ChristopherCa55/led-driver/BOOST_reorg_2026-10-05/README.md

# BOOST LED driver: design files for PCB review

A three-channel boost LED driver on two boards, designed in KiCad 10 and simulated in LTspice 26. The boards are
meant to be made and assembled by JLCPCB.

## Boards

| Board | File | Size | Layers |
|---|---|---|---|
| Power board | `KiCad/BOOST_power_RC2.kicad_pcb` | 74 x 86 mm (18 x 12 mm corner notch) | 6 (stackup JLC061611-7628D, specified at order) |
| Control card | `KiCad/BOOST_control_RC2.kicad_pcb` | 45 x 45 mm | 6 |

## Schematics
Each board has its own schematic, and a top-level system schematic includes both:

| File | What it is | Open with |
|---|---|---|
| `KiCad/BOOST_power_RC2.kicad_sch` | power board schematic | `KiCad/BOOST_power_RC2.kicad_pro` (with its PCB) |
| `KiCad/BOOST_control_RC2.kicad_sch` | control card schematic | `KiCad/BOOST_control_RC2.kicad_pro` (with its PCB) |
| `KiCad/BOOST.kicad_sch` | system: both board schematics as sheets | `KiCad/BOOST.kicad_pro` |
| `BOOST_schematic.pdf` | all three sheets as a PDF | any PDF viewer |

- Each board schematic is drawn in titled blocks, one per circuit, for example "Boost power stage and output banks"
  or "Channel 1 output-voltage error amplifier". The three output channels are drawn as matching blocks.
- Wires stay inside a block. Signals between blocks, and between the two boards, are joined by global labels with
  the same name.
- The boards connect through the 30-pin J10 (power board) / J11 (control card) pair.

The `.pretty` folders, `ltspice.kicad_sym`, `fp-lib-table` and `sym-lib-table` in `KiCad/` are the project's own
footprint and symbol libraries; KiCad finds them automatically.

## KiCad notes
- Each board has its own `.kicad_pro`, which carries its net classes and design rules. Open a board through its own
  `.kicad_pro`; without it, DRC falls back to the defaults.
- 3D models: the parts use KiCad's standard 3D library (`${KICAD10_3DMODEL_DIR}`), which comes with KiCad.

## ERC and DRC
- **ERC, system schematic (`BOOST.kicad_pro`):** 0 errors, 0 warnings.
- **ERC, power board on its own:** 0 errors, 0 warnings.
- **ERC, control card on its own:** 2 expected errors, "power input not driven", on U18's VDD and VSS. The card is
  supplied from the power board through J11, so nothing on the card drives those pins. They are driven in the system
  ERC, which is clean. A PWR_FLAG on the card would instead clash with the power board's regulator in the system ERC.
- **DRC schematic parity, both boards:** 0 issues (each PCB matches its own schematic).
- Power board: 0 errors, 0 unconnected. The 49 warnings are expected:
  - 46 silk over copper: a top-side logo under L1 crosses L1's middle (mechanical) pad. It is hidden under L1, and
    the gerbers cut silkscreen away from exposed pads.
  - 2 silk overlaps: the can outlines of C87/C71 and C86/C88 touch.
  - 1 library mismatch: J10's holes are drilled 1.05 mm on purpose (Samtec 0.64 mm square posts).
- Control card: 0 errors, 0 unconnected. The 1 warning is expected: a library mismatch, because J11's holes are
  drilled 1.05 mm on purpose (Samtec 0.64 mm square posts).

## LTspice
`LTspice/BOOST.asc` simulates both boards together. It is laid out like the KiCad schematics:
- the same titled blocks;
- the power board on the left and the control card on the right;
- the simulation-only test bench (battery, cable, LED loads, Arduino outputs) and all the directives at the bottom.

Signals between blocks use net labels with the same names as in KiCad. The connectors and mounting holes exist only
in KiCad.

What to look at:
- `I(SIM_LED1)`, `I(SIM_LED2)` and `I(SIM_LED3)`: the LED currents;
- `V(Vout_1)`, `V(Vout_2)` and `V(Vout_3)`: the channel outputs;
- `V(LX)`: the switch node;
- `I(L1)`: the inductor current.

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

**Parameters** (a `.param` line near the other directives):
- `IREF1_DUTY`, `IREF2_DUTY`, `IREF3_DUTY`: the Arduino's IREF PWM duty in 256ths at 490 Hz. 256 = always on (the
  default), 128 = 50 %, 0 = off.
- `POT1_CODE`, `POT2_CODE`, `POT3_CODE`: the MCP4451 wiper codes of U26A/B/C (0-256). The defaults 86/103/103 give
  2.635/2.371/2.371 A LED peaks. Code 0 is full current and 256 is zero (the pot's A terminal is grounded). At
  power-up the pot sits at mid-scale (128, about 1.98 A) until the firmware writes a code.
- Parts named `SIM_...` exist only in the simulation: the battery, cable, LEDs and the Arduino outputs.

**Results:** a 30 ms run at full duty converges in about 5-7 minutes. Over 25-30 ms the LEDs hold 2.635, 2.371 and
2.371 A, the outputs sit at 23.3, 33.1 and 33.1 V, and LX peaks at about 61 V.

**Start-up:** the two `.ic` lines start the servos and reference filters already settled, so the LEDs reach full
brightness within about 15 ms. Delete both lines for a true cold start (full brightness takes about half a second).
That shortcut start shows one 81 V LX spike at 0.15 ms, which real hardware does not see because it starts with the
references at zero.

**PWM dimming** (`IREFn_DUTY` below 256): each pulse keeps the full current down to about 19 % duty (red) and 25 %
(green, blue); below that the pulses carry less current. Runs can stall while all LEDs are off; adding `solver=alt`
to the `.options` line gets past it.

**File size:** LTspice saves every node, so a 30 ms run writes about 22 GB (`BOOST.raw`). Make sure there is room,
or add a `.save` line that lists only the signals you want.
