ChristopherCa55/led-driver/BOOST_split_boards/copper_review_2026-09-16/README.md

# Power copper check-in, 2026-09-16

`BOOST_power_copper_review.html` (+ `layers_v9.png`): the step-5 check-in for copper v9 - decisions, solver table
at 1 oz and 2 oz outer, commutation-loop inductance, layer plots, method.
Also at https://claude.ai/artifact/CsWJraE5Vq7Vkfb1vU2LdR. Generated by `../route_2026-09-16/tools/build_review.py v9`.
