ChristopherCa55/led-driver/BOOST_split_boards/route_2026-09-16/work/v15_r34/README.md

# Candidate v15 from router run r34 (not used)

A clean earlier v15 candidate (DRC 0 / 0, parity 0, no net changes). Replaced by run r36, which routes M6 and M3
return-first (plan-view gate-loop area 57.6 -> 47.7 mm2 and 236 -> 187 mm2) and keeps the bypass links and fan-out
vias out of rip-up (in r34 the C90.1 -> U10.3 5 V link had been ripped and the pads joined only through the plane).
