ChristopherCa55/led-driver/BOOST_split_boards/power6_2026-10-01/heatmap/A6_moved_gnd_report.txt

GND voltage above J2.1, full-load DC (A6_cu.json, JLC061611-7628D, grid 0.10 mm)
currents in: M1.3 11.03 A, R52.2 2.63 A, R53.2 2.37 A, R7.2 2.37 A; out at J2.1 18.40 A

terminal pads (mV): M1.3 6.46, R52.2 7.77, R53.2 8.25, R7.2 7.87, J2.1 0.00
highest GND voltage per layer (mV): F.Cu 8.25, In1.Cu 8.08, In2.Cu 8.04, In3.Cu 8.03, In4.Cu 7.72, B.Cu 7.67
floating GND copper (mm2): none

GND pins per part, lowest-highest pad (mV), highest first:
  R53      8.25 -   8.25
  U12      8.01 -   8.01
  U1       7.88 -   7.88
  R7       7.87 -   7.87
  C44      7.85 -   7.85
  C45      7.85 -   7.85
  C7       7.84 -   7.84
  C55      7.78 -   7.78
  C21      7.78 -   7.78
  C34      7.78 -   7.78
  C56      7.77 -   7.77
  R52      7.77 -   7.77
  U11      7.76 -   7.76
  C33      7.70 -   7.70
  C87      7.63 -   7.63
  C71      7.62 -   7.62
  C78      7.44 -   7.44
  J10      6.58 -   7.44
  C3       7.43 -   7.43
  U6       7.30 -   7.30
  C39      7.29 -   7.29
  C73      7.27 -   7.27
  C35      7.22 -   7.22
  U17      7.18 -   7.18
  C41      7.18 -   7.18
  C77      6.91 -   6.91
  U8       6.84 -   6.84
  C89      6.84 -   6.84
  C90      6.82 -   6.82
  U10      6.82 -   6.82
  C80      6.80 -   6.80
  C83      6.80 -   6.80
  U15      6.76 -   6.76
  C62      6.72 -   6.72
  C88      6.72 -   6.72
  C48      6.67 -   6.67
  C79      6.67 -   6.67
  C75      6.66 -   6.66
  C84      6.64 -   6.64
  U19      6.49 -   6.60
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
  16 ( 94.55,  77.15)  1.117 mV  joins In1 B  cuts LX on In2.Cu, Vin on F.Cu, Vin on In3.Cu, Vin on In4.Cu
  17 ( 80.95,  59.25)  1.103 mV  joins In1 In4 B  cuts LX on F.Cu, LX on In2.Cu, Vout_1 on In3.Cu
  18 ( 95.45,  56.45)  1.081 mV  joins F In1 B  cuts LX on In2.Cu, Vin on In3.Cu, Vin on In4.Cu
  19 ( 94.45,  43.05)  1.081 mV  joins F In1 B  cuts Vin on In2.Cu, Vin on In3.Cu, Vin on In4.Cu
  20 ( 98.75,  67.65)  1.053 mV  joins F In1 B  cuts Vin on In2.Cu, Vin on In3.Cu, Vin on In4.Cu

with the best 10 candidates added: terminal pads (mV) M1.3 6.46, R52.2 7.73, R53.2 8.20, R7.2 7.84, J2.1 0.00
  largest part GND pin: 8.20 mV (was 8.25)
