ChristopherCa55/led-driver/BOOST_split_boards/power6_2026-10-01/heatmap/U5_gnd_report.txt

GND voltage above J2.1, full-load DC (U5_cu.json, JLC061611-7628D, grid 0.10 mm)
currents in: M1.3 11.03 A, R52.2 2.63 A, R53.2 2.37 A, R7.2 2.37 A; out at J2.1 18.40 A

terminal pads (mV): M1.3 6.15, R52.2 7.63, R53.2 8.09, R7.2 7.74, J2.1 0.00
highest GND voltage per layer (mV): F.Cu 8.09, In1.Cu 7.91, In2.Cu 7.88, In3.Cu 7.86, In4.Cu 7.71, B.Cu 7.67
floating GND copper (mm2): none

GND pins per part, lowest-highest pad (mV), highest first:
  R53      8.08 -   8.08
  U12      7.84 -   7.84
  R7       7.74 -   7.74
  C34      7.70 -   7.70
  C21      7.70 -   7.70
  C44      7.69 -   7.69
  C45      7.69 -   7.69
  C55      7.69 -   7.69
  C7       7.68 -   7.68
  C56      7.68 -   7.68
  U1       7.67 -   7.67
  R52      7.63 -   7.63
  U11      7.61 -   7.61
  C33      7.55 -   7.55
  C87      7.48 -   7.48
  C71      7.48 -   7.48
  C78      7.34 -   7.34
  J10      6.53 -   7.29
  C3       7.29 -   7.29
  C39      7.14 -   7.14
  C73      7.14 -   7.14
  U6       7.11 -   7.11
  C35      7.06 -   7.06
  U17      7.03 -   7.03
  C41      7.03 -   7.03
  C77      6.80 -   6.80
  C89      6.79 -   6.79
  U8       6.77 -   6.78
  C83      6.73 -   6.73
  C80      6.73 -   6.73
  C90      6.73 -   6.73
  U10      6.73 -   6.73
  U15      6.66 -   6.66
  C62      6.62 -   6.62
  C88      6.62 -   6.62
  C48      6.58 -   6.58
  C79      6.58 -   6.58
  C75      6.57 -   6.57
  C84      6.53 -   6.53
  U19      6.42 -   6.47
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

GND vias carrying the most current (IPC 10 C rating 0.97 A for 0.4 mm):
  ( 42.30,  96.05) drill 0.40  0.59 A  0.61x
  ( 79.60,  52.00) drill 0.40  0.58 A  0.60x
  ( 79.00,  53.00) drill 0.40  0.56 A  0.58x
  ( 40.10,  96.05) drill 0.40  0.56 A  0.57x
  ( 41.57,  96.05) drill 0.40  0.53 A  0.55x
  ( 40.83,  96.05) drill 0.40  0.52 A  0.54x
  ( 79.60,  51.00) drill 0.40  0.51 A  0.52x
  ( 86.90,  67.50) drill 0.40  0.49 A  0.50x
  ( 61.06,  94.90) drill 0.40  0.48 A  0.49x
  ( 93.40,  61.10) drill 0.40  0.47 A  0.49x
  ( 61.06,  97.10) drill 0.40  0.45 A  0.47x
  ( 63.40, 109.55) drill 0.40  0.44 A  0.46x
  ( 91.30,  62.00) drill 0.50  0.44 A  0.39x
  ( 61.06,  95.63) drill 0.40  0.44 A  0.45x
  ( 61.06,  96.37) drill 0.40  0.43 A  0.44x

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

stronger spots that would cut a power pour (not on the map), ranked by the voltage across the layers they would join:
   1 ( 93.95,  65.95)  2.223 mV  joins F In1 B  cuts LX on In2.Cu, Vin on In3.Cu, Vin on In4.Cu
   2 ( 81.45,  57.05)  1.344 mV  joins F In1 In3 B  cuts LX on In2.Cu
   3 ( 96.65,  67.65)  1.342 mV  joins F In1 B  cuts LX on In2.Cu, Vin on In3.Cu, Vin on In4.Cu
   4 ( 75.35,  80.05)  1.213 mV  joins F In1 In3  cuts Vout_1 on In4.Cu
   5 ( 95.05,  69.75)  1.140 mV  joins F In1 B  cuts LX on In2.Cu, Vin on In3.Cu, Vin on In4.Cu
   6 ( 94.55,  77.15)  1.099 mV  joins In1 B  cuts LX on In2.Cu, Vin on F.Cu, Vin on In3.Cu, Vin on In4.Cu
   7 ( 98.75,  67.65)  1.057 mV  joins F In1 B  cuts Vin on In2.Cu, Vin on In3.Cu, Vin on In4.Cu
   8 ( 81.45,  54.95)  1.022 mV  joins F In1 In3 B  cuts LX on In2.Cu
   9 ( 79.55,  66.85)  1.013 mV  joins F In1 B  cuts LX on In2.Cu, Vout_1 on In3.Cu, Vout_1 on In4.Cu
  10 ( 79.85,  69.05)  0.989 mV  joins F In1  cuts LX on In2.Cu, Vout_1 on In3.Cu, Vout_1 on In4.Cu
  11 ( 93.95,  63.85)  0.970 mV  joins F In1 B  cuts LX on In2.Cu, Vin on In3.Cu, Vin on In4.Cu
  12 ( 73.15,  81.95)  0.893 mV  joins F In1 In3  cuts Vout_1 on In4.Cu
  13 ( 79.45,  63.05)  0.892 mV  joins F In1 B  cuts LX on In2.Cu, Vout_1 on In3.Cu, Vout_1 on In4.Cu
  14 ( 97.55,  58.55)  0.878 mV  joins F In1 B  cuts Vin on In2.Cu, Vin on In3.Cu, Vin on In4.Cu
  15 ( 94.55,  72.35)  0.876 mV  joins In1 B  cuts LX on In2.Cu, Vin on In3.Cu, Vin on In4.Cu
  16 ( 94.55,  75.05)  0.858 mV  joins In1 B  cuts LX on In2.Cu, Vin on F.Cu, Vin on In3.Cu, Vin on In4.Cu
  17 ( 96.05,  63.05)  0.842 mV  joins F In1 B  cuts LX on In2.Cu, Vin on In3.Cu, Vin on In4.Cu
  18 ( 81.55,  63.05)  0.837 mV  joins F In1 B  cuts LX on In2.Cu
  19 ( 90.05,  70.25)  0.828 mV  joins F In1  cuts LX on B.Cu, LX on In2.Cu, Vin on In3.Cu, Vin on In4.Cu
  20 ( 89.85,  66.15)  0.811 mV  joins F In1 B  cuts LX on In2.Cu, Vin on In3.Cu, Vin on In4.Cu
