ChristopherCa55/led-driver/BOOST_split_boards/route_2026-09-16/work/v16_report_tables.md

| FET | Loop area v15 → v16 (mm²) | Forward beside return v15 → v16 | driver → R | R → gate | driver → diode | diode → gate | VSS → source |
|---|---|---|---|---|---|---|---|
| M7 (LX side) | 47.5 → **49.1** | 73 % → 69 % | 13.6 | 5.1 | 18.5 | 1.4 | 20.9 |
| M5 (LX side) | 24.5 → **24.2** | 82 % → 82 % | 13.5 | 1.3 | 2.1 | 1.0 | 21.3 |
| M6 (LX side) | 47.7 → **47.7** | 34 % → 34 % | 28.9 | 3.4 | 16.0 | 1.5 | 14.8 |
| M2 (rail side) | 147.4 → **35.8** | 18 % → 56 % | 27.8 | 4.5 | 30.7 | 1.5 | 15.5 |
| M3 (rail side) | 186.5 → **37.8** | 0 % → 0 % | 21.2 | 4.0 | 20.8 | 1.1 | 9.9 |
| M4 (rail side) | 57.0 → **59.7** | 4 % → 1 % | 32.9 | 1.1 | 4.9 | 31.0 | 22.2 |

| FET | Part → gate pin | Role | v15 (mm) | v16 (mm) | Pad centres (mm) |
|---|---|---|---|---|---|
| M1 | R104.1 | pull-down | 1.3 | 1.3 | 3.0 |
| M1 | R15.2 | series R | 1.2 | 1.2 | 2.6 |
| M7 | D2.2 | turn-off diode | 1.4 | 1.4 | 2.9 |
| M7 | R60.2 | series R | 5.1 | 5.1 | 5.2 |
| M7 | R76.2 | pull-down | 3.5 | 3.5 | 4.8 |
| M5 | D22.2 | turn-off diode | 1.0 | 1.0 | 2.4 |
| M5 | R59.1 | series R | 1.3 | 1.3 | 2.6 |
| M5 | R74.2 | pull-down | 1.3 | 1.3 | 2.9 |
| M6 | D8.2 | turn-off diode | 1.5 | 1.5 | 3.1 |
| M6 | R49.1 | pull-down | 1.1 | 1.1 | 2.2 |
| M6 | R70.2 | series R | 3.4 | 3.4 | 4.2 |
| M2 | D11.2 | turn-off diode | 1.5 | 1.5 | 3.2 |
| M2 | R13.1 | series R | 4.5 | 4.5 | 4.8 |
| M2 | R75.2 | pull-down | 6.3 | 6.3 | 5.3 |
| M3 | D14.2 | turn-off diode | 1.1 | 1.1 | 2.4 |
| M3 | R23.2 | series R | 4.0 | 4.0 | 5.3 |
| M3 | R61.2 | pull-down | 5.2 | 5.2 | 6.9 |
| M4 | D13.2 | turn-off diode | 26.6 | 31.0 | 9.7 |
| M4 | R47.1 | series R | 1.1 | 1.1 | 2.2 |
| M4 | R73.2 | pull-down | 2.5 | 2.5 | 3.8 |
| M8 | R22.1 | series R | 1.0 | 1.0 | 2.4 |
| M9 | R50.1 | series R | 1.1 | 1.1 | 2.3 |
| M10 | R56.1 | series R | 1.4 | 1.4 | 2.9 |
