ChristopherCa55/led-driver/BOOST_split_boards/fab_2026-10-07/BOOST_power_RC2/checks/BOOST_power_RC2_drill_report.txt

Drill report for BOOST_power_RC2.kicad_pcb
Created on 2026-10-07T01:45:35

Copper Layer Stackup:
    =============================================================
    L1 :  F.Cu                      front
    L2 :  In1.Cu                    in1
    L3 :  In2.Cu                    in2
    L4 :  In3.Cu                    in3
    L5 :  In4.Cu                    in4
    L6 :  B.Cu                      back

Drill file 'BOOST_power_RC2-PTH.drl' contains
    plated through holes:
    =============================================================
    T1  0.300mm  0.0118"  (234 holes))
    T2  0.400mm  0.0157"  (624 holes))
    T3  0.500mm  0.0197"  (114 holes))
    T4  1.050mm  0.0413"  (30 holes))
    T5  1.100mm  0.0433"  (30 holes))
    T6  2.000mm  0.0787"  (6 holes))
    T7  4.300mm  0.1693"  (2 holes))

    Total plated holes count 1040

Drill file 'BOOST_power_RC2-NPTH.drl' contains
    unplated through holes:
    =============================================================
    T1  2.900mm  0.1142"  (4 holes))
    T2  3.200mm  0.1260"  (4 holes))

    Total unplated holes count 8
