ChristopherCa55/led-driver/BOOST_split_boards/fab_2026-09-24/BOOST_control_RC1/checks/BOOST_control_RC1_drill_report.txt

Drill report for BOOST_control_RC1.kicad_pcb
Created on 2026-09-24T18:08:31

Copper Layer Stackup:
    =============================================================
    L1 :  F.Cu                      front
    L2 :  In1.Cu                    in1
    L3 :  In2.Cu                    in2
    L4 :  In3.Cu                    in3
    L5 :  In4.Cu                    in4
    L6 :  In5.Cu                    in5
    L7 :  In6.Cu                    in6
    L8 :  B.Cu                      back

Drill file 'BOOST_control_RC1-PTH.drl' contains
    plated through holes:
    =============================================================
    T1  0.300mm  0.0118"  (393 holes))
    T2  1.000mm  0.0394"  (11 holes))
    T3  1.050mm  0.0413"  (30 holes))

    Total plated holes count 434

Drill file 'BOOST_control_RC1-NPTH.drl' contains
    unplated through holes:
    =============================================================
    T1  1.400mm  0.0551"  (2 holes)  (with 2 slots)
    T2  3.200mm  0.1260"  (4 holes))

    Total unplated holes count 6
