ChristopherCa55/led-driver/BOOST_split_boards/fab_2026-09-24/BOOST_power_RC1/checks/BOOST_power_RC1_drill_report.txt

Drill report for BOOST_power_RC1.kicad_pcb
Created on 2026-09-24T18:08:20

Copper Layer Stackup:
    =============================================================
    L1 :  F.Cu                      front
    L2 :  In1.Cu                    in1
    L3 :  In2.Cu                    in2
    L4 :  In3.Cu                    in3
    L5 :  In4.Cu                    in4
    L6 :  In5.Cu                    in5
    L7 :  In6.Cu                    in6
    L8 :  B.Cu                      back

Drill file 'BOOST_power_RC1-PTH.drl' contains
    plated through holes:
    =============================================================
    T1  0.300mm  0.0118"  (122 holes))
    T2  0.400mm  0.0157"  (628 holes))
    T3  0.500mm  0.0197"  (118 holes))
    T4  1.050mm  0.0413"  (30 holes))
    T5  1.100mm  0.0433"  (30 holes))
    T6  2.000mm  0.0787"  (6 holes))
    T7  4.300mm  0.1693"  (2 holes))

    Total plated holes count 936

Drill file 'BOOST_power_RC1-NPTH.drl' contains
    unplated through holes:
    =============================================================
    T1  2.900mm  0.1142"  (4 holes))
    T2  3.200mm  0.1260"  (4 holes))

    Total unplated holes count 8
