ChristopherCa55/led-driver/HANDOFF_2026-10-12.md

# BOOST LED driver: complete project handoff (2026-10-12)

> **State as of 2026-10-13 (later; read this before section 5):** the open tasks in sections 5.4-5.7 are DONE.
> - Steps 5g, 7e, 8c, 9 (D5- re-route) and 10 (two Vout_3 loop vias; the user chose Vout_3 only) and LTspice 5b are in
>   `BOOST_review_fixes`. Every output was regenerated there (total $599.01).
> - The final gates pass. See the top section of `BOOST_split_boards/review_fixes_2026-10-11/FIX_REPORT.md` and
>   `ANSWERS.md`.
> - The copy is still NOT_FOR_FAB. The next step is the user's decision about shipping it into the three shipped
>   folders (with backups and the same regeneration there).
> - The card's 0err_hi and SDA tracks stay where they are (`work/CARD_SPLITTERS.md`).
> - **2026-10-14: SHIPPED.** The three shipped folders now hold this design (with the user's own KiCad and LTspice
>   placement of the pull-ups) and freshly plotted outputs. See `BOOST_split_boards/ship_2026-10-14/README.md`; the
>   backups are in `BOOST_split_boards/previous/2026-10-14/before_ship/`.

**For the AI taking over this project.** Read this whole file before doing anything. It has:
- what the project is;
- where every file lives;
- how the user works and the rules you must follow;
- the exact state of the work in progress;
- what is still open.

The previous assistant (Claude, Claude Code desktop app on the user's Windows PC) wrote it at the user's request, so
you can "be" that assistant without re-deriving anything.

Paths:
- `ROOT` = `C:\Users\bubba\OneDrive\Documents\led-driver`
- `BSB` = `ROOT\BOOST_split_boards`
- `RF` = `BSB\review_fixes_2026-10-11` (the current work folder)
- `COPY` = `ROOT\BOOST_review_fixes` (the current working copy of the design)

---

## 0. Read these next, in this order

1. **This file.**
2. **The memory files**, in `C:\Users\bubba\.claude\projects\C--Users-bubba-OneDrive-Documents-led-driver\memory\`.
   - `MEMORY.md` is the index.
   - The long history is `boost-routing-status.md`; tool tricks are in `boost-tooling-reference.md`.
   - The feedback rules (sections 2 and 3 below repeat them) are in the other files.
   - If your harness loads this memory automatically, it is the same content.
3. `RF\FIX_REPORT.md`: the report of the current task (review fixes), written at the end of 2026-10-11.
4. `RF\work\step05g\STEP.md`: the step that was being finished when this handoff was written.
5. `BSB\review_2026-10-10\FIX_PROMPT.md`: the task statement the current work follows. It has the ground rules, the
   fixed parts, the gates, and the tool commands.
6. `RF\README.md`, `RF\DECISIONS.md`, `RF\ANSWERS.md`, `RF\work\CHANGELOG.md`, `RF\work\METRICS_final.md`.

---

## 1. What the project is

### 1.1 The product
A **three-channel, roughly 100 W-per-channel LED driver** ("BOOST"), designed by the user (GitHub account
ChristopherCa55). It is built into a small **aluminium case that is operated underwater**; the case is the heatsink.
- The early fit study (`ROOT\BOOST_FIT_STUDY.md`) used a 33 mm tall interior, 78 x 90 mm in plan.
- The FETs are screwed to the case floor through thermal pads.
- It drives three high-power LEDs, one per channel:
  - channel 1, "red": about 23.3 V at 2.635 A;
  - channels 2 and 3, "green / blue": about 33.1 V at 2.371 A.
- An **Arduino Nano** outside the board sets brightness (PWM), enables, and the current setpoint (I2C digipot).
- It is also meant to work as a **strobe**.
- Input: a **4S lithium battery**, 12-16.8 V. The input caps are 25 V parts, so 6S is not allowed.

### 1.2 The architecture (current; the August design in `ROOT\DESIGN_NOTES.md` is OBSOLETE)
A **single-inductor, multiple-output boost** with hysteretic, peak-current control built from discrete logic, plus
three linear current sinks.

**Power path:**
- Vin (J1, + J2 GND) -> **R1** (Bourns CSS4J-4026R-1L00F, 1 mOhm, 4-terminal shunt; **U25** INA241A4 makes the
  `Current` signal, 0.1 V/A) -> **L1** (Codaca CSCF3218-6R8MC, 6.8 uH, huge SMD, hand-fitted) -> node **LX**.
- **M1** (HYG180N10 TO-220, low-side) charges L1.
- Three back-to-back FET pairs route LX to the outputs:
  - M7 + M2 -> `Vout_1`, with `m2_source` the floating common source;
  - M6 + M3 -> `Vout_2` (`m3_source`);
  - M5 + M4 -> `Vout_3` (`m4_source`).
- Each `Vout_n` has its own cap bank: EEH-ZU / ZS 220 uF cans plus ceramics.
- Each LED goes from `Vout_n` (anode) to a **linear current sink**: a TLV9001 op-amp (U6 / U11 / U12 on the power
  board) drives **M10 / M9 / M8** (HYG180N10), with a 50 mOhm sense resistor (**R52 / R53 / R7**, WSL2512).
  - Output drains: J4 = Output1_drain, J7 = Output2_drain, J6 = Output3_drain.
  - Anodes: J3 = Vout_1, J8 = Vout_2, J5 = Vout_3.
- **D19** (5.0SMDJ54A TVS) clamps LX.
- **D28-D30** (Jingdao S2MW, LCSC C128729, SOD-123FL, bottom side) are pre-charge diodes Vin -> each Vout. They were
  added 2026-09-29 to kill a cold-power-up LX spike / L1 inrush.
- **Gate drivers:** UCC21520:
  - U19 for M1;
  - U15 for ch1 (M2 / M7);
  - U10 for ch2 (M3 / M6);
  - U8 for ch3 (M4 / M5).
  - Gate resistors: R15 10 ohm (M1); R13 / R23 / R47 220 ohm (rail FETs); R21 / R48 / R60 / R72 5.1 ohm.
- **Supplies:**
  - **U16** MC7812BD2TR4G (TO-263), the 12 V gate-drive rail, also sent to the Arduino end through J9.9;
  - **U17 / U1** L78L05: digital `5V` and `analog_5V`.

**Control (mostly on the control card):**
- An SR latch of cross-coupled NANDs (74HC00 U101-U103; 74HC14 U104 / U105). `Out` high = M1 on.
- **SET** fires when the inductor current is about 0 (`0A_hi`) and there is error demand, or when the low-error
  timeout expires.
- **RESET** fires when `Current` > `V_err` (peak current), blanked by `M1_ON`.
- Every SET clocks **U18** (CD4017B, one-hot counter), so the channel changes every switching cycle.
- **U28** (74HC4051 mux) puts that channel's error voltage on `V_err` (0.1 V/A scale).
- Per channel:
  - an error amp (TLV9001) compares `.1Vout_n` with `.1Vref_n`;
  - MCP6561 comparators (U2, U4, U5, U14, U21);
  - **U106** CD74HC4066 switches do the sample-and-hold of the references;
  - **U26** MCP4451-103 (quad 10k digipot, I2C, TSSOP-20, on the card's B.Cu) sets each channel's current reference.
    Code 0 = full current; defaults 86 / 103 / 103 give 2.635 / 2.371 / 2.371 A.
- `ena_out_n` = the LX-side FET enables. `M2_ON` / `out_2_on` / `out_3_on` = the rail-side enables.
- `0err_hi` = no demand. `VerrGT0` gates the enables.
- **U21** stops M1 when the 12 V rail is below about 9.8 V (UVLO-like).
- `ARD_M1_INHIBIT` (J9.11 -> D27) lets the Arduino hold M1 off.

### 1.3 The two boards (KiCad 10)

| Board | File | Size | Layers / stackup | Notes |
|---|---|---|---|---|
| Power board | `KiCad\BOOST_power_RC2.kicad_pcb` | 74 x 86 mm, 18 x 12 mm corner notch | 6, JLC061611-7628D (1 oz / 1 oz, 1.583 mm). Must be **specified at order**. In1 = solid GND plane, In2-In4 = Vin / LX / Vout pours, 5V as tracks | M1-M10 on the underside, tabs to the case floor; L1 and the electrolytic cans on top; J1-J8 wire pads; J10 = Samtec ESQ-115 socket to the card |
| Control card | `KiCad\BOOST_control_RC2.kicad_pcb` | 45 x 45 mm | 6, JLC 6-layer 1 oz outer / 0.5 oz inner (1.547 mm). In2 = 5V pour; In1 / In3 / In4 = GND pours that also carry signals (no solid plane) | J11 = Samtec TSW-115 header (underside) into J10; J9 = 11 staggered wire pads to the Arduino; H1-H4 card screw holes |

- The card sits on 20 mm standoffs above the power board, at H5-H8.
- Hardware, assembly and heights: `BUILD_NOTES.md`, `CLEARANCES.md`, `BSB\case_drilling_2026-09-15\` (rev B floor
  drilling).
- Fabrication: JLCPCB, scenario A: 5 bare PCBs of each, 2 sets assembled. ENIG, TG155, all vias epoxy-filled and
  capped.
- **Hand-fitted by the user:** M1-M10, L1, J10, J11.
- **Last released total: $598.99** (2026-10-07, after R14's deletion).

### 1.4 J9 (control card <-> Arduino), 11 soldered wires
| Pin | Label | Net | Function |
|---|---|---|---|
| 1 | V1 | Vref_1_arduino | PWM brightness, ch1 |
| 2 | V2 | Vref_2_arduino | PWM brightness, ch2 |
| 3 | V3 | Vref_3_arduino | PWM brightness, ch3 |
| 4 | I1 | IREF1 | ch1 enable |
| 5 | I2 | IREF2 | ch2 enable |
| 6 | I3 | IREF3 | ch3 enable |
| 7 | SCL | SCL | I2C clock to U26 |
| 8 | SDA | SDA | I2C data |
| 9 | 12V | 12V | 12 V out; the user's own 12 -> 5 V buck at the Arduino end, with an MF-R050 PTC at the card end |
| 10 | GND | GND | ground |
| 11 | INH | ARD_M1_INHIBIT | hold M1 off |

- Odd pins are row 1 (y 95.9 on the card); even pins are row 2 (y 98.44). Pin 1 is at (51.065, 95.9).
- The pads are flashed on all six layers.
- Two cable-tie slots sit at x 48.16. The wire bundle runs along the card's **underside**, west.

### 1.5 Simulation (LTspice 26)
- `LTspice\BOOST.asc` plus 10 custom `.asy` and 14 `.lib` files (behavioural models written for this project).
- A 30 ms run converges in about 5-7 min. With every node saved it writes a ~22 GB `.raw`, so use a `.save` list.
- `.param IREFn_DUTY` (256ths, 490 Hz) and `POTn_CODE`.
- Parts named `SIM_*` exist only in the simulation: the battery, cable, LEDs and Arduino outputs.
- The `.asc` is latin-1; netlists are UTF-8.

### 1.6 Schematics (KiCad 10)
- `KiCad\BOOST.kicad_sch` is the **main page**: everything on one ANSI-D page, laid out by the user (the "v3" page).
  Open `BOOST.kicad_pro`.
- Each board project has **its own schematic**, linked to its PCB: `BOOST_power_RC2.kicad_sch` and
  `BOOST_control_RC2.kicad_sch`.
- **Every part is drawn twice**: on the main page and on its board sheet, sharing symbol and pin uuids. Any change goes
  into BOTH, and `BSB\kicad_sheets_2026-10-09\tools\sync_check.py` must report 0 differences.
- Native `kicad-cli pcb drc --schematic-parity` works on each board project.
- The schematic is "frozen" at **rev6** (2026-09-25). Circuit changes need the user's explicit OK.
  - Since rev6, the user has approved and applied: R14 deleted; D28-D30; the cap split; TLV9001; U16 = MC7812.
  - Approved in the current run: I2C pull-ups R106 / R107; R99 / R102 = 1k.

---

## 2. The user, and how to work like the previous assistant

**Who:** the hardware designer. Experienced and precise. Reads everything, and catches wrong numbers. They want:
- **Decisions are theirs.** At every design decision (circuit or part change, copper or placement, accepting any
  regression, moving a fixed part, net renames, changing anything they drew or placed), stop and ask:
  - give the numbers;
  - give 2-3 options;
  - give a recommendation.
  - Ask everything you can **in one batch**.
  - Never decide silently. They have overruled recommendations before.
- **Pictures before anything is final.** Every new note, label or symbol, every moved symbol, and every new PCB part
  needs the user's OK on a picture. Look at every PNG you make; generating it is not checking it.
- **Schematic comments:** very brief (a few words, their style), right next to the part (nearly touching is fine),
  never stating the obvious. For new items on a sheet they arranged, show the spot and wait, or ask whether they want
  to place it themselves.
- **Plain, concrete language.** Short sentences; numbers with units and coordinates (x, y, layer). No jargon soup.
  When you report, say what is done, what is waiting for them, and what you could not verify.
- **Honesty about mistakes.** If you were wrong, say so plainly and fix it. If a command was interrupted, check what it
  actually did before saying it did nothing.
- **Their messages sometimes arrive as pasted drafts** written in another session. Do file-only work on them. Ask for
  an own-words OK before overwriting shipped files.
- **They work in KiCad / LTspice alongside you.** They may have files open and may save edits mid-task: they did so on
  2026-10-11 23:14 (see 5.3). Always hash-check before overwriting.
- **They own the git repo** (`ROOT` is a git repo, branch main; `BOOST-github` is a separate repo). Never commit or push
  unless asked.

### 2.1 Hard rules (from memory and FIX_PROMPT; none may be broken)
1. **Shipped folders are read-only:** `ROOT\BOOST_package`, `ROOT\BOOST_stuff`, `ROOT\BOOST_schematic_cleanup`,
   `ROOT\BOOST-github`.
   - Never write or delete anything there, including stale lock files (`~$BOOST_BOM.xlsx`, `~*.lck`).
   - Changes go into `COPY` only, and only via `RF\tools\promote.py`.
   - Shipping into the real folders happens only when the user says so in their own words. Then back up first, to
     `BSB\previous\<date>\...`.
2. **DRC rules:** never loosen a DRC rule or netclass value. Never add a DRC exclusion or a rule-area exception.
   Tightening is fine.
   - Every saved board: DRC 0 errors, 0 unconnected, zones refilled, `--schematic-parity` 0.
   - The warning count stays at the baseline (power 49, card 1), or each new warning is explained and accepted.
   - ERC 0 on all three projects (main, power, card); sync_check 0.
3. **Part data from datasheets only.** Cite the source. Say clearly what is UNVERIFIED.
   - Ask before downloading anything.
   - Never bypass bot checks or CAPTCHAs, never create accounts, never buy.
   - Prices: LCSC / jlcpcb.com parts API, TME, McMaster, Pololu and makers' pages read fine. Digi-Key, Mouser, Octopart,
     Farnell, Arrow and RS block; give the user a short URL list instead.
4. **Never re-run a generator onto an existing file.** Every result gets a new name or a new folder. Check the output
   path does not exist. The user's latest file is only ever an input.
5. **Lock files:**
   - KiCad `~*.lck` beside a file means it may be open: ask before writing it.
   - Before writing a `.asc`, check that no LTspice process has it open (process command lines).
6. **KiCad Python `SaveBoard` drops the netclasses** from `.kicad_pro`. Copy the `.kicad_pro` and `.kicad_dru` back
   beside any Python-saved board before DRC.
   - Prefer `kicad-cli pcb drc --refill-zones --save-board` for refills; it does not touch the `.kicad_pro`.
   - Never `sed -i` a `.kicad_pro`.
   - Keep each file's own line endings: the boards are CRLF; the J9 library `.kicad_mod` is LF.
7. **Scripts:** write them with the Write tool; Bash heredocs mangle backslashes.
   - Never `rm` an unguarded variable (use `${VAR:?}`, `mktemp -d`, or move aside).
   - Never edit a bash script while it is running.
8. **IPC-2221 rises** on the power board: report them, with neck length. They are not pass/fail for necks under
   ~5 mm or for vias in plane-connected fields; flag regressions as decisions.
9. **Do not trust reviews blindly.** The files win; note disagreements in the report.
10. **Heavy jobs one at a time.**
    - DC solves: `WORKERS=3` while the user's apps hold ~20 GB (5 and 9 workers ran out of memory). One solve takes
      ~29 min.
    - At most 3-4 LTspice runs in parallel; watch the disk.
11. **Fixed parts** (do not move without asking):
    - J10 / J11 (the stack connector);
    - H1-H4, H5-H8 and all mounting holes, their keepouts and the board outlines / corner notch;
    - M1, M8, M9, M10 with their tab-screw holes and washer keepouts;
    - J1-J8 and J9;
    - the heights in `CLEARANCES.md` (lid over U18 / U28, washers under the card near D6, R94, D3, R84).

### 2.2 Working style that worked
- **One gated change per step.**
  - Each step is a new folder `RF\work\stepNN\`: a scratch KiCad copy, edit, refill, DRC / ERC / parity / sync, copper
    export, metrics.
  - Then `METRICS.md` / `CHANGELOG.md`, and before / after pictures.
  - Failed tries keep their folder with `FAILED.txt` / `SUPERSEDED.txt`.
- **What-ifs first.** Edit a copy of the copper-export JSON, re-solve, and only then edit a board.
- **Before replacing anything, hash-check it** against what you last wrote (`promotions.log`).
- **Report regressions with who accepted them.** Keep a "what I could not verify" list and a "where the review was
  wrong" list.
- **Give the user short status lines** during long work. They see "the user hasn't heard from you" prompts.

---

## 3. Folder map

### 3.1 `ROOT` (the main folder)

| Item | What it is |
|---|---|
| `BOOST_package\` | **The full shipped design package** (newest complete set). See 3.2. |
| `BOOST_stuff\` | The shipped package **for outside reviewers** (lean). See 3.2. |
| `BOOST_schematic_cleanup\` | The shipped folder where schematic re-layouts were done first. See 3.2. |
| `BOOST_review_fixes\` (`COPY`) | **The current working copy** (NOT_FOR_FAB), with the 2026-10-10 review fixes. See 3.2. |
| `BOOST_split_boards\` (`BSB`) | Every work folder, tool, study, report and backup since 2026-09-09. See section 4. |
| `BOOST-github\` | The user's original GitHub repo (separate git). Has the single-board rev6 master schematic `BOOST\BOOST.kicad_sch` (old layout), old netlists / ERC reports, `BOOST_CONTEXT_TRANSFER.md` (the 2026-09-02 handoff that started the KiCad phase). **Read-only.** Stale lock files inside. |
| `BOOST_reorg_2026-10-05\` | A 10-05 reorganization copy for a reviewer (root + 2 sheets, LTspice re-laid in blocks). Its LTspice layout was **rejected**; the board-sheet idea was later done differently. Historical; still has R14. |
| `BOOST_stuff.zip`, `BOOST_stuff (2).zip`, `BOOST_stuff_final.zip` | Zips of BOOST_stuff the user sent to reviewers (09-30, 10-02). |
| `BOOST_FIT_STUDY.md`, `BOOST_fit_study.png`, `BOOST_option2b_placement.png` | The 2026-09-08 enclosure fit study that led to splitting into two boards. |
| `DESIGN_NOTES.md`, `RGB100W_Driver.asc / .log / _sim.net`, `BOOSTPCM.asy/.sub`, `LEDCOT.asy/.sub` | The **August 2026 first design** (44 V rail + three CC bucks, 900 mA). **Obsolete**; history only. |
| `.gitignore` | Ignores lock files, `.kicad_prl`, `.history`, `*-backups`, `BOOST-github/`, `*.raw`. |
| `HANDOFF_2026-10-12.md` | This file. |

### 3.2 The four main design folders

Each has `KiCad\` (main schematic, both board projects and PCBs, `BOOST.pretty`, `CSCF3218-6R8MC.pretty`,
`ltspice.kicad_sym`, `fp-lib-table`, `sym-lib-table`), `LTspice\` (BOOST.asc + 10 .asy + 14 .lib), `README.md`, and
fab outputs at the top level.

**The three shipped folders are identical in design content** (checked 2026-10-12):

| File | package / stuff / cleanup | COPY (review fixes) |
|---|---|---|
| `KiCad\BOOST.kicad_sch` | 899c761c | f407f442 |
| `KiCad\BOOST_power_RC2.kicad_sch` | 88faea82 | 3dd58076 |
| `KiCad\BOOST_control_RC2.kicad_sch` | f57cae74 | **13af0cd6** (user-edited 10-11 23:14, see 5.3) |
| `KiCad\BOOST_power_RC2.kicad_pcb` | 01703432 | 871f3a1d |
| `KiCad\BOOST_control_RC2.kicad_pcb` | d34d1202 | 40c9c7f6 |
| `KiCad\*.kicad_pro` | 6ac4b763 / 16d4c3f9 / 85455735 (main / power / card) | same |
| `KiCad\ltspice.kicad_sym` | 03adb368 | same |
| `LTspice\BOOST.asc` | 1f008632 | cc28c9fa |
| `README.md` | b9a14fbb | effabd4a |
| power gerbers zip / fab PDF | ff3c1290 / 396fdc86 | same (NOT regenerated yet) |
| card gerbers zip / fab PDF | 72cb46ac / 55a22771 | same (NOT regenerated yet) |
| `BOOST_assembly_2026-10-07.step` | 189b2e57 | same |

**`BOOST_package\` (the main shipped package, the most complete):**
- KiCad, LTspice and README (the reviewer-style README: boards table, KiCad notes, ERC / DRC, LTspice usage).
- `BUILD_NOTES.md` (assembly, FET orientation, case stack, J9 wiring, order of work, the tab-to-case check).
- `CLEARANCES.md` (3D clearance table).
- `COST_SUMMARY.md`, `SOURCING_TABLE.md`, `ORDER_CHECKLIST.md` (JLC order options; power board "Specify Stackup:
  JLC061611-7628D").
- `BOOST_BOM.xlsx` (the full workbook, raw SpreadsheetML).
- JLC BOM / CPL CSVs for both boards.
- Gerber zips and fab drawing PDFs.
- STEP files: 09-25 and 10-07, plus the 09-25 STL and 3D PDF.
- `case_floor_drilling.html / .svg`.
- A stale `~$BOOST_BOM.xlsx` (an old Excel owner file). **Leave it.**
- Total cost **$598.99**.

**`BOOST_stuff\` (the reviewer package):** the same KiCad, LTspice and fab outputs, plus `JLC_SELECTIONS.md`.
- `BOOST_BOM.xlsx` here is the **reviewer** version (`make_xlsx.py --review`: no dates, no history), so its hash
  differs from the package's.
- No BUILD_NOTES / COST docs.
- KiCad leftovers (`.history`, `-backups`, `.kicad_prl`) exist; they are the user's.

**`BOOST_schematic_cleanup\`:** where the user and the assistant did the schematic re-layouts first:
- the pre-charge diodes;
- the LTspice / KiCad matching (2026-09-28 / 30);
- the user's PWR_FLAG placement.

Today it has the same design files and fab outputs, but no cost / build docs. `make_fab.sh` historically pointed its
`fp-lib-table` here.

**`BOOST_review_fixes\` (`COPY`):** BOOST_package as of 2026-10-11 (12 key files hash-checked), plus:
- `NOT_FOR_FAB.txt`;
- the promoted review fixes (section 5.1);
- `CHANGES_XY.md` (every changed x / y / layer);
- the README "what changed" section;
- BUILD_NOTES' M8-M10 heat note.

Its gerbers, drill, fab PDFs, STEP, BOM / CPL and cost files are **still the shipped ones**: regenerating them is a
pending task (section 6).

The user opened it in KiCad, so `.history`, `*-backups`, `.kicad_prl` exist there. They are the user's; leave them.
There were lock files until 2026-10-12 09:28; **check again before every promotion.**

---

## 4. `BSB` (`BOOST_split_boards`): what the important subfolders are

`BSB\README.md` "Current state" is stale (it describes 2026-09-25 / FINAL). Use memory and this file instead.

| Folder | What it is about |
|---|---|
| `review_fixes_2026-10-11\` (`RF`) | **THE CURRENT WORK.** Section 5. |
| `review_2026-10-10\` | The read-only reviews the current work fixes: `SCHEMATIC_REVIEW.md` (19 items, screenshots in `lt\` / `kicad\`), `PCB_REVIEW.md` (power P1-P9, card C1-C6, open 10-02 items; pictures `img_pcb\`), `FIX_PROMPT.md` (the task prompt), `pcb\pcb_checks.py` (islands, slices / splits, necks, hot spots, routing jogs, return gaps), `pcb\make_crops.py`, `pcb\render_layers.py`, `pcb\solve\now_solve.txt` + what-ifs, `capture_with_directives.py`. |
| `power6_2026-10-01\` | The 8 -> 6 layer power board trial (variant A chosen) and **most power-board tools**: `export_copper6.py`, `solve_copper6.py` (DC solve per branch, via ratings), `compare_solves6.py`, `loop_L6.py`, `gnd_heatmap.py`, `plane_cover.py`, `gate_return.py`, `thermal6.py` (U16 Tj), `check_variant.sh` (outdated parity), `patch_m2_drive.py` / `patch_m7_drive.py`. README has the 10-02 readiness review and the U16 notes. |
| `route_2026-09-16\` | Power-board copper / routing history (v9-v19) and tools; **`branches_power.json`** (the DC-solve branch definitions used everywhere). |
| `card6_2026-09-30\` | Card 8 -> 6 layers; why there is no solid plane; `in4plane\` (failed solid-In4 attempt); `tools\sens_check6.py` (U2 In+ 65.6 %, V_err 90.4 %, Current 82.4 %), `fix_tangent.py`, `prune_dangling.py`, `stitch_island.py`, `route_card.py`. |
| `card_route_2026-09-22\`, `card_2026-09-17\` | Card placement / routing history (c3 / c3b). |
| `kicad_sheets_2026-10-09\` | Board sheets; **`tools\sync_check.py`** (main page vs board sheets), `check.py`, `pcb_set_field.py`, `build.py`. |
| `kicad_layout_2026-10-09\` | The LTspice v7 -> KiCad main-page transfer (`tools\kwrite.py`, `sexpr.py`, `kgeo.py`, `render.py`, `svgtext.py`, `declutter.py`, `remade_symbols.py`). |
| `ltspice_layout_handoff_2026-10-05\` | LTspice re-layout rules plus **`tools\ltspice_equiv.py`** (E1-E5 equivalence vs a reference) with **`approved_changes.json`** (every approved circuit / directive change, with the user's words), `ltspice_capture.py` (screenshots), `asc_layout_check.py`, `bypass_match.py`. |
| `ltspice_layout_2026-10-05\` | The LTspice re-layout work (v1-v7); `tools\ascmodel.py` (.asc editing; `Asc.write` refuses to overwrite), `make_symbols.py`, etc. |
| `fab_2026-10-07\` | The latest fab run (after R14): **`tools\make_fab.sh`** (refuses unless DRC is clean and fills are current; its `fp-lib-table` sed points at `BOOST_schematic_cleanup\KiCad`, so make a COPY of the script pointing at `COPY\KiCad`), `fab_drawing.py`, `fab_facts.py`, `update_docs.py`. |
| `fab_2026-10-02\`, `fab_2026-09-30\`, `fab_2026-09-24\` | Earlier fab runs. `fab_2026-09-24\tools\` has `build_bom.py`, `cost_summary.py`, `pad_options.py`, `hole_isolation.py`, `fab_drawing.py`. |
| `bom_2026-09-30\` | BOM / cost tooling (README): `tools\build_bom.py`, `cost_summary.py`, `savings.py` (APPLIED / OPEN lists), `descriptions.py`, `make_xlsx.py` (raw SpreadsheetML; `--review` for the reviewer workbook; check in Excel via PowerShell COM), `jlc_parts.py` (JLC parts API, plain POST), `bom\jlc_snapshot_2026-10-01.json`. |
| `card05oz_2026-10-01\` | The card's 0.5 oz inner stackup (`set_stackup_05oz.py`, fab drawing patch). |
| `assembly_3d_2026-09-30\` | The 3D assembly STEP builder (`tools\build_assembly.py`, `board_geometry.py`, `write_clearances.py`, `step_probe.py`). The OCP venv is in boost-tooling-reference memory. Re-run `write_clearances.py` when parts move. |
| `r14_delete_2026-10-07\` | The last **complete regeneration** of everything (sch, pcb, asc, gerbers, BOM / CPL, costs, xlsx, STEP). **Use it as the recipe** for the regeneration task. |
| `u16_thermal_2026-10-01\`, `mc7812_lowbatt_2026-10-01\` | U16 thermal model and the MC7812 low-battery sims (U16 = MC7812 chosen). |
| `precharge_surge_2026-09-30\` | S2MW surge headroom (kept S2MW). |
| `sim_m1_2026-09-24\` | M1 turn-off re-check with the routed loop L. |
| `case_drilling_2026-09-15\` | Case floor drilling rev B. |
| `FINAL_2026-09-25\` | The 09-25 "final" release (8-layer era). **Outdated**: the shipped folders replaced it. |
| `previous\<date>\` | **All backups**, by date (before every change to shipped files, every promotion: `previous\2026-10-11\promote_*`). |
| `reorg_2026-10-05\`, `handoff_*`, `replace_2026-09-14\`, `placement_review_2026-09-15\`, `copper_review_2026-09-16\`, `rev6_prep_2026-09-24\`, `wip\` | Older history (placement, the rev3-rev6 schematic, early handoffs). Read only if needed. |

---

## 5. The current task: review fixes (`RF`), started 2026-10-11

The user said: "Read and follow BOOST_split_boards/review_2026-10-10/FIX_PROMPT.md." The steps:
1. make `COPY`;
2. record the baseline;
3. ask decisions D1-D14 in one batch (`RF\DECISIONS.md`; answers in `RF\ANSWERS.md`);
4. apply one gated step at a time;
5. promote approved steps into `COPY`;
6. write `FIX_REPORT.md` and `CHANGES_XY.md`.

### 5.1 Already promoted into `COPY` (`RF\work\promotions.log`)
- **Step 1 (LTspice docs):**
  - brief notes;
  - every diode shows its part name (`.model` aliases, so the simulation is unchanged);
  - the `.ic` line cleaned and the commented `.ic` deleted;
  - asc `cc28c9fa`.
- **Step 2 (KiCad docs):**
  - diode Values = part names, on all three schematics and both PCBs;
  - J1-J8 Values Vin+ / Vin- / Out1+ / Out1- / Out2+ / Out2- / Out3+ / Out3-, also on the power board's F.SilkS
    (references on F.Fab). **The user approved these labels on 2026-10-12.**
  - main-page title block;
  - U26D moved off U106D.
- **Step 3:** the 12V route Option A on the power board (B.Cu through one opened column of the Vin via array). Vin
  J1 -> R1 1.031 -> 1.003 mOhm; neck 38.8 -> 29.3 C.
- **Step 4:** two GND loop vias in C3.2's pad (ch2: worst loop via 3.6x -> 1.72x; Vout_2 +1.2 %).
- **Step 6b:** three more Vin vias 0.8 / 0.4 at x 72.08 in R1's funnel. Power board `871f3a1d`.
- **Docs:** README "what changed", BUILD_NOTES M8-M10 heat, `CHANGES_XY.md`.
- **Final gates on COPY:**
  - ERC 0 / 0 / 0;
  - DRC power 49 warnings and card 1 (= baseline), 0 errors, 0 unconnected;
  - parity 0, sync 0, ltspice_equiv PASS.

### 5.2 The user's answers on 2026-10-12 (their latest message, verbatim)
> "Ok, the vin/out labels are good. Can you retry placing the i2c pullups using the same resistor size as all the other
> resistors. To me it seems like there is plenty of space near the input pins. There are 5V vias which you should be
> able to connect to at around 58.5, 92.5, and 55.8, 94.3. You can also just add a via, and connect it to the in2 plane
> instead of using the different resistor size. Everything else looks fine - i approve them. You do not need to rename
> the nets in ltspice. For now, do not do the other power board reroutes. For the card's longest ground splitting
> tracks, just place them in the location that would affect other stuff the least (keep other things as intact as
> possible). Yes, I would like you to regenerate all the files like the gerbers, drill, fab, bom etc..."

Then, asked by AskUserQuestion:
- **Pull-up placement:** "Shrink J9's courtyard (Recommended)". The option said:
  - edit J9's courtyard to hug the pad rows;
  - put R106 (0603) just above J9.7 (SCL) and R107 just below J9.8 (SDA);
  - 5V from nearby 5V vias or a new In2 via;
  - SCL / SDA silk labels move if needed.
  - The assistant had said it would shrink the F courtyard only and keep the B keep-out (the wires run underneath).
- **Loop vias:** "Can you give a cost / benefit for doing this for each of the via locations?" Give the analysis per
  location; **do not apply.**

So, **approved:**
- R99 / R102 = 1k;
- LTspice `.options ... solver=alt`;
- the B.Cu / other costs listed for step 5;
- step 7 (two card GND stitching vias);
- step 8 (U101A-Y from In1 to In2);
- regenerating all outputs (D14).

**Not wanted:** LTspice net renames (D6); the other power-board reroutes (X3: P6 gate / switch-node tracks in pours,
the Current track, the analog_5V vias).

`RF\ANSWERS.md` does NOT yet record the 10-12 answers. Add them, quoting the user's words.

### 5.3 IMPORTANT: the user edited COPY's card schematic
`COPY\KiCad\BOOST_control_RC2.kicad_sch` is `13af0cd6`, saved by the user in KiCad on **2026-10-11 23:14**:
- U26D (unit 4 of the MCP4451, the unused pot) moved 3.81 mm right, from (520.7, 367.03) to (524.51, 367.03);
- its three no-connect flags (513.08 -> 516.89) and its Ref / Value field positions moved with it.

`promotions.log` still expects `a2a4ea6f`, so **`promote.py` will refuse to overwrite it.** That is correct behaviour.
- Steps 5e / 5f / 5g were built ON TOP of the user's file, so their card sheet includes the edit.
- Before promoting:
  1. tell the user you saw their U26D move and kept it;
  2. record `13af0cd6` as the expected old hash (add a line to `promotions.log` saying it is the user's own save,
     with the date). **Do not** edit `promote.py` to skip the check.
- The main page `BOOST.kicad_sch` was NOT edited by the user (f407f442). The two pages need not match in position;
  sync_check compares parts and nets only.

### 5.4 Step 5 (I2C pull-ups), the part being finished when this handoff was written

**History:**
- `step05d` = the 0402 version on B.Cu. The user rejected 0402 and wants 0603.
- `step05e` = first 0603 try. SUPERSEDED: 3 silk_overlap warnings, and the router put a via inside R107's pad.
- `step05f` = SUPERSEDED: the via position and a 0.07 mm jog.
- **`step05g` = the candidate.** Every gate passes. Read `RF\work\step05g\STEP.md`; the summary is below.

**Why it took several tries:** the band directly above J9's row-1 pads is U26's B-side fan-out. U26 is on B.Cu above
J9, with its bottom pin row at y 91.48. The band holds:
- via holes: 5V (56.775, 92.675) In2 / B; A1 (57.275, 93.225) In4 / B; RESET (58.775, 93.725) In1 / B;
- flashed vias: 5V (58.425, 92.625), ARD (59.375, 93.325), P2B (55.925, 92.425).

Every 0603 spot in that band hits 2-3 of them. Moving them means re-routing U26's escapes (invasive). The spot that
needs no via moves is **in J9's row-1 label row**, so two labels move up instead. The scoring scripts are in `RF\work\`:
`score_r106.py`, `score_r106b.py`, `score_r107.py`, and `dump_crt.py` (courtyard / text boxes, KiCad Python).

**Step 5g, what it does:**
- **Schematics:** R106 / R107 4.7k, footprint `Resistor_SMD:R_0603_1608Metric`, on the main page and the card sheet,
  with 5V / SCL / SDA labels and the note "I2C pull-ups (U26 has none)"; R99 / R102 1k.
  - Tool: `RF\tools\step05e_kicad_sch.py`.
  - Shared uuids: R106 symbol `6c1f7a52-3d0e-4b8a-9a61-5e2b4f0c1061`, R107 `...1071`.
- **J9 footprint** (board AND `KiCad\BOOST.pretty\WirePads_11_Staggered_P1.27mm_Drill1.0mm_TieSlots.kicad_mod`, so no
  library-mismatch warning):
  - **F.CrtYd** now hugs the pad rows, 0.15 mm off: local y -1.15 .. 3.69; the tie-slot block x -4.5 .. -1.2 is kept
    full height;
  - **B.CrtYd unchanged**;
  - F.SilkS labels **I2** and **SCL** moved up from local y -1.825 to -3.1 (board 94.075 -> 92.80), above R106;
  - tool: `RF\tools\fp_text_edit.py`.
- **H3's reference text** moved 0.35 mm down (local -4.15 -> -3.8), clear of R107.
- **5V:**
  - the redundant 12-segment F.Cu 5V stretch between the user's two vias (58.425, 92.625) and (55.825, 94.225) removed;
  - via (55.825, 94.225) replaced by (55.5, 94.4) with a 0.3 mm stub into R106.1 ("the user's via, nudged");
  - a new 5V via (53.35, 101.45) with a stub into R107.1.
- **R106** F.Cu at (57.15, 94.0), rot 0: pad 1 = 5V at 56.325; pad 2 = SCL at 57.975, a short F track into J9.7.
- **R107** F.Cu at (55.15, 101.45), rot 0, below J9's I1 label: pad 1 = 5V; pad 2 = SDA. SDA path:
  - F stub to a via at (55.6, 100.7);
  - In2.Cu (55.6, 100.7) -> (57.25, 100.7) -> (59.1, 98.85) into J9.8's In2 pad;
  - the same kind of In2 link the user approved for the 0402 version, but shorter: In2 5V cut 2.8 mm, detour 3.4 mm.
- **Why R107 is not literally "just below J9.8":** that strip carries the IREF1 F track, the IREF3 via, GND vias and
  R57's courtyard. The (55.15, 101.45) spot needs none of them moved. **Tell the user this.**
- **Gates (step05g):**
  - ERC 0 / 0 / 0;
  - card DRC 0 errors, 1 warning (the baseline J11 library mismatch), 0 unconnected, parity 0;
  - sync 0;
  - the power board is byte-identical to step06b (`871f3a1d`).
- **Metric changes vs the copy's card:**
  - In2 5V cut by SDA 2.8 mm (new);
  - F.Cu|5V pieces 14 -> 16 (each via-joined to In2, not a split);
  - In1 RESET cut 2.6 -> 3.0 mm: In1 GND now fills further under the track, which is MORE plane (see the in1_reset
    pictures);
  - largest GND pieces -0.8 to -4.6 mm2;
  - jogs 2600 -> 2594.
- **Hashes (step05g\kicad):** card pcb `82b638b6`, main sch `b6d660f8`, card sch `d687838b`, J9 kicad_mod `8e5ab0ab`.
- **Pictures:**
  - `RF\img\step05e\j9_F_before.png` / **`j9_F_after_5g.png`**;
  - `j9_In2_before.png` / **`j9_In2_after_5g.png`**;
  - `in1_reset_before.png` / `_after.png`.
  - (`j9_F_after.png` / `j9_In2_after.png` are step 5f's.)

**Still to do for step 5, in order:**
1. **Show the user the 5g pictures and get an OK.** Explain:
   - R106 sits in the label row with I2 / SCL raised;
   - R107 is below I1 with an In2 link to J9.8;
   - H3's text moved 0.35 mm;
   - J9's F courtyard shrank;
   - the 5V via moved 0.3 mm from where they named it.

   Also offer the alternative: moving U26's fan-out vias so R106 can sit above the labels (invasive).
2. **LTspice:**
   - the candidate is `RF\work\step05b_lt\LTspice\BOOST.asc` (`bfd51e7c`): R106 / R107, R99 / R102 1k, and
     `.options gmin=100f reltol=0.001 solver=alt`.
   - `approved_changes.json` (`BSB\ltspice_layout_handoff_2026-10-05\tools\`, now `d498423d`) already has R106 / R107
     and the R99 / R102 values. Add the approved `.options` directive change, quoting the user's 10-12 words, with a
     backup first.
   - Re-run `ltspice_equiv.py`: E1-E5 must all PASS.
   - Why solver=alt: with R106 / R107 in the netlist, the normal solver stalls at 0.3216 ms. solver=alt gives the
     same `.meas` results, about 3x slower.
3. **BOM / CPL:**
   - R106 / R107 join the card's existing **4.7k 0603 line `0603WAF4701T5E`, C23162** (R27, R37, R45);
   - R99 / R102 move from the 10k line (C25804) to the 1k line `0603WAF1001T5E`, C21190;
   - CPL rows on the **Top** side;
   - `RF\tools\step05_fab.py` is the 0402 version: write a new `step05g_fab.py` (new output folder; keep CSV quoting and
     line endings).
4. **Rebuild steps 7 and 8 on step05g's card.** They were built on step 5's 0402 card. Specs:
   - `RF\work\specs\step07d_stitch_vias.json`: two `free`, `remove_unused` GND vias 0.5 / 0.3 at (72.34, 84.823) and
     (74.34, 85.673);
   - `RF\work\specs\step08_u101ay_to_In2.json`: Net-(U101A-Y) from In1 to In2, 14 segments removed.

   Commands, run from `RF`:
   ```
   NO_CHECKS=1 bash tools/make_step.sh work/step07e work/step05g/kicad control work/specs/step07d_stitch_vias.json
   bash tools/card_checks.sh work/step07e work/step06b
   NO_CHECKS=1 bash tools/make_step.sh work/step08c work/step07e/kicad control work/specs/step08_u101ay_to_In2.json
   bash tools/card_checks.sh work/step08c work/step06b
   ```
   - Read each tool's header first.
   - `card_checks.sh` needs PREV's power board to be byte-identical; step06b's is.
   - The spec coordinates were written for the old card; check that they still apply. The pull-ups are far from
     (73, 85) and from U101A-Y's route, but verify with DRC.
5. **Promote** step 5 + 7 + 8 into `COPY` with `RF\tools\promote.py`: KiCad sch x3 (after 5.3), card PCB, the J9
   `.kicad_mod`, LTspice `BOOST.asc`. Then run the final gates on COPY into a new folder (like
   `RF\work\final_copy_check\`).

### 5.5 Task: the card's longest GND-splitting tracks (approved; not started)
The user said: "place them in the location that would affect other stuff the least (keep other things as intact as
possible)".
- The tracks: **0err_hi on In1** (13.4 mm, at mid (59.33, 84.53), separates In1 pieces 68.6 / 2.5 mm2) and **SDA on
  In1** (7.6 mm at mid (62.06, 100.83) and 5.8 mm at (61.76, 92.01): the In1 run around J9's right end, 18.4 mm in
  all).
- 0err_hi also splits **In4** (15.4 mm, mid (79.67, 101.66): In4 627 / 318 mm2) and B.Cu (8.6 mm).
- Earlier finding: no route exists for them on In2 / F / B (`RF\work\tryC1`, `trySDA`).
- So the new instruction means: they may stay on a GND layer, but re-place each one where it splits the least.
  Ideas:
  - run it along an existing plane gap, a board edge, or right next to other tracks, so it adds no new split;
  - re-measure with `pcb_checks.py` (pieces per layer, "SEPARATES" lines, slices) and `sens_check6.py`.
- Keep everything else unchanged.
- `RF\tools\route_new.py` routes on any listed layers. Add a cost that penalises GND-plane area on In1 / In3 / In4, or
  route on the GND layer with the plane-gap cells cheap.
- One step per track; gates and metrics as always. The user must OK any metric that gets worse.

### 5.6 Task: loop-via cost / benefit per location (approved as analysis only; do NOT apply)
The current power board (`RF\work\step06b\`, = COPY) already has ch2's two vias (step 4). Run separate what-ifs for
each remaining location:
- **ch1:** 1 GND via at (73.86, 66.53), d 0.4 / 0.8, at C1.2's edge.
  - flashes F / In1;
  - antipads In2 LX, In3 Vout_1, In4 Vout_1.
- **ch3:** 2 GND vias at (88.31, 84.94) and (89.61, 84.54), at C76.2.
- **Vout_3:** 2 Vout_3 vias at (92.38, 85.8) and (92.38, 87.0), at C4.1.

(Coordinates are from the earlier `RF\work\whatif\loopvias_cu.json`, the "all 7" variant.)

Earlier results, on the base before steps 3 / 6b:

| Variant | Worst loop via (ch2 / ch3 / ch1 / Vout_3) | Cost |
|---|---|---|
| baseline | 3.60x / 2.72x / 2.06x / 2.80x | - |
| ch2 only | 1.72x / 2.72x / 2.06x / 2.80x | Vout_2 +1.2 % |
| ch2 + ch1 | ch1 2.06 -> 1.59x | Vout_1 bank 0.219 -> 0.227 mOhm (+3.7 %) |
| all 7 | ch3 -> 1.69x, Vout_3 -> 1.82x | LX L1 -> M5 1.969 -> 2.051 mOhm (+4 %), long-neck 25.8 -> 34.2 C (the ch3 / Vout_3 vias cut LX on In2 and B.Cu in M5's funnel) |

**What to do:**
1. For each location, make `whatif_vias.py step06b\power_cu.json OUT_cu.json NET:X:Y:0.4:0.8 ...`.
2. Run one solve at a time, `WORKERS=3`:
   ```
   python power6_2026-10-01/tools/solve_copper6.py CU.json route_2026-09-16/branches_power.json --stack JLC061611-7628D --out SOLVE.json --workers 3
   ```
   (from BSB; ~29 min each).
3. Compare against `step06b\power_solve.json` with `compare_solves6.py`.
4. Report a table per location:
   - benefit (worst loop-via ratio before / after);
   - cost (every branch's R / neck / long-neck change);
   - the antipads;
   - a recommendation.
5. Remember: plane-connected vias, so ratings are reported, not judged.

### 5.7 Task: regenerate ALL outputs in COPY (approved, D14). Do it last, after 5.4-5.6 are settled
Use `BSB\r14_delete_2026-10-07\README.md` as the recipe. In COPY, still NOT_FOR_FAB:
- **Gerbers, drill, fab drawings (both boards):** run a COPY of `fab_2026-10-07\tools\make_fab.sh` whose fp-lib-table
  line points at `COPY\KiCad`.
  - The J9 library footprint changed, so the old path would cause a library-mismatch warning.
  - The power stackup note (JLC061611-7628D, "Specify Stackup") and the card's 0.5 oz stackup must stay in the
    drawings (`fab_drawing.py` POWER6 / HALF branches).
- **BOM / CPL CSVs** (both boards; the card changes: R106 / R107, R99 / R102), `COST_SUMMARY.md`,
  `SOURCING_TABLE.md`, `ORDER_CHECKLIST.md` (via count, totals), and `BOOST_BOM.xlsx` (`make_xlsx.py`; check it in
  Excel through PowerShell COM: 0 formula errors, total).
  - The power board's via count changed (steps 4 / 6b added vias), and JLC prices by via count / unique parts.
  - Re-read JLC stock / prices with `jlc_parts.py` if needed.
- **STEP:**
  - `assembly_3d_2026-09-30\tools\build_assembly.py`, then **always** `assembly_3d_2026-09-24\tools\step_to_glb.py`
    if a GLB is wanted (build_assembly's own GLB has the wrong units / axis);
  - re-run `write_clearances.py`;
  - update `CLEARANCES.md` if any row changes (the new 0603s on the card top are small, but check the lid rows).
- Update COPY's README "what changed", `CHANGES_XY.md` (`RF\tools\changes_xy.py` from `RF\work\changes_steps.json`;
  add steps 5 / 7 / 8 and the regenerated files), `FIX_REPORT.md`, `METRICS.md` / `METRICS_final.md`
  (`RF\tools\collect.py`), `CHANGELOG.md`, `ANSWERS.md`, and memory.
- **Do NOT copy anything into the shipped folders.** The user decides about shipping after reading the report.

### 5.8 Not done, with reasons (keep in the report)
- X3 reroutes (P6 gate / switch nodes in pours, the Current track, the analog_5V vias): the user said not now.
- D6 net renames: the user said no.
- D8 open items (overview tags, bypass-cap note rewording, directive column regrouping, master-schematic line, the
  220 ohm / 5.1 ohm reason note): never answered.
- P2 (Output 1 -> J3, 8.46 mOhm): the In3 bar is only 1.3 %; the limit is a 2.4 mm neck at (54.7, 72.3) plus length.
- P3 (LX -> M5): length-bound, about 3 %.
- P5 (D28 / D29 Vin feed): the western Vin trunk also feeds U17 / U1.
- C2 (In3 21.4 mm2 one-via piece): no legal via spot.
- C5 (stacked pairs Reset_raw / IREF1 over SDA): depends on SDA's re-placement (5.5).
- D19 KiCad Sim fields (TVS_5KP54A, LCSC C20415356) do not match LTspice / BOM. The user said D19 is fine; ask which
  is meant.
- `CLEARANCES.md` source table still names the G579 pad; the docs default to McMaster 1272N32. Heights unchanged.

---

## 6. Tools you will use (read each header before running it)

KiCad 10 is at `C:\Program Files\KiCad\10.0\bin\` (`kicad-cli.exe`, and `python.exe` with `pcbnew`). It is **not on
the Git Bash PATH**. System Python has numpy, scipy, matplotlib, Pillow and pypdf. openpyxl / xlsxwriter are NOT
installed. Excel is installed (use PowerShell COM). pdftoppm is missing.

**`RF\tools\` (the review-fix toolkit):**
- `make_step.sh STEP PREV_KICAD power|control SPEC...`: copies PREV, applies `pcb_text_edit.py` specs, refills / saves
  with kicad-cli, guards `.kicad_pro` / `.kicad_dru` hashes and CRLF, then `step_checks.sh`. `NO_CHECKS=1` skips the
  checks. STEP must not exist.
- `step_checks.sh STEP`: every gate and metric. Env: `WORKERS`, `SKIP_SOLVE`, `SKIP_HEAT`, `THERMAL=1`.
- `card_checks.sh STEP PREV`: card-only gates. The power board must be byte-identical to PREV's; it copies the power
  results across.
- `solve_only.sh STEP`: re-runs a failed solve; old outputs are moved, not deleted.
- `collect.py WORK STEP...`: builds `METRICS.md`.
- `pcb_text_edit.py SPEC IN OUT`: removes / adds segments and vias by text. `"free": true` writes `(free yes)`.
  `"remove_unused": true`. OUT must not exist.
- `route_new.py BOARD JOB OUT_SPEC` (KiCad python): a grid router (0.05 mm), octilinear.
  - Job keys: `region`, `clearance` (ONE value for all nets; use 0.25 on the card because GND is in the Power class),
    `via`, `via_cost`, `turn_cost`, `layers`, `layer_cost`, `foreign_via_keepout`, `connections` (`pad` or
    `start_xy`; `goal` = plane / copper / plane_or_copper / points).
  - **Patched 2026-10-12:** no via in or touching a pad of its own net (the old copy is `RF\work\route_new_before_vip.py`).
- `free_spots.py`: where a part fits. `stitch_vias.py`. `make_fp_block.py` (KiCad python: library footprint -> board
  block; F or B). `add_footprints.py` (inserts blocks, sets Values / Sim.Params).
- `fp_text_edit.py SPEC KICAD_DIR LOG`: footprint courtyard / text / field edits on the board AND the matching
  library `.kicad_mod` (new 2026-10-12).
- `pcb_diff.py`, `changes_xy.py`, `pcb_render.py BOARD OUT.png LAYERS x1 y1 x2 y2` (KiCad's own SVG -> headless Edge
  PNG).
- `promote.py LABEL SRC DEST FILE...`: the ONLY way to write COPY. It refuses shipped folders, lock files and an
  LTspice-open `.asc`, checks the expected old hash, backs up, and logs.
- `sync_check_rf.py`: sync_check with R106 / R107 added to the card assignment.
- `step05e_kicad_sch.py`, `step05f_card.sh`, `step05g_card.sh`, `step05b_ltspice.py`, `step05_fab.py` (0402; needs a
  0603 variant), `docs_edit.py`, `whatif_vias.py`, `gates_all.sh`, `sense_cover.py`, `sense_offsets.py`, `sim_case.py`,
  `d19_cycles.py`, `net_map.py`, `mock_*.py`.

**Power-board metrics:** `power6_2026-10-01\tools\` (section 4). Use `branches_power.json` from `route_2026-09-16\`.

**Card metrics:** `review_2026-10-10\pcb\pcb_checks.py CU.json card OUTDIR`; `card6_2026-09-30\tools\sens_check6.py`.

**LTspice:**
- `ltspice_equiv.py --ref PRISTINE` (E1-E5) with `approved_changes.json`;
- batch runs: `LTspice.exe -b X.net` (generate the netlist with `-netlist`);
- a `§` in a TEXT line hangs `-netlist`;
- one failed `.meas` suppresses all `.meas` output;
- save LED currents as `I(SIM_LED1)`;
- screenshots: `ltspice_capture.py`.

**JLC:** `bom_2026-09-30\tools\jlc_parts.py snapshot CODES` / `search KEYWORDS` (plain POST to JLC's v2 parts API).

### 6.1 Known traps (each one has bitten before)
- **A via with no track or pad needs `(free yes)`**, or KiCad gives it a zone's net on save.
- **The card's GND is in the Power netclass:** 0.25 mm clearance. Default and Rail (5V) are 0.2.
- Card custom rules (`BOOST_control_RC2.kicad_dru`):
  - no foreign via within 2 mm of U2 In+ or Current copper (GND vias excepted);
  - via drill >= 0.3 mm;
  - NPTH hole clearance 0.3 mm.
- Power board: Vin vias need drill >= 0.4 mm; Vin tracks are never narrower than 1.0 mm.
- **A via or track end joins a pad only if one's centre lies inside the other.**
- **`remove_unused_layers`:** unflashed via layers are only a hole, which still needs 0.2 mm hole clearance.
- **J9's pads are flashed on all six layers**, so nothing routes between J9 pads on any layer.
- **Library vs board footprint:** editing a footprint on the board without its `.kicad_mod` adds a
  `lib_footprint_mismatch` warning (texts and courtyards are compared).
- **kicad-cli writes `.kicad_prl` files** next to boards and schematics it opens (netlist export, pos files). Work on
  copies.
- **After a few `BOARD.Remove` calls,** pcbnew's `GetTracks()` turns into bare SwigPyObjects: keep your own list,
  save, and reload.
- **Headless Edge from Python:** send stdout to a file and wait for the PNG.
- **Git Bash `grep -c $'\r'`** counts every line; count CRLF in Python.
- **The copper-edge vs H5 / H6 keep-out finding** (3.10-3.21 mm from the hole centre, inside the 3.5 mm circles; KiCad
  does not flag it) is harmless and known.

---

## 7. Open problems and loose ends (project-wide)

1. **Step 5g needs the user's picture OK**, then the LTspice approval entry, BOM / CPL, steps 7 / 8 rebuild and
   promotion (5.4).
2. **The user's U26D edit** in COPY's card sheet (5.3): acknowledge and record it.
3. **Card GND-splitting tracks** (5.5), **loop-via cost / benefit** (5.6), **full output regeneration** (5.7).
4. **COPY is NOT_FOR_FAB.** Shipping to the three shipped folders needs the user's explicit words, backups, and the
   same regeneration in each.
5. **Firmware notes to keep:**
   - with R99 / R102 at 1k, U26's address is fixed at 0x2C (before, A0 / A1 could latch high: 0x2C-0x2F);
   - never command Vref before the battery is connected;
   - dimming below ~19-25 % duty needs the firmware to lower the current target and raise the PWM duty.
   - The A0 firmware note was lost from the README; the new README should state the fixed address.
6. **I2C bus not verified:** the J9 wire length and bus speed are unknown. With 4.7k: about 250 pF at 100 kHz, 75 pF at
   400 kHz.
7. **Unverified part data:** HYG180N10 R_jc (no datasheet on disk); UCC21520 DT = VCCI behaviour (not re-read); the S2MW
   short-pulse margin (sister-part data); the MCP4451 code-0 convention; the TVS 5.0SMDJ54A model values.
8. **LTspice:** the realistic power-up start (instead of the `.ic` shortcut) was requested "later" and never done.
   BOOST_reorg and BOOST-github still have R14 and old layouts (deliberately not updated).
9. **Card sensitive nets** are weaker since the 6-layer card (U2 In+ 65.6 %, V_err 90.4 %). The user chose to keep
   6 layers (re-confirmed 2026-10-11: "I want to keep both boards at 6 layers").
10. **Power board open items (10-02 review), not touched:**
    - unreturned gate drive M2 42 % / M7 38 %;
    - sense nets over GND 74 %;
    - U16 Tj about 117.7 C (limit 125);
    - the user's J4-entry stitching vias (their call).
11. **Stale docs:** `BSB\README.md` "Current state"; FINAL_2026-09-25.
12. **`~$BOOST_BOM.xlsx` in BOOST_package** is stale but must not be deleted by you.

---

## 8. Memory

The memory directory (path in section 0) holds one fact per file with frontmatter, indexed by `MEMORY.md`. Keep it
current:
- update `boost-routing-status.md` at the end of each session with what changed (hashes, approvals, what is waiting);
- add new feedback rules as their own files.

The rules in section 2 come from these files:
- `no-weakened-drc-rules`
- `check-in-at-decisions`
- `verify-part-specs`
- `shipped-file-handling`
- `never-rerun-onto-user-files`
- `schematic-comment-style`
- `ipc2221-short-necks`
- `price-lookup-policy`

Plus `boost-tooling-reference` and `boost-powerup-fix-ideas`.

---

## 9. Suggested first message to the user

Two choices:
- Show the step 5g pictures (`RF\img\step05e\j9_F_before.png` vs `j9_F_after_5g.png`, and the In2 pair), explain the
  placement and the label / text moves, and ask for the OK. Mention that you kept their U26D move.
- Or, if they want progress first, start the loop-via what-ifs (5.6). They touch only scratch copies and need no
  approval.

Do not promote, regenerate or ship anything until the placement is approved.
