ChristopherCa55/led-driver/BOOST_split_boards/card_route_2026-09-22/ROUTING_CHECKIN_3_2026-09-23.md

# Control card — check-in 3 (interim): routing does not close yet, decision needed

2026-09-23. Your three additions are done and measured (§1). The sensitive nets route exactly as specified (§2). The
general routing gets close but not to zero: the best board still has **24 unconnected pairs in 17 nets** (§4). Closing
it needs either a stronger router (a download, your permission) or a little placement relief (reopens your approved
placement), so this is a check-in, not the routing report. Nothing is ready for fabrication; every board here is
`NOT_FOR_FAB` work in `card_route_2026-09-22/work/`.

## 1. Your three additions

**J9 labels** (footprint `BOOST:WirePads_11_Staggered_P1.27mm_Drill1.0mm_TieSlots`, regenerated by
`card_2026-09-17/tools/make_wirepads_fp.py`; the old file is in `previous/2026-09-22/j9_footprint_before_labels/`):
- Pad names V1 V2 V3 I1 I2 I3 SCL SDA 5V GND INH, on **F.SilkS and B.SilkS** (mirrored on B), 1.0 × 1.0 mm text,
  0.15 mm stroke.
- Odd pins are labelled in a row above the pads and even pins in a row below. SDA and GND sit 0.3 / 0.4 mm off their
  pad centres so their strokes don't touch.
- Pin 1 has a square pad plus a 0.6 mm silk dot beside it, on both sides.
- Measured gaps (KiCad stroke geometry, at J9's board position):
  - label to its own pad: 0.20–0.34 mm;
  - label to label: 0.30 mm or more;
  - label to any other part's pad: 1.28 mm or more.
- The free band above and below the pads is 2.68 mm, not 3–4 mm: other parts' pads start at y 92.22 and 102.12.
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
