ChristopherCa55/led-driver/BOOST_fit_study.png

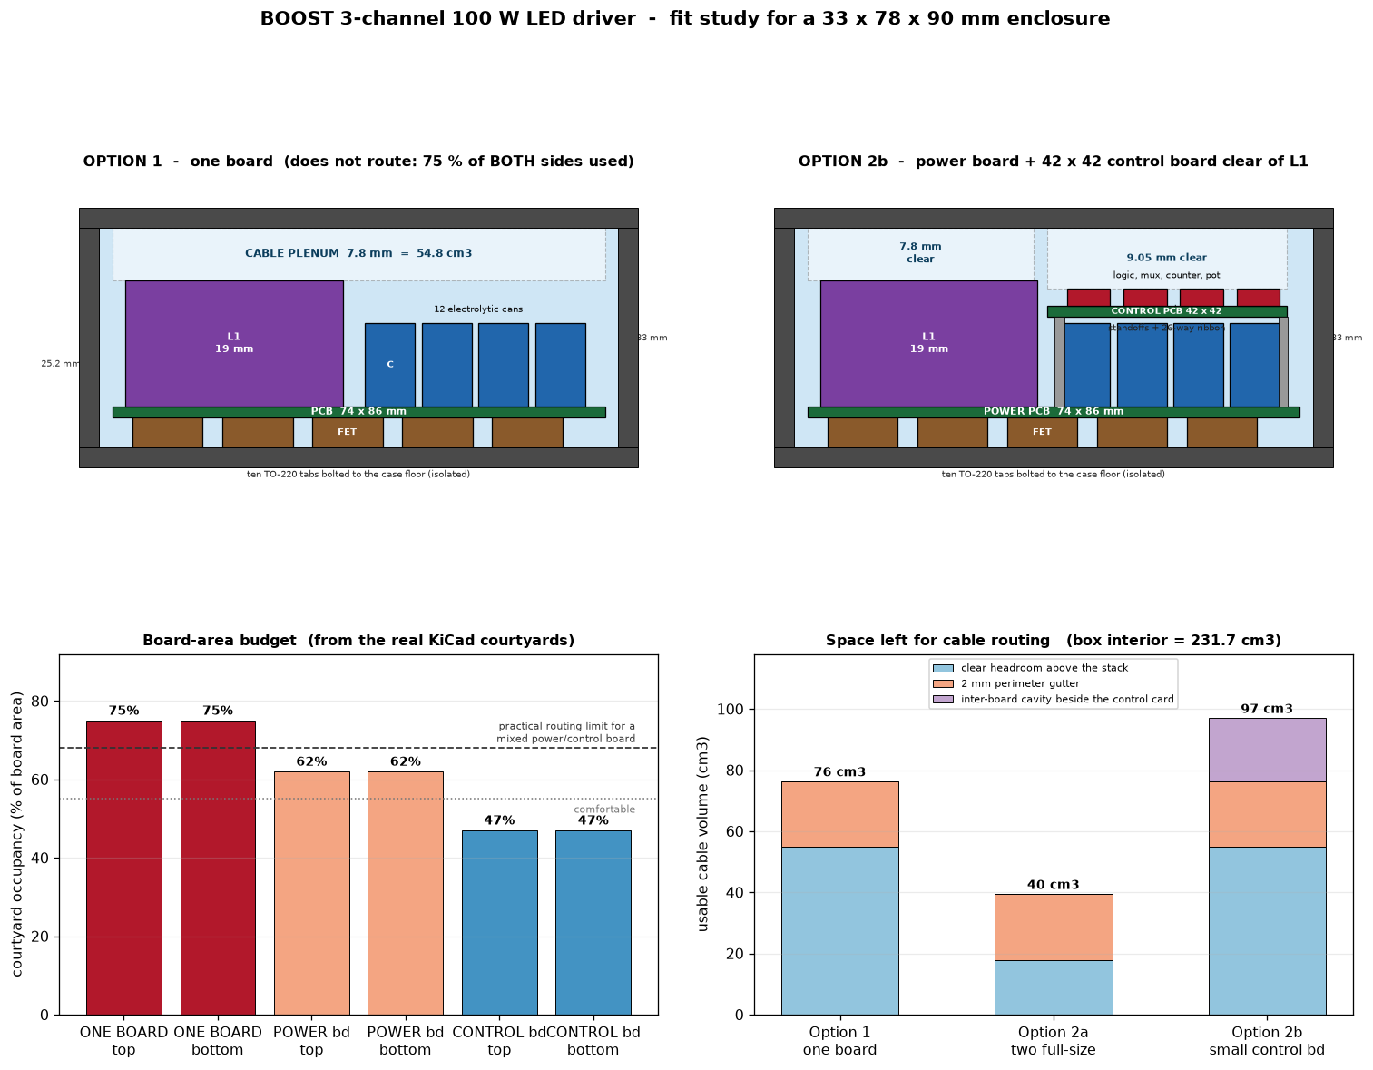
BOOST_fit_study.png
