ChristopherCa55/led-driver/BOOST_option2b_placement.png

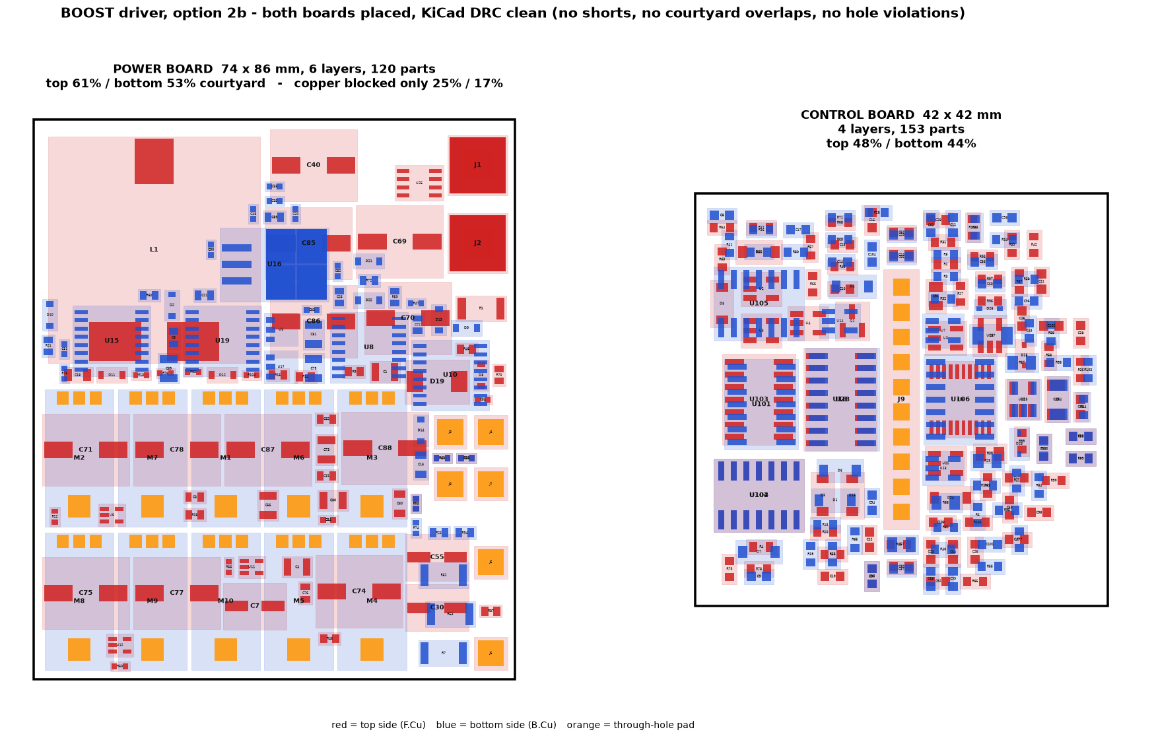
BOOST_option2b_placement.png
