ChristopherCa55/led-driver/BOOST_schematic_cleanup/precharge_check/power_bottom_after.png

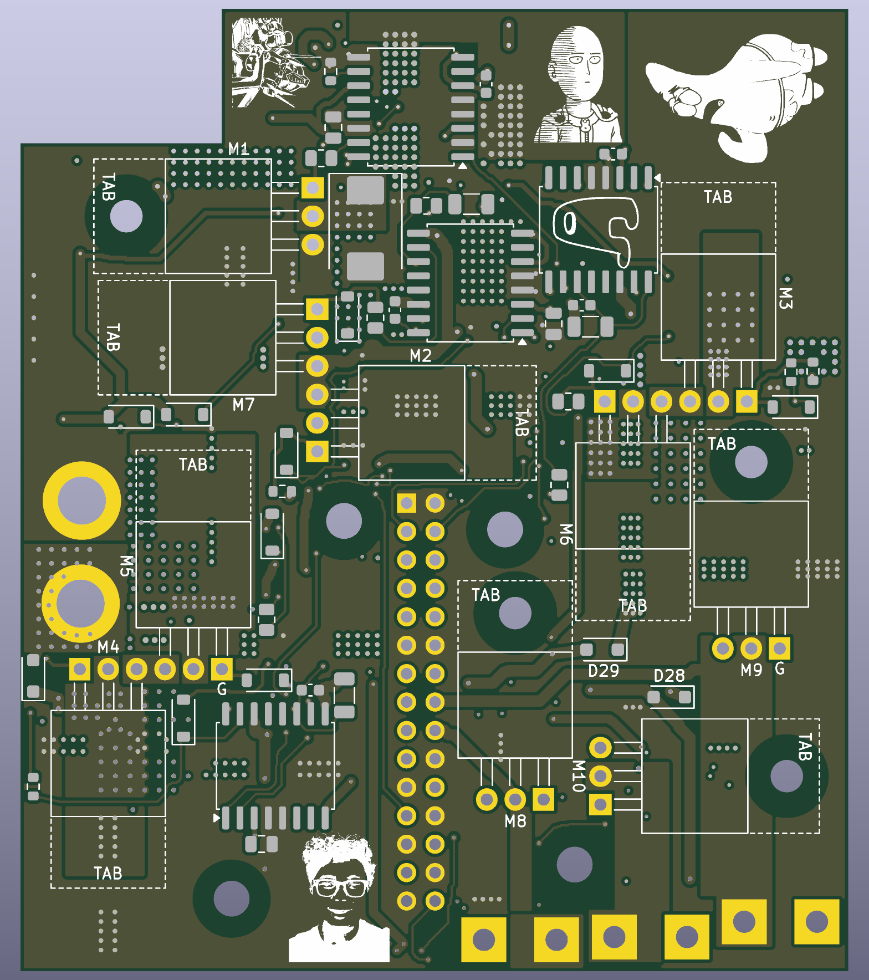
BOOST_schematic_cleanup/precharge_check/power_bottom_after.png
