ChristopherCa55/led-driver/BOOST_schematic_cleanup/tools/precharge/reference/after_D28_D29_In3Cu.png

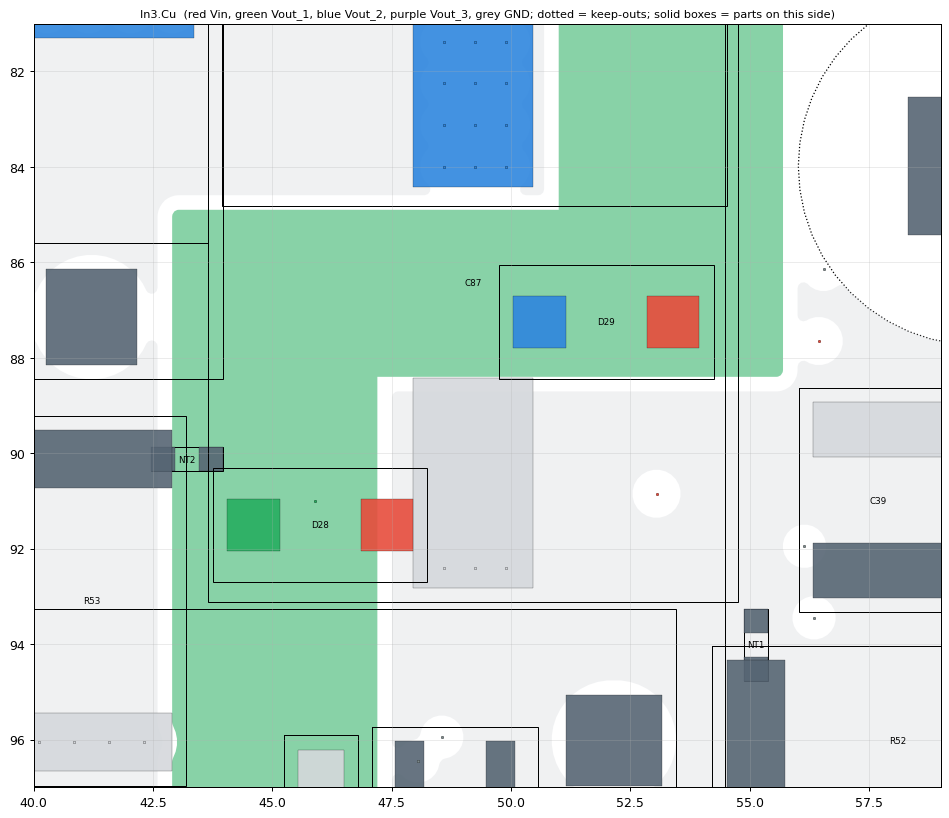
BOOST_schematic_cleanup/tools/precharge/reference/after_D28_D29_In3Cu.png
