ChristopherCa55/led-driver/BOOST_schematic_cleanup/tools/precharge/reference/after_D30_R47_FCu.png

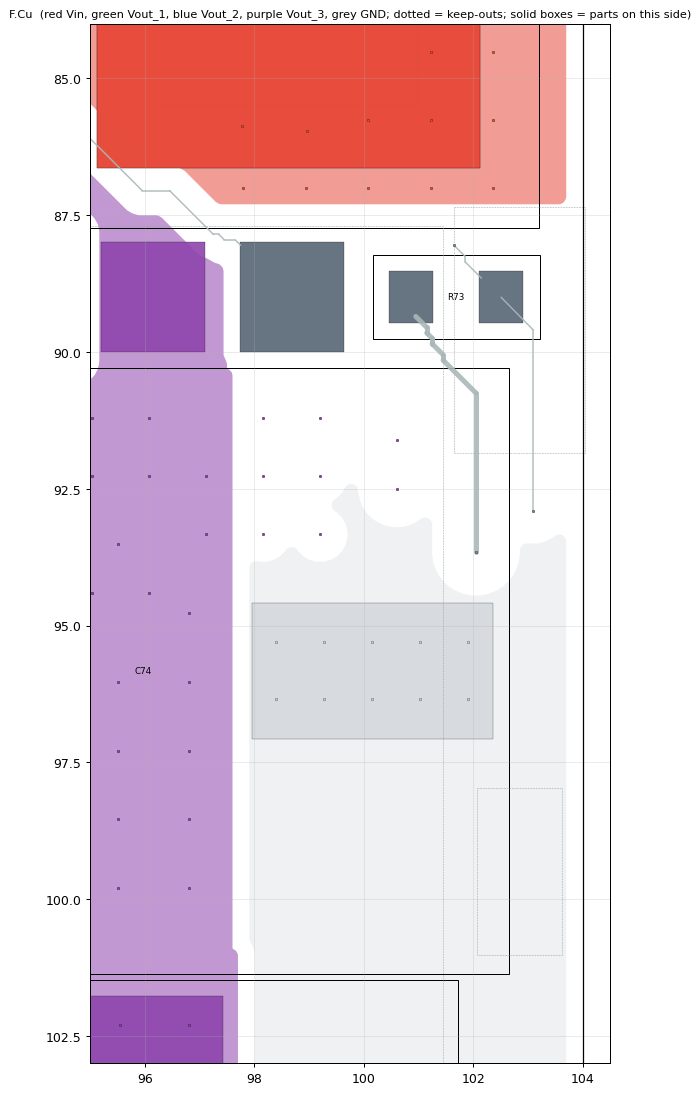
BOOST_schematic_cleanup/tools/precharge/reference/after_D30_R47_FCu.png
