ChristopherCa55/led-driver/BOOST_schematic_cleanup/tools/precharge/reference/before_D28_D29_BCu.png

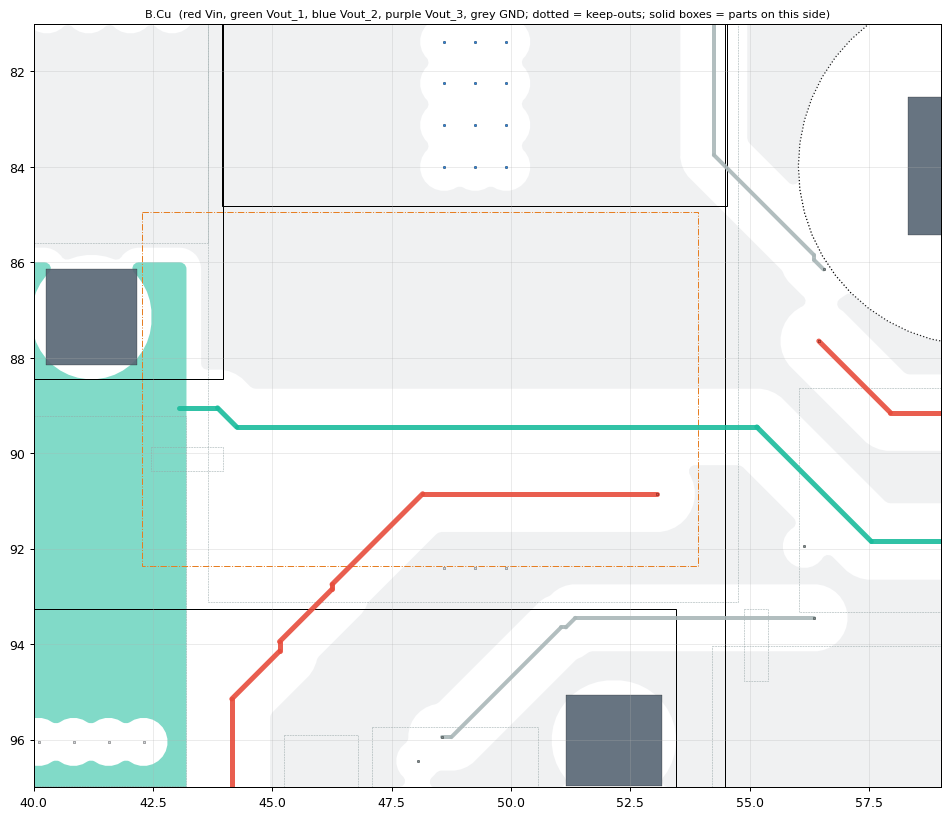
BOOST_schematic_cleanup/tools/precharge/reference/before_D28_D29_BCu.png
