ChristopherCa55/led-driver/BOOST_schematic_cleanup/tools/precharge/reference/before_D30_R47_BCu.png

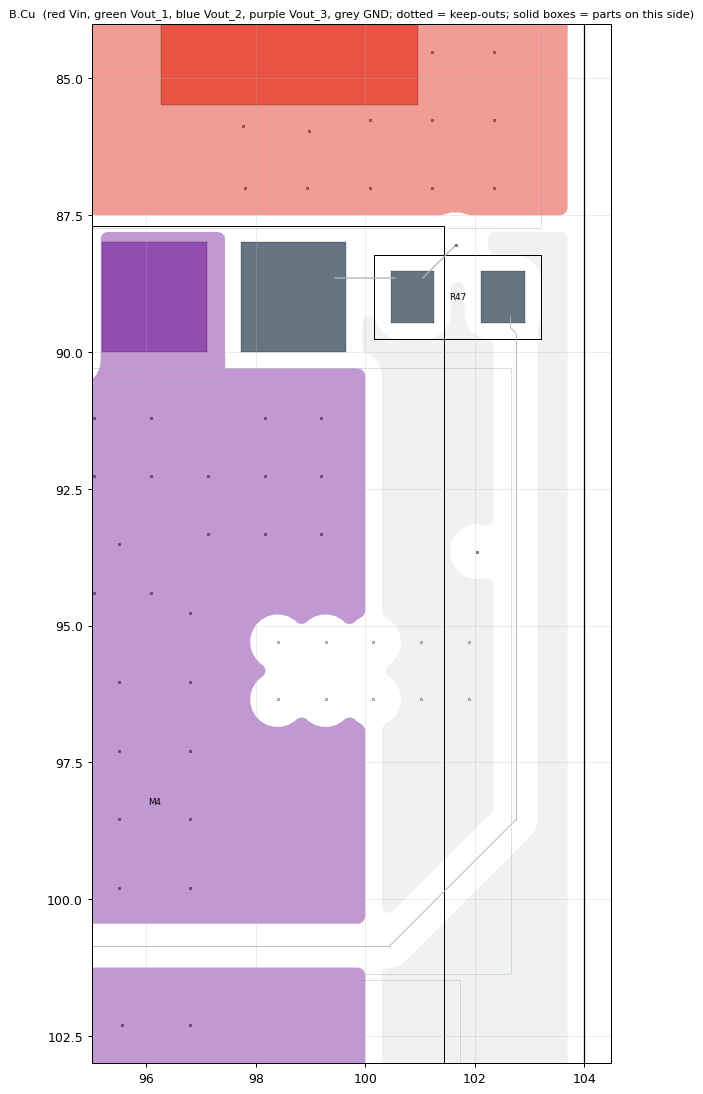
BOOST_schematic_cleanup/tools/precharge/reference/before_D30_R47_BCu.png
