ChristopherCa55/led-driver/BOOST_split_boards/card6_2026-09-30/in4plane/sig5_region.png

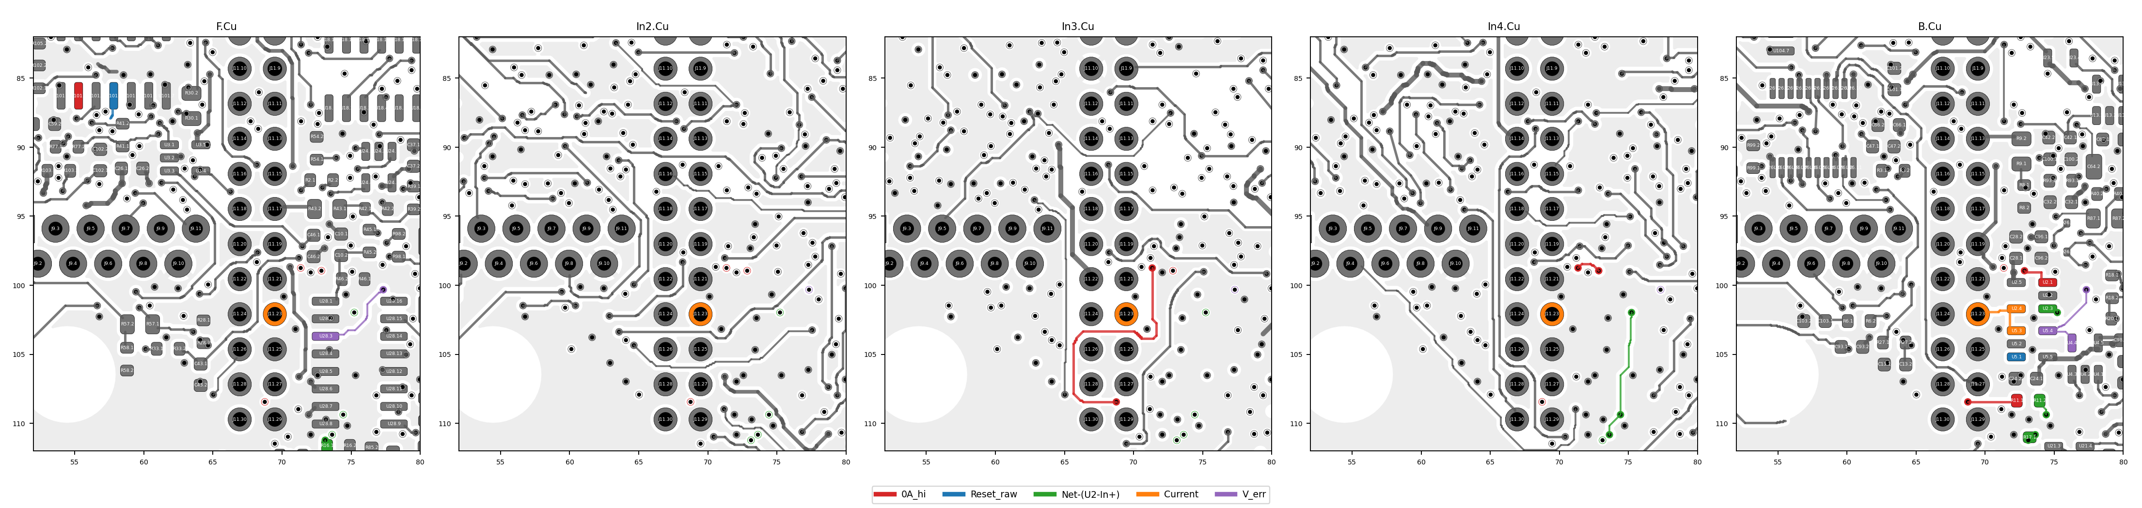
BOOST_split_boards/card6_2026-09-30/in4plane/sig5_region.png
