ChristopherCa55/led-driver/BOOST_split_boards/card_2026-09-17/work/j9_fit_hang2p70.png

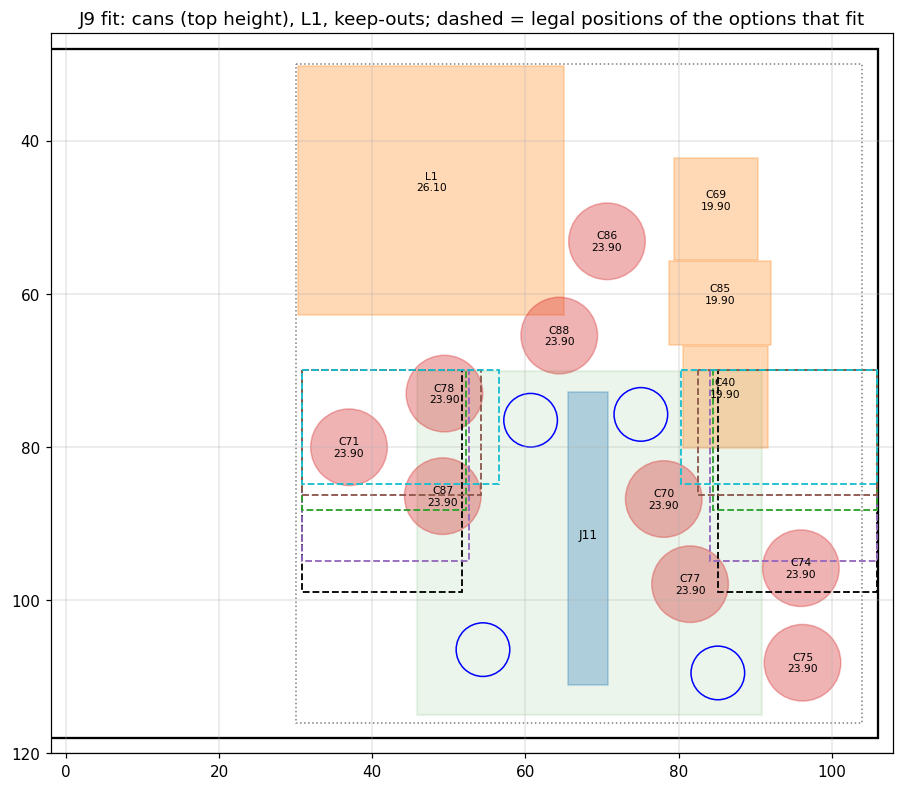
BOOST_split_boards/card_2026-09-17/work/j9_fit_hang2p70.png
