ChristopherCa55/led-driver/BOOST_split_boards/card_route_2026-09-22/renders/c3_cluster_pre.png

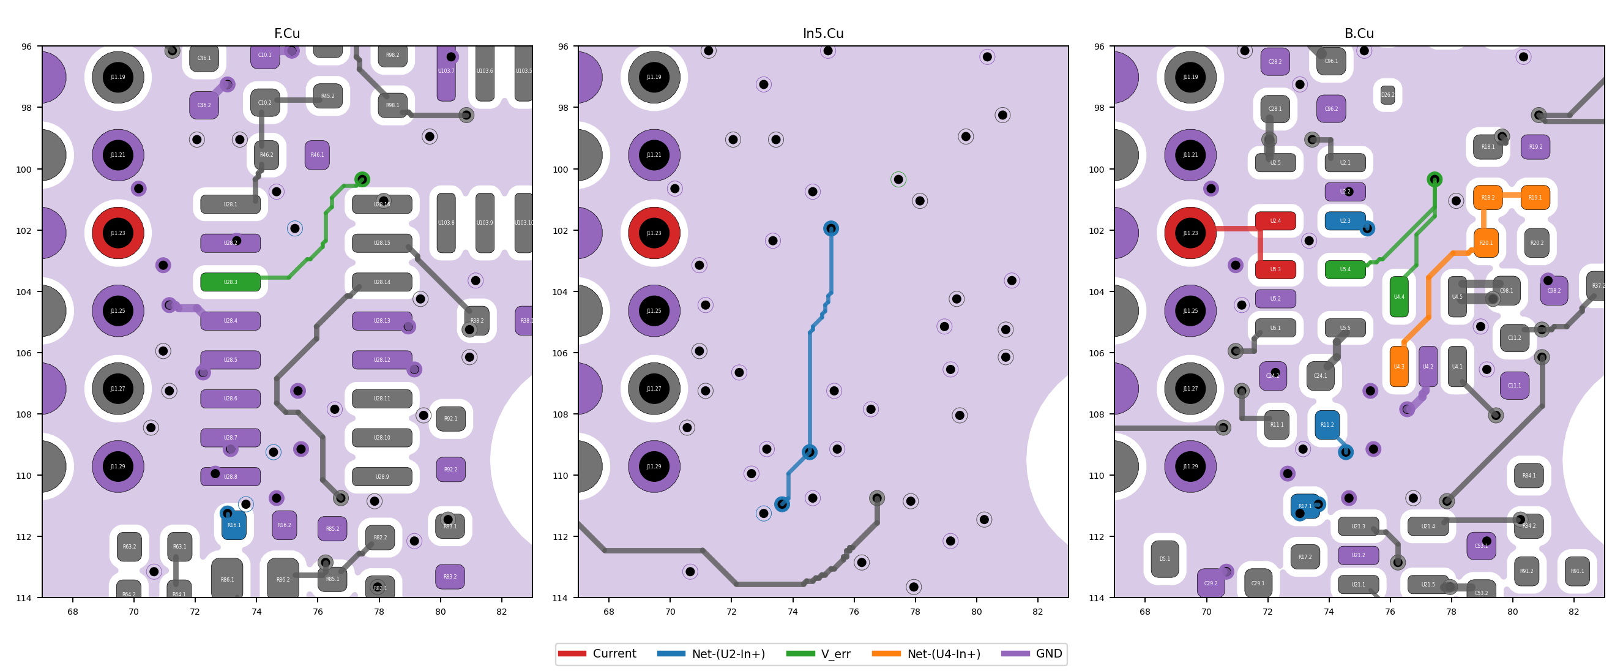
BOOST_split_boards/card_route_2026-09-22/renders/c3_cluster_pre.png
