ChristopherCa55/led-driver/BOOST_split_boards/card_route_2026-09-22/renders/card_c3_open_layers.png

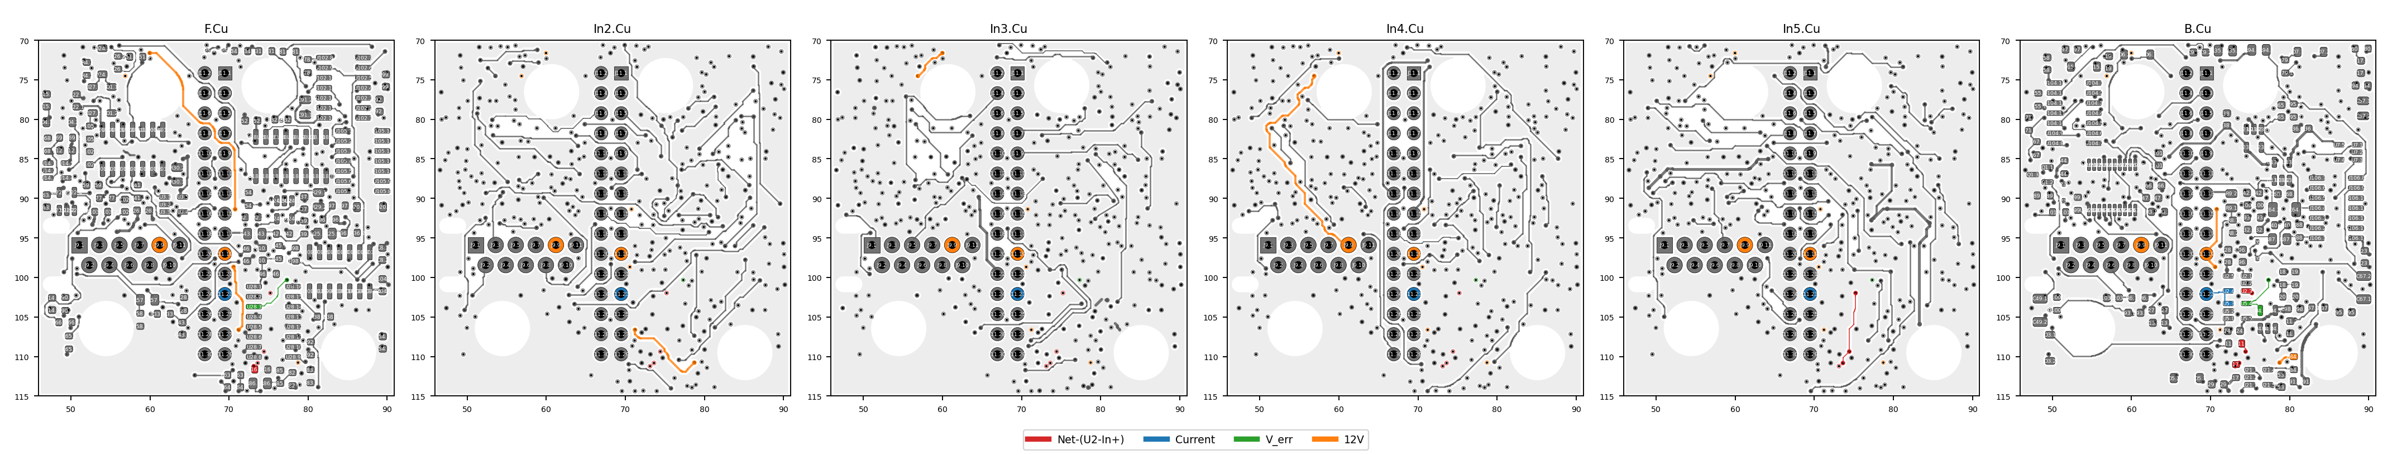
BOOST_split_boards/card_route_2026-09-22/renders/card_c3_open_layers.png
