ChristopherCa55/led-driver/BOOST_split_boards/card_route_2026-09-22/renders/fin_sda.png

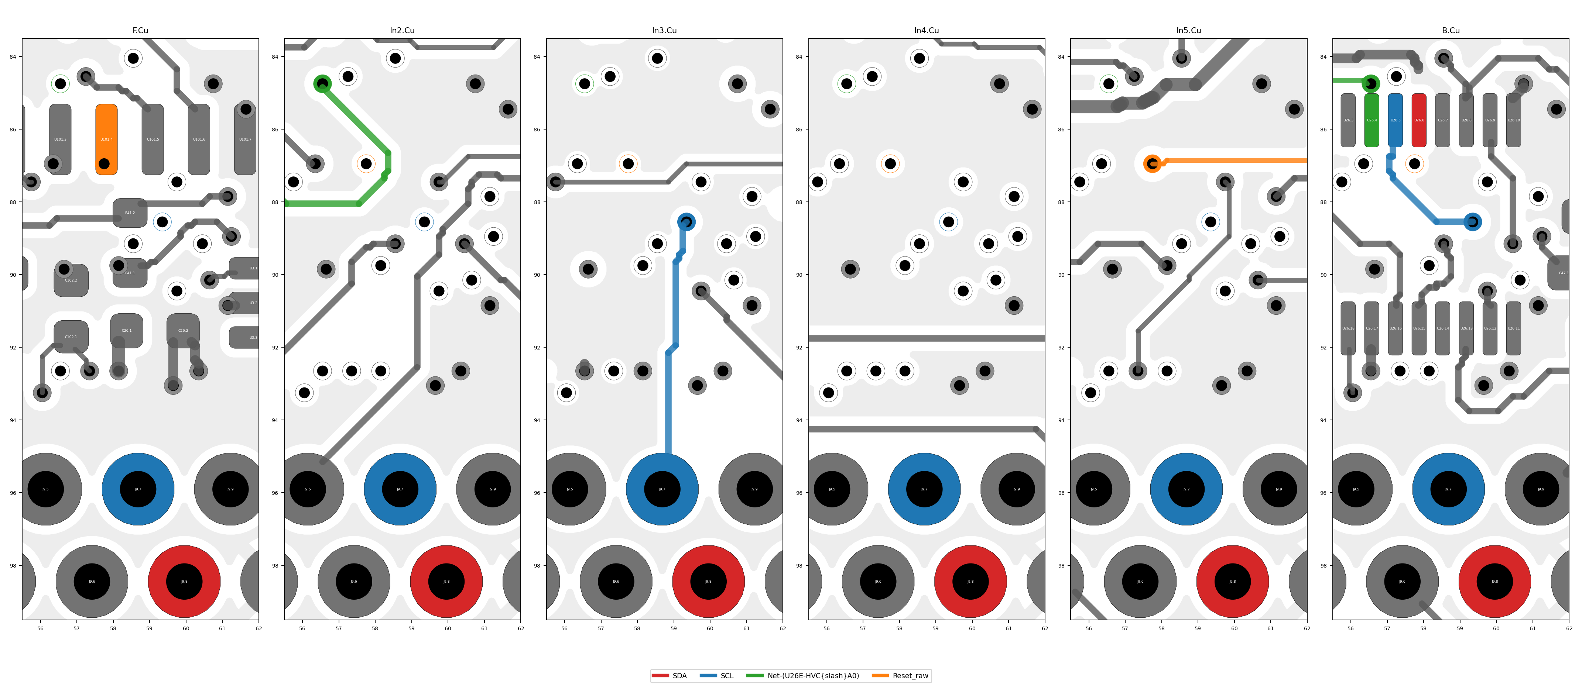
BOOST_split_boards/card_route_2026-09-22/renders/fin_sda.png
