ChristopherCa55/led-driver/BOOST_split_boards/card_route_2026-09-22/renders/j9_labels_bottom_rev5.png

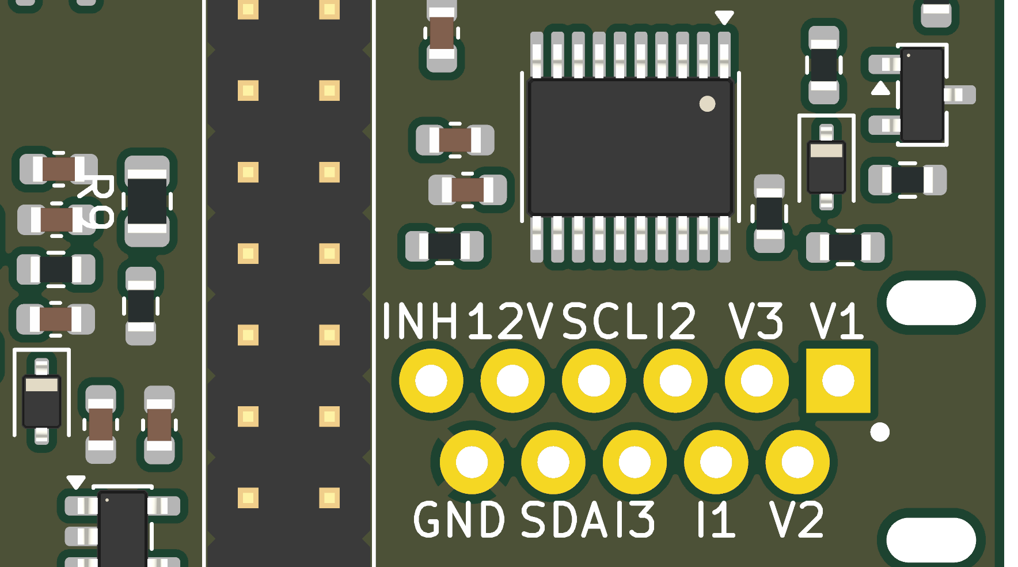
BOOST_split_boards/card_route_2026-09-22/renders/j9_labels_bottom_rev5.png
