ChristopherCa55/led-driver/BOOST_split_boards/FINAL_2026-09-25/3_fab/card/BOOST_control_RC2_fab_drawing.png

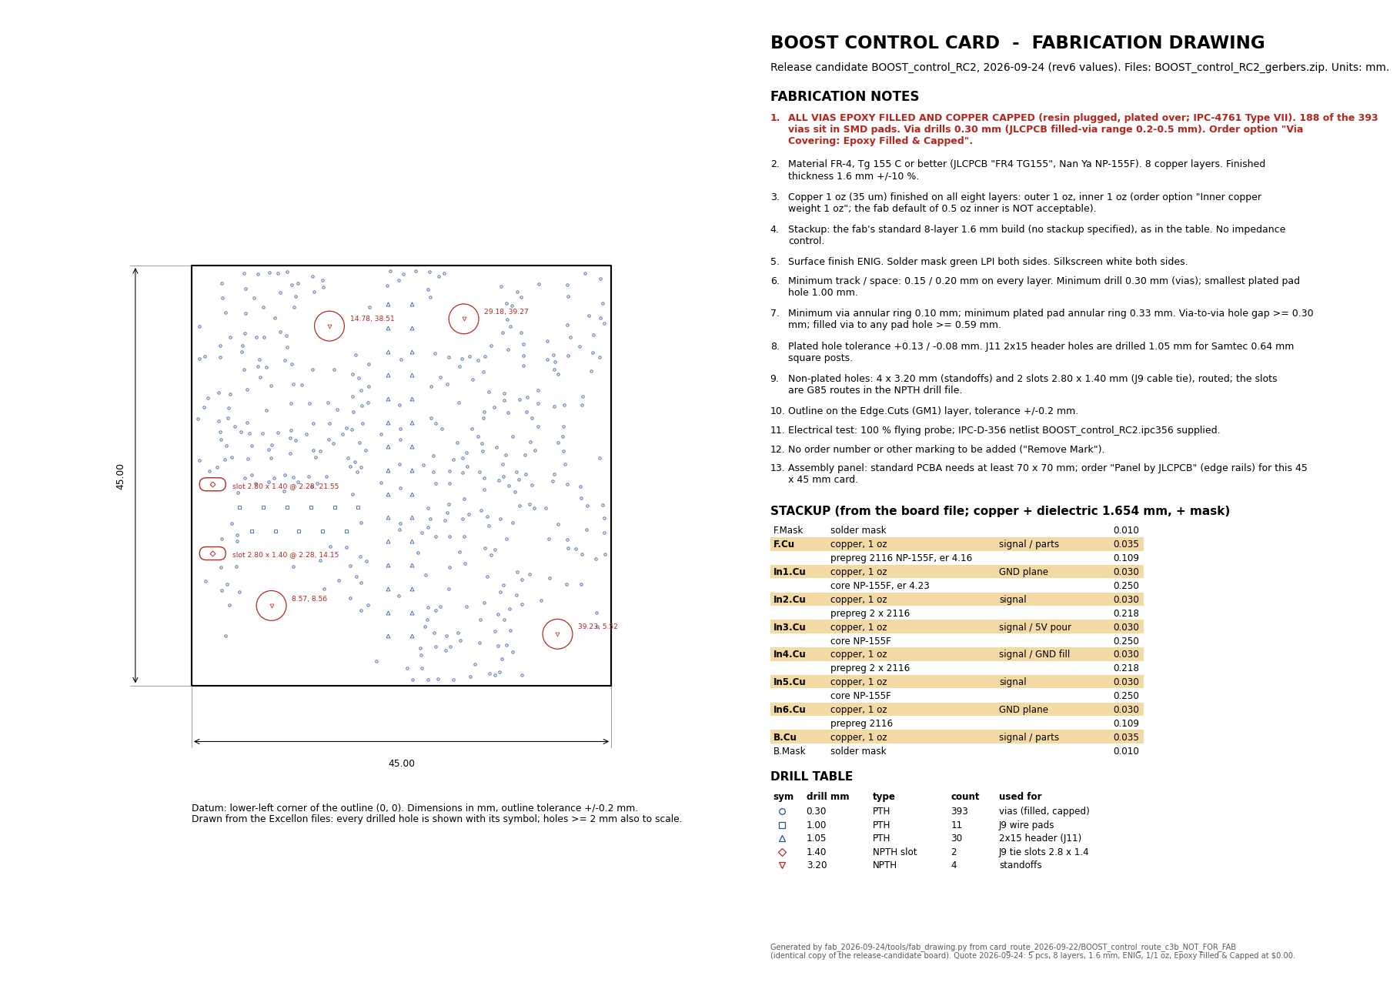
BOOST_split_boards/FINAL_2026-09-25/3_fab/card/BOOST_control_RC2_fab_drawing.png
