ChristopherCa55/led-driver/BOOST_split_boards/FINAL_2026-09-25/6_3d_model/renders/top.png

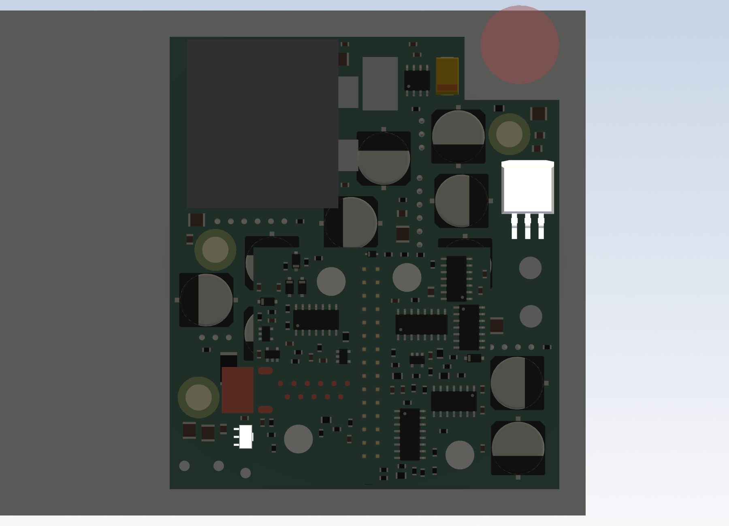
BOOST_split_boards/FINAL_2026-09-25/6_3d_model/renders/top.png
