ChristopherCa55/led-driver/BOOST_split_boards/kicad_layout_2026-10-09/work/renders/d_ch1b.png

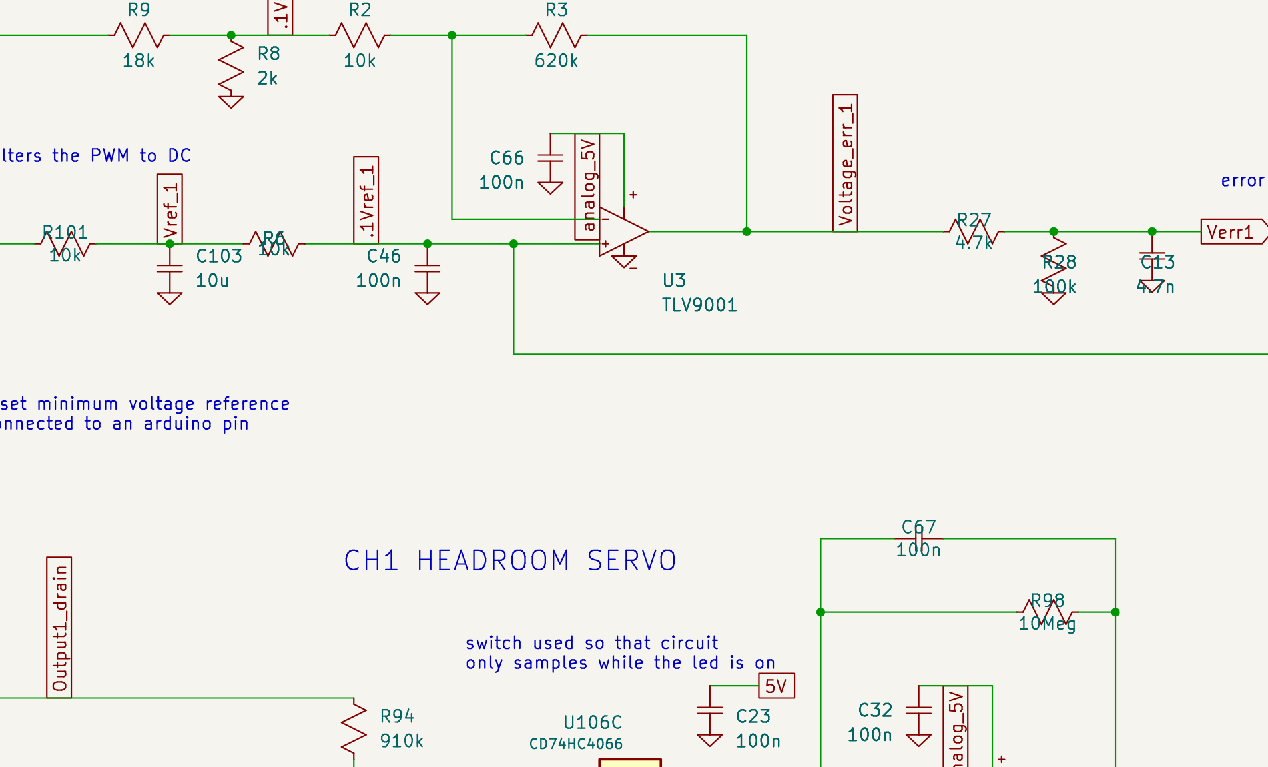
BOOST_split_boards/kicad_layout_2026-10-09/work/renders/d_ch1b.png
