ChristopherCa55/led-driver/BOOST_split_boards/kicad_layout_2026-10-09/work/renders/l_ard.png

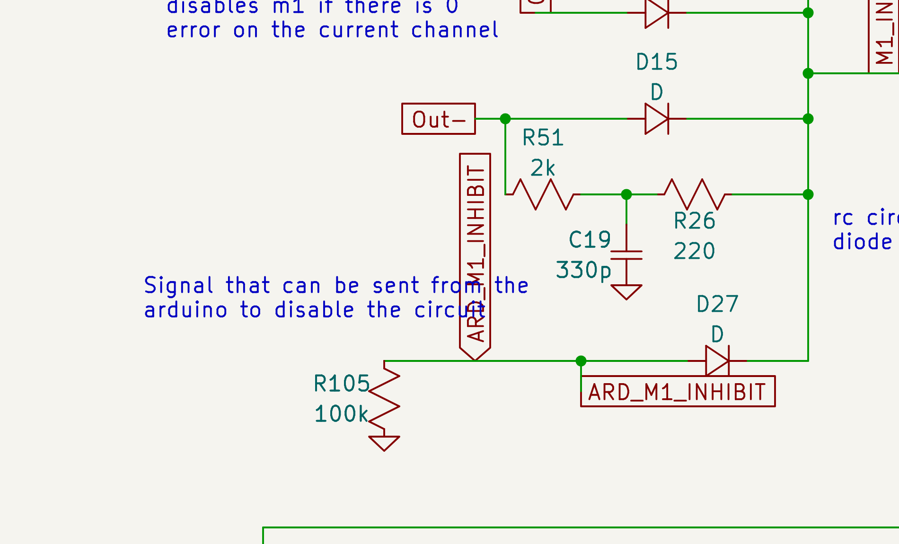
BOOST_split_boards/kicad_layout_2026-10-09/work/renders/l_ard.png
