ChristopherCa55/led-driver/BOOST_split_boards/kicad_layout_2026-10-09/work/renders/m_ena.png

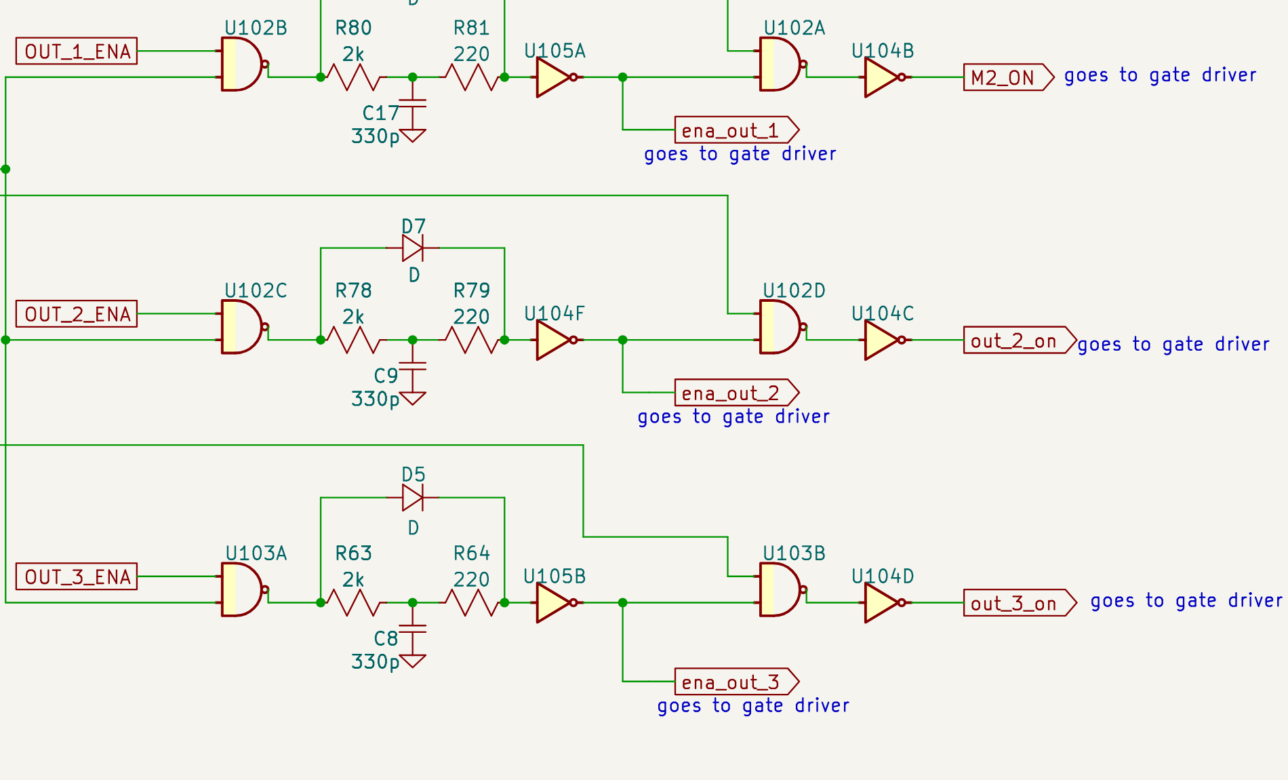
BOOST_split_boards/kicad_layout_2026-10-09/work/renders/m_ena.png
