ChristopherCa55/led-driver/BOOST_split_boards/kicad_sheets_2026-10-09/renders/cut_ch1_control.png

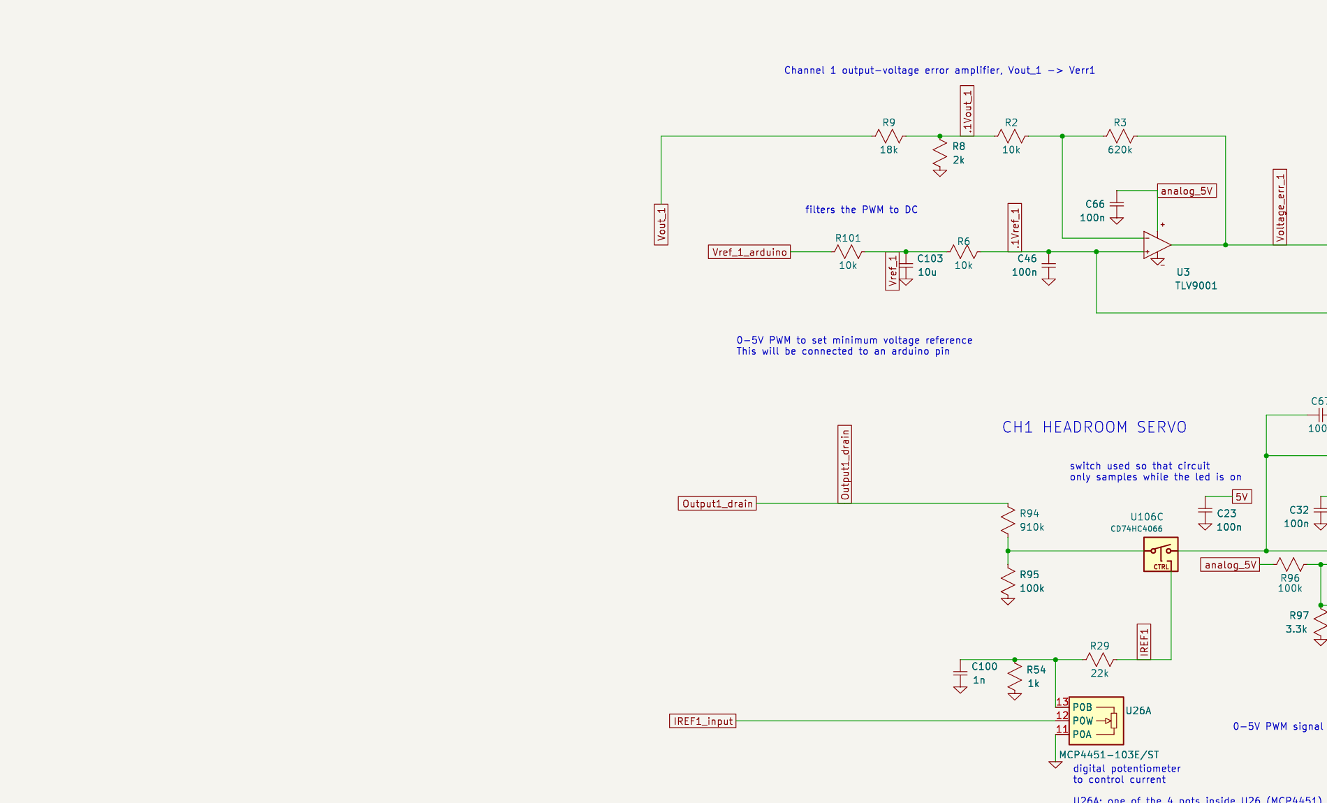
BOOST_split_boards/kicad_sheets_2026-10-09/renders/cut_ch1_control.png
