ChristopherCa55/led-driver/BOOST_split_boards/kicad_sheets_2026-10-09/renders/user_flags.png

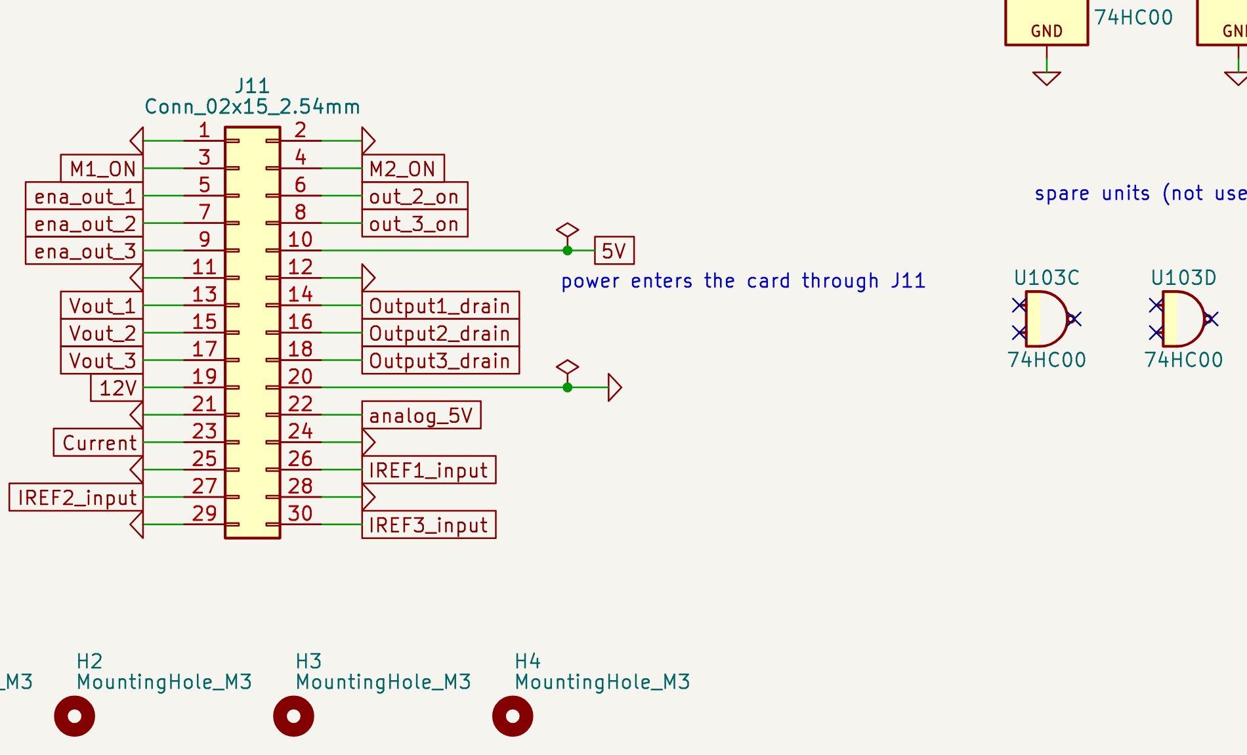
BOOST_split_boards/kicad_sheets_2026-10-09/renders/user_flags.png
