ChristopherCa55/led-driver/BOOST_split_boards/ltspice_layout_2026-10-05/captures/pilot/EA1_1.png

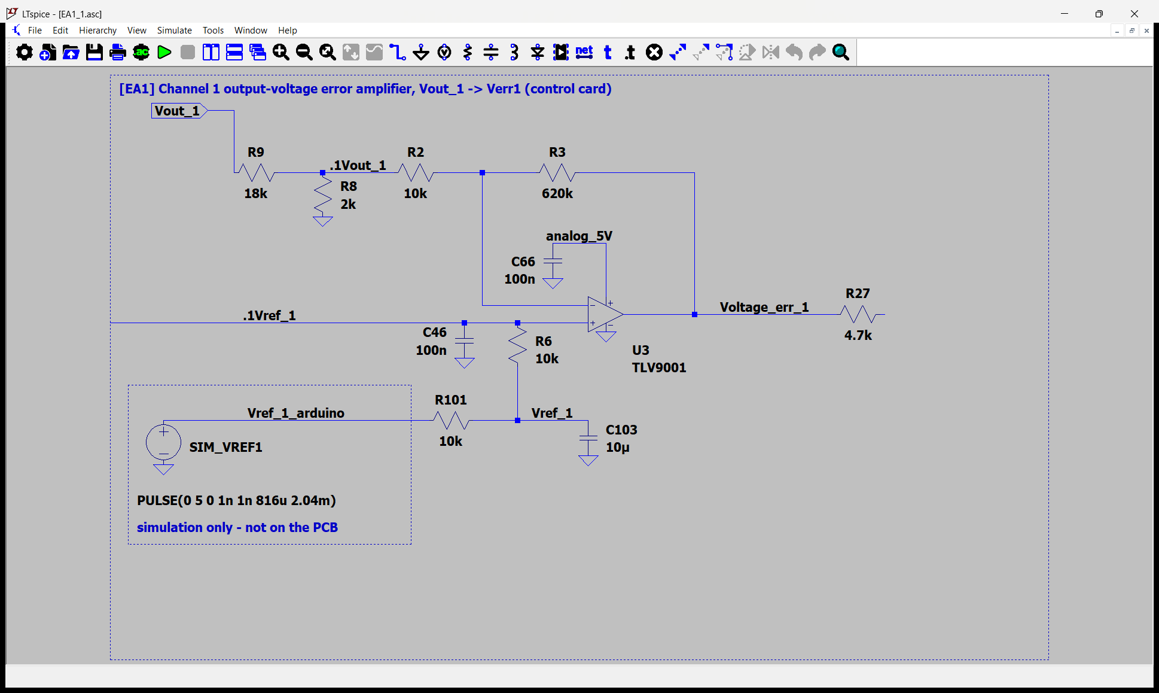
BOOST_split_boards/ltspice_layout_2026-10-05/captures/pilot/EA1_1.png
