ChristopherCa55/led-driver/BOOST_split_boards/ltspice_layout_2026-10-05/captures/revised_review/pilot_overview.png

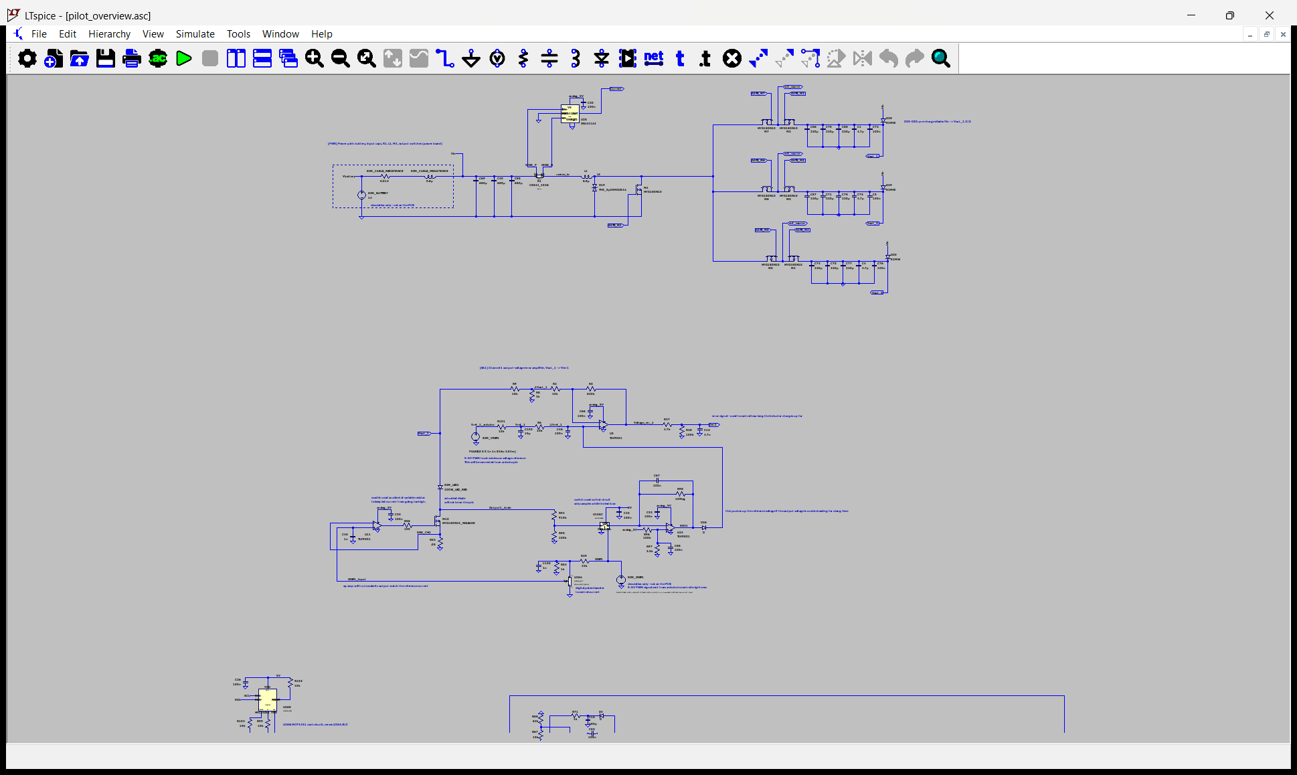
BOOST_split_boards/ltspice_layout_2026-10-05/captures/revised_review/pilot_overview.png
