ChristopherCa55/led-driver/BOOST_split_boards/ltspice_layout_2026-10-05/captures/v4/ch1_error_amp.png

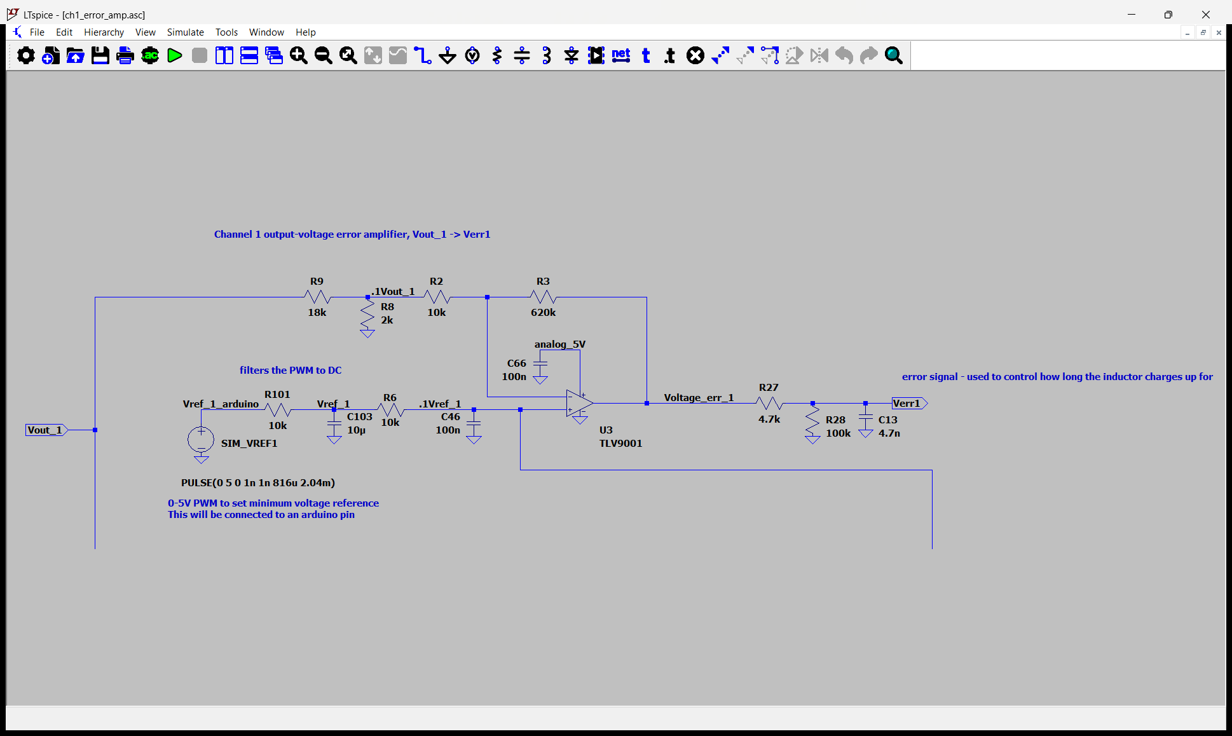
BOOST_split_boards/ltspice_layout_2026-10-05/captures/v4/ch1_error_amp.png
