ChristopherCa55/led-driver/BOOST_split_boards/ltspice_layout_2026-10-05/work/captures_v6/d3_left.png

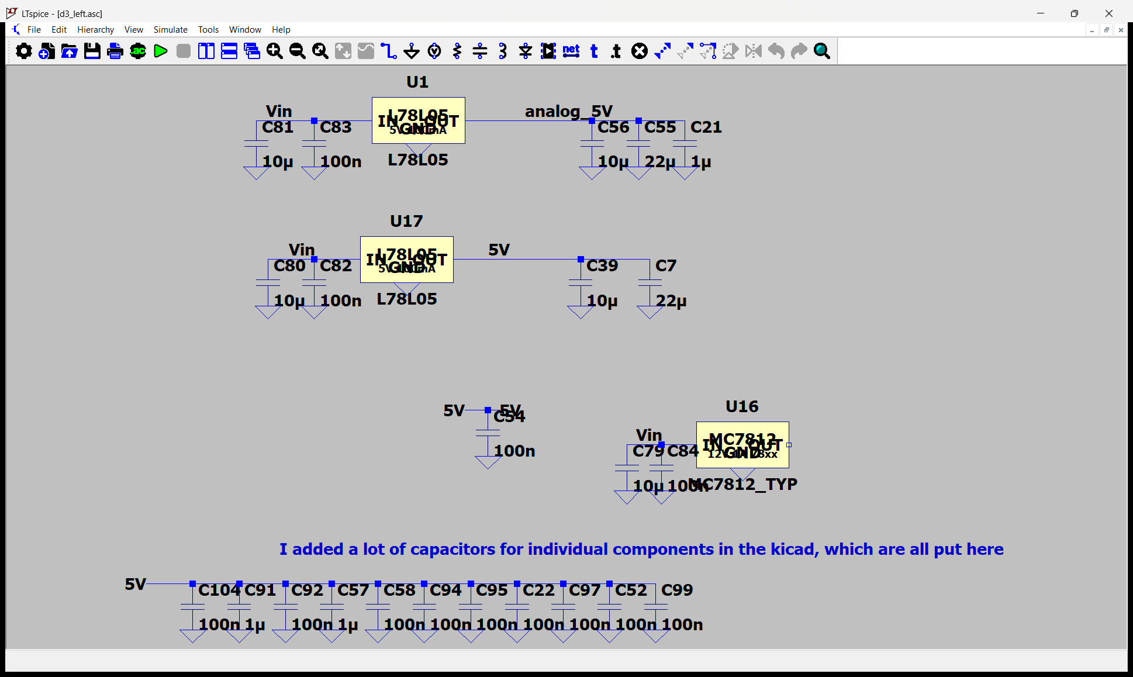
BOOST_split_boards/ltspice_layout_2026-10-05/work/captures_v6/d3_left.png
