ChristopherCa55/led-driver/BOOST_split_boards/ltspice_layout_2026-10-05/work/captures_v6/v7u_ch2_pot.png

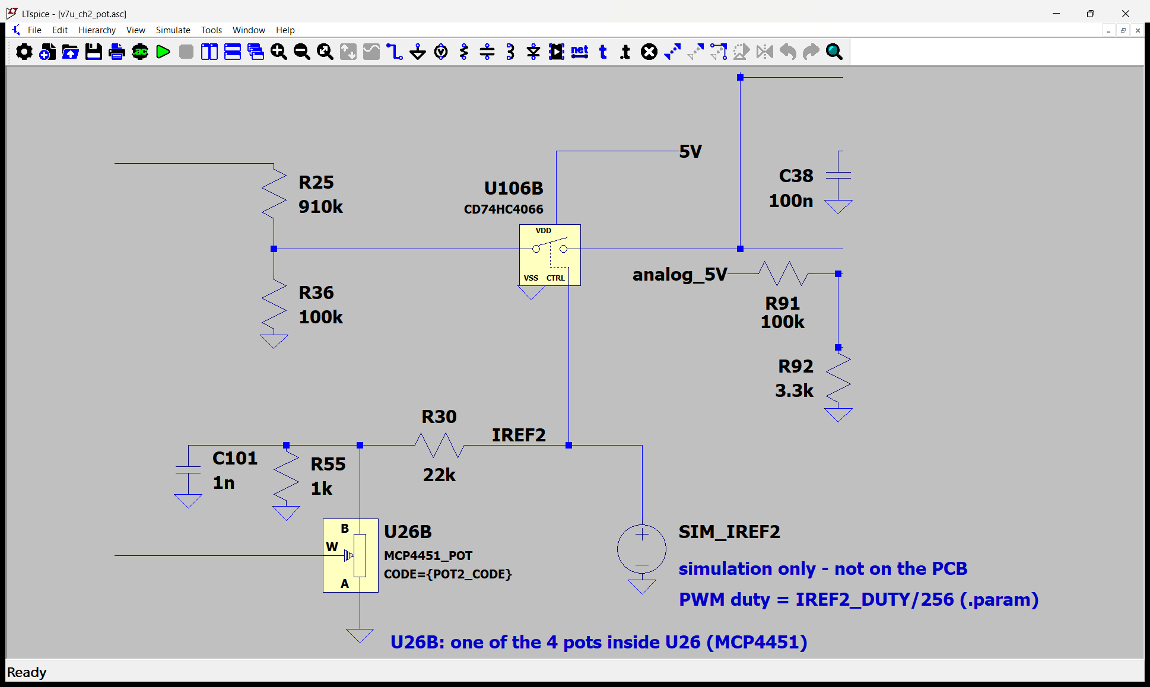
BOOST_split_boards/ltspice_layout_2026-10-05/work/captures_v6/v7u_ch2_pot.png
