ChristopherCa55/led-driver/BOOST_split_boards/mc7812_lowbatt_2026-10-01/brightness_vs_battery.png

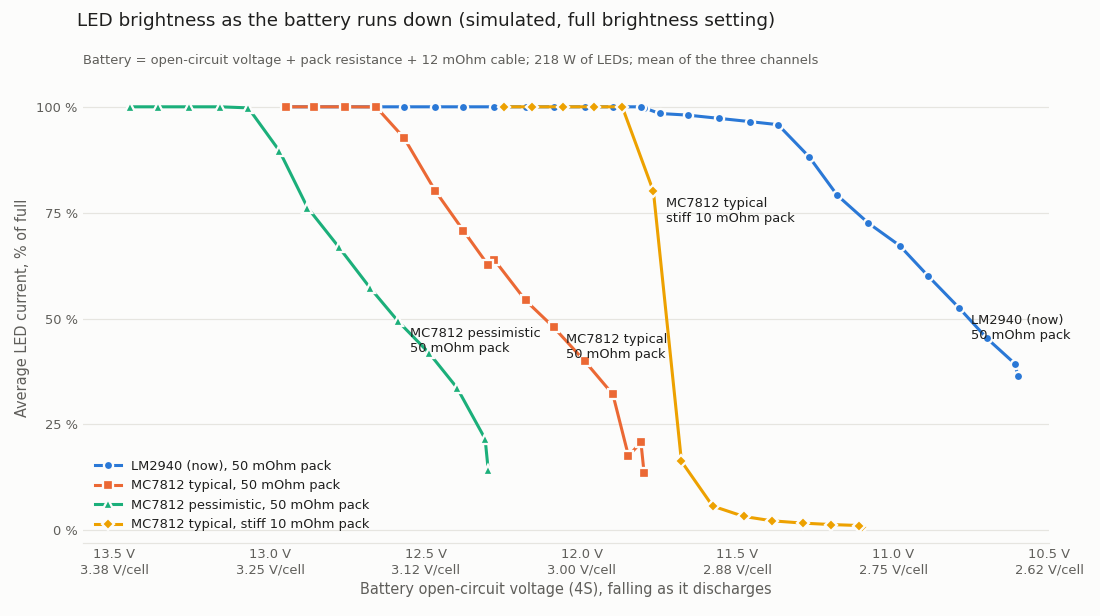
BOOST_split_boards/mc7812_lowbatt_2026-10-01/brightness_vs_battery.png
