ChristopherCa55/led-driver/BOOST_split_boards/reorg_2026-10-05/renders/k1/control_r0c1.png

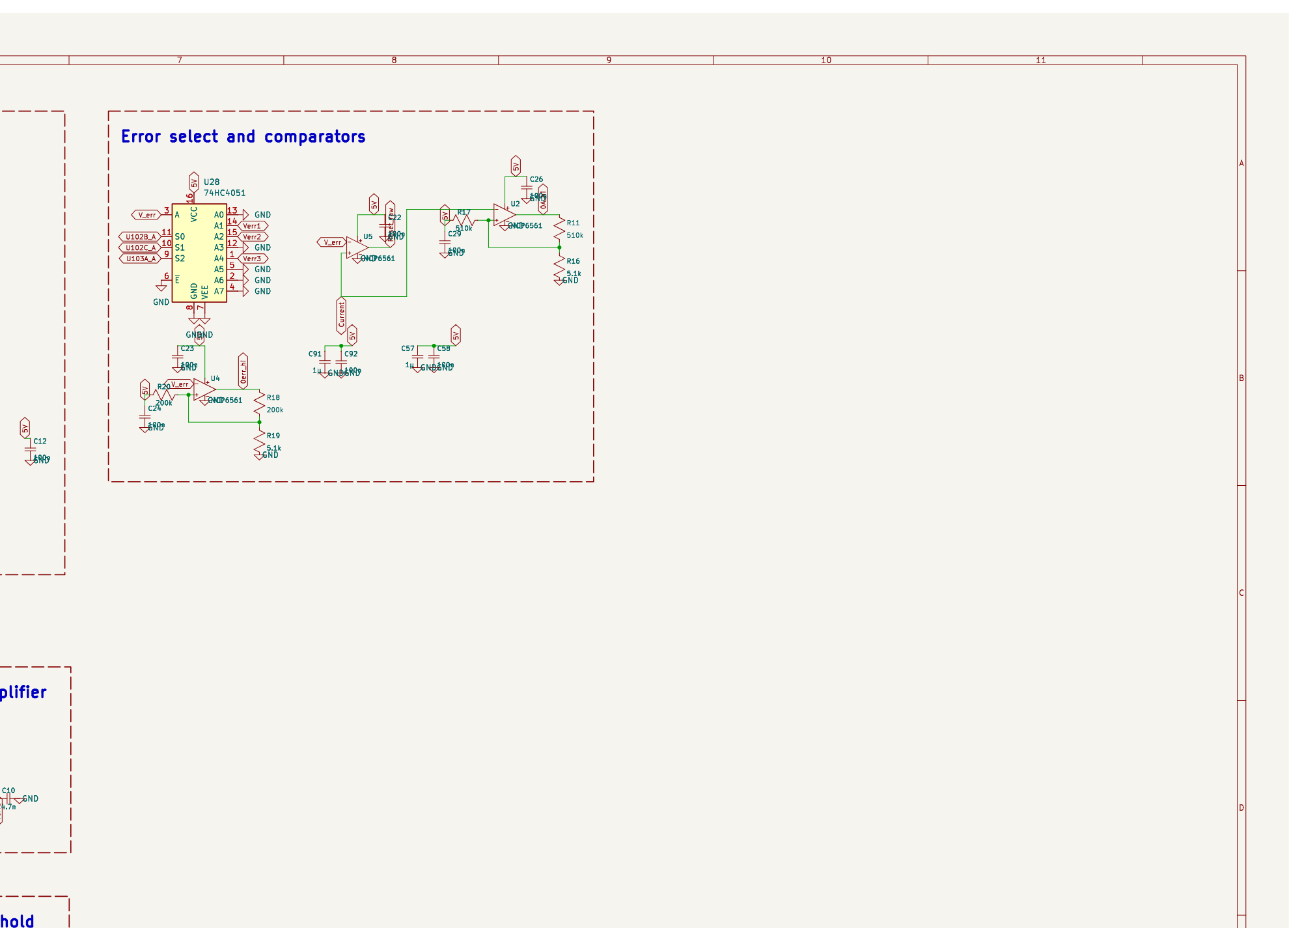
BOOST_split_boards/reorg_2026-10-05/renders/k1/control_r0c1.png
