ChristopherCa55/led-driver/BOOST_split_boards/reorg_2026-10-05/renders/lt1_r0c2.png

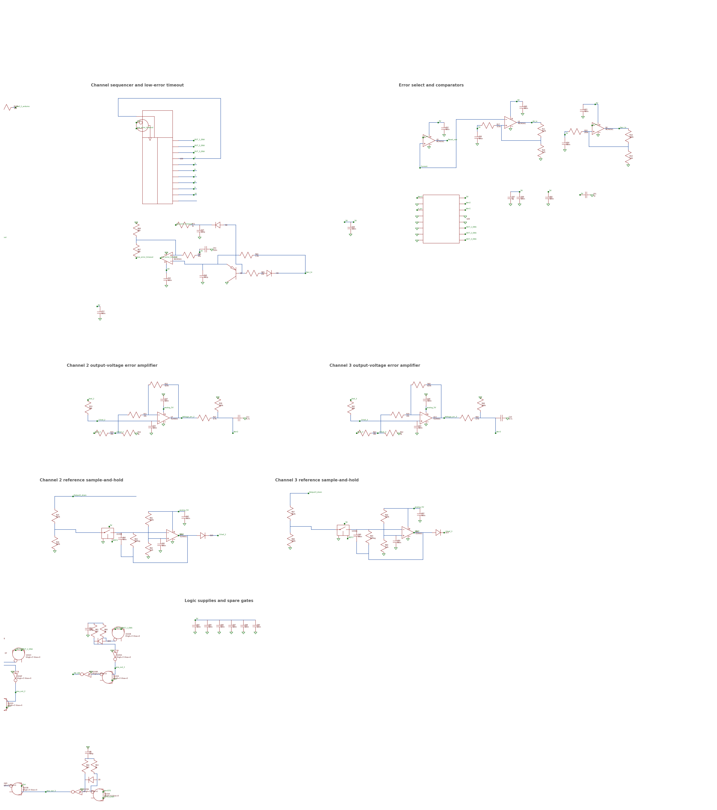
BOOST_split_boards/reorg_2026-10-05/renders/lt1_r0c2.png
