ChristopherCa55/led-driver/BOOST_split_boards/replace_2026-09-14/tools/placement/BOOST_power_p15_WIP_NOT_FOR_FAB.model.png

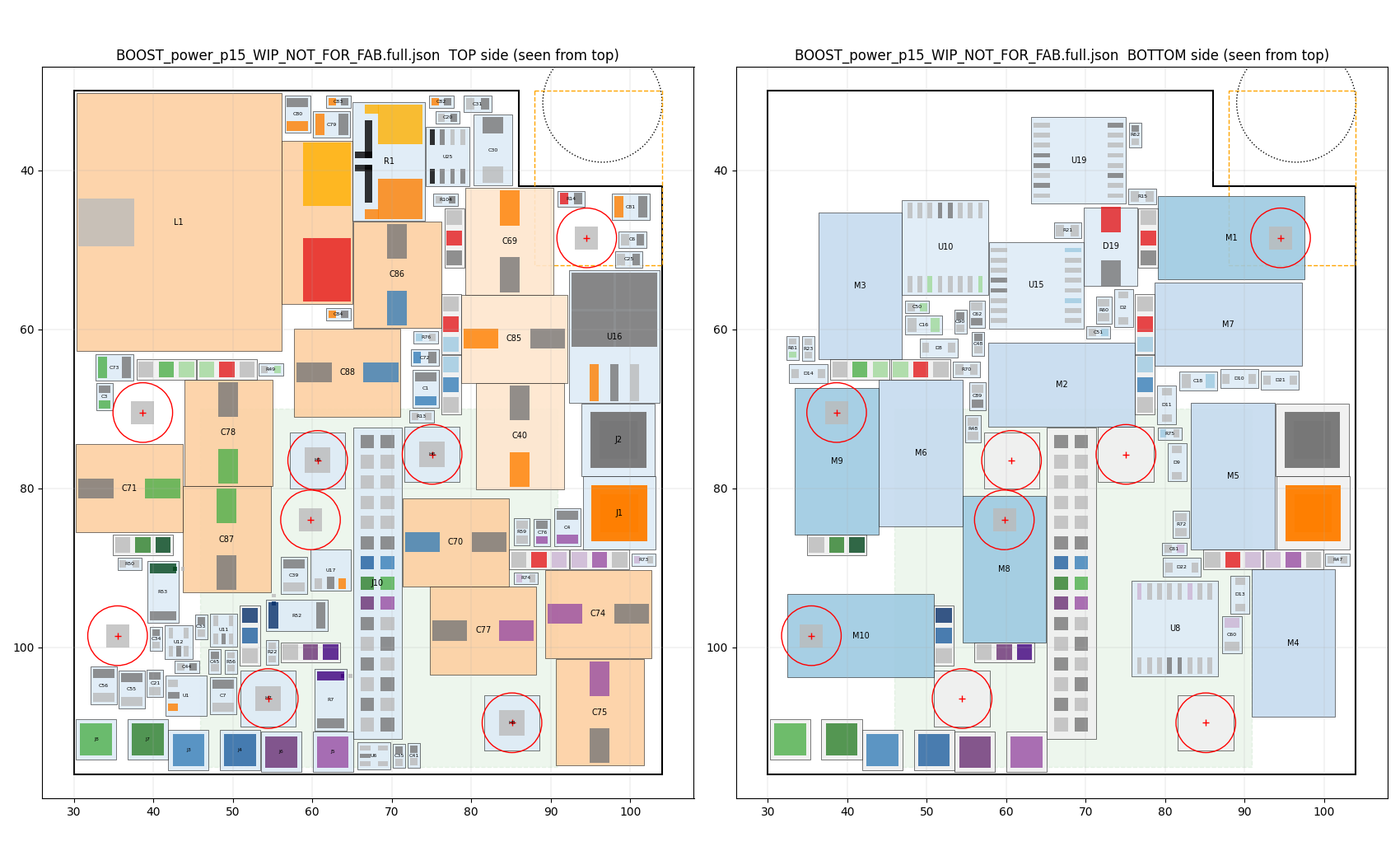
BOOST_split_boards/replace_2026-09-14/tools/placement/BOOST_power_p15_WIP_NOT_FOR_FAB.model.png
