ChristopherCa55/led-driver/BOOST_split_boards/replace_2026-09-14/tools/placement/p7T.png

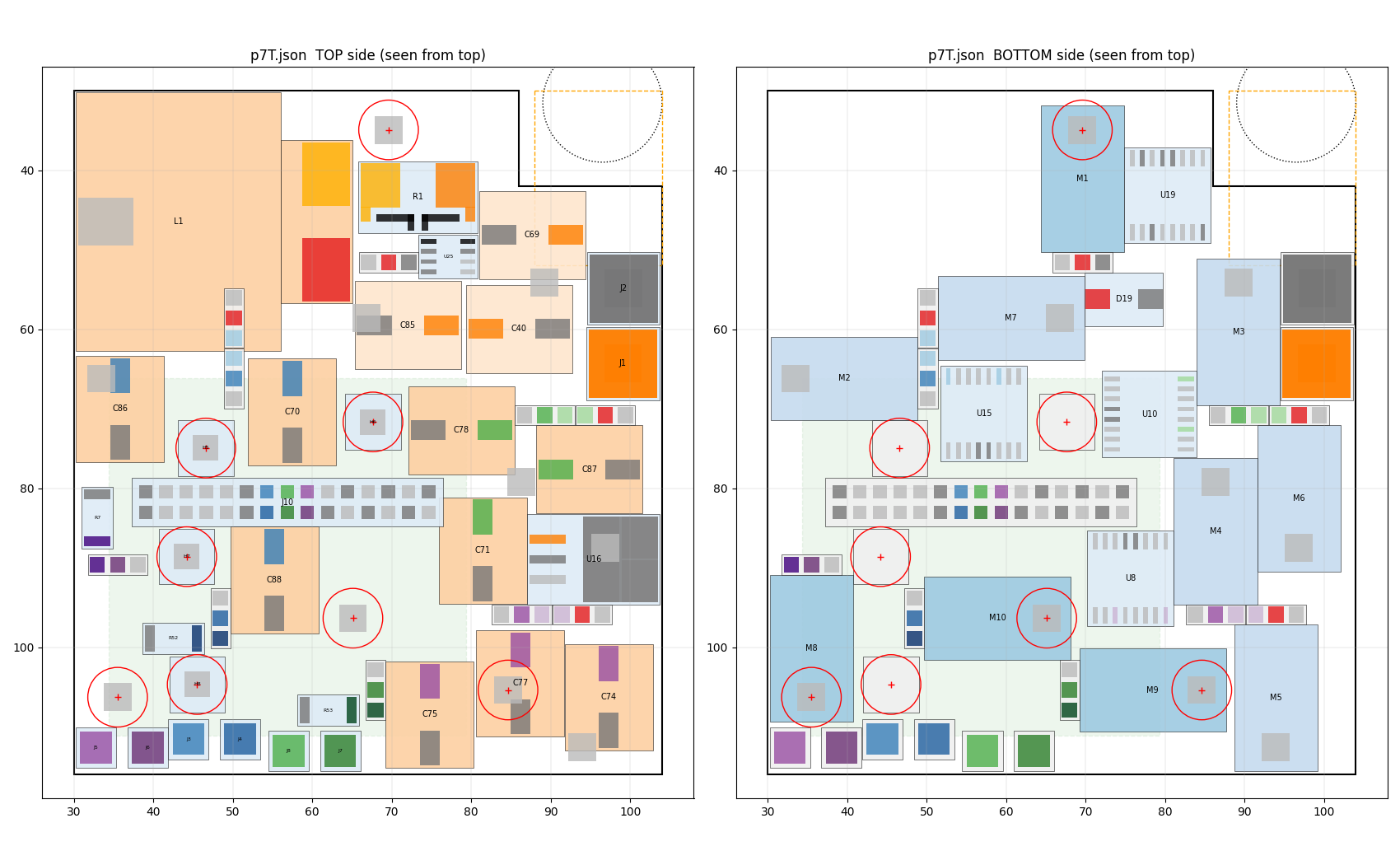
BOOST_split_boards/replace_2026-09-14/tools/placement/p7T.png
