ChristopherCa55/led-driver/BOOST_split_boards/replace_2026-09-14/tools/placement/p9/p9a_s8.png

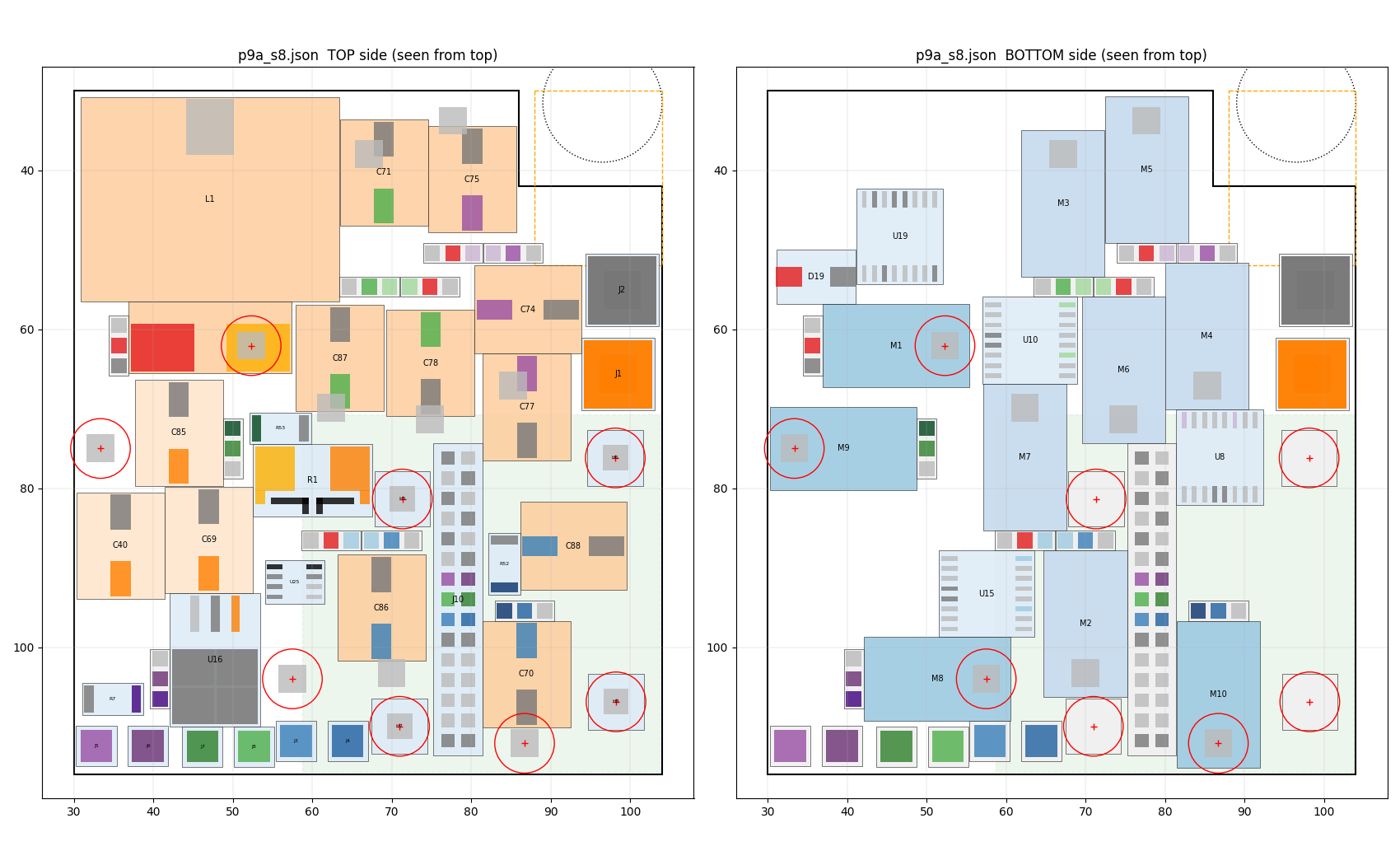
BOOST_split_boards/replace_2026-09-14/tools/placement/p9/p9a_s8.png
