ChristopherCa55/led-driver/BOOST_split_boards/replace_2026-09-14/tools/placement/p15/p15_b10_k1.png

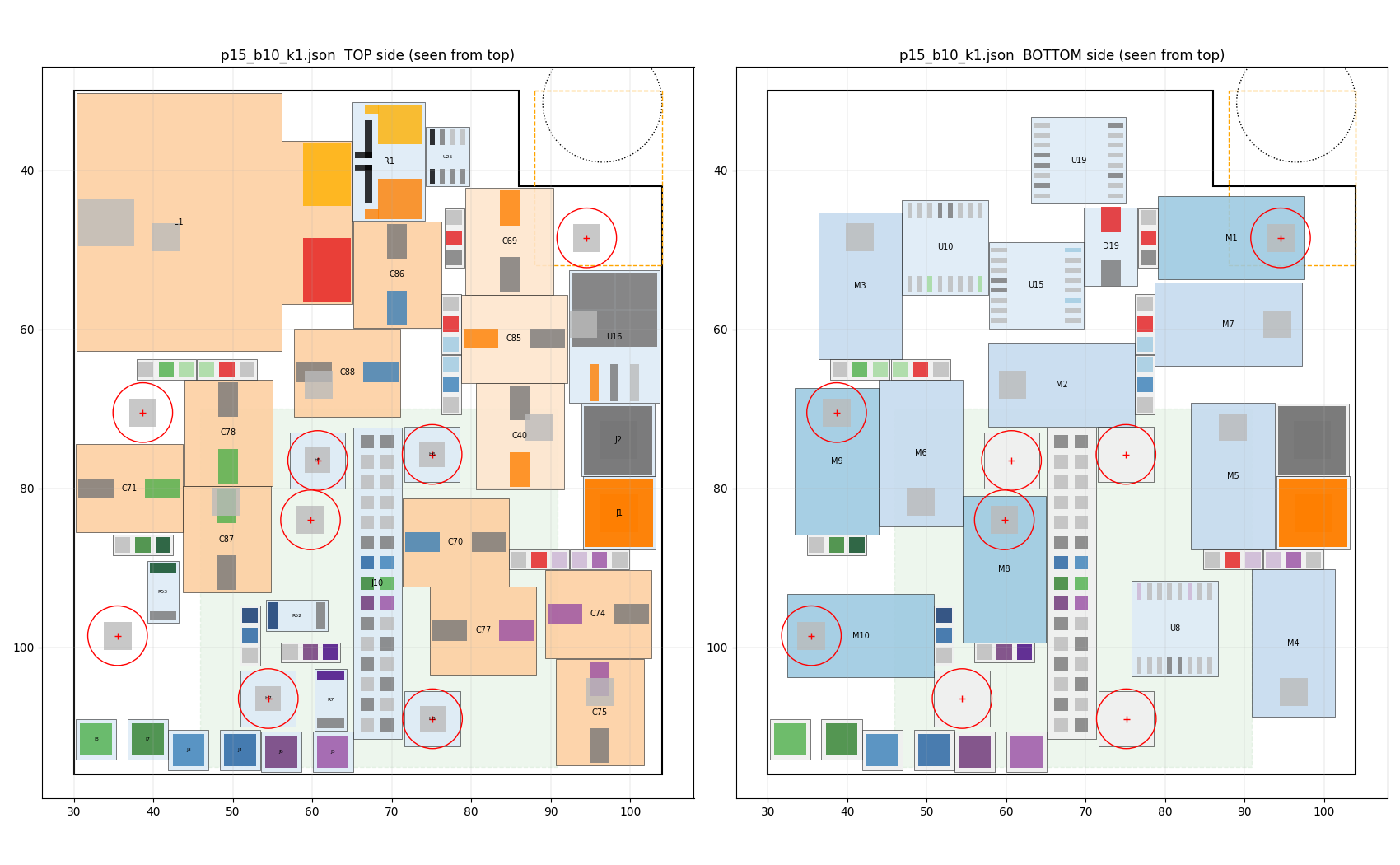
BOOST_split_boards/replace_2026-09-14/tools/placement/p15/p15_b10_k1.png
