ChristopherCa55/led-driver/BOOST_split_boards/review_2026-10-10/img_pcb/p13_In4_GND_pieces.png

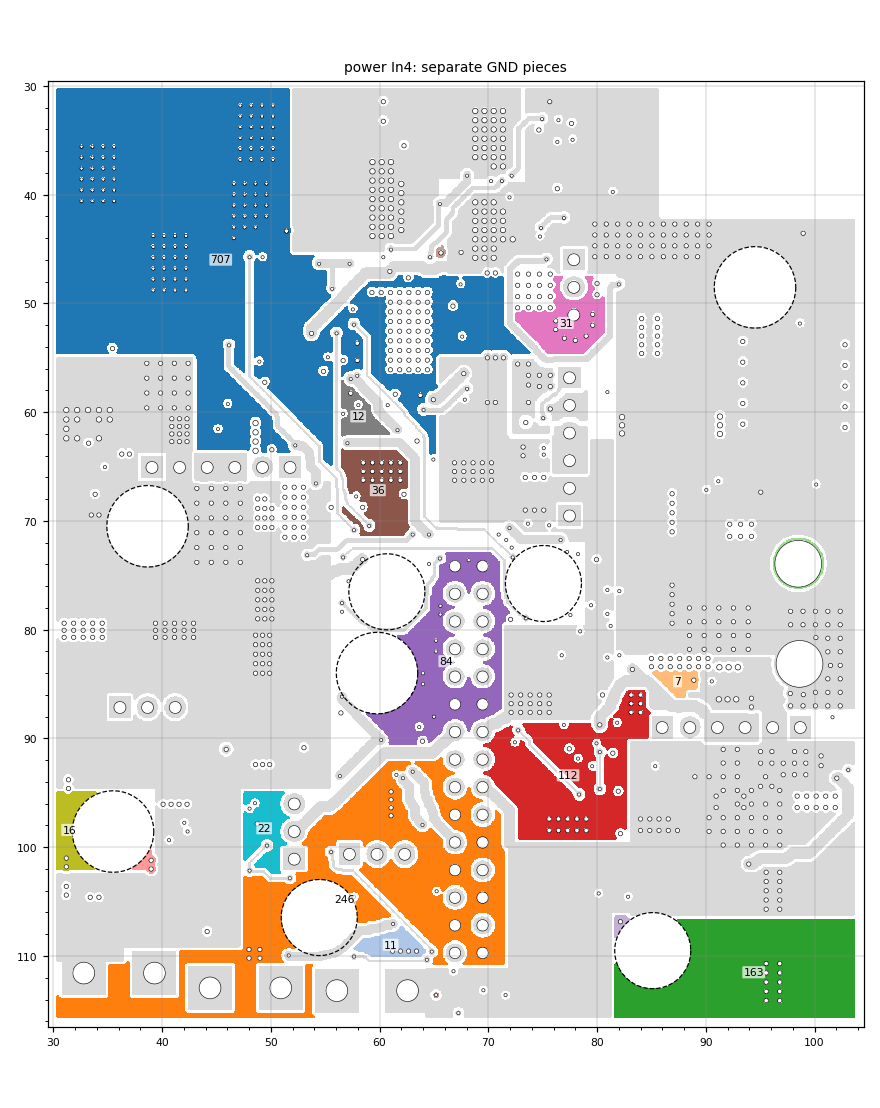
BOOST_split_boards/review_2026-10-10/img_pcb/p13_In4_GND_pieces.png
