ChristopherCa55/led-driver/BOOST_split_boards/review_2026-10-10/lt/overview.png

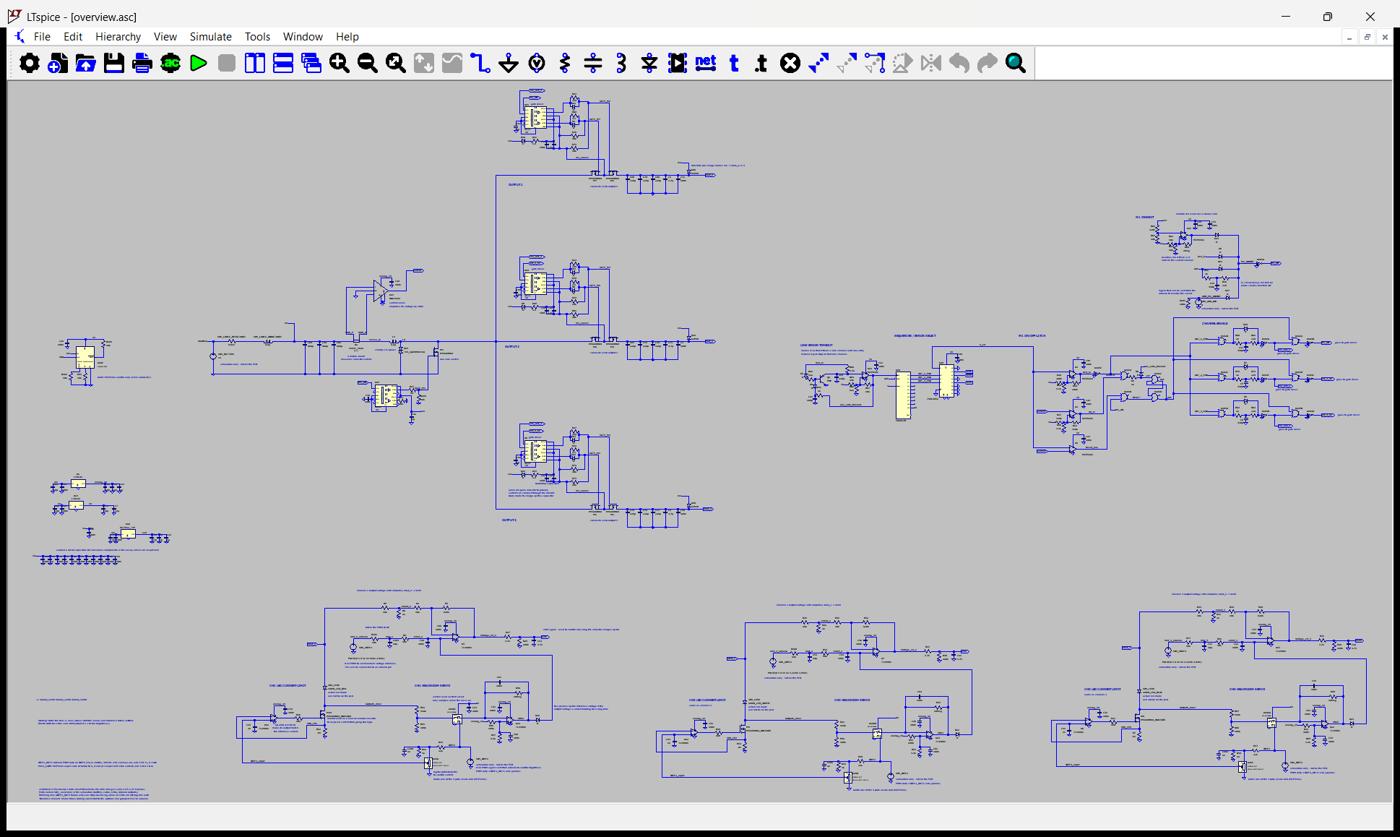
BOOST_split_boards/review_2026-10-10/lt/overview.png
