ChristopherCa55/led-driver/BOOST_split_boards/review_2026-10-10/pcb/img/power_In4Cu.png

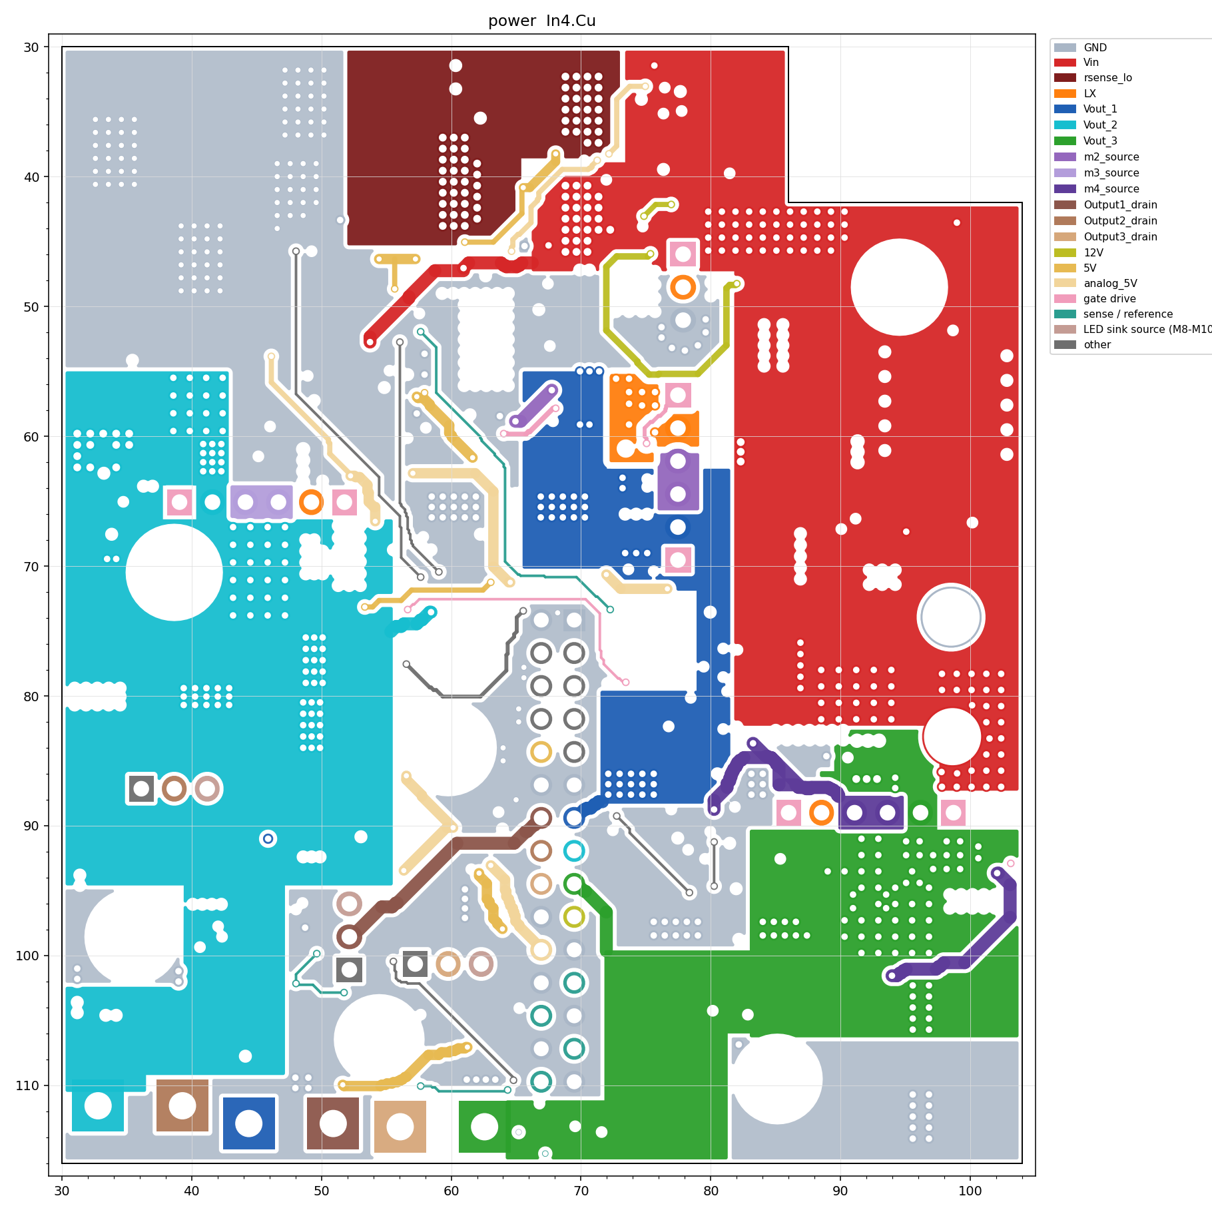
BOOST_split_boards/review_2026-10-10/pcb/img/power_In4Cu.png
