ChristopherCa55/led-driver/BOOST_split_boards/bom_2026-09-30/COST_SUMMARY.md

# BOOST: cost summary, scenario A (updated 2026-10-01)

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

## Grand total

| | Power board | Control card | Total |
|---|---|---|---|
| Bare PCBs (5 each) | $69.57 | $56.83 | $126.40 |
| JLC assembly of 2 each (fees + parts) | $204.79 | $162.46 | $367.25 |
| Parts bought elsewhere (J10, J11, PTC) | | | $24.91 |
| Hardware for 2 sets, without the thermal pad | | | $55.14 |
| **Subtotal without the pad** | | | **$573.70** |
| + McMaster 1272N32 pad (default) | | | **$600.61** |
| + Parker G579 0.060 in pad instead | | | $702.45 |
| + t-Global TG-AD30 1.5 mm instead | | | $573.70 + its price (not read) |
| Shipping, tax | | | not included |

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

## Ways to save

Savings are for this build: 5 bare boards of each, 2 of each assembled.

**Applied:**

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

**Still open (your choice):**

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

## Bare PCBs (JLCPCB quote page, 2026-10-01)

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

## Assembly (JLC Standard PCBA, 2 of each)

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

| Board | Unique parts | Set-up | Stencil | Loading | Joints | Parts | Attrition | **Assembly** | PCB | **Order** |
|---|---|---|---|---|---|---|---|---|---|---|
| Power | 29 | $51.12 | $16.42 | $44.37 | $0.91 (570) | $84.64 | $7.33 | **$204.79** | $69.57 | **$274.36** |
| Card | 41 | $51.12 | $16.42 | $62.73 | $1.51 (944) | $22.53 | $8.15 | **$162.46** | $56.83 | **$219.29** |

## Stock on 2026-10-01 (JLC parts library)

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

## Itemised JLC parts (everything JLC buys; excludes M1-M10 and L1)

### Power board

| Refs | LCSC | MPN | Per board | Unit | Qty for 2 (+attrition) | $ |
|---|---|---|---|---|---|---|
| C1 C4 C73 | C381466 | FS32X475K101EGG | 3 | $0.2328 | 6 (+0) | $1.40 |
| C3 C72 C76 | C28233 | CL21B104KCFNNNE | 3 | $0.0357 | 6 (+20) | $0.93 |
| C6 C21 C25 C31 C62 C89 | C28323 | CL21B105KBFNNNE | 6 | $0.0399 | 12 (+20) | $1.28 |
| C7 C55 | C21397 | GRM32ER71E226KE15L | 2 | $0.4585 | 4 (+0) | $1.83 |
| C16 C18 C60 | C50254 | CL31B225KBHNNNE | 3 | $0.0857 | 6 (+20) | $2.23 |
| C20 C33 C34 C35 C48 C50 C51 C61 C82 C83 C84 C90 | C14663 | CC0603KRX7R9BB104 | 12 | $0.0123 | 24 (+20) | $0.54 |
| C30 | C4979367 | TR3D476K025C0250 | 1 | $1.0990 | 2 (+0) | $2.20 |
| C39 C56 C79 C80 C81 | C138687 | CL32B106KBJNNNE | 5 | $0.3252 | 10 (+0) | $3.25 |
| C40 C69 C85 | C29664285 | EEH-ZU1E681UP | 3 | $2.5409 | 6 (+0) | $15.25 |
| C41 C44 C45 | C1588 | CL10B102KB8NNNC | 3 | $0.0089 | 6 (+20) | $0.23 |
| C74 C86 C87 | C6843593 | EEH-ZU1H221P | 3 | $2.8352 | 6 (+0) | $17.01 |
| C70 C71 C75 C77 C78 C88 | C385885 | EEHZS1H221P | 6 | $1.6338 | 12 (+0) | $19.61 |
| D2 D8 D11 D13 D14 D22 | C8598 | B5819W SL | 6 | $0.0280 | 12 (+20) | $0.90 |
| D9 D10 D21 | C21565 | BAV21W | 3 | $0.0191 | 6 (+20) | $0.50 |
| D28 D29 D30 | C128729 | S2MW | 3 | $0.0183 | 6 (+20) | $0.48 |
| D19 | C42394451 | 5.0SMDJ54A | 1 | $0.3951 | 2 (+0) | $0.79 |
| R1 | C2076400 | CSS4J-4026R-1L00F | 1 | $1.7086 | 2 (+0) | $3.42 |
| R7 R52 R53 | C413486 | WSL2512R0500FEA | 3 | $0.2348 | 6 (+0) | $1.41 |
| R13 R23 R47 | C22962 | 0603WAF2200T5E | 3 | $0.0035 | 6 (+20) | $0.09 |
| R14 | C17514 | 0805W8F1004T5E | 1 | $0.0043 | 2 (+20) | $0.09 |
| R15 | C17415 | 0805W8F100JT5E | 1 | $0.0040 | 2 (+20) | $0.09 |
| R21 R48 R60 R72 | C17724 | 0805W8F510KT5E | 4 | $0.0041 | 8 (+20) | $0.11 |
| R22 R50 R56 | C22775 | 0603WAF1000T5E | 3 | $0.0031 | 6 (+20) | $0.08 |
| R49 R61 R62 R73 R74 R75 R76 R104 | C25804 | 0603WAF1002T5E | 8 | $0.0018 | 16 (+20) | $0.06 |
| R59 R70 | C17724 | 0805W8F510KT5E | 2 | $0.0041 | 4 (+0) | $0.02 |
| U1 U17 | C43116 | L78L05ACUTR | 2 | $0.1020 | 4 (+0) | $0.41 |
| U6 U11 U12 | C398363 | TLV9001IDBVR | 3 | $0.0979 | 6 (+20) | $2.55 |
| U8 U10 U15 U19 | C601651 | UCC21520DWR | 4 | $0.8893 | 8 (+0) | $7.11 |
| U16 | C231294 | MC7812BD2TR4G | 1 | $0.5316 | 2 (+0) | $1.06 |
| U25 | C22427873 | INA241A4IDR | 1 | $3.5277 | 2 (+0) | $7.06 |
| **Total** | | | | | | **$91.97** |

### Control card

| Refs | LCSC | MPN | Per board | Unit | Qty for 2 (+attrition) | $ |
|---|---|---|---|---|---|---|
| C8 C9 C17 C19 | C1664 | CL10C331JB8NNNC | 4 | $0.0179 | 8 (+20) | $0.50 |
| C10 C11 C13 | C85980 | GRM1885C1H472JA01D | 3 | $0.0212 | 6 (+20) | $0.55 |
| C12 C22 C23 C24 C26 C28 C29 C32 C36 C37 C38 C42 C43 C46 C52 C53 C54 C58 C59 C63 C65 C66 C68 C92 C94 C95 C96 C97 C98 C99 C104 | C14663 | CC0603KRX7R9BB104 | 31 | $0.0123 | 62 (+20) | $1.01 |
| C14 | C27675 | CL10C221JB8NNNC | 1 | $0.0095 | 2 (+20) | $0.21 |
| C15 | C14858 | CL10C101JB8NNNC | 1 | $0.0086 | 2 (+20) | $0.19 |
| C47 C93 C103 | C96446 | CL10A106MA8NRNC | 3 | $0.0752 | 6 (+20) | $1.96 |
| C49 C64 C67 | C97946 | GRM31C5C1H104JA01L | 3 | $0.1849 | 6 (+0) | $1.11 |
| C57 C91 | C28323 | CL21B105KBFNNNE | 2 | $0.0399 | 4 (+20) | $0.96 |
| C100 C101 C102 | C1588 | CL10B102KB8NNNC | 3 | $0.0089 | 6 (+20) | $0.23 |
| D1 D3 D4 D5 D6 D7 D15 D20 D24 D27 | C81598 | 1N4148W | 10 | $0.0123 | 20 (+20) | $0.49 |
| D23 D25 D26 | C22629 | BAT54WS L9 | 3 | $0.0238 | 6 (+20) | $0.62 |
| Q1 | C53444 | MMBT3906LT1G | 1 | $0.0189 | 2 (+20) | $0.42 |
| R2 R6 R31 R33 R39 R41 R67 R77 R83 R85 R99 R100 R101 R102 R103 | C25804 | 0603WAF1002T5E | 15 | $0.0018 | 30 (+20) | $0.09 |
| R3 R32 R40 | C23219 | 0603WAF6203T5E | 3 | $0.0020 | 6 (+20) | $0.05 |
| R4 R54 R55 R58 R71 | C21190 | 0603WAF1001T5E | 5 | $0.0026 | 10 (+20) | $0.08 |
| R8 R34 R42 R51 R63 R78 R80 | C22975 | 0603WAF2001T5E | 7 | $0.0024 | 14 (+20) | $0.08 |
| R9 R35 R43 | C17506 | 0805W8F1802T5E | 3 | $0.0043 | 6 (+20) | $0.11 |
| R11 R17 | C23192 | 0603WAF5103T5E | 2 | $0.0024 | 4 (+20) | $0.06 |
| R16 R19 | C23186 | 0603WAF5101T5E | 2 | $0.0015 | 4 (+20) | $0.04 |
| R18 R20 | C25811 | 0603WAF2003T5E | 2 | $0.0023 | 4 (+20) | $0.06 |
| R25 R87 R94 | C17864 | 0805W8F9103T5E | 3 | $0.0034 | 6 (+20) | $0.09 |
| R26 R64 R79 R81 | C22962 | 0603WAF2200T5E | 4 | $0.0035 | 8 (+20) | $0.10 |
| R27 R37 R45 | C23162 | 0603WAF4701T5E | 3 | $0.0028 | 6 (+20) | $0.07 |
| R28 R36 R38 R44 R46 R88 R91 R95 R96 R105 | C25803 | 0603WAF1003T5E | 10 | $0.0031 | 20 (+20) | $0.12 |
| R29 R30 R57 | C17560 | 0805W8F2202T5E | 3 | $0.0048 | 6 (+20) | $0.12 |
| R65 | C31850 | 0603WAF2202T5E | 1 | $0.0041 | 2 (+20) | $0.09 |
| R66 R89 R92 R97 | C22978 | 0603WAF3301T5E | 4 | $0.0026 | 8 (+20) | $0.07 |
| R68 | C23221 | 0603WAF6202T5E | 1 | $0.0028 | 2 (+20) | $0.06 |
| R69 | C4184 | 0603WAF2002T5E | 1 | $0.0023 | 2 (+20) | $0.05 |
| R82 | C23206 | 0603WAF5602T5E | 1 | $0.0027 | 2 (+20) | $0.06 |
| R84 | C25808 | 0603WAF1203T5E | 1 | $0.0015 | 2 (+20) | $0.03 |
| R86 | C17514 | 0805W8F1004T5E | 1 | $0.0043 | 2 (+20) | $0.09 |
| R90 R93 R98 | C7250 | 0603WAF1005T5E | 3 | $0.0037 | 6 (+20) | $0.10 |
| U2 U4 U5 U14 U21 | C117501 | MCP6561T-E/OT | 5 | $0.7430 | 10 (+0) | $7.43 |
| U3 U7 U13 U22 U23 U24 | C398363 | TLV9001IDBVR | 6 | $0.0979 | 12 (+20) | $3.13 |
| U18 | C11349 | CD4017BM96 | 1 | $0.7267 | 2 (+0) | $1.45 |
| U26 | C145613 | MCP4451-103E/ST | 1 | $2.9051 | 2 (+0) | $5.81 |
| U28 | C9386 | 74HC4051D,653 | 1 | $0.2146 | 2 (+0) | $0.43 |
| U101 U102 U103 | C5586 | 74HC00D,653 | 3 | $0.1546 | 6 (+0) | $0.93 |
| U104 U105 | C5605 | 74HC14D,653 | 2 | $0.1023 | 4 (+0) | $0.41 |
| U106 | C179842 | CD74HC4066M96 | 1 | $0.6097 | 2 (+0) | $1.22 |
| **Total** | | | | | | **$30.68** |

## Parts bought elsewhere

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

## Hardware for 2 sets

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

## Thermal pad: the ones you can buy

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

## Your buck converter

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

## URLs for you to read

One line is left:

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

## Still flagged

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
