ChristopherCa55/led-driver/BOOST_split_boards/bom_2026-09-30/bom/SOURCING_TABLE.md

# BOM and JLCPCB sourcing, 2026-10-01

Stock and prices read from the JLCPCB parts library on 2026-10-01 (snapshot: `jlc_snapshot_2026-10-01.json`). "Max sets" is how many power board + control card pairs the stock covers at the quantities used on both boards. Unit prices are JLC's quantity-1 prices; JLC also buys a few spares of each small part (attrition), not included here.

## JLC fits (bought and fitted by JLCPCB)

| Board | Refs | Qty | Description | Footprint | Side | LCSC | MPN (maker) | Basic/Ext | Stock | $/unit | Max sets | Orderable | Why / notes |
|---|---|---|---|---|---|---|---|---|---|---|---|---|---|
| power | C1 C4 C73 | 3 | ceramic capacitor 4.7uF 100 V X7R (1210) | 1210 | top | C381466 | FS32X475K101EGG (PSA(Prosperity Dielectrics)) | Extended | 172923 | 0.2328 | 57641 | yes | on Vout (23-33 V running; TVS stand-off 54 V, clamp 87 V): 100 V rated; commutation-loop ceramic per rail; 50 V part C170099 is cheaper but keeps less capacitance at 33 V Alternates: C170099 (50 V) |
| power | C3 C72 C76 | 3 | ceramic capacitor 100nF 100 V X7R (0805) | 0805 | top | C28233 | CL21B104KCFNNNE (Samsung Electro-Mechanics) | Basic | 1258622 | 0.0357 | 419540 | yes | on Vout (23-33 V running; TVS stand-off 54 V, clamp 87 V): 100 V rated |
| power | C6 C21 C25 C31 C62 C89 | 6 | ceramic capacitor 1uF 50 V X7R (0805) | 0805 | bottom/top | C28323 | CL21B105KBFNNNE (Samsung Electro-Mechanics) | Basic | 2288251 | 0.0399 | 286031 | yes | value and package from the schematic; X7R, voltage rating at least 2x the net (rails 5/12 V, Vin 14-17 V) |
| power | C7 C55 | 2 | ceramic capacitor 22uF 25 V X7R (1210) | 1210 | top | C21397 | GRM32ER71E226KE15L (Murata Electronics) | Extended | 75388 | 0.4585 | 37694 | yes | part chosen earlier (HANDOFF_SUMMARY / replace_notes / ANSWERS) |
| power | C16 C18 C60 | 3 | ceramic capacitor 2.2uF 50 V X7R (1206) | 1206 | bottom | C50254 | CL31B225KBHNNNE (Samsung Electro-Mechanics) | Basic | 389063 | 0.0857 | 129687 | yes | value and package from the schematic; X7R, voltage rating at least 2x the net (rails 5/12 V, Vin 14-17 V); bootstrap caps, 12 V across |
| power | C20 C33 C34 C35 C48 C50 C51 C61 C82 C83 C84 C90 | 12 | ceramic capacitor 100nF 50 V X7R (0603) | 0603 | bottom/top | C14663 | CC0603KRX7R9BB104 (YAGEO) | Basic | 54422762 | 0.0123 | 1265645 | yes | value and package from the schematic; X7R, voltage rating at least 2x the net (rails 5/12 V, Vin 14-17 V); C82-C84 on Vin (<= 17 V), 50 V part |
| power | C30 | 1 | 47 uF 25 V tantalum capacitor (low ESR, case D) | EIA-7343 (D) | top | C4979367 | TR3D476K025C0250 (Vishay Intertech) | Extended | 63 | 1.099 | 63 | yes | part chosen earlier (HANDOFF_SUMMARY / replace_notes / ANSWERS); U16 (12 V regulator) output, ESR 250 mOhm |
| power | C39 C56 C79 C80 C81 | 5 | ceramic capacitor 10uF 50 V X7R (1210) | 1210 | top | C138687 | CL32B106KBJNNNE (Samsung Electro-Mechanics) | Extended | 32750 | 0.3252 | 6550 | yes | value and package from the schematic; X7R, voltage rating at least 2x the net (rails 5/12 V, Vin 14-17 V); C79-C81 on Vin: 50 V X7R |
| power | C40 C69 C85 | 3 | 680 uF 25 V hybrid polymer electrolytic capacitor | CP_Elec_10x12.5 | top | C29664285 | EEH-ZU1E681UP (PANASONIC) | Extended | 10 | 2.5409 | 3 | LIMITS BUILD | part chosen earlier (HANDOFF_SUMMARY / replace_notes / ANSWERS); STOCK 10: enough for 3 boards (3 each) |
| power | C41 C44 C45 | 3 | ceramic capacitor 1nF 50 V X7R (0603) | 0603 | top | C1588 | CL10B102KB8NNNC (Samsung Electro-Mechanics) | Basic | 7811866 | 0.0089 | 1301977 | yes | value and package from the schematic; X7R, voltage rating at least 2x the net (rails 5/12 V, Vin 14-17 V); IREF wiper filter Alternates: C163508 (C0G) |
| power | C74 C86 C87 | 3 | 220 uF 50 V hybrid polymer electrolytic capacitor (Panasonic ZU) | CP_Elec_10x16.5 | top | C6843593 | EEH-ZU1H221P (PANASONIC) | Extended | 14 | 2.8352 | 4 | LIMITS BUILD | part chosen earlier (HANDOFF_SUMMARY / replace_notes / ANSWERS); the three most loaded output caps (BOOST_AUDIT section 6: up to 3.46 A); since 2026-10-01 the other six are EEH-ZS1H221P |
| power | C70 C71 C75 C77 C78 C88 | 6 | 220 uF 50 V hybrid polymer electrolytic capacitor (Panasonic ZS) | CP_Elec_10x16.5 | top | C385885 | EEHZS1H221P (PANASONIC) | Extended | 1263 | 1.6338 | 210 | yes | approved 2026-10-01: same Panasonic hybrid family, size and footprint; 13 mOhm, 3.7 A (ZU: 10 mOhm, 5.2 A). These positions carry 1.90-2.37 A, 51-64 % of the ZS rating; cheaper, and the ZU had too little stock Alternates: C6843593 EEH-ZU1H221P |
| power | D2 D8 D11 D13 D14 D22 | 6 | Schottky diode 40 V 1 A | SOD-123 | bottom | C8598 | B5819W SL (Jiangsu Changjing Electronics Technology Co., Ltd.) | Basic | 512334 | 0.028 | 85389 | yes | your choice of 2026-09-24; no diode type in the schematic (LTspice default diode). Anode on the FET gate, cathode to the driver side of the gate resistor: the turn-off path. Proposal B5819W (40 V 1 A Schottky, Basic) Alternates: C81598 1N4148W |
| power | D9 D10 D21 | 3 | switching diode 200 V 0.2 A | SOD-123 | bottom | C21565 | BAV21W (Jiangsu Changjing Electronics Technology Co., Ltd.) | Extended | 87375 | 0.0191 | 29125 | yes | your choice of 2026-09-24; no diode type in the schematic. 12 V to the high-side VDDA: blocks the rail FET source voltage (up to Vout, 54-87 V under a clamp event). Proposal BAV21W (200 V, trr 50 ns) Alternates: C81598 1N4148W (75 V: too low) |
| power | D28 D29 D30 | 3 | rectifier diode 1000 V 2 A | SOD-123F | bottom | C128729 | S2MW (Shandong Jingdao Microelectronics) | Extended | 14395 | 0.0183 | 4798 | yes | pre-charge diodes Vin -> Vout_1/2/3 (chosen 2026-09-29): 1000 V 2 A, IFSM 50 A; surge headroom 2.5x at an ideal battery (precharge_surge_2026-09-30), kept 2026-09-30 Alternates: C2900725 Foshan Blue Rocket S2MW |
| power | D19 | 1 | TVS diode 54 V stand-off, 5 kW | D_SMC | bottom | C42394451 | 5.0SMDJ54A (hongjiacheng) | Extended | 9825 | 0.3951 | 9825 | yes | part chosen earlier (HANDOFF_SUMMARY / replace_notes / ANSWERS); Littelfuse has 1 in stock; R+O alternate (as decided 2026-09-15). Its listing gives the ratings but links no datasheet Alternates: C20415356 Littelfuse (stock 1); C5279851 SETsafe (published specs) |
| power | R1 | 1 | current-sense resistor 1 mOhm 4 W, 4-terminal | 4026 4-terminal | top | C2076400 | CSS4J-4026R-1L00F (BOURNS) | Extended | 385 | 1.7086 | 385 | yes | your choice of 2026-09-24; rev6: 1 mOhm with U25 = INA241A4 (100 V/V): Current stays 0.1 V/A. Same Bourns land pattern (series drawing), H 2.70 max against 2.93 Alternates: C2076167 CSS4J-4026K-2L00F 2 mOhm (0 stock) |
| power | R7 R52 R53 | 3 | current-sense resistor 50 mOhm 1 W, metal strip | 2512 | top | C413486 | WSL2512R0500FEA (Vishay Intertech) | Extended | 41066 | 0.2348 | 13688 | yes | your choice of 2026-09-24; LED current sinks: 2.63 A, 0.35 W each. The value sets the LED current, so the TCR matters: WSL2512 metal strip +/-75 ppm/C ($0.23) against thick film +/-800 ppm/C ($0.04) Alternates: C127698 thick film +/-800 ppm/C |
| power | R13 R23 R47 | 3 | resistor 220 ohm 1 % (0603) | 0603 | bottom/top | C22962 | 0603WAF2200T5E (UNI-ROYAL(Uniroyal Elec)) | Basic | 1903983 | 0.0035 | 271997 | yes | value and package from the schematic; 1% thick film, JLC Basic where one exists |
| power | R15 | 1 | resistor 10 ohm 1 % (0805) | 0805 | bottom | C17415 | 0805W8F100JT5E (UNI-ROYAL(Uniroyal Elec)) | Basic | 6880485 | 0.004 | 6880485 | yes | value and package from the schematic; 1% thick film, JLC Basic where one exists |
| power | R21 R48 R60 R72 | 4 | resistor 5.1 ohm 1 % (0805) | 0805 | bottom | C17724 | 0805W8F510KT5E (UNI-ROYAL(Uniroyal Elec)) | Basic | 418343 | 0.0041 | 69723 | yes | your choice of 2026-09-24; rev6: 5 -> 5.1 Ohm (5.0 Ohm 0805 is not stocked), the value R59/R70 already use Alternates: C25273 4.99 Ohm |
| power | R22 R50 R56 | 3 | resistor 100 ohm 1 % (0603) | 0603 | top | C22775 | 0603WAF1000T5E (UNI-ROYAL(Uniroyal Elec)) | Basic | 11576722 | 0.0031 | 3858907 | yes | value and package from the schematic; 1% thick film, JLC Basic where one exists |
| power | R49 R61 R62 R73 R74 R75 R76 R104 | 8 | resistor 10k ohm 1 % (0603) | 0603 | bottom/top | C25804 | 0603WAF1002T5E (UNI-ROYAL(Uniroyal Elec)) | Basic | 23109251 | 0.0018 | 1004750 | yes | value and package from the schematic; 1% thick film, JLC Basic where one exists |
| power | R59 R70 | 2 | resistor 5.1 ohm 1 % (0805) | 0805 | bottom/top | C17724 | 0805W8F510KT5E (UNI-ROYAL(Uniroyal Elec)) | Basic | 418343 | 0.0041 | 69723 | yes | value and package from the schematic; 1% thick film, JLC Basic where one exists |
| power | U1 U17 | 2 | linear regulator 5 V 100 mA | SOT-89 | top | C43116 | L78L05ACUTR (STMicroelectronics) | Extended | 21384 | 0.102 | 10692 | yes | the device named in the schematic or the notes; ST L78L05ACUTR (pinout OUT-GND-IN as the symbol) |
| power | U6 U11 U12 | 3 | op-amp, rail-to-rail, 1 MHz | SOT-23-5 | top | C398363 | TLV9001IDBVR (Texas Instruments) | Extended | 48438 | 0.0979 | 5382 | yes | approved 2026-10-01: TI TLV9001IDBVR (the DBV part: pins 1 OUT, 2 V-, 3 IN+, 4 IN-, 5 V+, as the MCP6241; NOT the TLV9001U). 1 MHz, 2 V/us, 1.6 mV max offset. LTspice re-runs (30 ms, 25 % PWM, cold start) match the MCP6241 within 0.05 % Alternates: C49889 MCP6241T-E/OT (before 2026-10-01) |
| power | U8 U10 U15 U19 | 4 | isolated dual gate driver | SOIC-16W | bottom | C601651 | UCC21520DWR (Texas Instruments) | Extended | 17156 | 0.8893 | 4289 | yes | the device named in the schematic or the notes |
| power | U16 | 1 | linear regulator 12 V 1 A (7812) | TO-263-3 | top | C231294 | MC7812BD2TR4G (onsemi) | Extended | 2024 | 0.5316 | 2024 | yes | approved 2026-10-01: onsemi MC7812BD2TR4G. Its D2PAK (case 936) fits the TO-263-3 footprint: pins 1 IN and 3 OUT at 2.54 mm pitch, tab = pin 2 GND, the centre lead is cut (pad 2 stays empty, it is GND). 35 V in, -40 to +125 C. About 1.5 V dropout, so at the end of a 4S discharge the LEDs fade from about 12.7 V open-circuit (simulated: BOOST_split_boards/mc7812_lowbatt_2026-10-01) Alternates: C38744 MC7812CD2TR4G (0 to +125 C); C2877347 LM2940S-12/NOPB (before 2026-10-01) |
| power | U25 | 1 | current-sense amplifier, gain 100 | SOIC-8 | top | C22427873 | INA241A4IDR (Texas Instruments) | Extended | 116 | 3.5277 | 116 | yes | your choice of 2026-09-24; rev6: gain 100 V/V with the 1 mOhm R1; TI SBOSA30D: same SOIC-8 pinout for every gain, 1.1 MHz for all gains Alternates: C22427652 INA241A3IDR (rev5) |
| card | C8 C9 C17 C19 | 4 | ceramic capacitor 330pF 50 V C0G (0603) | 0603 | bottom/top | C1664 | CL10C331JB8NNNC (Samsung Electro-Mechanics) | Basic | 915282 | 0.0179 | 228820 | yes | timing / compensation / sample-and-hold: C0G |
| card | C10 C11 C13 | 3 | ceramic capacitor 4.7nF 50 V C0G (0603) | 0603 | bottom/top | C85980 | GRM1885C1H472JA01D (Murata Electronics) | Extended | 99447 | 0.0212 | 33149 | yes | timing / compensation / sample-and-hold: C0G; on Verr1-3 Alternates: C53987 X7R Basic |
| card | C12 C22 C23 C24 C26 C28 C29 C32 C36 C37 C38 C42 C43 C46 C52 C53 C54 C58 C59 C63 C65 C66 C68 C92 C94 C95 C96 C97 C98 C99 C104 | 31 | ceramic capacitor 100nF 50 V X7R (0603) | 0603 | bottom/top | C14663 | CC0603KRX7R9BB104 (YAGEO) | Basic | 54422762 | 0.0123 | 1265645 | yes | value and package from the schematic; X7R, voltage rating at least 2x the net (rails 5/12 V, Vin 14-17 V) |
| card | C14 | 1 | ceramic capacitor 220pF 50 V C0G (0603) | 0603 | top | C27675 | CL10C221JB8NNNC (Samsung Electro-Mechanics) | Extended | 32979 | 0.0095 | 32979 | yes | timing / compensation / sample-and-hold: C0G; Q1 emitter Alternates: C1603 X7R Basic |
| card | C15 | 1 | ceramic capacitor 100pF 50 V C0G (0603) | 0603 | top | C14858 | CL10C101JB8NNNC (Samsung Electro-Mechanics) | Basic | 3911823 | 0.0086 | 3911823 | yes | timing / compensation / sample-and-hold: C0G |
| card | C47 C93 C103 | 3 | ceramic capacitor 10uF 25 V X5R (0603) | 0603 | bottom | C96446 | CL10A106MA8NRNC (Samsung Electro-Mechanics) | Basic | 3361748 | 0.0752 | 1120582 | yes | value and package from the schematic; X7R, voltage rating at least 2x the net (rails 5/12 V, Vin 14-17 V); Vref_1-3 (5 V): 25 V X5R |
| card | C49 C64 C67 | 3 | ceramic capacitor 100nF 50 V C0G (1206) | 1206 | bottom | C97946 | GRM31C5C1H104JA01L (Murata Electronics) | Extended | 88688 | 0.1849 | 29562 | yes | timing / compensation / sample-and-hold: C0G; sample-and-hold into the 4066 switches Alternates: C14663-class X7R |
| card | C57 C91 | 2 | ceramic capacitor 1uF 50 V X7R (0805) | 0805 | bottom/top | C28323 | CL21B105KBFNNNE (Samsung Electro-Mechanics) | Basic | 2288251 | 0.0399 | 286031 | yes | value and package from the schematic; X7R, voltage rating at least 2x the net (rails 5/12 V, Vin 14-17 V) |
| card | C100 C101 C102 | 3 | ceramic capacitor 1nF 50 V X7R (0603) | 0603 | bottom/top | C1588 | CL10B102KB8NNNC (Samsung Electro-Mechanics) | Basic | 7811866 | 0.0089 | 1301977 | yes | value and package from the schematic; X7R, voltage rating at least 2x the net (rails 5/12 V, Vin 14-17 V); pot B-terminal filter |
| card | D1 D3 D4 D5 D6 D7 D15 D20 D24 D27 | 10 | small-signal diode 75 V | SOD-123 | bottom/top | C81598 | 1N4148W (ST(Semtech)) | Basic | 5212124 | 0.0123 | 521212 | yes | your choice of 2026-09-24; no diode type in the schematic (LTspice default silicon diode). Proposal 1N4148W (Basic), the closest real part to what was simulated |
| card | D23 D25 D26 | 3 | Schottky diode 30 V 0.2 A | SOD-323 | bottom/top | C22629 | BAT54WS L9 (Jiangsu Changjing Electronics Technology Co., Ltd.) | Extended | 1078 | 0.0238 | 359 | yes | your choice of 2026-09-24; no type in the schematic; the design notes show BAT54 on this path (Output -> .1Vref_n). Proposal BAT54WS Alternates: C124205 BAT54WS-7-F |
| card | Q1 | 1 | PNP transistor 40 V | SOT-23 | bottom | C53444 | MMBT3906LT1G (onsemi) | Extended | 1000823 | 0.0189 | 1000823 | yes | your choice of 2026-09-24; no transistor type in the schematic (LTspice generic PNP). Proposal MMBT3906 Alternates: C2143 JSCJ MMBT3906 |
| card | R2 R6 R31 R33 R39 R41 R67 R77 R83 R85 R99 R100 R101 R102 R103 | 15 | resistor 10k ohm 1 % (0603) | 0603 | bottom/top | C25804 | 0603WAF1002T5E (UNI-ROYAL(Uniroyal Elec)) | Basic | 23109251 | 0.0018 | 1004750 | yes | value and package from the schematic; 1% thick film, JLC Basic where one exists |
| card | R3 R32 R40 | 3 | resistor 620k ohm 1 % (0603) | 0603 | bottom/top | C23219 | 0603WAF6203T5E (UNI-ROYAL(Uniroyal Elec)) | Extended | 93537 | 0.002 | 31179 | yes | value and package from the schematic; 1% thick film, JLC Basic where one exists |
| card | R4 R54 R55 R58 R71 | 5 | resistor 1k ohm 1 % (0603) | 0603 | bottom/top | C21190 | 0603WAF1001T5E (UNI-ROYAL(Uniroyal Elec)) | Basic | 21672207 | 0.0026 | 4334441 | yes | value and package from the schematic; 1% thick film, JLC Basic where one exists |
| card | R8 R34 R42 R51 R63 R78 R80 | 7 | resistor 2k ohm 1 % (0603) | 0603 | bottom/top | C22975 | 0603WAF2001T5E (UNI-ROYAL(Uniroyal Elec)) | Basic | 13572776 | 0.0024 | 1938968 | yes | value and package from the schematic; 1% thick film, JLC Basic where one exists |
| card | R9 R35 R43 | 3 | resistor 18k ohm 1 % (0805) | 0805 | bottom/top | C17506 | 0805W8F1802T5E (UNI-ROYAL(Uniroyal Elec)) | Extended (preferred) | 194888 | 0.0043 | 64962 | yes | value and package from the schematic; 1% thick film, JLC Basic where one exists |
| card | R11 R17 | 2 | resistor 510k ohm 1 % (0603) | 0603 | bottom | C23192 | 0603WAF5103T5E (UNI-ROYAL(Uniroyal Elec)) | Basic | 894332 | 0.0024 | 447166 | yes | value and package from the schematic; 1% thick film, JLC Basic where one exists |
| card | R16 R19 | 2 | resistor 5.1k ohm 1 % (0603) | 0603 | bottom/top | C23186 | 0603WAF5101T5E (UNI-ROYAL(Uniroyal Elec)) | Basic | 25280385 | 0.0015 | 12640192 | yes | value and package from the schematic; 1% thick film, JLC Basic where one exists |
| card | R18 R20 | 2 | resistor 200k ohm 1 % (0603) | 0603 | bottom | C25811 | 0603WAF2003T5E (UNI-ROYAL(Uniroyal Elec)) | Basic | 2473796 | 0.0023 | 1236898 | yes | value and package from the schematic; 1% thick film, JLC Basic where one exists |
| card | R25 R87 R94 | 3 | resistor 910k ohm 1 % (0805) | 0805 | bottom/top | C17864 | 0805W8F9103T5E (UNI-ROYAL(Uniroyal Elec)) | Extended | 15984 | 0.0034 | 5328 | yes | value and package from the schematic; 1% thick film, JLC Basic where one exists; Vout dividers: 150 V rated |
| card | R26 R64 R79 R81 | 4 | resistor 220 ohm 1 % (0603) | 0603 | bottom/top | C22962 | 0603WAF2200T5E (UNI-ROYAL(Uniroyal Elec)) | Basic | 1903983 | 0.0035 | 271997 | yes | value and package from the schematic; 1% thick film, JLC Basic where one exists |
| card | R27 R37 R45 | 3 | resistor 4.7k ohm 1 % (0603) | 0603 | bottom/top | C23162 | 0603WAF4701T5E (UNI-ROYAL(Uniroyal Elec)) | Basic | 22492816 | 0.0028 | 7497605 | yes | value and package from the schematic; 1% thick film, JLC Basic where one exists |
| card | R28 R36 R38 R44 R46 R88 R91 R95 R96 R105 | 10 | resistor 100k ohm 1 % (0603) | 0603 | bottom/top | C25803 | 0603WAF1003T5E (UNI-ROYAL(Uniroyal Elec)) | Basic | 22167984 | 0.0031 | 2216798 | yes | value and package from the schematic; 1% thick film, JLC Basic where one exists |
| card | R29 R30 R57 | 3 | resistor 22k ohm 1 % (0805) | 0805 | top | C17560 | 0805W8F2202T5E (UNI-ROYAL(Uniroyal Elec)) | Basic | 1746324 | 0.0048 | 582108 | yes | value and package from the schematic; 1% thick film, JLC Basic where one exists |
| card | R65 | 1 | resistor 22k ohm 1 % (0603) | 0603 | top | C31850 | 0603WAF2202T5E (UNI-ROYAL(Uniroyal Elec)) | Basic | 3706362 | 0.0041 | 3706362 | yes | value and package from the schematic; 1% thick film, JLC Basic where one exists |
| card | R66 R89 R92 R97 | 4 | resistor 3.3k ohm 1 % (0603) | 0603 | bottom/top | C22978 | 0603WAF3301T5E (UNI-ROYAL(Uniroyal Elec)) | Basic | 5696130 | 0.0026 | 1424032 | yes | value and package from the schematic; 1% thick film, JLC Basic where one exists |
| card | R68 | 1 | resistor 62k ohm 1 % (0603) | 0603 | top | C23221 | 0603WAF6202T5E (UNI-ROYAL(Uniroyal Elec)) | Extended (preferred) | 418136 | 0.0028 | 418136 | yes | value and package from the schematic; 1% thick film, JLC Basic where one exists |
| card | R69 | 1 | resistor 20k ohm 1 % (0603) | 0603 | top | C4184 | 0603WAF2002T5E (UNI-ROYAL(Uniroyal Elec)) | Basic | 8044733 | 0.0023 | 8044733 | yes | value and package from the schematic; 1% thick film, JLC Basic where one exists |
| card | R82 | 1 | resistor 56k ohm 1 % (0603) | 0603 | top | C23206 | 0603WAF5602T5E (UNI-ROYAL(Uniroyal Elec)) | Basic | 1026495 | 0.0027 | 1026495 | yes | value and package from the schematic; 1% thick film, JLC Basic where one exists |
| card | R84 | 1 | resistor 120k ohm 1 % (0603) | 0603 | bottom | C25808 | 0603WAF1203T5E (UNI-ROYAL(Uniroyal Elec)) | Basic | 1007305 | 0.0015 | 1007305 | yes | value and package from the schematic; 1% thick film, JLC Basic where one exists |
| card | R86 | 1 | resistor 1M ohm 1 % (0805) | 0805 | top | C17514 | 0805W8F1004T5E (UNI-ROYAL(Uniroyal Elec)) | Basic | 2420510 | 0.0043 | 2420510 | yes | value and package from the schematic; 1% thick film, JLC Basic where one exists |
| card | R90 R93 R98 | 3 | resistor 10M ohm 1 % (0603) | 0603 | bottom/top | C7250 | 0603WAF1005T5E (UNI-ROYAL(Uniroyal Elec)) | Basic | 297135 | 0.0037 | 99045 | yes | value and package from the schematic; 1% thick film, JLC Basic where one exists |
| card | U2 U4 U5 U14 U21 | 5 | comparator, push-pull, 56 ns | SOT-23-5 | bottom/top | C117501 | MCP6561T-E/OT (Microchip Tech) | Extended | 4005 | 0.743 | 801 | yes | the device named in the schematic or the notes |
| card | U3 U7 U13 U22 U23 U24 | 6 | op-amp, rail-to-rail, 1 MHz | SOT-23-5 | bottom/top | C398363 | TLV9001IDBVR (Texas Instruments) | Extended | 48438 | 0.0979 | 5382 | yes | approved 2026-10-01: TI TLV9001IDBVR (the DBV part: pins 1 OUT, 2 V-, 3 IN+, 4 IN-, 5 V+, as the MCP6241; NOT the TLV9001U). 1 MHz, 2 V/us, 1.6 mV max offset. LTspice re-runs (30 ms, 25 % PWM, cold start) match the MCP6241 within 0.05 % Alternates: C49889 MCP6241T-E/OT (before 2026-10-01) |
| card | U18 | 1 | decade counter (CMOS 4017) | SOIC-16 | top | C11349 | CD4017BM96 (Texas Instruments) | Extended | 18267 | 0.7267 | 18267 | yes | the device named in the schematic or the notes |
| card | U26 | 1 | quad digital potentiometer 10 kOhm, I2C | TSSOP-20 | bottom | C145613 | MCP4451-103E/ST (Microchip Tech) | Extended | 40 | 2.9051 | 40 | yes | part chosen earlier (HANDOFF_SUMMARY / replace_notes / ANSWERS); STOCK 52 |
| card | U28 | 1 | 8-channel analog multiplexer | SOIC-16 | top | C9386 | 74HC4051D,653 (Nexperia) | Extended | 33472 | 0.2146 | 33472 | yes | the device named in the schematic or the notes |
| card | U101 U102 U103 | 3 | quad 2-input NAND gate | SOIC-14 | top | C5586 | 74HC00D,653 (Nexperia) | Extended | 8289 | 0.1546 | 2763 | yes | the device named in the schematic or the notes |
| card | U104 U105 | 2 | hex Schmitt-trigger inverter | SOIC-14 | bottom/top | C5605 | 74HC14D,653 (Nexperia) | Basic | 206540 | 0.1023 | 103270 | yes | the device named in the schematic or the notes |
| card | U106 | 1 | quad analog switch | SOIC-14 | bottom | C179842 | CD74HC4066M96 (Texas Instruments) | Extended | 73 | 0.6097 | 73 | yes | the device named in the schematic or the notes; STOCK 73 |

## I fit (DNP in the JLC files; pads, holes and silk stay)

| Board | Refs | Qty | Description | Footprint | Side | LCSC | MPN (maker) | Basic/Ext | Stock | $/unit | Max sets | Orderable | Why / notes |
|---|---|---|---|---|---|---|---|---|---|---|---|---|---|
| power | J10 | 1 | 2x15 socket strip, 2.54 mm, elevated (Samtec) | PinSocket 2x15 | top |  |  |  |  |  |  |  | the device named in the schematic or the notes; not stocked at LCSC (only the -LL variant is listed, 0 in stock, $23.28); buy from Samtec / Digi-Key / Mouser Alternates: C5689183 ESQ-115-44-G-D-LL (stock 0) |
| power | L1 | 1 | 6.8 uH power inductor, 32 x 22.5 mm | 32 x 22.5 mm SMD | top |  |  |  |  |  |  |  | the device named in the schematic or the notes; the user owns it Alternates: C5629897 (stock 0) |
| power | M1 M2 M3 M4 M5 M6 M7 M8 M9 M10 | 10 | 100 V N-channel MOSFET (TO-220) | TO-220 | bottom |  |  |  |  |  |  |  | the device named in the schematic or the notes; the user owns ten Alternates: C2841917 HYG180N10LS1P |
| card | J11 | 1 | 2x15 pin header, 2.54 mm (Samtec) | PinHeader 2x15 | bottom |  |  |  |  |  |  |  | the device named in the schematic or the notes; LCSC lists it with 0 in stock; buy from Samtec / Digi-Key / Mouser Alternates: C5994596 (stock 0) |

## Unresolved (a decision is needed; the proposal is in the *_with_proposals files)

| Board | Refs | Qty | Description | Footprint | Side | LCSC | MPN (maker) | Basic/Ext | Stock | $/unit | Max sets | Orderable | Why / notes |
|---|---|---|---|---|---|---|---|---|---|---|---|---|---|

## No part to buy

| Board | Refs | Qty | Description | Footprint | Side | LCSC | MPN (maker) | Basic/Ext | Stock | $/unit | Max sets | Orderable | Why / notes |
|---|---|---|---|---|---|---|---|---|---|---|---|---|---|
| power | H5 H6 H7 H8 | 4 | mounting hole | M3 | top |  |  |  |  |  |  |  |  |
| power | J1 J2 | 2 | battery lug | M4 hole | top |  |  |  |  |  |  |  | cable lugs bolted through; no part on the BOM |
| power | J3 J4 J5 J6 J7 J8 | 6 | LED wire pad | THT pad 4 mm | top |  |  |  |  |  |  |  | wires soldered in |
| power | NT1 NT2 NT3 | 3 | net tie | - | top |  |  |  |  |  |  |  |  |
| card | H1 H2 H3 H4 | 4 | mounting hole | M3 | top |  |  |  |  |  |  |  |  |
| card | J9 | 1 | Arduino wire pads | 11 wire pads | top |  |  |  |  |  |  |  | wires soldered in (BUILD_NOTES J9 table) |

## Assembly quantities

| Board | Files | Unique parts | Basic | Extended | Placements | SMT pads | Components $/board (qty-1 prices) | Sides |
|---|---|---|---|---|---|---|---|---|
| power | JLC only | 28 | 11 | 17 | 99 | 283 | 42.31 | bottom + top |
| power | _with_proposals | 28 | 11 | 17 | 99 | 283 | 42.31 | bottom + top |
| card | JLC only | 41 | 25 | 16 | 160 | 472 | 11.27 | bottom + top |
| card | _with_proposals | 41 | 25 | 16 | 160 | 472 | 11.27 | bottom + top |
