ChristopherCa55/led-driver/BOOST_split_boards/FINAL_2026-09-25/7_docs/COST_SUMMARY.md

# BOOST: cost summary, scenario A (final, 2026-09-25)

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

The BOM is schematic **rev6**: R1 = Bourns CSS4J-4026R-1L00F (1 mOhm), U25 = INA241A4.

## Grand total

| | Power board | Control card | Total |
|---|---|---|---|
| Bare PCBs (5 each) | $124.10 | $137.04 | $261.14 |
| JLC assembly of 2 each (fees + parts) | $225.42 | $167.31 | $392.73 |
| Parts bought elsewhere (J10, J11, PTC) | | | $24.91 |
| Hardware for 2 sets, without the thermal pad | | | $55.14 |
| **Subtotal without the pad** | | | **$733.92** |
| + McMaster 1272N32 pad (default) | | | **$760.83** |
| + Parker G579 0.060 in pad instead | | | $862.67 |
| + t-Global TG-AD30 1.5 mm instead | | | $733.92 + its price (not read) |
| Shipping, tax | | | not included |

Against the first scenario-A figure ($803.86, which carried an estimated $85 pad):
- your Digi-Key prices for the HNSM3 standoff and the Boyd washer;
- the Essentra HTSN stud (bulk only) replaced by a McMaster set screw and aluminium spacer;
- the PTC changed to MF-R050.

Every line is now a read price, except two: the TR washers and the Wurth screws, which are Farnell UK prices converted from GBP.

## Bare PCBs (JLCPCB quote page, 2026-09-24)

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

## Assembly (JLC Standard PCBA, 2 of each)

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

## Stock on 2026-09-25 (JLC parts library, 00:15 PDT)

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

## Itemised JLC parts (everything JLC buys; excludes M1-M10 and L1)

### Power board

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

### Control card

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

## Parts bought elsewhere

| Item | Qty | Unit | $ | Source | Checked |
|---|---|---|---|---|---|
| Samtec ESQ-115-44-G-D, J10 socket (power board) | 2 | $9.1300 | $18.26 | Mouser, as listed on samtec.com | read on samtec.com |
| Samtec TSW-115-07-G-D, J11 header (card) | 2 | $3.1800 | $6.36 | Mouser, as listed on samtec.com | read on samtec.com |
| Bourns MF-R050 PTC, 0.50 A hold (inline on the J9 pin-9 wire), LCSC C208476 | 2 | $0.1431 | $0.29 | LCSC (its own order; JLC does not ship loose parts) | read 2026-09-25 (7,362 in stock); derating from the Bourns MF-R datasheet |
| **Total** | | | **$24.91** | | |

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

The load is about 0.1 A. MF-R050 still holds about 2.5x that at 75 C. It trips at 1.0 A at room temperature, which protects the 26-28 AWG wire and the card's 0.3 mm track; the LM2940 current-limits above its 1 A rating. Its resistance is 0.41-0.77 ohm new and 1.17 ohm at most an hour after a trip, so the drop at 0.1 A is at most 0.12 V. Rated 60 V, -40 to +85 C.

## Hardware for 2 sets

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

## Thermal pad: the ones you can buy

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

## Your buck converter

Fed from J9 pin 9 (the 12 V LM2940 rail) through the MF-R050. It has to:
- regulate from 11-13 V in, and survive at least 20 V;
- give 5.0 V +/-5 % at 200 mA or more;
- draw about 0.1 A.

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

## URLs for you to read

One line is left:

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

## Still flagged

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

Generated by `tools/cost_summary.py`; every number is also in `cost/cost_summary.json`.
