ChristopherCa55/led-driver/BOOST_package/BOOST_BOM.xlsx

Sheet: Summary
BOOST LED driver: bill of materials and cost
Scenario A: 5 bare PCBs of each board, 2 complete sets assembled by JLCPCB. Updated 2026-10-02: schematic rev6 plus D28-D30, 6-layer control card with 0.5 oz inner copper, the savings approved on 2026-10-01, and the 6-layer power board (2026-10-02, stackup JLC061611-7628D). JLC prices and stock read 2026-10-01.
Item | Cost (USD) | Notes
Power board: PCBs + JLC assembly |  | JLC order 1
Control card: PCBs + JLC assembly |  | JLC order 2
Bought elsewhere: J10/J11, PTC, hardware, McMaster thermal pad |  | Mouser, LCSC, McMaster-Carr, Digi-Key, Newark/Farnell
Total (shipping and tax not included) |  | COST_SUMMARY.md gives $599.01
Stock (2026-10-01): every JLC line is in stock for 2 sets. Re-check on the day you order.
Not included: M1-M10, L1, the buck module and J9 wires (you own them); case, cabling, Arduino, LEDs; shipping and tax.
Edit a unit price or a quantity on the board sheets and every total updates.

Sheet: Power board
# | Designators | Qty / board | Qty to order (2 boards + attrition) | Description | Manufacturer | Part number (MPN) | LCSC # | Basic / Extended | Unit price (USD, qty 1) | Line cost (USD) | JLC stock 2026-10-01 | Footprint | Side | Fitted by | JLC page | LCSC page | Datasheet | Value (schematic) | Specs (JLC listing) | Notes
1 | C1 C4 C73 | 3 |  | ceramic capacitor 4.7uF 100 V X7R (1210) | PSA(Prosperity Dielectrics) | FS32X475K101EGG | C381466 | Extended | $0.2328 |  | 172923 | 1210 | top | JLC | JLC (https://jlcpcb.com/partdetail/354087-FS32X475K101EGG/C381466) | LCSC (https://www.lcsc.com/product-detail/multilayer-ceramic-capacitors-mlcc-smd-smt_psa-prosperity-dielectrics-fs32x475k101egg_C381466.html) | PDF (https://wmsc.lcsc.com/wmsc/upload/file/pdf/v2/lcsc/2304140030_PSA-Prosperity-Dielectrics-FS32X475K101EGG_C381466.pdf) | 4.7uF | 100V 4.7uF X7R ±10% 1210 Multilayer Ceramic Capacitors MLCC - SMD/SMT ROHS | on Vout (23-33 V running; TVS stand-off 54 V, clamp 87 V): 100 V rated; commutation-loop ceramic per rail; 50 V part C170099 is cheaper but keeps less capacitance at 33 V Alternates: C170099 (50 V)
2 | C3 C72 C76 | 3 |  | ceramic capacitor 100nF 100 V X7R (0805) | Samsung Electro-Mechanics | CL21B104KCFNNNE | C28233 | Basic | $0.0357 |  | 1258622 | 0805 | top | JLC | JLC (https://jlcpcb.com/partdetail/28983-CL21B104KCFNNNE/C28233) | LCSC (https://www.lcsc.com/product-detail/multilayer-ceramic-capacitors-mlcc-smd-smt_samsung-electro-mechanics-cl21b104kcfnnne_C28233.html) | PDF (https://www.lcsc.com/datasheet/lcsc_datasheet_2304140030_Samsung-Electro-Mechanics-CL21B104KCFNNNE_C28233.pdf) | 100nF | 100V 100nF X7R ±10% 0805 Multilayer Ceramic Capacitors MLCC - SMD/SMT ROHS | on Vout (23-33 V running; TVS stand-off 54 V, clamp 87 V): 100 V rated
3 | C6 C21 C25 C31 C62 C89 | 6 |  | ceramic capacitor 1uF 50 V X7R (0805) | Samsung Electro-Mechanics | CL21B105KBFNNNE | C28323 | Basic | $0.0399 |  | 2288251 | 0805 | bottom/top | JLC | JLC (https://jlcpcb.com/partdetail/29074-CL21B105KBFNNNE/C28323) | LCSC (https://www.lcsc.com/product-detail/multilayer-ceramic-capacitors-mlcc-smd-smt_samsung-electro-mechanics-cl21b105kbfnnne_C28323.html) | PDF (https://www.lcsc.com/datasheet/lcsc_datasheet_2304140030_Samsung-Electro-Mechanics-CL21B105KBFNNNE_C28323.pdf) | 1uF | 1uF 50V X7R ±10% 0805 Multilayer Ceramic Capacitors MLCC - SMD/SMT ROHS | value and package from the schematic; X7R, voltage rating at least 2x the net (rails 5/12 V, Vin 14-17 V)
4 | C7 C55 | 2 |  | ceramic capacitor 22uF 25 V X7R (1210) | Murata Electronics | GRM32ER71E226KE15L | C21397 | Extended | $0.4585 |  | 75388 | 1210 | top | JLC | JLC (https://jlcpcb.com/partdetail/MurataElectronics-GRM32ER71E226KE15L/C21397) | LCSC (https://www.lcsc.com/product-detail/multilayer-ceramic-capacitors-mlcc-smd-smt_murata-electronics-grm32er71e226ke15l_C21397.html) | PDF (https://www.lcsc.com/datasheet/lcsc_datasheet_2308111542_Murata-Electronics-GRM32ER71E226KE15L_C21397.pdf) | 22uF | 22uF 25V X7R ±10% 1210 Multilayer Ceramic Capacitors MLCC - SMD/SMT ROHS | part chosen earlier (HANDOFF_SUMMARY / replace_notes / ANSWERS)
5 | C16 C18 C60 | 3 |  | ceramic capacitor 2.2uF 50 V X7R (1206) | Samsung Electro-Mechanics | CL31B225KBHNNNE | C50254 | Basic | $0.0857 |  | 389063 | 1206 | bottom | JLC | JLC (https://jlcpcb.com/partdetail/51263-CL31B225KBHNNNE/C50254) | LCSC (https://www.lcsc.com/product-detail/multilayer-ceramic-capacitors-mlcc-smd-smt_samsung-electro-mechanics-cl31b225kbhnnne_C50254.html) | PDF (https://www.lcsc.com/datasheet/lcsc_datasheet_2304140030_Samsung-Electro-Mechanics-CL31B225KBHNNNE_C50254.pdf) | 2.2uF | 2.2uF 50V X7R ±10% 1206 Multilayer Ceramic Capacitors MLCC - SMD/SMT ROHS | value and package from the schematic; X7R, voltage rating at least 2x the net (rails 5/12 V, Vin 14-17 V); bootstrap caps, 12 V across
6 | C20 C33 C34 C35 C48 C50 C51 C61 C82 C83 C84 C90 | 12 |  | ceramic capacitor 100nF 50 V X7R (0603) | YAGEO | CC0603KRX7R9BB104 | C14663 | Basic | $0.0123 |  | 54422762 | 0603 | bottom/top | JLC | JLC (https://jlcpcb.com/partdetail/YAGEO-CC0603KRX7R9BB104/C14663) | LCSC (https://www.lcsc.com/product-detail/multilayer-ceramic-capacitors-mlcc-smd-smt_yageo-cc0603krx7r9bb104_C14663.html) | PDF (https://www.lcsc.com/datasheet/lcsc_datasheet_2211101700_YAGEO-CC0603KRX7R9BB104_C14663.pdf) | 100nF | 100nF 50V X7R ±10% 0603 Multilayer Ceramic Capacitors MLCC - SMD/SMT ROHS | value and package from the schematic; X7R, voltage rating at least 2x the net (rails 5/12 V, Vin 14-17 V); C82-C84 on Vin (<= 17 V), 50 V part
7 | C30 | 1 |  | 47 uF 25 V tantalum capacitor (low ESR, case D) | Vishay Intertech | TR3D476K025C0250 | C4979367 | Extended | $1.0990 |  | 63 | EIA-7343 (D) | top | JLC | JLC (https://jlcpcb.com/partdetail/VishayIntertech-TR3D476K025C0250/C4979367) | LCSC (https://www.lcsc.com/product-detail/tantalum-capacitors_vishay-intertech-tr3d476k025c0250_C4979367.html) | PDF (https://wmsc.lcsc.com/wmsc/upload/file/pdf/v2/lcsc/2312131210_Vishay-Intertech-TR3D476K025C0250_C4979367.pdf) | 47uF tantalum | -55℃~+125℃ 250mΩ 25V 47uF ±10% CASE-D-7343-34(mm) Tantalum Capacitors ROHS | part chosen earlier (HANDOFF_SUMMARY / replace_notes / ANSWERS); U16 (12 V regulator) output, ESR 250 mOhm
8 | C39 C56 C79 C80 C81 | 5 |  | ceramic capacitor 10uF 50 V X7R (1210) | Samsung Electro-Mechanics | CL32B106KBJNNNE | C138687 | Extended | $0.3252 |  | 32750 | 1210 | top | JLC | JLC (https://jlcpcb.com/partdetail/150006-CL32B106KBJNNNE/C138687) | LCSC (https://lcsc.com/product-detail/Multilayer-Ceramic-Capacitors-MLCC-SMD-SMT_Samsung-Electro-Mechanics-CL32B106KBJNNNE_C138687.html) | PDF (https://datasheet.lcsc.com/lcsc/1912112237_Samsung-Electro-Mechanics-CL32B106KBJNNNE_C138687.pdf) | 10uF | 10uF 50V X7R ±10% 1210 Multilayer Ceramic Capacitors MLCC - SMD/SMT ROHS | value and package from the schematic; X7R, voltage rating at least 2x the net (rails 5/12 V, Vin 14-17 V); C79-C81 on Vin: 50 V X7R
9 | C40 C69 C85 | 3 |  | 680 uF 25 V hybrid polymer electrolytic capacitor | PANASONIC | EEH-ZU1E681UP | C29664285 | Extended | $2.5409 |  | 10 | CP_Elec_10x12.5 | top | JLC | JLC (https://jlcpcb.com/partdetail/PANASONIC-EEHZU1E681UP/C29664285) |  |  | 680uF EEH-ZU1E681UP | -55℃~+135℃ 10mm 10mΩ@100kHz 12.5mm 25V 3700mA@100kHz 4000hrs@135℃ 680uF Polarized SMD ±20% SMD,D10x12.8mm Hybrid Aluminum Electrolytic Capacitors ROHS | part chosen earlier (HANDOFF_SUMMARY / replace_notes / ANSWERS); STOCK 10: enough for 3 boards (3 each)
10 | C41 C44 C45 | 3 |  | ceramic capacitor 1nF 50 V X7R (0603) | Samsung Electro-Mechanics | CL10B102KB8NNNC | C1588 | Basic | $0.0089 |  | 7811866 | 0603 | top | JLC | JLC (https://jlcpcb.com/partdetail/1940-CL10B102KB8NNNC/C1588) | LCSC (https://www.lcsc.com/product-detail/multilayer-ceramic-capacitors-mlcc-smd-smt_samsung-electro-mechanics-cl10b102kb8nnnc_C1588.html) | PDF (https://www.lcsc.com/datasheet/lcsc_datasheet_2304140030_Samsung-Electro-Mechanics-CL10B102KB8NNNC_C1588.pdf) | 1nF | 1nF 50V X7R ±10% 0603 Multilayer Ceramic Capacitors MLCC - SMD/SMT ROHS | value and package from the schematic; X7R, voltage rating at least 2x the net (rails 5/12 V, Vin 14-17 V); IREF wiper filter Alternates: C163508 (C0G)
11 | C74 C86 C87 | 3 |  | 220 uF 50 V hybrid polymer electrolytic capacitor (Panasonic ZU) | PANASONIC | EEH-ZU1H221P | C6843593 | Extended | $2.8352 |  | 14 | CP_Elec_10x16.5 | top | JLC | JLC (https://jlcpcb.com/partdetail/PANASONIC-EEHZU1H221P/C6843593) | LCSC (https://www.lcsc.com/product-detail/hybrid-aluminum-electrolytic-capacitors_panasonic-eeh-zu1h221p_C6843593.html) |  | 220uF EEH-ZU1H221P | -55℃~+135℃ 10mm 10mΩ 16.8mm 220uF 4000hrs@135℃ 50V 780mA@100Hz Polarized SMD ±20% SMD,D10xL16.8mm Hybrid Aluminum Electrolytic Capacitors ROHS | part chosen earlier (HANDOFF_SUMMARY / replace_notes / ANSWERS); the three most loaded output caps (BOOST_AUDIT section 6: up to 3.46 A); since 2026-10-01 the other six are EEH-ZS1H221P
12 | C70 C71 C75 C77 C78 C88 | 6 |  | 220 uF 50 V hybrid polymer electrolytic capacitor (Panasonic ZS) | PANASONIC | EEHZS1H221P | C385885 | Extended | $1.6338 |  | 1263 | CP_Elec_10x16.5 | top | JLC | JLC (https://jlcpcb.com/partdetail/PANASONIC-EEHZS1H221P/C385885) | LCSC (https://www.lcsc.com/product-detail/hybrid-aluminum-electrolytic-capacitors_panasonic-eehzs1h221p_C385885.html) | PDF (https://wmsc.lcsc.com/wmsc/upload/file/pdf/v2/lcsc/1912111437_PANASONIC-EEHZS1H221P_C385885.pdf) | 220uF EEH-ZS1H221P | -55℃~+135℃ 10mm 13mΩ 16.5mm 220uF 4000hrs@135℃ 50V 555mA@100Hz Polarized SMD ±20% SMD,D10xL16.5mm Hybrid Aluminum Electrolytic Capacitors ROHS | approved 2026-10-01: same Panasonic hybrid family, size and footprint; 13 mOhm, 3.7 A (ZU: 10 mOhm, 5.2 A). These positions carry 1.90-2.37 A, 51-64 % of the ZS rating; cheaper, and the ZU had too little stock Alternates: C6843593 EEH-ZU1H221P
13 | D2 D8 D11 D13 D14 D22 | 6 |  | Schottky diode 40 V 1 A | Jiangsu Changjing Electronics Technology Co., Ltd. | B5819W SL | C8598 | Basic | $0.0280 |  | 512334 | SOD-123 | bottom | JLC | JLC (https://jlcpcb.com/partdetail/9093-B5819WSL/C8598) | LCSC (https://www.lcsc.com/product-detail/schottky-diodes_jiangsu-changjing-electronics-technology-co-ltd-b5819w-sl_C8598.html) | PDF (https://www.lcsc.com/datasheet/lcsc_datasheet_2304140030_Jiangsu-Changjing-Electronics-Technology-Co---Ltd--B5819W-SL_C8598.pdf) | B5819W (gate turn-off) | 1A 40V 600mV@1A 9A Independent SOD-123 Schottky Diodes ROHS | your choice of 2026-09-24; no diode type in the schematic (LTspice default diode). Anode on the FET gate, cathode to the driver side of the gate resistor: the turn-off path. Proposal B5819W (40 V 1 A Schottky, Basic) Alternates: C81598 1N4148W
14 | D9 D10 D21 | 3 |  | switching diode 200 V 0.2 A | Jiangsu Changjing Electronics Technology Co., Ltd. | BAV21W | C21565 | Extended | $0.0191 |  | 87375 | SOD-123 | bottom | JLC | JLC (https://jlcpcb.com/partdetail/22286-BAV21W/C21565) | LCSC (https://www.lcsc.com/product-detail/switching-diodes_jiangsu-changjing-electronics-technology-co-ltd-bav21w_C21565.html) | PDF (https://www.lcsc.com/datasheet/lcsc_datasheet_1811011112_Jiangsu-Changjing-Electronics-Technology-Co---Ltd--BAV21W_C21565.pdf) | BAV21W (bootstrap) | 1.25V@200mA 1.7A 100nA@200V 200V 200mA 500mW 50ns Independent SOD-123 Switching Diodes ROHS | your choice of 2026-09-24; no diode type in the schematic. 12 V to the high-side VDDA: blocks the rail FET source voltage (up to Vout, 54-87 V under a clamp event). Proposal BAV21W (200 V, trr 50 ns) Alternates: C81598 1N4148W (75 V: too low)
15 | D28 D29 D30 | 3 |  | rectifier diode 1000 V 2 A | Shandong Jingdao Microelectronics | S2MW | C128729 | Extended | $0.0183 |  | 14395 | SOD-123F | bottom | JLC | JLC (https://jlcpcb.com/partdetail/140015-S2MW/C128729) | LCSC (https://www.lcsc.com/product-detail/diodes-general-purpose_shandong-jingdao-microelectronics-s2mw_C128729.html) | PDF (https://www.lcsc.com/datasheet/lcsc_datasheet_1810121033_Shandong-Jingdao-Microelectronics-S2MW_C128729.pdf) | S2MW (pre-charge) | -55℃~+150℃ 1.1V@2A 1kV 2A 50A 5uA@1000V Independent SOD-123F Diodes - General Purpose ROHS | pre-charge diodes Vin -> Vout_1/2/3 (chosen 2026-09-29): 1000 V 2 A, IFSM 50 A; surge headroom 2.5x at an ideal battery (precharge_surge_2026-09-30), kept 2026-09-30 Alternates: C2900725 Foshan Blue Rocket S2MW
16 | D19 | 1 |  | TVS diode 54 V stand-off, 5 kW | hongjiacheng | 5.0SMDJ54A | C42394451 | Extended | $0.3951 |  | 9825 | D_SMC | bottom | JLC | JLC (https://jlcpcb.com/partdetail/hongjiacheng-50SMDJ54A/C42394451) |  |  | TVS 5.0SMDJ54A | DO-214AB(SMC) ESD and Surge Protection (TVS/ESD) ROHS | part chosen earlier (HANDOFF_SUMMARY / replace_notes / ANSWERS); Littelfuse has 1 in stock; R+O alternate (as decided 2026-09-15). Its listing gives the ratings but links no datasheet Alternates: C20415356 Littelfuse (stock 1); C5279851 SETsafe (published specs)
17 | J10 | 1 |  | 2x15 socket strip, 2.54 mm, elevated (Samtec) | Samtec | ESQ-115-44-G-D |  |  | $9.1300 |  |  | PinSocket 2x15 | top | you (hand) | Maker (https://www.samtec.com/products/esq-115-44-g-d) |  |  | ESQ-115-44-G-D |  | Mouser price as listed on samtec.com (2026-09-25); bought by you, fitted by you. the device named in the schematic or the notes; not stocked at LCSC (only the -LL variant is listed, 0 in stock, $23.28); buy from Samtec / Digi-Key / Mouser Alternates: C5689183 ESQ-115-44-G-D-LL (stock 0)
18 | L1 | 1 |  | 6.8 uH power inductor, 32 x 22.5 mm | Codaca | CSCF3218-6R8MC |  |  |  |  |  | 32 x 22.5 mm SMD | top | you (hand) |  |  |  | CSCF3218-6R8MC |  | you own it; not priced. the device named in the schematic or the notes; the user owns it Alternates: C5629897 (stock 0)
19 | M1 M2 M3 M4 M5 M6 M7 M8 M9 M10 | 10 |  | 100 V N-channel MOSFET (TO-220) | HUAYI (HYG) | HYG180N10LS1P |  |  |  |  |  | TO-220 | bottom | you (hand) |  |  |  | HYG180N10 |  | you own ten; not priced. the device named in the schematic or the notes; the user owns ten Alternates: C2841917 HYG180N10LS1P
20 | R1 | 1 |  | current-sense resistor 1 mOhm 4 W, 4-terminal | BOURNS | CSS4J-4026R-1L00F | C2076400 | Extended | $1.7086 |  | 385 | 4026 4-terminal | top | JLC | JLC (https://jlcpcb.com/partdetail/BOURNS-CSS4J_4026R1L00F/C2076400) | LCSC (https://www.lcsc.com/product-detail/current-sense-resistors-shunt-resistors_bourns-css4j-4026r-1l00f_C2076400.html) | PDF (https://wmsc.lcsc.com/wmsc/upload/file/pdf/v2/lcsc/2304140030_BOURNS-CSS4J-4026R-1L00F_C2076400.pdf) | 1m CSS4J-4026R-1L00F | 1mΩ 4W Current Sense Resistor ±1% ±75ppm/℃ 4026 Current Sense Resistors / Shunt Resistors ROHS | your choice of 2026-09-24; rev6: 1 mOhm with U25 = INA241A4 (100 V/V): Current stays 0.1 V/A. Same Bourns land pattern (series drawing), H 2.70 max against 2.93 Alternates: C2076167 CSS4J-4026K-2L00F 2 mOhm (0 stock)
21 | R7 R52 R53 | 3 |  | current-sense resistor 50 mOhm 1 W, metal strip | Vishay Intertech | WSL2512R0500FEA | C413486 | Extended | $0.2348 |  | 41066 | 2512 | top | JLC | JLC (https://jlcpcb.com/partdetail/VishayIntertech-WSL2512R0500FEA/C413486) | LCSC (https://www.lcsc.com/product-detail/chip-resistor-surface-mount_vishay-intertech-wsl2512r0500fea_C413486.html) | PDF (https://wmsc.lcsc.com/wmsc/upload/file/pdf/v2/lcsc/1912111437_Vishay-Intertech-WSL2512R0500FEA_C413486.pdf) | 50 mOhm WSL2512 | -65℃~+170℃ 1W 50mΩ ±1% ±75ppm/℃ 2512 Chip Resistor - Surface Mount ROHS | your choice of 2026-09-24; LED current sinks: 2.63 A, 0.35 W each. The value sets the LED current, so the TCR matters: WSL2512 metal strip +/-75 ppm/C ($0.23) against thick film +/-800 ppm/C ($0.04) Alternates: C127698 thick film +/-800 ppm/C
22 | R13 R23 R47 | 3 |  | resistor 220 ohm 1 % (0603) | UNI-ROYAL(Uniroyal Elec) | 0603WAF2200T5E | C22962 | Basic | $0.0035 |  | 1903983 | 0603 | bottom/top | JLC | JLC (https://jlcpcb.com/partdetail/23689-0603WAF2200T5E/C22962) | LCSC (https://www.lcsc.com/product-detail/chip-resistor-surface-mount_uni-royal-uniroyal-elec-0603waf2200t5e_C22962.html) | PDF (https://www.lcsc.com/datasheet/lcsc_datasheet_2206010130_UNI-ROYAL-Uniroyal-Elec-0603WAF2200T5E_C22962.pdf) | 220 | -55℃~+155℃ 100mW 220Ω 75V Thick Film Resistor ±1% ±100ppm/℃ 0603 Chip Resistor - Surface Mount ROHS | value and package from the schematic; 1% thick film, JLC Basic where one exists
23 | R15 | 1 |  | resistor 10 ohm 1 % (0805) | UNI-ROYAL(Uniroyal Elec) | 0805W8F100JT5E | C17415 | Basic | $0.0040 |  | 6880485 | 0805 | bottom | JLC | JLC (https://jlcpcb.com/partdetail/18103-0805W8F100JT5E/C17415) | LCSC (https://www.lcsc.com/product-detail/chip-resistor-surface-mount_uni-royal-uniroyal-elec-0805w8f100jt5e_C17415.html) | PDF (https://www.lcsc.com/datasheet/lcsc_datasheet_2206010216_UNI-ROYAL-Uniroyal-Elec-0805W8F100JT5E_C17415.pdf) | 10 | -55℃~+155℃ 10Ω 125mW 150V Thick Film Resistor ±1% ±200ppm/℃ 0805 Chip Resistor - Surface Mount ROHS | value and package from the schematic; 1% thick film, JLC Basic where one exists
24 | R21 R48 R60 R72 | 4 |  | resistor 5.1 ohm 1 % (0805) | UNI-ROYAL(Uniroyal Elec) | 0805W8F510KT5E | C17724 | Basic | $0.0041 |  | 418343 | 0805 | bottom | JLC | JLC (https://jlcpcb.com/partdetail/18412-0805W8F510KT5E/C17724) | LCSC (https://www.lcsc.com/product-detail/chip-resistor-surface-mount_uni-royal-uniroyal-elec-0805w8f510kt5e_C17724.html) | PDF (https://www.lcsc.com/datasheet/lcsc_datasheet_2206010200_UNI-ROYAL-Uniroyal-Elec-0805W8F510KT5E_C17724.pdf) | 5.1 | -55℃~+155℃ 125mW 150V 5.1Ω Thick Film Resistor ±1% ±200ppm/℃ 0805 Chip Resistor - Surface Mount ROHS | your choice of 2026-09-24; rev6: 5 -> 5.1 Ohm (5.0 Ohm 0805 is not stocked), the value R59/R70 already use Alternates: C25273 4.99 Ohm
25 | R22 R50 R56 | 3 |  | resistor 100 ohm 1 % (0603) | UNI-ROYAL(Uniroyal Elec) | 0603WAF1000T5E | C22775 | Basic | $0.0031 |  | 11576722 | 0603 | top | JLC | JLC (https://jlcpcb.com/partdetail/23502-0603WAF1000T5E/C22775) | LCSC (https://www.lcsc.com/product-detail/chip-resistor-surface-mount_uni-royal-uniroyal-elec-0603waf1000t5e_C22775.html) | PDF (https://www.lcsc.com/datasheet/lcsc_datasheet_2411221126_UNI-ROYAL-Uniroyal-Elec-0603WAF1000T5E_C22775.pdf) | 100 | -55℃~+155℃ 100mW 100Ω 75V Thick Film Resistor ±1% ±100ppm/℃ 0603 Chip Resistor - Surface Mount ROHS | value and package from the schematic; 1% thick film, JLC Basic where one exists
26 | R49 R61 R62 R73 R74 R75 R76 R104 | 8 |  | resistor 10k ohm 1 % (0603) | UNI-ROYAL(Uniroyal Elec) | 0603WAF1002T5E | C25804 | Basic | $0.0018 |  | 23109251 | 0603 | bottom/top | JLC | JLC (https://jlcpcb.com/partdetail/26547-0603WAF1002T5E/C25804) | LCSC (https://www.lcsc.com/product-detail/chip-resistor-surface-mount_uni-royal-uniroyal-elec-0603waf1002t5e_C25804.html) | PDF (https://www.lcsc.com/datasheet/lcsc_datasheet_2206010045_UNI-ROYAL-Uniroyal-Elec-0603WAF1002T5E_C25804.pdf) | 10k | -55℃~+155℃ 100mW 10kΩ 75V Thick Film Resistor ±1% ±100ppm/℃ 0603 Chip Resistor - Surface Mount ROHS | value and package from the schematic; 1% thick film, JLC Basic where one exists
27 | R59 R70 | 2 |  | resistor 5.1 ohm 1 % (0805) | UNI-ROYAL(Uniroyal Elec) | 0805W8F510KT5E | C17724 | Basic | $0.0041 |  | 418343 | 0805 | bottom/top | JLC | JLC (https://jlcpcb.com/partdetail/18412-0805W8F510KT5E/C17724) | LCSC (https://www.lcsc.com/product-detail/chip-resistor-surface-mount_uni-royal-uniroyal-elec-0805w8f510kt5e_C17724.html) | PDF (https://www.lcsc.com/datasheet/lcsc_datasheet_2206010200_UNI-ROYAL-Uniroyal-Elec-0805W8F510KT5E_C17724.pdf) | 5.1 | -55℃~+155℃ 125mW 150V 5.1Ω Thick Film Resistor ±1% ±200ppm/℃ 0805 Chip Resistor - Surface Mount ROHS | value and package from the schematic; 1% thick film, JLC Basic where one exists
28 | U1 U17 | 2 |  | linear regulator 5 V 100 mA | STMicroelectronics | L78L05ACUTR | C43116 | Extended | $0.1020 |  | 21384 | SOT-89 | top | JLC | JLC (https://jlcpcb.com/partdetail/STMicroelectronics-L78L05ACUTR/C43116) | LCSC (https://www.lcsc.com/product-detail/voltage-regulators-linear-low-drop-out-ldo-regulators_stmicroelectronics-l78l05acutr_C43116.html) | PDF (https://www.lcsc.com/datasheet/lcsc_datasheet_1809200029_STMicroelectronics-L78L05ACUTR_C43116.pdf) | L78L05 | 0℃~+125℃@(Tj) 1 1.7V 100mA 20V 40uV 49dB@(120Hz) 5V 6mA Fixed Over Current Protection、Over Temperature Protection、Short Circuit Protection Positive SOT-89-3 Voltage Regulators - Linear, Low Drop Out (LDO) Regulators ROHS | the device named in the schematic or the notes; ST L78L05ACUTR (pinout OUT-GND-IN as the symbol)
29 | U6 U11 U12 | 3 |  | op-amp, rail-to-rail, 1 MHz | Texas Instruments | TLV9001IDBVR | C398363 | Extended | $0.0979 |  | 48438 | SOT-23-5 | top | JLC | JLC (https://jlcpcb.com/partdetail/TexasInstruments-TLV9001IDBVR/C398363) | LCSC (https://www.lcsc.com/product-detail/operational-amplifier_texas-instruments-tlv9001idbvr_C398363.html) | PDF (https://www.lcsc.com/datasheet/lcsc_datasheet_2410010130_Texas-Instruments-TLV9001IDBVR_C398363.pdf) | TLV9001 | -2.75V~-900mV、900mV~2.75V -40℃~+125℃ 1 1.6mV 1.8V~5.5V 1MHz 2V/us 2pA 4.7nV/√Hz@1kHz 40mA 5pA 600nV/℃ 60uA 86dB Enable/shutdown function、EMI filtering/RF suppression Rail-to-Rail Input, Rail-to-Rail Output SOT-23-5 Operational Amplifier ROHS | approved 2026-10-01: TI TLV9001IDBVR (the DBV part: pins 1 OUT, 2 V-, 3 IN+, 4 IN-, 5 V+, as the MCP6241; NOT the TLV9001U). 1 MHz, 2 V/us, 1.6 mV max offset. LTspice re-runs (30 ms, 25 % PWM, cold start) match the MCP6241 within 0.05 % Alternates: C49889 MCP6241T-E/OT (before 2026-10-01)
30 | U8 U10 U15 U19 | 4 |  | isolated dual gate driver | Texas Instruments | UCC21520DWR | C601651 | Extended | $0.8893 |  | 17156 | SOIC-16W | bottom | JLC | JLC (https://jlcpcb.com/partdetail/TexasInstruments-UCC21520DWR/C601651) | LCSC (https://www.lcsc.com/product-detail/isolators-gate-drivers_texas-instruments-ucc21520dwr_C601651.html) | PDF (https://www.lcsc.com/datasheet/lcsc_datasheet_2006102223_Texas-Instruments-UCC21520DWR_C601651.pdf) | UCC21520DW | -40℃~+150℃@(Tj) 0.8V~1.2V 1.2V~2V 125kV/us 2 3V~18V 45ns 45ns 4A 5700 6A 9.2V~25V MOSFET、IGBT SOIC-16-300mil Isolators - Gate Drivers ROHS | the device named in the schematic or the notes
31 | U16 | 1 |  | linear regulator 12 V 1 A (7812) | onsemi | MC7812BD2TR4G | C231294 | Extended | $0.5316 |  | 2024 | TO-263-3 | top | JLC | JLC (https://jlcpcb.com/partdetail/onsemi-MC7812BD2TR4G/C231294) | LCSC (https://www.lcsc.com/product-detail/voltage-regulators-linear-low-drop-out-ldo-regulators_onsemi-mc7812bd2tr4g_C231294.html) | PDF (https://www.lcsc.com/datasheet/lcsc_datasheet_2210210200_onsemi-MC7812BD2TR4G_C231294.pdf) | MC7812 | -40℃~+125℃@(Tj) 1 12V 1A 27V 2V@(1.0A) 3.4mA 60dB@(120Hz) Fixed Over Temperature Protection、Short Circuit Protection Positive TO-263-2 Voltage Regulators - Linear, Low Drop Out (LDO) Regulators ROHS | approved 2026-10-01: onsemi MC7812BD2TR4G. Its D2PAK (case 936) fits the TO-263-3 footprint: pins 1 IN and 3 OUT at 2.54 mm pitch, tab = pin 2 GND, the centre lead is cut (pad 2 stays empty, it is GND). 35 V in, -40 to +125 C. About 1.5 V dropout, so at the end of a 4S discharge the LEDs fade from about 12.7 V open-circuit (simulated: BOOST_split_boards/mc7812_lowbatt_2026-10-01) Alternates: C38744 MC7812CD2TR4G (0 to +125 C); C2877347 LM2940S-12/NOPB (before 2026-10-01)
32 | U25 | 1 |  | current-sense amplifier, gain 100 | Texas Instruments | INA241A4IDR | C22427873 | Extended | $3.5277 |  | 116 | SOIC-8 | top | JLC | JLC (https://jlcpcb.com/partdetail/TexasInstruments-INA241A4IDR/C22427873) |  |  | INA241A4 | SOIC-8 Current Sense Amplifiers ROHS | your choice of 2026-09-24; rev6: gain 100 V/V with the 1 mOhm R1; TI SBOSA30D: same SOIC-8 pinout for every gain, 1.1 MHz for all gains Alternates: C22427652 INA241A3IDR (rev5)
 | Parts total (JLC lines, 2 boards + attrition)
 | Parts you buy or own (priced lines)
 | Unique JLC part numbers (feeder loading $1.53 each) |  |  |  |  |  |  |  |  | 28

Sheet: Control card
# | Designators | Qty / board | Qty to order (2 boards + attrition) | Description | Manufacturer | Part number (MPN) | LCSC # | Basic / Extended | Unit price (USD, qty 1) | Line cost (USD) | JLC stock 2026-10-01 | Footprint | Side | Fitted by | JLC page | LCSC page | Datasheet | Value (schematic) | Specs (JLC listing) | Notes
1 | C8 C9 C17 C19 | 4 |  | ceramic capacitor 330pF 50 V C0G (0603) | Samsung Electro-Mechanics | CL10C331JB8NNNC | C1664 | Basic | $0.0179 |  | 915282 | 0603 | bottom/top | JLC | JLC (https://jlcpcb.com/partdetail/2016-CL10C331JB8NNNC/C1664) | LCSC (https://www.lcsc.com/product-detail/multilayer-ceramic-capacitors-mlcc-smd-smt_samsung-electro-mechanics-cl10c331jb8nnnc_C1664.html) | PDF (https://www.lcsc.com/datasheet/lcsc_datasheet_2304140030_Samsung-Electro-Mechanics-CL10C331JB8NNNC_C1664.pdf) | 330pF | 330pF 50V C0G ±5% 0603 Multilayer Ceramic Capacitors MLCC - SMD/SMT ROHS | timing / compensation / sample-and-hold: C0G
2 | C10 C11 C13 | 3 |  | ceramic capacitor 4.7nF 50 V C0G (0603) | Murata Electronics | GRM1885C1H472JA01D | C85980 | Extended | $0.0212 |  | 99447 | 0603 | bottom/top | JLC | JLC (https://jlcpcb.com/partdetail/MurataElectronics-GRM1885C1H472JA01D/C85980) | LCSC (https://www.lcsc.com/product-detail/multilayer-ceramic-capacitors-mlcc-smd-smt_murata-electronics-grm1885c1h472ja01d_C85980.html) | PDF (https://wmsc.lcsc.com/wmsc/upload/file/pdf/v2/lcsc/2304140030_Murata-Electronics-GRM1885C1H472JA01D_C85980.pdf) | 4.7nF | 4.7nF 50V C0G ±5% 0603 Multilayer Ceramic Capacitors MLCC - SMD/SMT ROHS | timing / compensation / sample-and-hold: C0G; on Verr1-3 Alternates: C53987 X7R Basic
3 | C12 C22 C23 C24 C26 C28 C29 C32 C36 C37 C38 C42 C43 C46 C52 C53 C54 C58 C59 C63 C65 C66 C68 C92 C94 C95 C96 C97 C98 C99 C104 | 31 |  | ceramic capacitor 100nF 50 V X7R (0603) | YAGEO | CC0603KRX7R9BB104 | C14663 | Basic | $0.0123 |  | 54422762 | 0603 | bottom/top | JLC | JLC (https://jlcpcb.com/partdetail/YAGEO-CC0603KRX7R9BB104/C14663) | LCSC (https://www.lcsc.com/product-detail/multilayer-ceramic-capacitors-mlcc-smd-smt_yageo-cc0603krx7r9bb104_C14663.html) | PDF (https://www.lcsc.com/datasheet/lcsc_datasheet_2211101700_YAGEO-CC0603KRX7R9BB104_C14663.pdf) | 100nF | 100nF 50V X7R ±10% 0603 Multilayer Ceramic Capacitors MLCC - SMD/SMT ROHS | value and package from the schematic; X7R, voltage rating at least 2x the net (rails 5/12 V, Vin 14-17 V)
4 | C14 | 1 |  | ceramic capacitor 220pF 50 V C0G (0603) | Samsung Electro-Mechanics | CL10C221JB8NNNC | C27675 | Extended | $0.0095 |  | 32979 | 0603 | top | JLC | JLC (https://jlcpcb.com/partdetail/28425-CL10C221JB8NNNC/C27675) | LCSC (https://www.lcsc.com/product-detail/multilayer-ceramic-capacitors-mlcc-smd-smt_samsung-electro-mechanics-cl10c221jb8nnnc_C27675.html) | PDF (https://www.lcsc.com/datasheet/lcsc_datasheet_2304140030_Samsung-Electro-Mechanics-CL10C221JB8NNNC_C27675.pdf) | 220pF | 220pF 50V C0G ±5% 0603 Multilayer Ceramic Capacitors MLCC - SMD/SMT ROHS | timing / compensation / sample-and-hold: C0G; Q1 emitter Alternates: C1603 X7R Basic
5 | C15 | 1 |  | ceramic capacitor 100pF 50 V C0G (0603) | Samsung Electro-Mechanics | CL10C101JB8NNNC | C14858 | Basic | $0.0086 |  | 3911823 | 0603 | top | JLC | JLC (https://jlcpcb.com/partdetail/15530-CL10C101JB8NNNC/C14858) | LCSC (https://www.lcsc.com/product-detail/multilayer-ceramic-capacitors-mlcc-smd-smt_samsung-electro-mechanics-cl10c101jb8nnnc_C14858.html) | PDF (https://www.lcsc.com/datasheet/lcsc_datasheet_2304140030_Samsung-Electro-Mechanics-CL10C101JB8NNNC_C14858.pdf) | 100pF | 100pF 50V C0G ±5% 0603 Multilayer Ceramic Capacitors MLCC - SMD/SMT ROHS | timing / compensation / sample-and-hold: C0G
6 | C47 C93 C103 | 3 |  | ceramic capacitor 10uF 25 V X5R (0603) | Samsung Electro-Mechanics | CL10A106MA8NRNC | C96446 | Basic | $0.0752 |  | 3361748 | 0603 | bottom | JLC | JLC (https://jlcpcb.com/partdetail/97651-CL10A106MA8NRNC/C96446) | LCSC (https://www.lcsc.com/product-detail/multilayer-ceramic-capacitors-mlcc-smd-smt_samsung-electro-mechanics-cl10a106ma8nrnc_C96446.html) | PDF (https://www.lcsc.com/datasheet/lcsc_datasheet_2304140030_Samsung-Electro-Mechanics-CL10A106MA8NRNC_C96446.pdf) | 10uF | 10uF 25V X5R ±20% 0603 Multilayer Ceramic Capacitors MLCC - SMD/SMT ROHS | value and package from the schematic; X7R, voltage rating at least 2x the net (rails 5/12 V, Vin 14-17 V); Vref_1-3 (5 V): 25 V X5R
7 | C49 C64 C67 | 3 |  | ceramic capacitor 100nF 50 V C0G (1206) | Murata Electronics | GRM31C5C1H104JA01L | C97946 | Extended | $0.1849 |  | 88688 | 1206 | bottom | JLC | JLC (https://jlcpcb.com/partdetail/MurataElectronics-GRM31C5C1H104JA01L/C97946) | LCSC (https://www.lcsc.com/product-detail/multilayer-ceramic-capacitors-mlcc-smd-smt_murata-electronics-grm31c5c1h104ja01l_C97946.html) | PDF (https://www.lcsc.com/datasheet/lcsc_datasheet_1810201313_Murata-Electronics-GRM31C5C1H104JA01L_C97946.pdf) | 100nF | 100nF 50V C0G ±5% 1206 Multilayer Ceramic Capacitors MLCC - SMD/SMT ROHS | timing / compensation / sample-and-hold: C0G; sample-and-hold into the 4066 switches Alternates: C14663-class X7R
8 | C57 C91 | 2 |  | ceramic capacitor 1uF 50 V X7R (0805) | Samsung Electro-Mechanics | CL21B105KBFNNNE | C28323 | Basic | $0.0399 |  | 2288251 | 0805 | bottom/top | JLC | JLC (https://jlcpcb.com/partdetail/29074-CL21B105KBFNNNE/C28323) | LCSC (https://www.lcsc.com/product-detail/multilayer-ceramic-capacitors-mlcc-smd-smt_samsung-electro-mechanics-cl21b105kbfnnne_C28323.html) | PDF (https://www.lcsc.com/datasheet/lcsc_datasheet_2304140030_Samsung-Electro-Mechanics-CL21B105KBFNNNE_C28323.pdf) | 1uF | 1uF 50V X7R ±10% 0805 Multilayer Ceramic Capacitors MLCC - SMD/SMT ROHS | value and package from the schematic; X7R, voltage rating at least 2x the net (rails 5/12 V, Vin 14-17 V)
9 | C100 C101 C102 | 3 |  | ceramic capacitor 1nF 50 V X7R (0603) | Samsung Electro-Mechanics | CL10B102KB8NNNC | C1588 | Basic | $0.0089 |  | 7811866 | 0603 | bottom/top | JLC | JLC (https://jlcpcb.com/partdetail/1940-CL10B102KB8NNNC/C1588) | LCSC (https://www.lcsc.com/product-detail/multilayer-ceramic-capacitors-mlcc-smd-smt_samsung-electro-mechanics-cl10b102kb8nnnc_C1588.html) | PDF (https://www.lcsc.com/datasheet/lcsc_datasheet_2304140030_Samsung-Electro-Mechanics-CL10B102KB8NNNC_C1588.pdf) | 1nF | 1nF 50V X7R ±10% 0603 Multilayer Ceramic Capacitors MLCC - SMD/SMT ROHS | value and package from the schematic; X7R, voltage rating at least 2x the net (rails 5/12 V, Vin 14-17 V); pot B-terminal filter
10 | D1 D3 D4 D5 D6 D7 D15 D20 D24 D27 | 10 |  | small-signal diode 75 V | ST(Semtech) | 1N4148W | C81598 | Basic | $0.0123 |  | 5212124 | SOD-123 | bottom/top | JLC | JLC (https://jlcpcb.com/partdetail/ST_Semtech-1N4148W/C81598) | LCSC (https://www.lcsc.com/product-detail/switching-diodes_st-semtech-1n4148w_C81598.html) | PDF (https://www.lcsc.com/datasheet/lcsc_datasheet_1811061725_ST-Semtech-1N4148W_C81598.pdf) | 1N4148W (logic) | 150mA 1A 1V@50mA 1uA@75V 400mW 4ns 75V Independent SOD-123 Switching Diodes ROHS | your choice of 2026-09-24; no diode type in the schematic (LTspice default silicon diode). Proposal 1N4148W (Basic), the closest real part to what was simulated
11 | D23 D25 D26 | 3 |  | Schottky diode 30 V 0.2 A | Jiangsu Changjing Electronics Technology Co., Ltd. | BAT54WS L9 | C22629 | Extended | $0.0238 |  | 1078 | SOD-323 | bottom/top | JLC | JLC (https://jlcpcb.com/partdetail/23356-BAT54WSL9/C22629) | LCSC (https://www.lcsc.com/product-detail/schottky-diodes_jiangsu-changjing-electronics-technology-co-ltd-bat54ws-l9_C22629.html) | PDF (https://www.lcsc.com/datasheet/lcsc_datasheet_1809140116_Jiangsu-Changjing-Electronics-Technology-Co---Ltd--BAT54WS-L9_C22629.pdf) | BAT54WS (Vref) | 100mA 1V@100mA 2uA@25V 30V 600mA Independent SOD-323 Schottky Diodes ROHS | your choice of 2026-09-24; no type in the schematic; the design notes show BAT54 on this path (Output -> .1Vref_n). Proposal BAT54WS Alternates: C124205 BAT54WS-7-F
12 | J11 | 1 |  | 2x15 pin header, 2.54 mm (Samtec) | Samtec | TSW-115-07-G-D |  |  | $3.1800 |  |  | PinHeader 2x15 | bottom | you (hand) | Maker (https://www.samtec.com/products/tsw-115-07-g-d) |  |  | TSW-115-07-G-D |  | Mouser price as listed on samtec.com (2026-09-25); bought by you, fitted by you. the device named in the schematic or the notes; LCSC lists it with 0 in stock; buy from Samtec / Digi-Key / Mouser Alternates: C5994596 (stock 0)
13 | Q1 | 1 |  | PNP transistor 40 V | onsemi | MMBT3906LT1G | C53444 | Extended | $0.0189 |  | 1000823 | SOT-23 | bottom | JLC | JLC (https://jlcpcb.com/partdetail/onsemi-MMBT3906LT1G/C53444) | LCSC (https://www.lcsc.com/product-detail/bipolar-bjt_onsemi-mmbt3906lt1g_C53444.html) | PDF (https://www.lcsc.com/datasheet/lcsc_datasheet_1810301518_onsemi-MMBT3906LT1G_C53444.pdf) | MMBT3906 | -55℃~+150℃ 1 PNP 200mA 225mW 250MHz 250mV 40V 50nA 5V 60 PNP SOT-23 Bipolar (BJT) ROHS | your choice of 2026-09-24; no transistor type in the schematic (LTspice generic PNP). Proposal MMBT3906 Alternates: C2143 JSCJ MMBT3906
14 | R2 R6 R31 R33 R39 R41 R67 R77 R83 R85 R100 R101 R103 | 13 |  | resistor 10k ohm 1 % (0603) | UNI-ROYAL(Uniroyal Elec) | 0603WAF1002T5E | C25804 | Basic | $0.0018 |  | 23109251 | 0603 | bottom/top | JLC | JLC (https://jlcpcb.com/partdetail/26547-0603WAF1002T5E/C25804) | LCSC (https://www.lcsc.com/product-detail/chip-resistor-surface-mount_uni-royal-uniroyal-elec-0603waf1002t5e_C25804.html) | PDF (https://www.lcsc.com/datasheet/lcsc_datasheet_2206010045_UNI-ROYAL-Uniroyal-Elec-0603WAF1002T5E_C25804.pdf) | 10k | -55℃~+155℃ 100mW 10kΩ 75V Thick Film Resistor ±1% ±100ppm/℃ 0603 Chip Resistor - Surface Mount ROHS | value and package from the schematic; 1% thick film, JLC Basic where one exists
15 | R3 R32 R40 | 3 |  | resistor 620k ohm 1 % (0603) | UNI-ROYAL(Uniroyal Elec) | 0603WAF6203T5E | C23219 | Extended | $0.0020 |  | 93537 | 0603 | bottom/top | JLC | JLC (https://jlcpcb.com/partdetail/23946-0603WAF6203T5E/C23219) | LCSC (https://www.lcsc.com/product-detail/chip-resistor-surface-mount_uni-royal-uniroyal-elec-0603waf6203t5e_C23219.html) | PDF (https://www.lcsc.com/datasheet/lcsc_datasheet_2206010116_UNI-ROYAL-Uniroyal-Elec-0603WAF6203T5E_C23219.pdf) | 620k | -55℃~+155℃ 100mW 620kΩ 75V Thick Film Resistor ±1% ±100ppm/℃ 0603 Chip Resistor - Surface Mount ROHS | value and package from the schematic; 1% thick film, JLC Basic where one exists
16 | R4 R54 R55 R58 R71 R99 R102 | 7 |  | resistor 1k ohm 1 % (0603) | UNI-ROYAL(Uniroyal Elec) | 0603WAF1001T5E | C21190 | Basic | $0.0026 |  | 21672207 | 0603 | bottom/top | JLC | JLC (https://jlcpcb.com/partdetail/21904-0603WAF1001T5E/C21190) | LCSC (https://www.lcsc.com/product-detail/chip-resistor-surface-mount_uni-royal-uniroyal-elec-0603waf1001t5e_C21190.html) | PDF (https://www.lcsc.com/datasheet/lcsc_datasheet_2206010130_UNI-ROYAL-Uniroyal-Elec-0603WAF1001T5E_C21190.pdf) | 1k | -55℃~+155℃ 100mW 1kΩ 75V Thick Film Resistor ±1% ±100ppm/℃ 0603 Chip Resistor - Surface Mount ROHS | value and package from the schematic; 1% thick film, JLC Basic where one exists
17 | R8 R34 R42 R51 R63 R78 R80 | 7 |  | resistor 2k ohm 1 % (0603) | UNI-ROYAL(Uniroyal Elec) | 0603WAF2001T5E | C22975 | Basic | $0.0024 |  | 13572776 | 0603 | bottom/top | JLC | JLC (https://jlcpcb.com/partdetail/23702-0603WAF2001T5E/C22975) | LCSC (https://www.lcsc.com/product-detail/chip-resistor-surface-mount_uni-royal-uniroyal-elec-0603waf2001t5e_C22975.html) | PDF (https://www.lcsc.com/datasheet/lcsc_datasheet_2206010116_UNI-ROYAL-Uniroyal-Elec-0603WAF2001T5E_C22975.pdf) | 2k | -55℃~+155℃ 100mW 2kΩ 75V Thick Film Resistor ±1% ±100ppm/℃ 0603 Chip Resistor - Surface Mount ROHS | value and package from the schematic; 1% thick film, JLC Basic where one exists
18 | R9 R35 R43 | 3 |  | resistor 18k ohm 1 % (0805) | UNI-ROYAL(Uniroyal Elec) | 0805W8F1802T5E | C17506 | Extended (preferred) | $0.0043 |  | 194888 | 0805 | bottom/top | JLC | JLC (https://jlcpcb.com/partdetail/18194-0805W8F1802T5E/C17506) | LCSC (https://www.lcsc.com/product-detail/chip-resistor-surface-mount_uni-royal-uniroyal-elec-0805w8f1802t5e_C17506.html) | PDF (https://www.lcsc.com/datasheet/lcsc_datasheet_2206010216_UNI-ROYAL-Uniroyal-Elec-0805W8F1802T5E_C17506.pdf) | 18k | -55℃~+155℃ 125mW 150V 18kΩ Thick Film Resistor ±1% ±100ppm/℃ 0805 Chip Resistor - Surface Mount ROHS | value and package from the schematic; 1% thick film, JLC Basic where one exists
19 | R11 R17 | 2 |  | resistor 510k ohm 1 % (0603) | UNI-ROYAL(Uniroyal Elec) | 0603WAF5103T5E | C23192 | Basic | $0.0024 |  | 894332 | 0603 | bottom | JLC | JLC (https://jlcpcb.com/partdetail/23919-0603WAF5103T5E/C23192) | LCSC (https://www.lcsc.com/product-detail/chip-resistor-surface-mount_uni-royal-uniroyal-elec-0603waf5103t5e_C23192.html) | PDF (https://www.lcsc.com/datasheet/lcsc_datasheet_2206010116_UNI-ROYAL-Uniroyal-Elec-0603WAF5103T5E_C23192.pdf) | 510k | -55℃~+155℃ 100mW 510kΩ 75V Thick Film Resistor ±1% ±100ppm/℃ 0603 Chip Resistor - Surface Mount ROHS | value and package from the schematic; 1% thick film, JLC Basic where one exists
20 | R16 R19 | 2 |  | resistor 5.1k ohm 1 % (0603) | UNI-ROYAL(Uniroyal Elec) | 0603WAF5101T5E | C23186 | Basic | $0.0015 |  | 25280385 | 0603 | bottom/top | JLC | JLC (https://jlcpcb.com/partdetail/23913-0603WAF5101T5E/C23186) | LCSC (https://www.lcsc.com/product-detail/chip-resistor-surface-mount_uni-royal-uniroyal-elec-0603waf5101t5e_C23186.html) | PDF (https://www.lcsc.com/datasheet/lcsc_datasheet_2206010116_UNI-ROYAL-Uniroyal-Elec-0603WAF5101T5E_C23186.pdf) | 5.1k | -55℃~+155℃ 100mW 5.1kΩ 75V Thick Film Resistor ±1% ±100ppm/℃ 0603 Chip Resistor - Surface Mount ROHS | value and package from the schematic; 1% thick film, JLC Basic where one exists
21 | R18 R20 | 2 |  | resistor 200k ohm 1 % (0603) | UNI-ROYAL(Uniroyal Elec) | 0603WAF2003T5E | C25811 | Basic | $0.0023 |  | 2473796 | 0603 | bottom | JLC | JLC (https://jlcpcb.com/partdetail/26554-0603WAF2003T5E/C25811) | LCSC (https://www.lcsc.com/product-detail/chip-resistor-surface-mount_uni-royal-uniroyal-elec-0603waf2003t5e_C25811.html) | PDF (https://www.lcsc.com/datasheet/lcsc_datasheet_2206010045_UNI-ROYAL-Uniroyal-Elec-0603WAF2003T5E_C25811.pdf) | 200k | -55℃~+155℃ 100mW 200kΩ 75V Thick Film Resistor ±1% ±100ppm/℃ 0603 Chip Resistor - Surface Mount ROHS | value and package from the schematic; 1% thick film, JLC Basic where one exists
22 | R25 R87 R94 | 3 |  | resistor 910k ohm 1 % (0805) | UNI-ROYAL(Uniroyal Elec) | 0805W8F9103T5E | C17864 | Extended | $0.0034 |  | 15984 | 0805 | bottom/top | JLC | JLC (https://jlcpcb.com/partdetail/18552-0805W8F9103T5E/C17864) | LCSC (https://www.lcsc.com/product-detail/chip-resistor-surface-mount_uni-royal-uniroyal-elec-0805w8f9103t5e_C17864.html) | PDF (https://www.lcsc.com/datasheet/lcsc_datasheet_2206010200_UNI-ROYAL-Uniroyal-Elec-0805W8F9103T5E_C17864.pdf) | 910k | -55℃~+155℃ 125mW 150V 910kΩ Thick Film Resistor ±1% ±100ppm/℃ 0805 Chip Resistor - Surface Mount ROHS | value and package from the schematic; 1% thick film, JLC Basic where one exists; Vout dividers: 150 V rated
23 | R26 R64 R79 R81 | 4 |  | resistor 220 ohm 1 % (0603) | UNI-ROYAL(Uniroyal Elec) | 0603WAF2200T5E | C22962 | Basic | $0.0035 |  | 1903983 | 0603 | bottom/top | JLC | JLC (https://jlcpcb.com/partdetail/23689-0603WAF2200T5E/C22962) | LCSC (https://www.lcsc.com/product-detail/chip-resistor-surface-mount_uni-royal-uniroyal-elec-0603waf2200t5e_C22962.html) | PDF (https://www.lcsc.com/datasheet/lcsc_datasheet_2206010130_UNI-ROYAL-Uniroyal-Elec-0603WAF2200T5E_C22962.pdf) | 220 | -55℃~+155℃ 100mW 220Ω 75V Thick Film Resistor ±1% ±100ppm/℃ 0603 Chip Resistor - Surface Mount ROHS | value and package from the schematic; 1% thick film, JLC Basic where one exists
24 | R27 R37 R45 R106 R107 | 5 |  | resistor 4.7k ohm 1 % (0603) | UNI-ROYAL(Uniroyal Elec) | 0603WAF4701T5E | C23162 | Basic | $0.0028 |  | 22492816 | 0603 | bottom/top | JLC | JLC (https://jlcpcb.com/partdetail/23889-0603WAF4701T5E/C23162) | LCSC (https://www.lcsc.com/product-detail/chip-resistor-surface-mount_uni-royal-uniroyal-elec-0603waf4701t5e_C23162.html) | PDF (https://www.lcsc.com/datasheet/lcsc_datasheet_2206010116_UNI-ROYAL-Uniroyal-Elec-0603WAF4701T5E_C23162.pdf) | 4.7k | -55℃~+155℃ 100mW 4.7kΩ 75V Thick Film Resistor ±1% ±100ppm/℃ 0603 Chip Resistor - Surface Mount ROHS | value and package from the schematic; 1% thick film, JLC Basic where one exists
25 | R28 R36 R38 R44 R46 R88 R91 R95 R96 R105 | 10 |  | resistor 100k ohm 1 % (0603) | UNI-ROYAL(Uniroyal Elec) | 0603WAF1003T5E | C25803 | Basic | $0.0031 |  | 22167984 | 0603 | bottom/top | JLC | JLC (https://jlcpcb.com/partdetail/26546-0603WAF1003T5E/C25803) | LCSC (https://www.lcsc.com/product-detail/chip-resistor-surface-mount_uni-royal-uniroyal-elec-0603waf1003t5e_C25803.html) | PDF (https://www.lcsc.com/datasheet/lcsc_datasheet_2206010045_UNI-ROYAL-Uniroyal-Elec-0603WAF1003T5E_C25803.pdf) | 100k | -55℃~+155℃ 100kΩ 100mW 75V Thick Film Resistor ±1% ±100ppm/℃ 0603 Chip Resistor - Surface Mount ROHS | value and package from the schematic; 1% thick film, JLC Basic where one exists
26 | R29 R30 R57 | 3 |  | resistor 22k ohm 1 % (0805) | UNI-ROYAL(Uniroyal Elec) | 0805W8F2202T5E | C17560 | Basic | $0.0048 |  | 1746324 | 0805 | top | JLC | JLC (https://jlcpcb.com/partdetail/18248-0805W8F2202T5E/C17560) | LCSC (https://www.lcsc.com/product-detail/chip-resistor-surface-mount_uni-royal-uniroyal-elec-0805w8f2202t5e_C17560.html) | PDF (https://www.lcsc.com/datasheet/lcsc_datasheet_2206010200_UNI-ROYAL-Uniroyal-Elec-0805W8F2202T5E_C17560.pdf) | 22k | -55℃~+155℃ 125mW 150V 22kΩ Thick Film Resistor ±1% ±100ppm/℃ 0805 Chip Resistor - Surface Mount ROHS | value and package from the schematic; 1% thick film, JLC Basic where one exists
27 | R65 | 1 |  | resistor 22k ohm 1 % (0603) | UNI-ROYAL(Uniroyal Elec) | 0603WAF2202T5E | C31850 | Basic | $0.0041 |  | 3706362 | 0603 | top | JLC | JLC (https://jlcpcb.com/partdetail/32812-0603WAF2202T5E/C31850) | LCSC (https://www.lcsc.com/product-detail/chip-resistor-surface-mount_uni-royal-uniroyal-elec-0603waf2202t5e_C31850.html) | PDF (https://www.lcsc.com/datasheet/lcsc_datasheet_2206010030_UNI-ROYAL-Uniroyal-Elec-0603WAF2202T5E_C31850.pdf) | 22k | -55℃~+155℃ 100mW 22kΩ 75V Thick Film Resistor ±1% ±100ppm/℃ 0603 Chip Resistor - Surface Mount ROHS | value and package from the schematic; 1% thick film, JLC Basic where one exists
28 | R66 R89 R92 R97 | 4 |  | resistor 3.3k ohm 1 % (0603) | UNI-ROYAL(Uniroyal Elec) | 0603WAF3301T5E | C22978 | Basic | $0.0026 |  | 5696130 | 0603 | bottom/top | JLC | JLC (https://jlcpcb.com/partdetail/23705-0603WAF3301T5E/C22978) | LCSC (https://www.lcsc.com/product-detail/chip-resistor-surface-mount_uni-royal-uniroyal-elec-0603waf3301t5e_C22978.html) | PDF (https://www.lcsc.com/datasheet/lcsc_datasheet_2206010116_UNI-ROYAL-Uniroyal-Elec-0603WAF3301T5E_C22978.pdf) | 3.3k | -55℃~+155℃ 100mW 3.3kΩ 75V Thick Film Resistor ±1% ±100ppm/℃ 0603 Chip Resistor - Surface Mount ROHS | value and package from the schematic; 1% thick film, JLC Basic where one exists
29 | R68 | 1 |  | resistor 62k ohm 1 % (0603) | UNI-ROYAL(Uniroyal Elec) | 0603WAF6202T5E | C23221 | Extended (preferred) | $0.0028 |  | 418136 | 0603 | top | JLC | JLC (https://jlcpcb.com/partdetail/23948-0603WAF6202T5E/C23221) | LCSC (https://www.lcsc.com/product-detail/chip-resistor-surface-mount_uni-royal-uniroyal-elec-0603waf6202t5e_C23221.html) | PDF (https://www.lcsc.com/datasheet/lcsc_datasheet_2206010116_UNI-ROYAL-Uniroyal-Elec-0603WAF6202T5E_C23221.pdf) | 62k | -55℃~+155℃ 100mW 62kΩ 75V Thick Film Resistor ±1% ±100ppm/℃ 0603 Chip Resistor - Surface Mount ROHS | value and package from the schematic; 1% thick film, JLC Basic where one exists
30 | R69 | 1 |  | resistor 20k ohm 1 % (0603) | UNI-ROYAL(Uniroyal Elec) | 0603WAF2002T5E | C4184 | Basic | $0.0023 |  | 8044733 | 0603 | top | JLC | JLC (https://jlcpcb.com/partdetail/4591-0603WAF2002T5E/C4184) | LCSC (https://www.lcsc.com/product-detail/chip-resistor-surface-mount_uni-royal-uniroyal-elec-0603waf2002t5e_C4184.html) | PDF (https://www.lcsc.com/datasheet/lcsc_datasheet_2206010230_UNI-ROYAL-Uniroyal-Elec-0603WAF2002T5E_C4184.pdf) | 20k | -55℃~+155℃ 100mW 20kΩ 75V Thick Film Resistor ±1% ±100ppm/℃ 0603 Chip Resistor - Surface Mount ROHS | value and package from the schematic; 1% thick film, JLC Basic where one exists
31 | R82 | 1 |  | resistor 56k ohm 1 % (0603) | UNI-ROYAL(Uniroyal Elec) | 0603WAF5602T5E | C23206 | Basic | $0.0027 |  | 1026495 | 0603 | top | JLC | JLC (https://jlcpcb.com/partdetail/23933-0603WAF5602T5E/C23206) | LCSC (https://www.lcsc.com/product-detail/chip-resistor-surface-mount_uni-royal-uniroyal-elec-0603waf5602t5e_C23206.html) | PDF (https://www.lcsc.com/datasheet/lcsc_datasheet_2206010116_UNI-ROYAL-Uniroyal-Elec-0603WAF5602T5E_C23206.pdf) | 56k | -55℃~+155℃ 100mW 56kΩ 75V Thick Film Resistor ±1% ±100ppm/℃ 0603 Chip Resistor - Surface Mount ROHS | value and package from the schematic; 1% thick film, JLC Basic where one exists
32 | R84 | 1 |  | resistor 120k ohm 1 % (0603) | UNI-ROYAL(Uniroyal Elec) | 0603WAF1203T5E | C25808 | Basic | $0.0015 |  | 1007305 | 0603 | bottom | JLC | JLC (https://jlcpcb.com/partdetail/26551-0603WAF1203T5E/C25808) | LCSC (https://www.lcsc.com/product-detail/chip-resistor-surface-mount_uni-royal-uniroyal-elec-0603waf1203t5e_C25808.html) | PDF (https://www.lcsc.com/datasheet/lcsc_datasheet_2206010045_UNI-ROYAL-Uniroyal-Elec-0603WAF1203T5E_C25808.pdf) | 120k | -55℃~+155℃ 100mW 120kΩ 75V Thick Film Resistor ±1% ±100ppm/℃ 0603 Chip Resistor - Surface Mount ROHS | value and package from the schematic; 1% thick film, JLC Basic where one exists
33 | R86 | 1 |  | resistor 1M ohm 1 % (0805) | UNI-ROYAL(Uniroyal Elec) | 0805W8F1004T5E | C17514 | Basic | $0.0043 |  | 2420510 | 0805 | top | JLC | JLC (https://jlcpcb.com/partdetail/18202-0805W8F1004T5E/C17514) | LCSC (https://www.lcsc.com/product-detail/chip-resistor-surface-mount_uni-royal-uniroyal-elec-0805w8f1004t5e_C17514.html) | PDF (https://www.lcsc.com/datasheet/lcsc_datasheet_2206010200_UNI-ROYAL-Uniroyal-Elec-0805W8F1004T5E_C17514.pdf) | 1M | -55℃~+155℃ 125mW 150V 1MΩ Thick Film Resistor ±1% ±100ppm/℃ 0805 Chip Resistor - Surface Mount ROHS | value and package from the schematic; 1% thick film, JLC Basic where one exists
34 | R90 R93 R98 | 3 |  | resistor 10M ohm 1 % (0603) | UNI-ROYAL(Uniroyal Elec) | 0603WAF1005T5E | C7250 | Basic | $0.0037 |  | 297135 | 0603 | bottom/top | JLC | JLC (https://jlcpcb.com/partdetail/7726-0603WAF1005T5E/C7250) | LCSC (https://www.lcsc.com/product-detail/chip-resistor-surface-mount_uni-royal-uniroyal-elec-0603waf1005t5e_C7250.html) | PDF (https://www.lcsc.com/datasheet/lcsc_datasheet_2206010216_UNI-ROYAL-Uniroyal-Elec-0603WAF1005T5E_C7250.pdf) | 10M | -55℃~+155℃ 100mW 10MΩ 75V Thick Film Resistor ±1% ±100ppm/℃ 0603 Chip Resistor - Surface Mount ROHS | value and package from the schematic; 1% thick film, JLC Basic where one exists
35 | U2 U4 U5 U14 U21 | 5 |  | comparator, push-pull, 56 ns | Microchip Tech | MCP6561T-E/OT | C117501 | Extended | $0.7430 |  | 4005 | SOT-23-5 | bottom/top | JLC | JLC (https://jlcpcb.com/partdetail/MicrochipTech-MCP6561T_EOT/C117501) | LCSC (https://www.lcsc.com/product-detail/comparators_microchip-tech-mcp6561t-e-ot_C117501.html) | PDF (https://www.lcsc.com/datasheet/lcsc_datasheet_2304140030_Microchip-Tech-MCP6561T-E-OT_C117501.pdf) | MCP6561 | -40℃~+125℃ 1 1.8V~5.5V 100uA 1pA 1pA 2.5mV 20ns 2uV/℃ 3mV 56ns 6.5V 66dB ESD protection、Built-in hysteresis Push-pull Rail-to-rail input TTL、CMOS SOT-23-5 Comparators ROHS | the device named in the schematic or the notes
36 | U3 U7 U13 U22 U23 U24 | 6 |  | op-amp, rail-to-rail, 1 MHz | Texas Instruments | TLV9001IDBVR | C398363 | Extended | $0.0979 |  | 48438 | SOT-23-5 | bottom/top | JLC | JLC (https://jlcpcb.com/partdetail/TexasInstruments-TLV9001IDBVR/C398363) | LCSC (https://www.lcsc.com/product-detail/operational-amplifier_texas-instruments-tlv9001idbvr_C398363.html) | PDF (https://www.lcsc.com/datasheet/lcsc_datasheet_2410010130_Texas-Instruments-TLV9001IDBVR_C398363.pdf) | TLV9001 | -2.75V~-900mV、900mV~2.75V -40℃~+125℃ 1 1.6mV 1.8V~5.5V 1MHz 2V/us 2pA 4.7nV/√Hz@1kHz 40mA 5pA 600nV/℃ 60uA 86dB Enable/shutdown function、EMI filtering/RF suppression Rail-to-Rail Input, Rail-to-Rail Output SOT-23-5 Operational Amplifier ROHS | approved 2026-10-01: TI TLV9001IDBVR (the DBV part: pins 1 OUT, 2 V-, 3 IN+, 4 IN-, 5 V+, as the MCP6241; NOT the TLV9001U). 1 MHz, 2 V/us, 1.6 mV max offset. LTspice re-runs (30 ms, 25 % PWM, cold start) match the MCP6241 within 0.05 % Alternates: C49889 MCP6241T-E/OT (before 2026-10-01)
37 | U18 | 1 |  | decade counter (CMOS 4017) | Texas Instruments | CD4017BM96 | C11349 | Extended | $0.7267 |  | 18267 | SOIC-16 | top | JLC | JLC (https://jlcpcb.com/partdetail/TexasInstruments-CD4017BM96/C11349) | LCSC (https://www.lcsc.com/product-detail/counters-dividers_texas-instruments-cd4017bm96_C11349.html) | PDF (https://www.lcsc.com/datasheet/lcsc_datasheet_1809042113_Texas-Instruments-CD4017BM96_C11349.pdf) | CD4017B | -55℃~+125℃ 1 135ns 3V~18V 5.5MHz Asynchronous Divide-by-10 Rising Edge Up Counter SOIC-16 Counters, Dividers ROHS | the device named in the schematic or the notes
38 | U26 | 1 |  | quad digital potentiometer 10 kOhm, I2C | Microchip Tech | MCP4451-103E/ST | C145613 | Extended | $2.9051 |  | 40 | TSSOP-20 | bottom | JLC | JLC (https://jlcpcb.com/partdetail/MicrochipTech-MCP4451_103EST/C145613) | LCSC (https://www.lcsc.com/product-detail/digital-potentiometers_microchip-tech-mcp4451-103e-st_C145613.html) | PDF (https://www.lcsc.com/datasheet/lcsc_datasheet_1811082132_Microchip-Tech-MCP4451-103E-ST_C145613.pdf) | MCP4451-103E/ST | -40℃~+125℃ 1.8V~5.5V 10kΩ 1MHz 2.5uA 257 4 50ppm/℃ 75Ω I2C Linear Power-on reset RAM ±20% TSSOP-20 Digital Potentiometers ROHS | part chosen earlier (HANDOFF_SUMMARY / replace_notes / ANSWERS); STOCK 52
39 | U28 | 1 |  | 8-channel analog multiplexer | Nexperia | 74HC4051D,653 | C9386 | Extended | $0.2146 |  | 33472 | SOIC-16 | top | JLC | JLC (https://jlcpcb.com/partdetail/Nexperia-74HC4051D653/C9386) | LCSC (https://www.lcsc.com/product-detail/analog-switches-multiplexers_nexperia-74hc4051d-653_C9386.html) | PDF (https://www.lcsc.com/datasheet/lcsc_datasheet_2410121924_Nexperia-74HC4051D-653_C9386.pdf) | 74HC4051 | -40℃~+125℃ 1 29ns 2V~10V 31ns 5ns 80Ω 8:1 SOIC-16 Analog Switches, Multiplexers ROHS | the device named in the schematic or the notes
40 | U101 U102 U103 | 3 |  | quad 2-input NAND gate | Nexperia | 74HC00D,653 | C5586 | Extended | $0.1546 |  | 8289 | SOIC-14 | top | JLC | JLC (https://jlcpcb.com/partdetail/Nexperia-74HC00D653/C5586) | LCSC (https://www.lcsc.com/product-detail/logic-gates_nexperia-74hc00d-653_C5586.html) | PDF (https://www.lcsc.com/datasheet/lcsc_datasheet_2407241044_Nexperia-74HC00D-653_C5586.pdf) | 74HC00 | -40℃~+125℃ 1.5V、3.15V、4.2V 1.9V、3.7V、5.9V 100mV、400mV、400mV 2 2V~6V 4 40uA 5.2mA 5.2mA 500mV~1.8V 74HC Series 7ns@6V,50pF NAND Gate SOIC-14 Logic Gates ROHS | the device named in the schematic or the notes
41 | U104 U105 | 2 |  | hex Schmitt-trigger inverter | Nexperia | 74HC14D,653 | C5605 | Basic | $0.1023 |  | 206540 | SOIC-14 | bottom/top | JLC | JLC (https://jlcpcb.com/partdetail/Nexperia-74HC14D653/C5605) | LCSC (https://www.lcsc.com/product-detail/inverters_nexperia-74hc14d-653_C5605.html) | PDF (https://www.lcsc.com/datasheet/lcsc_datasheet_2407241044_Nexperia-74HC14D-653_C5605.pdf) | 74HC14 | -40℃~+125℃ 1 1.5V~4.2V 21ns@6V,50pF 2V~6V 2uA 300mV~1.2V 5.2mA 5.2mA 6 74HC Schmitt trigger SOIC-14 Inverters ROHS | the device named in the schematic or the notes
42 | U106 | 1 |  | quad analog switch | Texas Instruments | CD74HC4066M96 | C179842 | Extended | $0.6097 |  | 73 | SOIC-14 | bottom | JLC | JLC (https://jlcpcb.com/partdetail/TexasInstruments-CD74HC4066M96/C179842) | LCSC (https://www.lcsc.com/product-detail/analog-switches-multiplexers_texas-instruments-cd74hc4066m96_C179842.html) | PDF (https://www.lcsc.com/datasheet/lcsc_datasheet_1912111437_Texas-Instruments-CD74HC4066M96_C179842.pdf) | CD74HC4066 | -55℃~+125℃ 12ns 1:1 200MHz 24ns 25Ω 2V~10V 35ns 4 5pF Bidirectional analog channel SOIC-14 Analog Switches, Multiplexers ROHS | the device named in the schematic or the notes; STOCK 73
 | Parts total (JLC lines, 2 boards + attrition)
 | Parts you buy or own (priced lines)
 | Unique JLC part numbers (feeder loading $1.53 each) |  |  |  |  |  |  |  |  | 41

Sheet: Bought elsewhere
Item | Role | Qty | Unit (USD) | Cost (USD) | Vendor / source | Checked | Link | Notes
Samtec ESQ-115-44-G-D, J10 socket (power board) | J10 / J11 board-to-board connector | 2 | $9.1300 |  | Mouser, as listed on samtec.com | read on samtec.com | link (https://www.samtec.com/products/esq-115-44-g-d)
Samtec TSW-115-07-G-D, J11 header (card) | J10 / J11 board-to-board connector | 2 | $3.1800 |  | Mouser, as listed on samtec.com | read on samtec.com | link (https://www.samtec.com/products/tsw-115-07-g-d)
Bourns MF-R050 PTC, 0.50 A hold (inline on the J9 pin-9 wire), LCSC C208476 | J9 pin-9 fuse (inline) | 2 | $0.1433 |  | LCSC (its own order; JLC does not ship loose parts) | read 2026-09-30 (7,030 in stock); derating from the Bourns MF-R datasheet | link (https://www.lcsc.com/product-detail/C208476.html)
McMaster-Carr 92000A107, M2.5 x 12 pan head Phillips, 18-8 stainless, pack of 100 | FET tab screws (4 per set) | 1 pack |  | $5.65 | mcmaster.com | read | link (https://www.mcmaster.com/92000A107/)
McMaster-Carr 93657A200, nylon 6/6 spacer, M2.5, 2.0 mm long, 4.5 mm OD | FET tab-screw gap spacer (4 per set) | 8 |  | $7.36 | mcmaster.com ($0.92 each under 10) | read | link (https://www.mcmaster.com/93657A200/)
Boyd (Aavid) 7721-7PPSG shoulder washer, glass-filled PPS | insulates each tab screw in the FET tab hole (4 per set) | 8 |  | $1.31 | Digi-Key $0.164 at 5+ (10 for $1.51) | read by you 2026-09-25 | link (https://www.digikey.com/en/products/result?keywords=7721-7PPSG)
McMaster-Carr 92605A109, M3 x 20 mm set screw, 18-8 stainless, flat tip, pack of 25 | floor stud, part 1: threaded 6 mm into the floor (4 per set) | 1 pack |  | $10.69 | mcmaster.com | read | link (https://www.mcmaster.com/92605A109/)
McMaster-Carr 94669A099, aluminium unthreaded spacer, M3, 5.00 +/-0.13 mm long, 4.5 mm OD | floor stud, part 2: sets the board height with the washer (4 per set; buy 10 to select 8) | 10 |  | $5.00 | mcmaster.com ($0.50 each) | read | link (https://www.mcmaster.com/94669A099/)
Essentra HNSM3-20-5.5-1, nylon hex standoff M3 female-female, 20 mm | board-to-card standoff (4 per set) | 8 |  | $11.33 | Digi-Key $1.416 at 5+ (10 for $13.22) | read by you 2026-09-25 | link (https://www.digikey.com/en/products/detail/essentra-components/HNSM3-20-5-5-1/3813076)
TR Fastenings TR NWE-34815-M3, nylon 6/6 washer 3.2 x 7.0 x 0.5 mm, pack of 100 | standoff shims (16 per set) | 1 pack |  | $11.67 | Farnell UK 8.71 GBP, converted at 1.34 USD/GBP | price via search; conversion assumed | link (https://www.newark.com/tr-fastenings/tr-nwe-34815-m3/washer-nylon-6-6-3-2mm-pk100/dp/43Y4267) | GBP price converted at 1.34 USD/GBP
Wurth Elektronik 97790803211, WA-SCRW M3 x 8 nylon 66 pan head | card screws (4 per set) | 8 |  | $2.13 | Farnell UK 0.199 GBP each, converted at 1.34 USD/GBP | price via search; conversion assumed | link (https://www.we-online.com/en/components/products/WA-SCRW) | GBP price converted at 1.34 USD/GBP
McMaster-Carr 1272N32, 3 W/m-K silicone, 0.060 in (1.52 mm), 4 x 4 in | FET thermal pads (cut 10 x 16 mm, 20 pads) | 1 |  | $26.91 | mcmaster.com | read 2026-09-25 | link (https://www.mcmaster.com/1272N32/) | Default pad. Alternatives: Parker G579 $128.75; t-Global TG-AD30 (price not read). See COST_SUMMARY.md
Total bought elsewhere (with the McMaster pad)
Prices are the 2026-09-25 readings except the PTC (read 2026-09-30). Shipping and tax not included.

Sheet: Fees
Item | Power board | Control card | Notes
Bare PCBs (5 of each), JLC quote 2026-10-01 | $69.57 | $56.83 | Power: 6 layers, stackup JLC061611-7628D, 74 x 86 mm, 5 single boards, ENIG, 1 oz inner, TG155, filled & capped vias. Card: 6 layers, 5 panels of one 45 x 45 mm card on a 70 x 70 mm carrier, ENIG, 0.5 oz inner, TG155.
Assembly set-up (double-sided, Standard PCBA) | $51.12 | $51.12 | JLC price page: $25.56 single-side, $51.12 double-side
Stencil (double-sided) | $16.42 | $16.42 | $8.21 single-side, $16.42 double-side
Feeder loading ($1.53 per unique part) |  |  | Basic or Extended, Standard PCBA
Solder joints ($0.0016 each) | $0.91 | $1.52 | 566 / 952 joints for 2 boards
JLC parts (2 boards + attrition) |  |  | from the board sheets
Order total (PCBs + assembly) |  |  | Shipping and tax not included

Sheet: Ways to save
Option | Saves (USD, this build) | What it takes | Verdict
Applied
Control card 8 -> 6 layers (2026-09-30) | $63.47 | card panel $137.04 -> $73.57 | applied
220 uF output caps: EEH-ZS1H221P (C385885) on C70, C71, C75, C77, C78, C88; EEH-ZU1H221P stays on C74, C86, C87 | $12.89 | also cleared the ZU stock shortage (14 in stock, now 6 needed) | applied
Card inner copper 0.5 oz | $16.74 | card panel $73.57 -> $56.83; stackup now 1.547 mm (JLC 6-layer 1/0.5 oz build); Gerber layers unchanged | applied
12 V regulator U16: onsemi MC7812BD2TR4G (C231294) for the TI LM2940S-12/NOPB | $8.10 | your choice, 2026-10-01. Same TO-263 footprint; the gerbers do not change. About 1.5 V dropout: at the end of a 4S discharge the LEDs fade from about 12.7 V open-circuit instead of 11.3 V (simulated, `mc7812_lowbatt_2026-10-01`). Its lower bias current makes it run about 2 C cooler than the LM2940 at 18 V; it also cleared the LM2940 stock problem (2 in stock) | applied
Power board: 6 layers instead of 8 | $54.53 | your choice, 2026-10-01/02: $124.10 -> $69.57. The 5 V plane (In4) and the second GND plane (In6) are gone, 5 V is routed as tracks, and the GND pours, vias and two gate-drive routes were reworked. Stackup JLC061611-7628D (must be specified at order). Copper solve, loop inductance, M1 turn-off and U16 thermal re-checked (`power6_2026-10-01/README.md`) | applied
Op-amps: TI TLV9001IDBVR for the 18 MCP6241 (same SOT-23-5 pinout) | $8.78 | LTspice re-runs against the MCP6241 (30 ms full power, 25 % PWM, cold start to 140 ms): LED currents, LX, TVS energy and servo levels match within 0.05 % | applied
Still open (your choice)
Samtec J10/J11 through Samtec's free-sample program | $24.62 | Needs a Samtec account (your choice). A generic header pair would need the exact stack height re-checked. | Worth asking Samtec
Ordering | shipping | Pay both JLC orders together so they ship as one parcel; JLC's JLCONE desktop app advertises $1-20 off per order; check the coupons in your JLC account. | Do it
Looked at, no good cheaper alternative (kept)
Comparators MCP6561 ($0.74 x 10): the cheaper parts are slower (Linearin LTC8721: 66-155 ns, 85 C), run hotter on supply current (Tokmas CSGM8743: 1.3 mA, 85 C) or save only $1.74 in all (3PEAK TP1961). TI TLV3201 costs more.
Digital pot MCP4451-103 ($2.91): already the cheapest 10 kOhm quad of its family; the 50 kOhm versions would change the current-setting network, the 7-bit MCP4441 is QFN and dearer.
L78L05 5 V regulators ($0.102 x 4): the clones cost $0.03-0.05, but under $0.10 JLC adds about 20 attrition spares per line, so the line costs more. Loads 8 mA and 3 mA (simulated).
12 V regulator, other options: the SOT-223 LM2940s (UTC $0.24, TI $1.68) run too hot at 75 C case air (`u16_thermal_2026-10-01`); Microchip MIC2940A-12WU-TR ($2.60, a true LDO in the same TO-263 footprint) is the fall-back if the low-battery fade ever matters; ST L4940 is rated for only 17 V in.
Card FR4 TG135 (-$3.43): you chose to keep TG155.
OSP finish (-$34.50): shelf life and hand soldering after two reflows.
One-sided assembly: parts on both sides of both boards.
INA240A3 for INA241A4: slower and an 80 V limit.
