ChristopherCa55/led-driver/BOOST_split_boards/review_fixes_2026-10-11/work/step05g_completion/csv_before/bom_preview.png

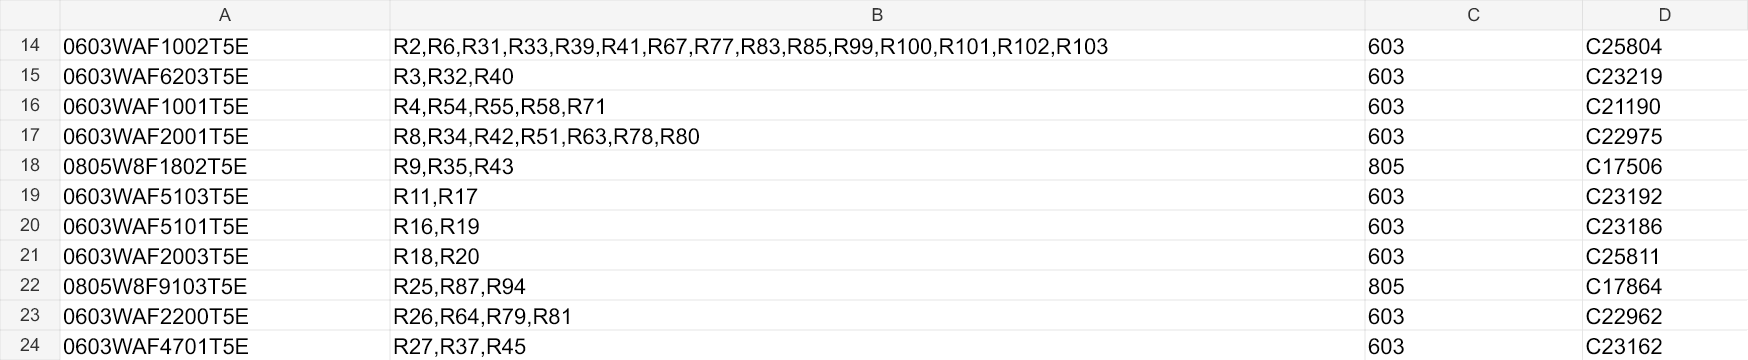
BOOST_split_boards/review_fixes_2026-10-11/work/step05g_completion/csv_before/bom_preview.png
