ChristopherCa55/led-driver/BOOST_package/BOOST_assembly_2026-10-02.step

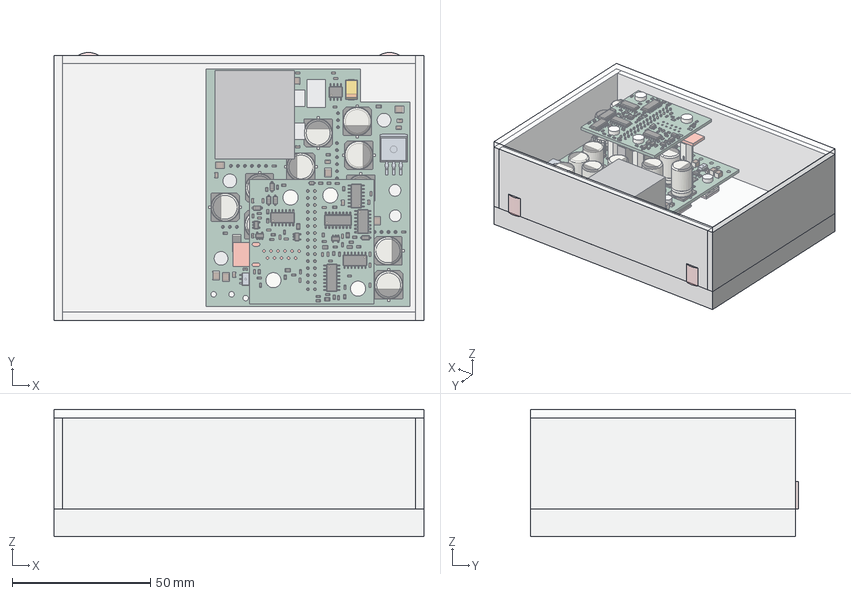
[picture p158: CAD file, 2026-10-03]
BOOST_package/BOOST_assembly_2026-10-02.step
134.0 x 96.9 x 46.0 mm
CP_Elec_10x14.3 x 9
R_0603_1608Metric x 79
C_0603_1608Metric x 61
SOT-23-5 x 14
C_1210_3225Metric x 10
R_2512_6332Metric x 3
C_0805_2012Metric x 11
SOIC-8_3.9x4.9mm_P1.27mm
power 1.20.1 x 2
power 1.24.1
CP_Elec_10x12.5 x 3
R_0805_2012Metric x 18
CP_EIA-7343-31_Kemet-D
D_SOD-123 x 19
C_1206_3216Metric x 6
SOIC-16W_7.5x10.3mm_P1.27mm x 4
TO-220-3_Horizontal_TabUp x 10
D_SOD-123F x 3
D_SMC
BOOST_power_RC2_PCB
SOIC-16_3.9x9.9mm_P1.27mm x 2
SOIC-14_3.9x8.7mm_P1.27mm x 6
D_SOD-323 x 3
SOT-23
TSSOP-20_4.4x6.5mm_P0.65mm
BOOST_control_RC2_PCB
H5 stud HTSN-M3-5-3 (hex 6 AF x 5.0)
H5 stud thread M3 (length ASSUMED 5 mm above the hex)
H5 washer TR NWE-34815-M3 (7.0 / 3.2 x 0.5)
H5 female-female HNSM3-20-5.5-1 (hex 5.5 AF x 20)
H5 washers 3 x TR NWE-34815-M3
H5 card screw 97790803211 head (5.5 x 2.1)
H5 card screw shank M3 x 8
H6 stud HTSN-M3-5-3 (hex 6 AF x 5.0)
H6 stud thread M3 (length ASSUMED 5 mm above the hex)
H6 washer TR NWE-34815-M3 (7.0 / 3.2 x 0.5)
H6 female-female HNSM3-20-5.5-1 (hex 5.5 AF x 20)
H6 washers 3 x TR NWE-34815-M3
H6 card screw 97790803211 head (5.5 x 2.1)
H6 card screw shank M3 x 8
H7 stud HTSN-M3-5-3 (hex 6 AF x 5.0)
H7 stud thread M3 (length ASSUMED 5 mm above the hex)
H7 washer TR NWE-34815-M3 (7.0 / 3.2 x 0.5)
H7 female-female HNSM3-20-5.5-1 (hex 5.5 AF x 20)
H7 washers 3 x TR NWE-34815-M3
H7 card screw 97790803211 head (5.5 x 2.1)
H7 card screw shank M3 x 8
H8 stud HTSN-M3-5-3 (hex 6 AF x 5.0)
H8 stud thread M3 (length ASSUMED 5 mm above the hex)
H8 washer TR NWE-34815-M3 (7.0 / 3.2 x 0.5)
H8 female-female HNSM3-20-5.5-1 (hex 5.5 AF x 20)
H8 washers 3 x TR NWE-34815-M3
H8 card screw 97790803211 head (5.5 x 2.1)
H8 card screw shank M3 x 8
M1 tab screw McMaster 92000A107 M2.5 x 12 pan head (5.0 x 2.1)
M1 tab screw shank M2.5
M1 gap spacer McMaster 93657A200 nylon 2.0 mm (OD 4.5), 0.25 mm free play below
M1 shoulder washer 7721-7PPSG flange 1.02 mm (OD ASSUMED 6.35)
M1 screwdriver access (4.0 mm radius, head to lid)
M1 thermal pad G579 10 x 16, 0.93 compressed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
