ChristopherCa55/led-driver/BOOST_split_boards/FINAL_2026-09-25/6_3d_model/BOOST_assembly_2026-09-25.stl

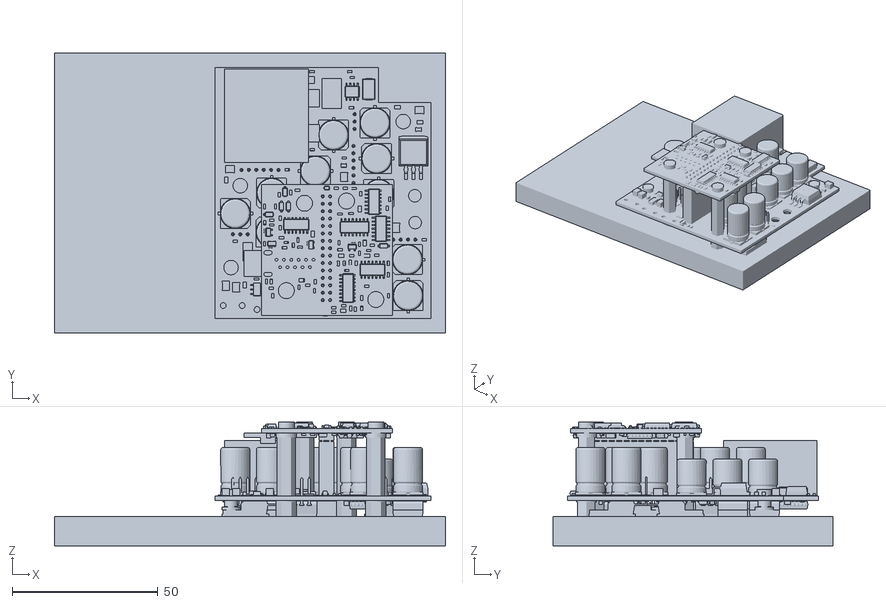
[picture p159: CAD file, 2026-09-26]
BOOST_split_boards/FINAL_2026-09-25/6_3d_model/BOOST_assembly_2026-09-25.stl
134.0 x 96.0 x 42.4
