ChristopherCa55/led-driver/BOOST_split_boards/assembly_3d_2026-09-24/work/2026-09-24/card_RC1.step

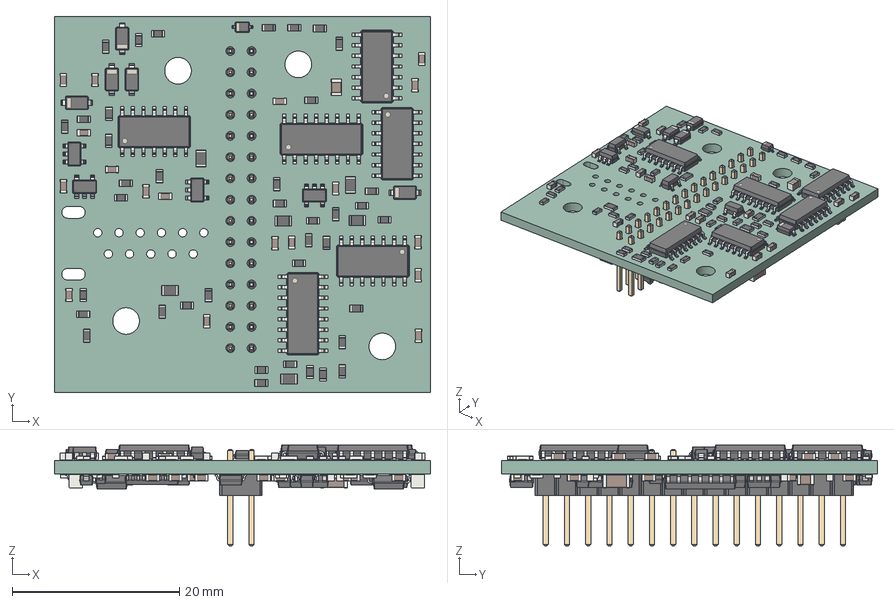
[picture p160: CAD file, 2026-09-26]
BOOST_split_boards/assembly_3d_2026-09-24/work/2026-09-24/card_RC1.step
45.0 x 45.0 x 12.0 mm
R_0603_1608Metric x 65
C_0603_1608Metric x 46
SOT-23-5 x 11
SOIC-16_3.9x9.9mm_P1.27mm x 2
SOIC-14_3.9x8.7mm_P1.27mm x 6
R_0805_2012Metric x 10
D_SOD-123 x 10
D_SOD-323 x 3
C_0805_2012Metric x 2
C_1206_3216Metric x 3
SOT-23
TSSOP-20_4.4x6.5mm_P0.65mm
PinHeader_2x15_P2.54mm_Vertical
BOOST_control_RC1_PCB
