ChristopherCa55/led-driver/BOOST_split_boards/assembly_3d_2026-09-30/work/before_power_6layer/power.step

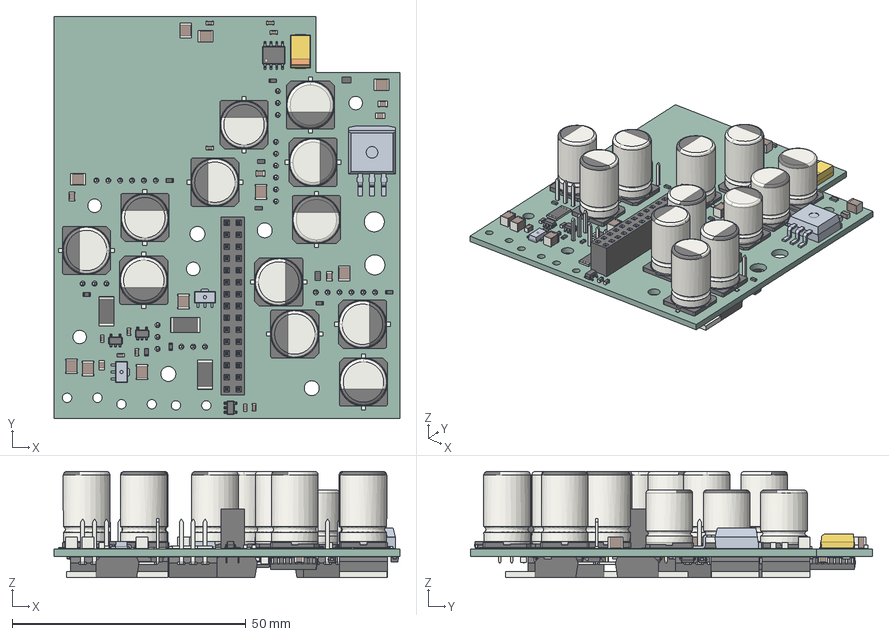
[picture p162: CAD file, 2026-10-03]
BOOST_split_boards/assembly_3d_2026-09-30/work/before_power_6layer/power.step
74.0 x 86.0 x 22.7 mm
CP_Elec_10x14.3 x 9
R_0603_1608Metric x 14
C_0603_1608Metric x 15
SOT-23-5 x 3
C_1210_3225Metric x 10
R_2512_6332Metric x 3
PinSocket_2x15_P2.54mm_Vertical
C_0805_2012Metric x 9
SOIC-8_3.9x4.9mm_P1.27mm
power 1.20.1 x 2
power 1.24.1
CP_Elec_10x12.5 x 3
R_0805_2012Metric x 8
CP_EIA-7343-31_Kemet-D
D_SOD-123 x 9
C_1206_3216Metric x 3
SOIC-16W_7.5x10.3mm_P1.27mm x 4
TO-220-3_Horizontal_TabUp x 10
D_SOD-123F x 3
D_SMC
BOOST_power_RC2_PCB
