ChristopherCa55/led-driver/(list of files, cad)

Other CAD files:
BOOST_package_for_review/BOOST_assembly_2026-09-25.step
BOOST_split_boards/assembly_3d_2026-09-24/BOOST_assembly_2026-09-25_with_case.stl
BOOST_split_boards/assembly_3d_2026-09-24/work/pdf3d/BOOST_assembly_2026-09-25_flat.step
BOOST_split_boards/assembly_3d_2026-09-30/BOOST_assembly_2026-09-30.step
BOOST_split_boards/assembly_3d_2026-09-30/work/before_card_05oz/BOOST_assembly_2026-09-30.step
BOOST_split_boards/review_fixes_2026-10-11/work/assembly_dryrun/BOOST_assembly_2026-10-13.step
BOOST_split_boards/review_fixes_2026-10-11/work/regen_final/stage/BOOST_assembly_2026-10-13.step
BOOST_schematic_cleanup/BOOST_assembly_2026-09-25.step
BOOST_split_boards/assembly_3d_2026-09-24/BOOST_assembly_2026-09-24.step
BOOST_split_boards/assembly_3d_2026-09-30/work/before_power_6layer/BOOST_assembly_2026-09-30.step
BOOST_split_boards/FINAL_2026-09-25/6_3d_model/BOOST_assembly_2026-09-25_with_case.stl
BOOST_split_boards/assembly_3d_2026-09-30/work/before_card_6layer/card.step
BOOST_split_boards/assembly_3d_2026-09-30/work/power.step
BOOST_split_boards/review_fixes_2026-10-11/work/assembly_dryrun/work/card.step
BOOST_split_boards/review_fixes_2026-10-11/work/regen_final/assembly/work/power.step
BOOST_split_boards/assembly_3d_2026-09-24/work/2026-09-24/power_RC1.step
BOOST_split_boards/assembly_3d_2026-09-24/work/card.step
BOOST_split_boards/assembly_3d_2026-09-30/work/before_card_05oz/card.step
BOOST_split_boards/review_fixes_2026-10-11/work/assembly_dryrun/work/power.step
BOOST_split_boards/review_fixes_2026-10-11/work/regen_final/assembly/work/card.step
BOOST_split_boards/assembly_3d_2026-09-30/work/before_power_6layer/card.step
BOOST_split_boards/previous/2026-09-30/before_card_6layer/BOOST_assembly_2026-09-30.step
BOOST_split_boards/previous/2026-09-30/before_copy_from_cleanup/BOOST_package_for_review/BOOST_assembly_2026-09-25.step
BOOST_split_boards/previous/2026-09-30/before_review_readme/BOOST_assembly_2026-09-25.step
BOOST_split_boards/previous/2026-10-01/before_cost_changes/BOOST_package/BOOST_assembly_2026-09-30.step
BOOST_split_boards/previous/2026-10-01/before_cost_changes/BOOST_schematic_cleanup/BOOST_assembly_2026-09-30.step
BOOST_split_boards/previous/2026-10-01/before_cost_changes/BOOST_stuff/BOOST_assembly_2026-09-30.step
BOOST_split_boards/previous/2026-10-02/before_power6_release/BOOST_package/BOOST_assembly_2026-09-30.step
BOOST_split_boards/previous/2026-10-02/before_power6_release/BOOST_schematic_cleanup/BOOST_assembly_2026-09-30.step
BOOST_split_boards/previous/2026-10-02/before_power6_release/BOOST_stuff/BOOST_assembly_2026-09-30.step
BOOST_split_boards/previous/2026-10-14/before_ship/BOOST_package/BOOST_assembly_2026-10-07.step
