ChristopherCa55/led-driver/BOOST_review_fixes/BUILD_NOTES.md

# BOOST: build notes (assembly pack)

Started 2026-09-16, updated 2026-09-25 for scenario A and the fabrication and assembly package
(`fab_2026-09-24/`, release candidate 2). Collects the assembly instructions decided during the re-design.
- Sources: `replace_2026-09-14/tools/replace_notes.md` (rounds 3-4), the user's instructions of 2026-09-16, -23, -24
  and -25, and the 3D assembly model in `assembly_3d_2026-09-24/`.
- Every hardware part is now chosen; prices and links are in `fab_2026-09-24/COST_SUMMARY.md`.
- Previous versions: `previous/2026-09-24/BUILD_NOTES_before_fab_pack.md`,
  `previous/2026-09-24/BUILD_NOTES_before_rc2.md`, `previous/2026-09-25/BUILD_NOTES_before_scenario_A.md` and
  `previous/2026-09-25/BUILD_NOTES_before_final_hardware.md`.

Pack contents: this file, the case drilling drawing rev B (`case_drilling_2026-09-15/case_floor_drilling.svg` and
`.html`, positions re-checked against the release-candidate board on 2026-09-24: all eight match to 0.01 mm), and
the BOM / sourcing table (`fab_2026-09-24/bom/SOURCING_TABLE.md`).

## What you fit yourself

JLCPCB fits every other part. These are DNP in the JLC BOM and pick-and-place files; their pads, holes and silk stay
on the boards.

| Ref | Part | Why |
|---|---|---|
| M1-M10 | HuaYi HYG180N10, TO-220 (power board, underside) | you own ten |
| L1 | Codaca CSCF3218-6R8MC (power board, top) | you own it |
| J10 | Samtec ESQ-115-44-G-D socket (power board, top) | not stocked at LCSC (Samtec / Digi-Key / Mouser) |
| J11 | Samtec TSW-115-07-G-D header (card, underside) | LCSC lists it with 0 in stock |

R1 and U25 (schematic rev6, in the schematic since 2026-09-25): R1 is Bourns CSS4J-4026R-1L00F (1 mOhm) and U25
is the INA241A4 (100 V/V). JLC fits both. The current signal stays 0.1 V/A, with the same 4026 land pattern and
the same SOIC-8 pinout. Rev5 (2 mOhm with INA241A3) is backed up in `previous/2026-09-25/schematic_rev5/`.

The build is **scenario A** (2026-09-25): 5 bare PCBs of each board, 2 complete sets assembled by JLCPCB, 3 spare
bare boards of each. The spares, if you ever build them, would need the stock-limited parts; the files for that
are kept in `fab_2026-09-24/cost/` (limitedDNP), not developed further.

## Board

- Power board: 6 layers since 2026-10-02, on JLCPCB's stackup **JLC061611-7628D** (1 oz outer / 1 oz inner,
  1.583 mm copper + dielectric; it must be specified at order), written into the board file. In1 is the GND plane;
  5 V runs as tracks (`BOOST_split_boards/power6_2026-10-01/README.md`). ENIG finish; every via epoxy filled and copper capped (fab drawing note 1).
- Control card: 6 layers since 2026-09-30, 1.6 mm nominal; since 2026-10-01 0.5 oz inner copper (JLCPCB's standard
  6-layer 1 oz outer / 0.5 oz inner build, 1.547 mm). ENIG; vias epoxy filled and capped.
- Every power pad is joined to its copper solidly, with no thermal reliefs: the TO-220 pins, L1, J1-J8, capacitor
  pads and shunts. This is deliberate, because spokes would carry up to 15.8 A.

## MOSFET orientation (M1-M10): do not fit one backwards

- **Pinout: G-D-S = pins 1-2-3** (HuaYi HYG180N10 datasheet: gate, drain, source). The tab is the drain. The
  footprint's pads 1 / 2 / 3 carry each FET's gate / drain / source nets (checked on the board 2026-09-24), and
  **pad 1 is the square pad**.
- The HuaYi datasheet draws an exposed metal tab but does not state what the tab connects to (replace_notes,
  2026-09-14). Before fitting, check one part with a meter: tab to the middle pin should read a short. The
  insulation (compliant pad, shoulder washers, gap spacers) assumes the tab carries the drain voltage.
- **Body flat against the board underside, metal tab facing away from the board, toward the case.** The marked face
  of the part is then against the board.
- Pin 1 (gate) is the left lead when you read the part's marking with the leads pointing down. It must go into the
  square pad. If the tab faces the board, the part is upside down: gate and source swap, and it will fail.
- **Underside (B.SilkS), the side you place from:** each FET's body-and-tab outline, with the tab end drawn dashed
  and the word **TAB** inside it.
- **Top side (F.SilkS), the side you solder from, with the pins coming through:**

  | FET | Marking beside its pins on the top side |
  |---|---|
  | M2, M3, M8, M10 | **G D S** beside pads 1-2-3, and a pin-1 dot |
  | M1, M6, M7 | **G** beside pad 1 and a pin-1 dot (no room for D and S between the neighbouring parts) |
  | M4 | **G** off the corner of pad 1, and a pin-1 dot |
  | M5 | **G** at the pad-1 end of the row and a pin-1 dot; also **G** on the underside beside pad 1 |
  | M9 | **G** and **S** at the two ends of the row and a pin-1 dot; also **G** on the underside |

  Text 1.0 mm, 0.15 mm stroke, nowhere closer than 0.15 mm to a pad. M4/M5 and M6/M3 each share one straight row of
  six pads: read each letter against the pad beside it.
- Before soldering each FET, check from the top that the lead in the **G** pad is the gate.
- The power board change was silk only (v16 -> v17: DRC before / after in
  `route_2026-09-16/work/silk/v16_before_newrules.drc.rpt` and `v17_after.drc.rpt`, renders in
  `route_2026-09-16/renders_v17/`).

## Soldering the hand-fitted parts

- **Preheat the board from below to about 100-120 C with hot air** before soldering the TO-220 pins, **L1**, the
  J10 / J11 GND pins, or the J1/J2 cable joints. All of them join solid planes and pours.
- Use an **80-100 W iron with a 3 mm or larger chisel tip**, and flux.
- **L1 (CSCF3218, 32 x 22.5 x 19 mm, 6.8 uH) is a large SMD part with two J-lead terminals** on 8 x 6 mm pads
  (LX and rsense_lo; the third pad under the body is mechanical). Treat it like the TO-220 pins: preheat, the
  high-power iron, and plenty of flux. Solder it first, while nothing else tall is in the way, and check that the
  body sits flat before the second terminal sets.
- Hold each FET body flat against the board while soldering its pins. On M1, M8, M9 and M10 the M2.5 screw and
  its spacer can act as the jig. Trim the leads that come through the top side.
- Removing a FET later will be difficult: the pins are joined solidly to two GND planes and several pours.
- **J10 (power board top) and J11 (card underside):** 1.05 mm holes. Solder J11 from the card's top side. Its
  tails stand about 0.9 mm above the card, under the 1.75 mm top-side limit. The mated pair seats at 21.21 mm; the
  standoffs hold 21.50, so the posts insert 5.55 mm (Samtec: 3.68-6.35).

## Stack in the case (floor upward)

Case floor tapped per `case_drilling_2026-09-15/` rev B (M3: 7.0 mm full thread; M2.5: 6.0 mm full thread;
10 mm floor, blind holes).

1. Thermal pad under every FET, cut about 10 x 16 mm per FET, with a 3.0 mm hole at M1/M8/M9/M10. Compressed to
   0.93 mm at the 5.50 mm board height, which is about 39 % for a 1.5 mm pad.
   - **Pad (2026-09-25):**
     - **McMaster-Carr 1272N32**: 3 W/m-K silicone, 0.060 in (1.52 mm), 4 x 4 in. This is the default.
     - **t-Global TG-AD30 1.5 mm** instead if it is bought: 3.0 W/m-K, 20 Shore 00, >= 5 kV/mm.
     - The approved G579 0.050 in sheet is not sold at Digi-Key.
     - The 0.060 in G579 (61-06-0909-G579) also fits, at about five times the price.
     - Numbers are in `fab_2026-09-24/cost/pad_options.txt`.
   - The McMaster pad publishes **no dielectric strength**, and it is the only insulation between each FET tab
     (drain, up to 60 V) and the case. That is why the tab-to-case check below is mandatory before first power-up.
   - Do not cut the pads larger. In the 3D model, 10 x 16 pads centred on the bodies leave 0.54 mm between M6's and
     M8's, 0.56 mm to M9's, and 0.86 mm between M1's and M7's.
   - **Heat in M8-M10 (2026-10-11):** in the simulation the sink FETs hold their drains at 1.49 / 1.45 / 1.45 V at
     full current, so M10 / M9 / M8 dissipate about 3.9 / 3.4 / 3.4 W each. Across a 10 x 16 mm, 3 W/m-K pad
     compressed to 0.93 mm (about 1.9 K/W) that is about 7.5 K at 3.9 W. The HYG180N10's junction-to-case resistance
     is not verified (its data sheet is not on file).
2. FET tab screws (M1, M8, M9, M10), from the top down:
   - McMaster-Carr 92000A107: M2.5 x 12 pan head Phillips, 18-8 stainless. Its head is 2.1 mm tall; the 3D model
     used 1.75 mm.
   - Through the board, then a **2.0 mm nylon spacer** (McMaster-Carr 93657A200, M2.5, 4.5 mm OD).
     - The stack was designed with a 2.25 mm spacer, but no stocked 0.25 mm shim was found.
     - The spacer being 0.25 mm short leaves free play in the column. The screw only retains the FET; the pad
       compression comes from the standoff height.
   - Then the Aavid/Boyd 7721-7PPSG shoulder washer in the tab hole, the tab and the pad, into the floor.
   - **Turn the screw only until its head just touches the board.** The column rests on the compliant pad, so
     tightening pulls the board down and crushes those four pads.
3. Board standoffs at H5-H8, floor upward. **Nylon threads hand-tight only, no tools on them.**
   - **Floor stud (2026-09-25).** Essentra's HTSN-M3-5-3 is sold only as 6,500 pieces, so the stud is now two
     McMaster-Carr parts:
     - **92605A109**: M3 x 20 mm set screw, 18-8 stainless, flat tip. Thread it **6 mm into the floor's 7 mm tapped
       hole** with a drop of low-strength threadlocker (Loctite 222 or similar), so **14 mm stands above the floor**.
       Check that with calipers.
     - **94669A099**: aluminium spacer, 5.00 +/- 0.13 mm long, 4.5 mm OD, 3.2 mm ID, dropped over the screw.
     - Both are metal and at case potential. That is safe: H5-H8 are unplated holes, the nearest copper is 3.10 mm
       or more from the hole centre on every layer, and the spacer sits under the nylon washer. Details in
       `fab_2026-09-24/COST_SUMMARY.md`.
   - One TR Fastenings TR NWE-34815-M3 nylon washer (0.50 mm; 7.0 mm OD, 3.2 mm ID). Essentra's own NWE-34815-M3 is
     obsolete at Digi-Key; TR's is the same washer, in packs of 100 at Farnell/Newark.
   - The power board.
   - Essentra HNSM3-20-5.5-1, nylon female-female (20 mm), screwed onto the set screw to clamp the board. It engages
     6.9 mm of thread.
   - Three TR NWE-34815-M3 washers (1.50 mm).
   - The control card.
   - Wurth Elektronik 97790803211, accepted by the user 2026-09-17: WA-SCRW M3 x 8 nylon 66 pan head, UL94 V-0, head
     2.1 +/- 0.2 mm tall and 5.5 +/- 0.3 mm across, rated -30 to +85 C. It uses 4.9 mm of the standoff's top end,
     and 6.9 + 4.9 < 20, so the screw and the set screw never meet.
   - Heights:
     - card gap 21.50 mm (the ESQ/TSW header seats at 21.21);
     - card screw head top at 32.30 mm, 0.70 mm under the lid (33.00);
     - 0.50 mm at the maximum head height;
     - about 0.2 mm if the washers are also thick (+0.05 each; the distributor lists them at 0.51 mm) and the card
       10 % thick.
   - **Before fitting the board**, measure spacer + washer on all four: target 5.50 +/- 0.10 mm. Buy 10 spacers and
     use the 8 closest.
4. **Screwdriver access:** M8's tab screw is under the control card, so fit it before the card. M1, M9 and M10 stay
   reachable afterwards. The 3D model puts M9's screwdriver path 3.2 mm clear of the card edge, which corrects the
   earlier note that M9 was under the card. Nothing on the boards taller than 3 mm comes within 4.0 mm of any tab
   screw; the closest are cans C69 (M1) and C71 (M9), 0.7 mm outside that radius.

## Clearances measured in the 3D model (2026-10-02)

Full table in `CLEARANCES.md` (this folder; built in `BOOST_split_boards/assembly_3d_2026-09-30/`). The model still shows the Essentra floor stud. Its hex is 6 mm across flats; the aluminium spacer that replaced it is 4.5 mm across, so no clearance gets worse. The items under 1 mm:

- Lid to the card screw heads 0.77 mm, and to the SOIC-16 packages on the card top (U18, U28) 1.11 mm. The model uses
  the board files' thicknesses (power 1.583 mm, card 1.547 mm); the fab tolerance is +/-10 %.
- The standoff washers under the card come within 0.40-0.73 mm of card parts D6 (H1), R94 (H2), D3 (H3) and R84 (H4).
  They clear, but centre the washers on the screw.
- The J9 wire bundle passes 0.39 mm from M10's screwdriver path (see the J9 routing note below).

Every can clears the 2 mm vent rule at its datasheet maximum height (closest: 2.85 mm under U104 / U106 on the card).

## J9 (Arduino) wires

J9 is 11 soldered wires, 26-28 AWG stranded: **your own wires and plug** (2026-09-25).
- **Bourns MF-R050** (LCSC C208476): the inline fuse on the pin-9 wire, fitted at the card end. It is rated 60 V, -40
  to +85 C. It replaced MF-R020 on 2026-09-25, because inside the case MF-R020's hold current falls to about 0.10 A,
  the same as the load.
  - At 23 C it holds 0.50 A and trips at 1.00 A.
  - At 75 C inside the case it holds about 0.25 A and trips at about 0.49 A (Bourns MF-R thermal derating table).
  - The load is about 0.1 A.
- **The 12 V -> 5 V buck at the Arduino end is your own compact 4 A module** (2026-09-25). It has to:
  - regulate from about 9.5-13 V in, and survive at least 20 V. Since 2026-10-01 U16 is an MC7812, whose 12 V rail
    sags to about 9.7-10.2 V near the end of a 4S discharge;
  - give 5.0 V +/-5 % out, at least 200 mA;
  - draw about 0.1 A input current.
- **No extra input filter at the buck** (user decision, 2026-09-25): the module has its own input capacitors and draws
  about 0.1 A. Settled; do not add one.

The wires:
- in from the card's underside, soldered on the top side and trimmed flush (fillet under the 1.75 mm top-side
  limit);
- run along the underside to the west edge;
- one cable tie through the two slots beside the pads, head on the underside;
- the plug goes on the Nano's pins.

**Route the bundle clear of M10's tab screw.** Where the wires leave the card's west edge (board y 92.8-101.6), they
head straight over M10's screw (board (35.5, 98.6), case (57.5, 70.6)). Fit M10's screw first. Take the bundle
north or south of that point, so the screw stays reachable.

### J9 wire table (control card)

Each pad is named on both sides of the card: odd pins in the row above the pads, even pins in the row below.
Pin 1 has a square pad and a silk dot beside it. The pads are staggered 1.27 mm apart, so check each wire against its
label before soldering. Colours accepted by the user 2026-09-23 (pin 9 red for 12 V).

| Pin | Label | Net | Function | Wire colour |
|---|---|---|---|---|
| 1 | V1 | Vref_1_arduino | PWM brightness, channel 1 | brown |
| 2 | V2 | Vref_2_arduino | PWM brightness, channel 2 | orange |
| 3 | V3 | Vref_3_arduino | PWM brightness, channel 3 | yellow |
| 4 | I1 | IREF1 | channel 1 enable | green |
| 5 | I2 | IREF2 | channel 2 enable | blue |
| 6 | I3 | IREF3 | channel 3 enable | violet |
| 7 | SCL | SCL | I2C clock to U26 | white |
| 8 | SDA | SDA | I2C data | grey |
| 9 | 12V | 12V | card 12 V out, to power the Arduino end (schematic rev5, 2026-09-23; see below) | red |
| 10 | GND | GND | common ground (pad has thermal-relief spokes for hand soldering) | black |
| 11 | INH | ARD_M1_INHIBIT | drive high to hold M1 off | pink (or white with a red marker) |

**Pin 9 is 12 V** (from J11.19, the power board's 12 V rail from U16, an MC7812 since 2026-10-01; schematic rev5). It powers the Arduino end:
- It feeds a **12 V -> 5 V buck module at the Arduino**, and that buck makes the Arduino's 5 V. **Do not wire it to the
  Nano's VIN pin.**
- Fit the **inline PTC (Bourns MF-R050, 0.5 A hold) at the card end** of the pin-9 wire.
- **Twist the 12 V (pin 9, red) and GND (pin 10, black) wires together** along the run.
- Why: the card's own 5 V comes from a 100 mA L78L05 (SOT-89) dropping 14 V. It cannot also carry an Arduino plus a
  CAN transceiver (about 50 mA average, 120 mA peak) without overheating. The 12 V regulator U16 (TO-263, 1 A) carries
  about 20 mA today, and adding 120 mA costs it about 0.24 W (user, 2026-09-23).
- On the card, 12 V reaches J9.9 by a long route (88 mm, 0.3 mm track): about 0.1 ohm, 12-20 mV at 200 mA. Accepted
  2026-09-24.

## Order

1. JLCPCB assembles both boards, both sides, except the parts listed under "What you fit yourself".
2. Power board, by hand, board preheated:
   - L1 first;
   - then J10;
   - then the ten FETs, checking each one's orientation.
3. Control card: J11 from the underside, soldered on top; then the J9 wires, the PTC and the tie.
4. Floor studs: thread the four M3 x 20 set screws 6 mm into the H5-H8 floor holes with low-strength threadlocker
   (14 mm standing), and let it cure. Drop an aluminium spacer and one washer over each. Measure spacer + washer
   (target 5.50 +/- 0.10 mm). Blow out any drilling swarf from the floor and the tab-screw holes.
5. Lay the thermal pads on the floor. Fit the power board onto the set screws, and screw the four 20 mm card
   standoffs onto them, hand-tight.
6. **Fit M8's tab screw now, before the control card.** M8 is under the card, and its screw cannot be reached once
   the card is on.
7. **Fit M10's tab screw now, before the J9 bundle is dressed**, then M1's and M9's. Each screw: head just touching
   the board.
7a. **Tab-to-case check, before the control card goes on, and again before first power-up.** Every FET tab is its
   drain (up to 60 V), and only the pad (and, at M1/M8/M9/M10, the shoulder washer) separates it from the case.
   Battery disconnected, nothing else touching the case:
   - Multimeter on its highest resistance range (20 MOhm or auto).
   - First, circuit GND (a J2 lug) to the case: it must read **open**. If it does not, the case is touching the circuit
     somewhere else (a lug, the battery cable, a stud against copper); find that before going on.
   - Then one probe on the case (a tab-screw head is at case potential and reachable from the top), the other on each
     FET's **middle lead** on the top side of the power board (the middle pin is the drain, the same metal as the tab),
     M1 to M10.
   - **Expect open circuit (overload, or tens of megohms and rising).**
   - **If any FET reads low (anything below about 20 MOhm, or a steady finite value): do not power up.**
     - Note which FET. FETs that share a drain net read the same; check each of them.
     - Lift the power board (tab screws and standoffs out) and inspect that FET's pad for a cut or tear, a pad slid off
       the tab edge, or metal swarf from drilling the floor.
     - At M1/M8/M9/M10, also check that the shoulder washer sits in the tab hole uncracked, and that the screw shank
       does not touch the tab.
     - Replace the pad with a fresh 10 x 16 mm piece, clean out any swarf, reassemble, and measure all ten again.
   - Power up only when all ten read open.
   - A multimeter tests at a few volts only. It finds contact and swarf, not a weak insulator. Do not use an
     insulation tester (hundreds of volts) on the assembled board: if anything connects the circuit to the case, the
     test voltage lands across the TVS and the capacitors.
8. Put three washers on each card standoff. Fit the control card onto J10 and the standoffs, then the four card
   screws, hand-tight.
9. **Route the J9 bundle around M10's screw, not over it.** Where the wires leave the card's west edge (board y
   92.8-101.6), take them north or south of M10's screw at board (35.5, 98.6), case (57.5, 70.6). The screw must stay
   reachable with a screwdriver from above. Then plug the housing onto the Nano and connect your buck at the Arduino
   end.
10. Battery cable: strain relief on the case near the penetrator (boss or P-clip), not on the board.
