ChristopherCa55/led-driver/BOOST_split_boards/ltspice_layout_2026-10-05/checks/build_pilot.txt

old-area flags added: []
new names on auto nets: [(['Vbattery'], 2)]
ELECTRICAL SELF-CHECK: OK
wrote C:\Users\bubba\OneDrive\Documents\led-driver\BOOST_split_boards\ltspice_layout_2026-10-05\tools\..\work\BOOST.asc 302 symbols 956 wires 316 flags
temporary labels: 11
