ChristopherCa55/led-driver/BOOST_split_boards/review_fixes_2026-10-11/work/step10/vs_step06b.txt

branch                        I (A) BASE                               | STEP10                            
Vin J1->R1 (DC)               18.40  1.003 /  29.3 (5.1) /  29.3 / 5   |  1.003 /  29.3 (5.1) /  29.3 / 5  
Vin caps->R1 (ripple)          9.50  0.344 /   6.7 (5.2) /   6.7 / 0   |  0.344 /   6.7 (5.2) /   6.7 / 0  
rsense_lo R1->L1              20.70  0.229 /  24.1 (7.0) /  24.1 / 7   |  0.229 /  24.1 (7.0) /  24.1 / 7  
LX L1->M1                     15.80  0.472 /  30.5 (2.0) /  30.5 / 0   |  0.472 /  30.5 (2.0) /  30.5 / 0  
LX L1->M7                      7.05  0.450 /   9.5 (1.6) /   5.1 / 0   |  0.450 /   9.5 (1.6) /   5.1 / 0  
LX L1->M6                      7.69  0.732 /  19.4 (5.2) /  19.4 / 0   |  0.732 /  19.4 (5.2) /  19.4 / 0  
LX L1->M5                      8.35  1.967 /  56.4 (1.3) /  25.8 / 0   |  1.978 /  55.8 (1.3) /  30.3 / 0  
m2_source M7->M2               7.05  0.039 /   4.1 (0.0) /   0.0 / 0   |  0.039 /   4.1 (0.0) /   0.0 / 0  
m3_source M6->M3               7.69  0.041 /   5.7 (0.0) /   0.0 / 0   |  0.041 /   5.7 (0.0) /   0.0 / 0  
m4_source M5->M4               8.35  0.041 /   8.6 (0.0) /   0.0 / 0   |  0.041 /   8.6 (0.0) /   0.0 / 0  
Vout_1 M2->bank+J3             7.05  0.219 /  17.4 (0.1) /   5.2 / 0   |  0.219 /  17.4 (0.1) /   5.2 / 0  
Vout_2 M3->bank+J8             7.69  0.315 /   9.5 (0.9) /   6.0 / 0   |  0.315 /   9.5 (0.9) /   6.0 / 0  
Vout_3 M4->bank+J5             8.35  0.121 /   4.8 (1.2) /   1.8 / 0   |  0.118 /   4.9 (1.2) /   2.0 / 0  
Vout_1 M2->J3 (LED DC)         2.63  8.459 /  17.7 (2.8) /  17.7 / 0   |  8.459 /  17.7 (2.8) /  17.7 / 0  
Vout_2 M3->J8 (LED DC)         2.37  3.082 /   5.4 (5.6) /   5.4 / 0   |  3.082 /   5.4 (5.6) /   5.4 / 0  
Vout_3 M4->J5 (LED DC)         2.37  1.623 /   2.4 (4.1) /   2.4 / 0   |  1.623 /   2.4 (4.1) /   2.4 / 0  
Output1_drain J4->M10          2.63  1.968 /   4.1 (1.3) /   3.8 / 0   |  1.968 /   4.1 (1.3) /   3.8 / 0  
Output2_drain J7->M9           2.37  2.868 /   6.6 (1.3) /   3.5 / 0   |  2.868 /   6.6 (1.3) /   3.5 / 0  
Output3_drain J6->M8           2.37  2.992 /   4.6 (10.1) /   4.6 / 0  |  2.992 /   4.6 (10.1) /   4.6 / 0 
M10-S M10->R52                 2.63  0.310 /   3.1 (1.2) /   0.0 / 0   |  0.310 /   3.1 (1.2) /   0.0 / 0  
M9-S M9->R53                   2.37  0.284 /   9.5 (0.0) /   0.0 / 0   |  0.284 /   9.5 (0.0) /   0.0 / 0  
M8-S M8->R7                    2.37  0.236 /   1.4 (1.6) /   0.0 / 0   |  0.236 /   1.4 (1.6) /   0.0 / 0  
GND M1->input caps+J2         15.80  0.146 /  10.5 (0.2) /   4.9 / 0   |  0.146 /  10.5 (0.2) /   4.9 / 0  
GND ch1 bank->input            7.05  0.369 /   5.7 (0.5) /   4.7 / 0   |  0.370 /   5.9 (0.5) /   5.0 / 0  
GND ch2 bank->input            7.69  0.668 /   7.9 (0.2) /   5.6 / 0   |  0.668 /   8.0 (0.2) /   5.8 / 0  
GND ch3 bank->input            8.35  0.438 /   4.7 (5.5) /   4.7 / 1   |  0.438 /   4.7 (5.6) /   4.7 / 1  
GND R52 return                 2.63  0.714 /   0.5 (0.3) /   0.3 / 0   |  0.714 /   0.5 (0.3) /   0.3 / 0  
GND R53 return                 2.37  0.889 /   0.5 (0.4) /   0.3 / 0   |  0.889 /   0.5 (0.4) /   0.3 / 0  
GND R7 return                  2.37  0.835 /   0.3 (0.6) /   0.3 / 0   |  0.836 /   0.3 (0.6) /   0.3 / 0
