ChristopherCa55/led-driver/BOOST_split_boards/review_fixes_2026-10-11/work/cmp/proto_12V_A/heatmap/step_gnd_report.txt

GND voltage above J2.1, full-load DC (power_cu.json, JLC061611-7628D, grid 0.10 mm)
currents in: M1.3 11.03 A, R52.2 2.63 A, R53.2 2.37 A, R7.2 2.37 A; out at J2.1 18.40 A

terminal pads (mV): M1.3 6.18, R52.2 7.62, R53.2 8.07, R7.2 7.73, J2.1 0.00
highest GND voltage per layer (mV): F.Cu 8.07, In1.Cu 7.90, In2.Cu 7.86, In3.Cu 7.84, In4.Cu 7.70, B.Cu 7.66
floating GND copper (mm2): none

GND pins per part, lowest-highest pad (mV), highest first:
  R53      8.07 -   8.07
  U12      7.82 -   7.82
  R7       7.73 -   7.73
  C34      7.69 -   7.69
  C21      7.68 -   7.68
  C44      7.68 -   7.68
  C45      7.68 -   7.68
  C55      7.68 -   7.68
  C7       7.67 -   7.67
  C56      7.66 -   7.66
  U1       7.65 -   7.65
  R52      7.62 -   7.62
  U11      7.59 -   7.59
  C33      7.54 -   7.54
  C87      7.47 -   7.47
  C71      7.47 -   7.47
  C78      7.32 -   7.32
  J10      6.51 -   7.28
  C3       7.27 -   7.27
  C39      7.13 -   7.13
  C73      7.12 -   7.12
  U6       7.10 -   7.10
  C35      7.05 -   7.05
  U17      7.02 -   7.02
  C41      7.02 -   7.02
  C77      6.79 -   6.79
  C89      6.78 -   6.78
  U8       6.76 -   6.77
  C83      6.71 -   6.71
  C80      6.71 -   6.71
  C90      6.71 -   6.71
  U10      6.71 -   6.71
  U15      6.63 -   6.63
  C62      6.59 -   6.59
  C88      6.59 -   6.59
  C48      6.57 -   6.57
  C79      6.57 -   6.57
  C75      6.56 -   6.56
  C84      6.49 -   6.49
  U19      6.42 -   6.46
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

GND vias carrying the most current (IPC 10 C rating 0.97 A for 0.4 mm):
  ( 79.60,  52.00) drill 0.40  0.60 A  0.62x
  ( 42.30,  96.05) drill 0.40  0.59 A  0.61x
  ( 79.00,  53.00) drill 0.40  0.58 A  0.59x
  ( 40.10,  96.05) drill 0.40  0.56 A  0.57x
  ( 41.57,  96.05) drill 0.40  0.53 A  0.55x
  ( 79.60,  51.00) drill 0.40  0.53 A  0.54x
  ( 40.83,  96.05) drill 0.40  0.52 A  0.54x
  ( 86.90,  67.50) drill 0.40  0.50 A  0.51x
  ( 93.40,  61.10) drill 0.40  0.48 A  0.49x
  ( 61.06,  94.90) drill 0.40  0.48 A  0.49x
  ( 61.06,  97.10) drill 0.40  0.45 A  0.47x
  ( 91.30,  62.00) drill 0.50  0.45 A  0.39x
  ( 63.40, 109.55) drill 0.40  0.44 A  0.46x
  ( 61.06,  95.63) drill 0.40  0.44 A  0.45x
  ( 61.06,  96.37) drill 0.40  0.43 A  0.44x

new GND via candidates that cut no power pour (numbered on the map), ranked by the voltage across the layers they would join:
   1 ( 70.65,  82.75)  0.718 mV  joins F In1 In3 In4 B
   2 ( 56.15,  82.95)  0.567 mV  joins F In1 In2
   3 ( 56.15,  80.85)  0.532 mV  joins F In1 In2
   4 ( 59.25,  87.75)  0.468 mV  joins F In1 In2 In3 In4 B
   5 ( 80.15,  52.85)  0.452 mV  joins F In1 In3 In4 B
   6 ( 61.35,  88.25)  0.351 mV  joins F In1 In2 In3 In4 B
   7 ( 79.25,  94.75)  0.334 mV  joins F In1 In2 In3 In4
   8 ( 57.95, 103.65)  0.317 mV  joins F In1 In2 In3 In4 B
   9 ( 81.75, 110.65)  0.313 mV  joins F In1 In2 In3 In4 B
  10 ( 62.25, 105.75)  0.309 mV  joins F In1 In2 In3 In4 B
  11 ( 81.65, 112.75)  0.295 mV  joins F In1 In2 In3 In4 B
  12 ( 81.65, 114.85)  0.284 mV  joins F In1 In2 In3 In4 B
  13 ( 70.75,  92.75)  0.282 mV  joins F In1 In2 In4 B
  14 ( 64.35, 107.85)  0.280 mV  joins F In1 In2 In3 In4 B
  15 ( 58.05,  90.25)  0.262 mV  joins F In1 In2 In3 B
  16 ( 75.15,  94.05)  0.257 mV  joins F In1 In2 In3 In4 B
  17 ( 70.75,  90.25)  0.252 mV  joins F In1 In2 In4 B
  18 ( 66.05,  93.15)  0.250 mV  joins F In1 In2 In3 In4 B
  19 ( 60.05,  93.45)  0.250 mV  joins F In1 In2 In3 In4 B
  20 ( 83.75, 112.75)  0.247 mV  joins F In1 In2 In3 In4 B

stronger spots that would cut a power pour (not on the map), ranked by the voltage across the layers they would join:
   1 ( 82.85,  47.35)  2.758 mV  joins In1 B  cuts LX on In2.Cu, Vin on In3.Cu, Vin on In4.Cu
   2 ( 86.45,  47.35)  2.333 mV  joins In1 B  cuts LX on In2.Cu, Vin on In3.Cu, Vin on In4.Cu
   3 ( 93.95,  65.95)  2.231 mV  joins F In1 B  cuts LX on In2.Cu, Vin on In3.Cu, Vin on In4.Cu
   4 ( 88.55,  47.65)  2.119 mV  joins F In1 B  cuts LX on In2.Cu, Vin on In3.Cu, Vin on In4.Cu
   5 ( 90.65,  47.65)  2.035 mV  joins F In1 B  cuts LX on In2.Cu, Vin on In3.Cu, Vin on In4.Cu
   6 ( 90.25,  49.75)  1.955 mV  joins F In1 B  cuts LX on In2.Cu, Vin on In3.Cu, Vin on In4.Cu
   7 ( 80.85,  59.25)  1.666 mV  joins F In1 In4 B  cuts LX on In2.Cu
   8 ( 91.05,  45.55)  1.431 mV  joins In1 B  cuts Vin on In2.Cu, Vin on In3.Cu, Vin on In4.Cu
   9 ( 81.45,  57.05)  1.362 mV  joins F In1 In3 In4 B  cuts LX on In2.Cu
  10 ( 96.65,  67.65)  1.347 mV  joins F In1 B  cuts LX on In2.Cu, Vin on In3.Cu, Vin on In4.Cu
  11 ( 91.35,  43.45)  1.231 mV  joins F In1 B  cuts Vin on In2.Cu, Vin on In3.Cu, Vin on In4.Cu
  12 ( 79.35,  57.15)  1.220 mV  joins F In1 In4 B  cuts LX on In2.Cu
  13 ( 75.35,  80.05)  1.209 mV  joins F In1 In3  cuts Vout_1 on In4.Cu
  14 ( 93.45,  44.85)  1.170 mV  joins F In1 B  cuts Vin on In2.Cu, Vin on In3.Cu, Vin on In4.Cu
  15 ( 95.05,  69.75)  1.144 mV  joins F In1 B  cuts LX on In2.Cu, Vin on In3.Cu, Vin on In4.Cu
  16 ( 93.45,  42.75)  1.136 mV  joins F In1 B  cuts Vin on In2.Cu, Vin on In3.Cu, Vin on In4.Cu
  17 ( 94.55,  77.15)  1.100 mV  joins In1 B  cuts LX on In2.Cu, Vin on F.Cu, Vin on In3.Cu, Vin on In4.Cu
  18 ( 98.75,  67.65)  1.063 mV  joins F In1 B  cuts Vin on In2.Cu, Vin on In3.Cu, Vin on In4.Cu
  19 ( 81.45,  54.95)  1.035 mV  joins F In1 In3 In4 B  cuts LX on In2.Cu
  20 ( 95.55,  42.35)  1.005 mV  joins F In1 B  cuts Vin on In2.Cu, Vin on In3.Cu, Vin on In4.Cu
