ChristopherCa55/led-driver/BOOST_split_boards/assembly_3d_2026-09-24/viewer/index.html

# BOOST case assembly

Power board, control card, standoffs, thermal pads and the case, from the release-candidate boards of 2026-09-24. Drag to orbit, scroll to zoom, right-drag to pan. Pick a clearance to see its two parts.

loading model...

Iso Top From south From west Underside Clear highlight

## Show

Cut away everything above 36.0 mm (no cut)

screwdriver access, r 4.0 penetrator keep-out thermal pad J9 wires

## Clearances (mm, solid to solid)

Under 1 mm Vent 2 mm All

Can heights at the datasheet maximum (220 µF 16.8 mm, 680 µF 12.8 mm). Boards are modelled 1.654 mm thick against the nominal 1.6, so the lid and card figures are 0.05 mm pessimistic.

## Stack (height above the case floor)
