ChristopherCa55/led-driver/BOOST_split_boards/assembly_3d_2026-09-30/work/assembly_probe.txt

free shapes 1
top: BOOST_assembly assembly
 power_board            power 1                                  x 42.30..134.63 y -96.84..-2.00 z 0.96..23.67
   C77                    CP_Elec_10x14.3                          x 64.83..87.50 y -106.58..-89.26 z 1.67..18.17
   R22                    R_0603_1608Metric                        x 54.58..55.38 y -101.45..-99.85 z 1.67..2.12
   C41                    C_0603_1608Metric                        x 72.39..73.19 y -114.42..-112.82 z 1.67..2.47
   U6                     SOT-23-5                                 x 66.36..69.16 y -115.12..-112.22 z 1.67..3.22
   C83                    C_0603_1608Metric                        x 62.48..64.08 y -31.81..-31.01 z 1.67..2.47
   C7                     C_1210_3225Metric                        x 47.55..50.05 y -107.69..-104.49 z 1.67..4.17
   C75                    CP_Elec_10x14.3                          x 87.52..104.84 y -124.84..-102.18 z 1.67..18.17
   R52                    R_2512_6332Metric                        x 54.95..61.25 y -97.62..-94.42 z 1.67..2.27
   C84                    C_0603_1608Metric                        x 62.48..64.08 y -58.55..-57.75 z 1.67..2.47
   C73                    C_1210_3225Metric                        x 33.52..36.72 y -66.07..-63.57 z 1.67..4.17
   C82                    C_0603_1608Metric                        x 75.43..77.03 y -31.80..-31.00 z 1.67..2.47
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
   M4 thermal pad G579 10 M4 thermal pad G579 10 x 16, 0.93 compre x 113.15..123.15 y -80.70..-64.70 z -0.00..0.93
   M5 thermal pad G579 10 M5 thermal pad G579 10 x 16, 0.93 compre x 105.53..115.53 y -57.28..-41.28 z -0.00..0.93
   M6 thermal pad G579 10 M6 thermal pad G579 10 x 16, 0.93 compre x 66.24..76.24 y -56.79..-40.79 z -0.00..0.93
   M7 thermal pad G579 10 M7 thermal pad G579 10 x 16, 0.93 compre x 103.18..119.18 y -36.38..-26.38 z -0.00..0.93
   M8 tab screw McMaster  M8 tab screw McMaster 92000A107 M2.5 x 1 x 79.27..84.27 y -58.49..-53.49 z 7.15..9.25
   M8 tab screw shank M2. M8 tab screw shank M2.5                  x 80.52..83.02 y -57.24..-54.74 z -4.85..7.15
   M8 gap spacer McMaster M8 gap spacer McMaster 93657A200 nylon 2 x 79.52..84.02 y -58.24..-53.74 z 3.50..5.50
   M8 shoulder washer 772 M8 shoulder washer 7721-7PPSG flange 1.0 x 78.60..84.95 y -59.16..-52.81 z 2.23..3.25
   M8 screwdriver access  M8 screwdriver access (4.0 mm radius, he x 77.77..85.77 y -59.99..-51.99 z 9.25..33.00
   M8 thermal pad G579 10 M8 thermal pad G579 10 x 16, 0.93 compre x 76.77..86.77 y -68.94..-52.94 z -0.00..0.93
   M9 tab screw McMaster  M9 tab screw McMaster 92000A107 M2.5 x 1 x 58.17..63.17 y -44.99..-39.99 z 7.15..9.25
   M9 tab screw shank M2. M9 tab screw shank M2.5                  x 59.42..61.92 y -43.74..-41.24 z -4.85..7.15
   M9 gap spacer McMaster M9 gap spacer McMaster 93657A200 nylon 2 x 58.42..62.92 y -44.74..-40.24 z 3.50..5.50
   M9 shoulder washer 772 M9 shoulder washer 7721-7PPSG flange 1.0 x 57.50..63.85 y -45.66..-39.31 z 2.23..3.25
   M9 screwdriver access  M9 screwdriver access (4.0 mm radius, he x 56.67..64.67 y -46.49..-38.49 z 9.25..33.00
   M9 thermal pad G579 10 M9 thermal pad G579 10 x 16, 0.93 compre x 55.67..65.67 y -55.44..-39.44 z -0.00..0.93
   M10 tab screw McMaster M10 tab screw McMaster 92000A107 M2.5 x  x 55.00..60.00 y -73.06..-68.06 z 7.15..9.25
   M10 tab screw shank M2 M10 tab screw shank M2.5                 x 56.25..58.75 y -71.81..-69.31 z -4.85..7.15
   M10 gap spacer McMaste M10 gap spacer McMaster 93657A200 nylon  x 55.25..59.75 y -72.81..-68.31 z 3.50..5.50
   M10 shoulder washer 77 M10 shoulder washer 7721-7PPSG flange 1. x 54.32..60.67 y -73.73..-67.38 z 2.23..3.25
   M10 screwdriver access M10 screwdriver access (4.0 mm radius, h x 53.50..61.50 y -74.56..-66.56 z 9.25..33.00
   M10 thermal pad G579 1 M10 thermal pad G579 10 x 16, 0.93 compr x 54.45..70.45 y -75.56..-65.56 z -0.00..0.93
   L1 CSCF3218-6R8MC body L1 CSCF3218-6R8MC body 22.5 x 32.0 x 19. x 55.28..84.04 y -34.60..-2.47 z 7.15..26.15
   L1 terminal (height AS L1 terminal (height ASSUMED 3 mm)        x 84.04..87.84 y -15.54..-9.54 z 7.15..10.15
   L1 terminal (height AS L1 terminal (height ASSUMED 3 mm)        x 84.04..87.84 y -27.54..-21.54 z 7.15..10.15
   R1 CSS4J-4026R-1L00F ( R1 CSS4J-4026R-1L00F (H 2.70 max)        x 88.65..95.35 y -16.00..-5.84 z 7.15..9.85
   J10 Samtec ESQ-115-44- J10 Samtec ESQ-115-44-G-D socket body (1 x 87.67..92.75 y -82.99..-44.89 z 7.15..25.82
   J11 Samtec TSW-115-07- J11 Samtec TSW-115-07-G-D insulator (2.5 x 87.67..92.75 y -82.99..-44.89 z 26.06..28.60
   J11 post               J11 post                                 x 88.62..89.26 y -46.48..-45.84 z 20.22..26.06
   J11 tail above the car J11 tail above the card                  x 88.62..89.26 y -46.48..-45.84 z 30.25..31.14
   J11 post               J11 post                                 x 91.16..91.80 y -46.48..-45.84 z 20.22..26.06
   J11 tail above the car J11 tail above the card                  x 91.16..91.80 y -46.48..-45.84 z 30.25..31.14
   J11 post               J11 post                                 x 88.62..89.26 y -49.02..-48.38 z 20.22..26.06
   J11 tail above the car J11 tail above the card                  x 88.62..89.26 y -49.02..-48.38 z 30.25..31.14
   J11 post               J11 post                                 x 91.16..91.80 y -49.02..-48.38 z 20.22..26.06
   J11 tail above the car J11 tail above the card                  x 91.16..91.80 y -49.02..-48.38 z 30.25..31.14
   J11 post               J11 post                                 x 88.62..89.26 y -51.56..-50.92 z 20.22..26.06
   J11 tail above the car J11 tail above the card                  x 88.62..89.26 y -51.56..-50.92 z 30.25..31.14
   J11 post               J11 post                                 x 91.16..91.80 y -51.56..-50.92 z 20.22..26.06
   J11 tail above the car J11 tail above the card                  x 91.16..91.80 y -51.56..-50.92 z 30.25..31.14
   J11 post               J11 post                                 x 88.62..89.26 y -54.10..-53.46 z 20.22..26.06
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
   J9 wires (11 x 26-28 A J9 wires (11 x 26-28 AWG, bundle 1.5 mm  x 61.89..86.77 y -73.57..-64.77 z 27.10..28.60
   J9 cable-tie head (5.0 J9 cable-tie head (5.0 x 4.5 x 3.5 ASSUM x 67.66..72.67 y -71.42..-66.92 z 25.10..28.60
components listed: 408
