ChristopherCa55/led-driver/BOOST_split_boards/review_fixes_2026-10-11/img/step02/silk_J4J6J5_v1.png

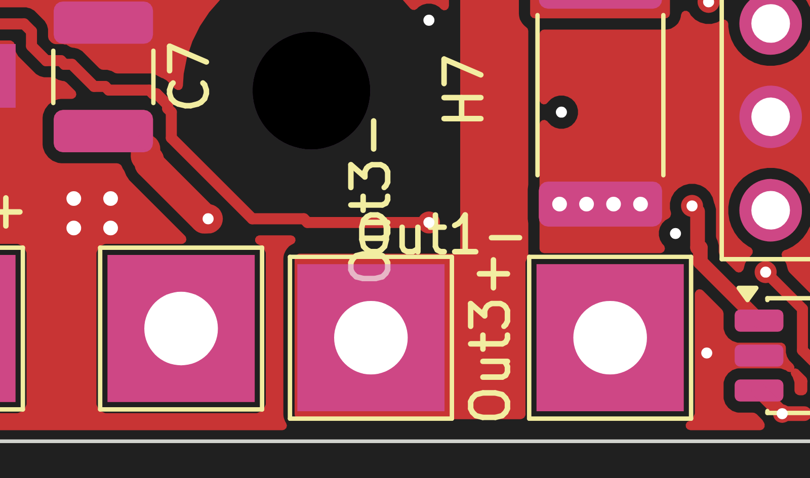
BOOST_split_boards/review_fixes_2026-10-11/img/step02/silk_J4J6J5_v1.png
