ChristopherCa55/led-driver/BOOST_split_boards/review_fixes_2026-10-11/img/step03/12V_In4_before.png

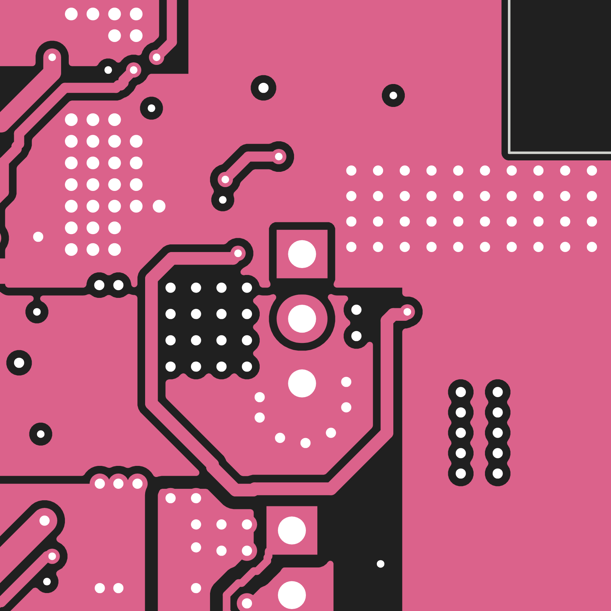
BOOST_split_boards/review_fixes_2026-10-11/img/step03/12V_In4_before.png
