ChristopherCa55/led-driver/BOOST_split_boards/review_fixes_2026-10-11/img/step03/vin_funnel_B_after.png

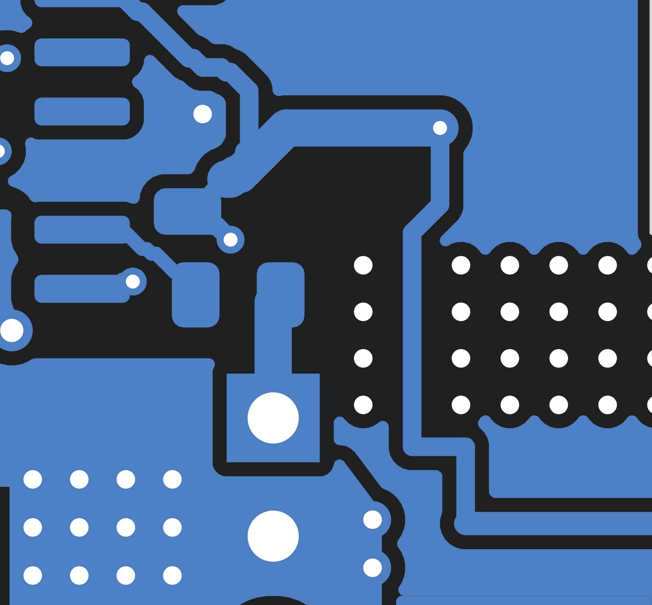
BOOST_split_boards/review_fixes_2026-10-11/img/step03/vin_funnel_B_after.png
