ChristopherCa55/led-driver/BOOST_split_boards/review_fixes_2026-10-11/img/step05/card_free_B_0402_U26.png

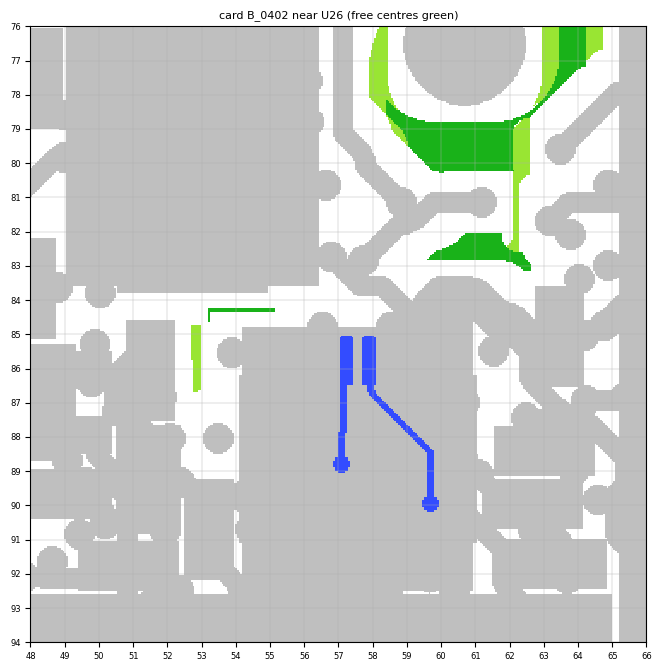
BOOST_split_boards/review_fixes_2026-10-11/img/step05/card_free_B_0402_U26.png
