ChristopherCa55/led-driver/BOOST_split_boards/review_fixes_2026-10-11/img/step05/card_J9_below_F.png

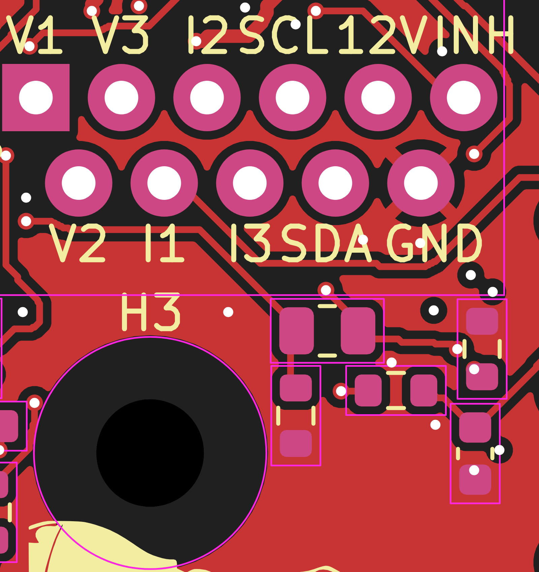
BOOST_split_boards/review_fixes_2026-10-11/img/step05/card_J9_below_F.png
