ChristopherCa55/led-driver/BOOST_split_boards/review_fixes_2026-10-11/img/step05/i2c_area_after_preview.png

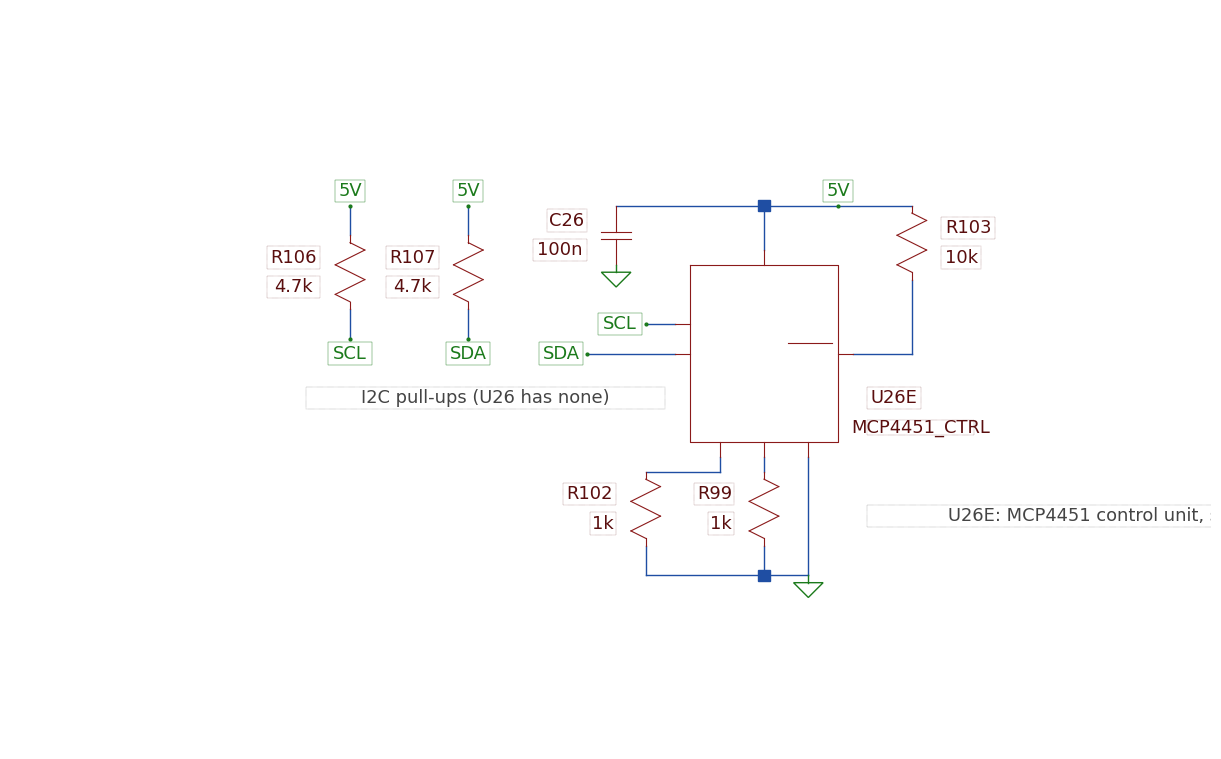
BOOST_split_boards/review_fixes_2026-10-11/img/step05/i2c_area_after_preview.png
