ChristopherCa55/led-driver/BOOST_split_boards/review_fixes_2026-10-11/img/step05/route_fail_dbgC.png

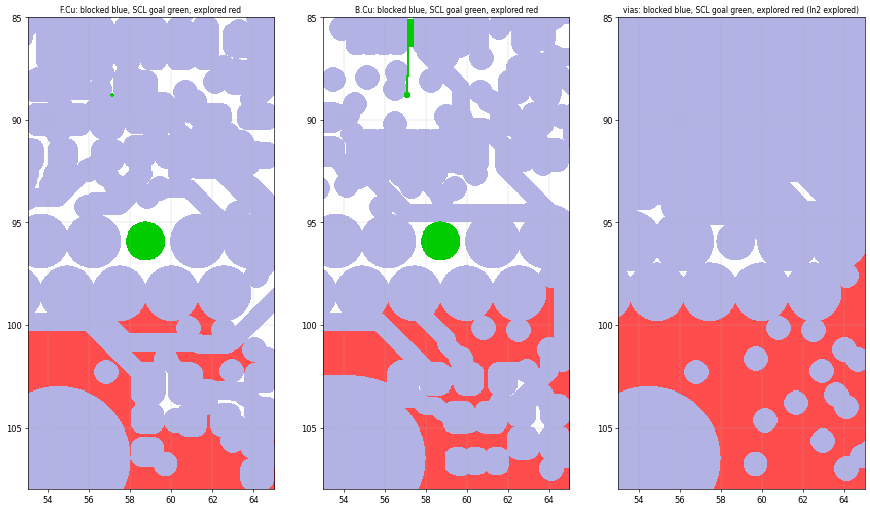
BOOST_split_boards/review_fixes_2026-10-11/img/step05/route_fail_dbgC.png
