ChristopherCa55/led-driver/BOOST_split_boards/review_fixes_2026-10-11/img/step05e/band_F.png

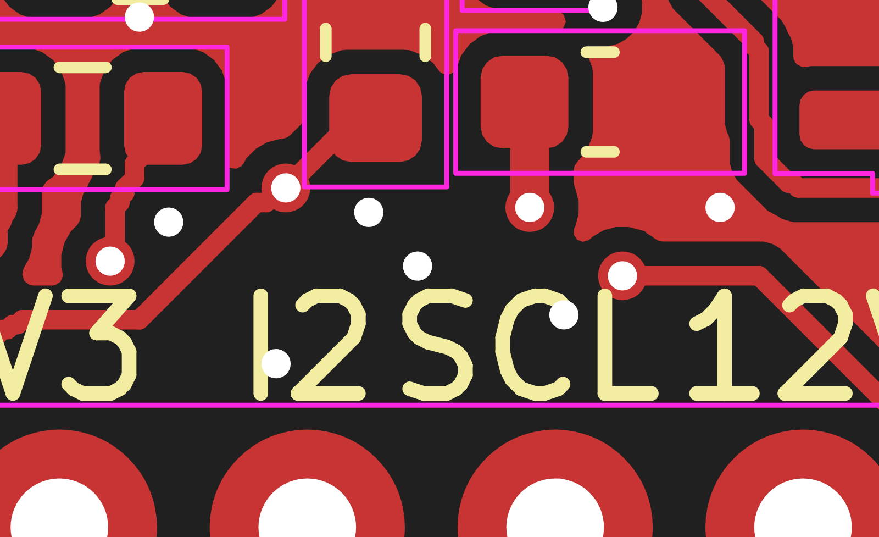
BOOST_split_boards/review_fixes_2026-10-11/img/step05e/band_F.png
