ChristopherCa55/led-driver/BOOST_split_boards/review_fixes_2026-10-11/img/step05e/j9_F_after.png

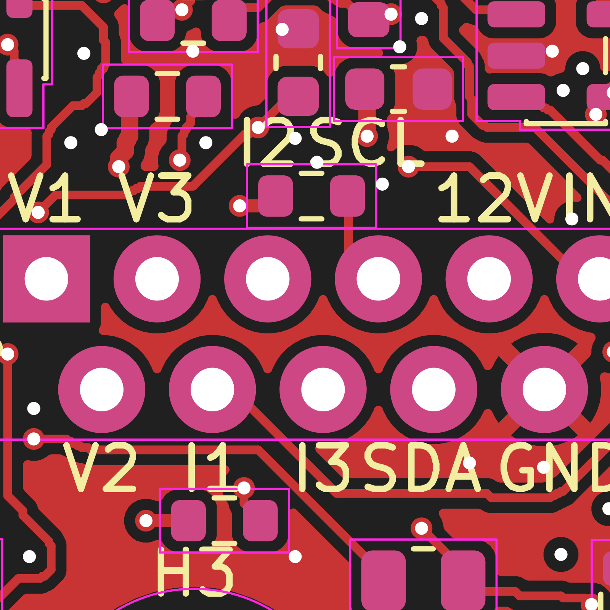
BOOST_split_boards/review_fixes_2026-10-11/img/step05e/j9_F_after.png
