ChristopherCa55/led-driver/BOOST_split_boards/review_fixes_2026-10-11/img/step06/vin_vias_F_after.png

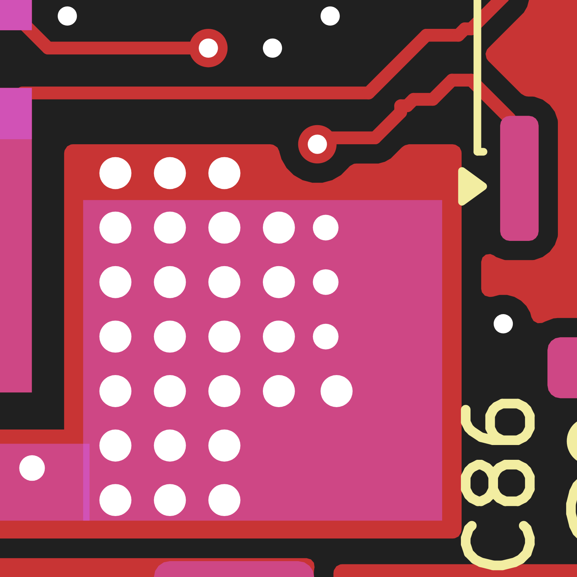
BOOST_split_boards/review_fixes_2026-10-11/img/step06/vin_vias_F_after.png
