ChristopherCa55/led-driver/BOOST_split_boards/review_fixes_2026-10-11/img/step07/stitch_In1_after.png

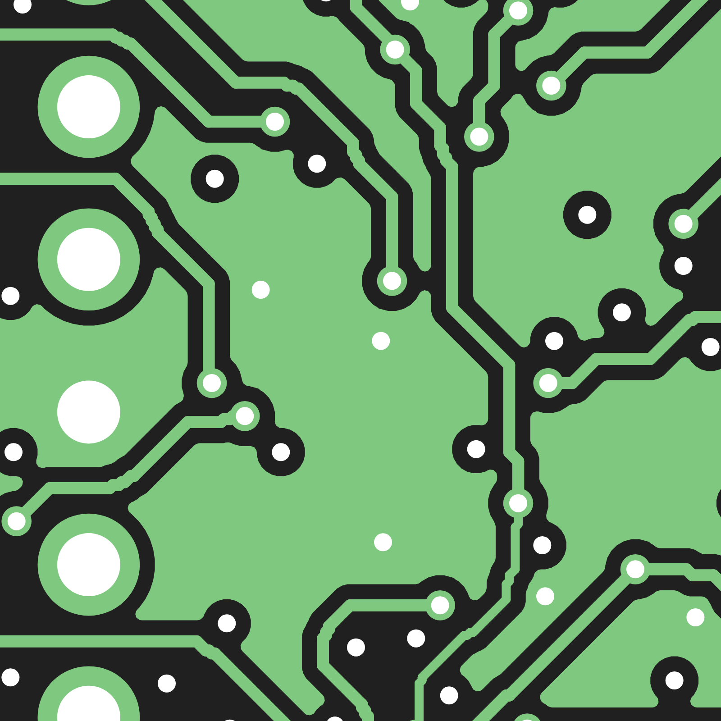
BOOST_split_boards/review_fixes_2026-10-11/img/step07/stitch_In1_after.png
