ChristopherCa55/led-driver/BOOST_split_boards/review_fixes_2026-10-11/img/step08/u101ay_In2_after.png

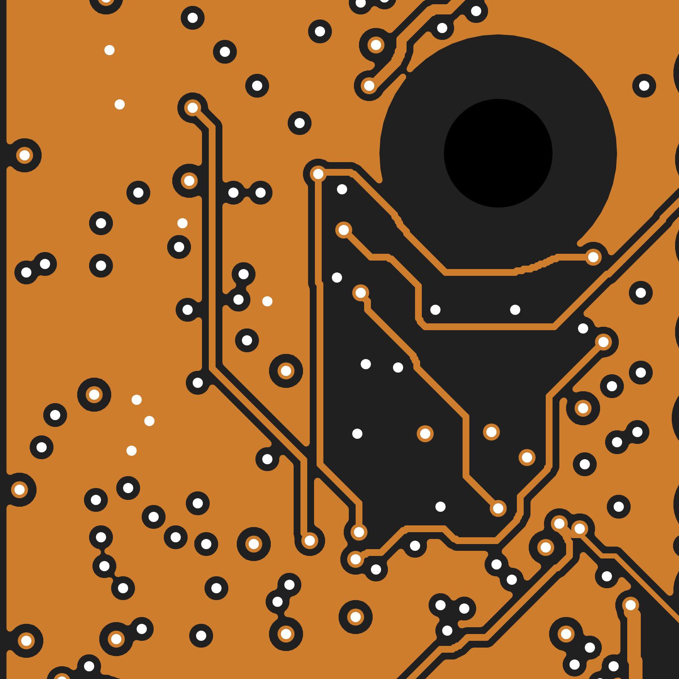
BOOST_split_boards/review_fixes_2026-10-11/img/step08/u101ay_In2_after.png
