ChristopherCa55/led-driver/BOOST_split_boards/review_fixes_2026-10-11/img/step11/card_after.png

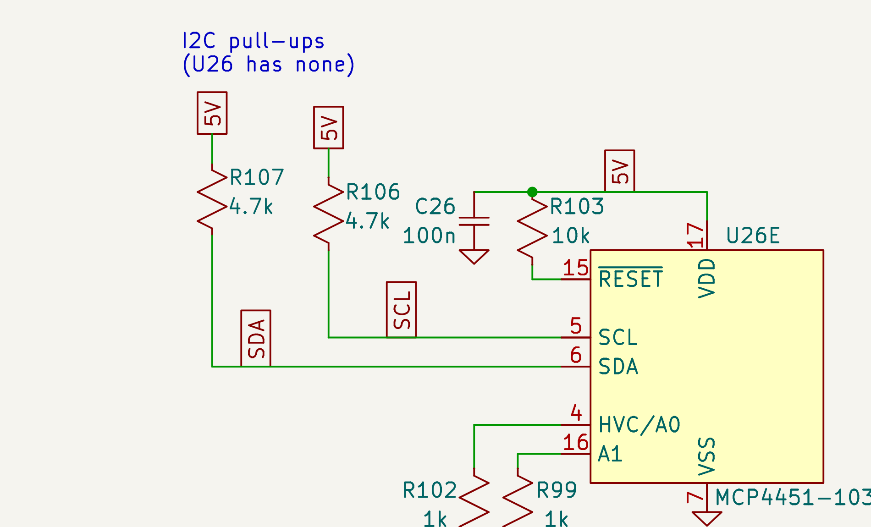
BOOST_split_boards/review_fixes_2026-10-11/img/step11/card_after.png
