ChristopherCa55/led-driver/BOOST_split_boards/review_fixes_2026-10-11/work/step03/heatmap/step_gnd_heatmap.png

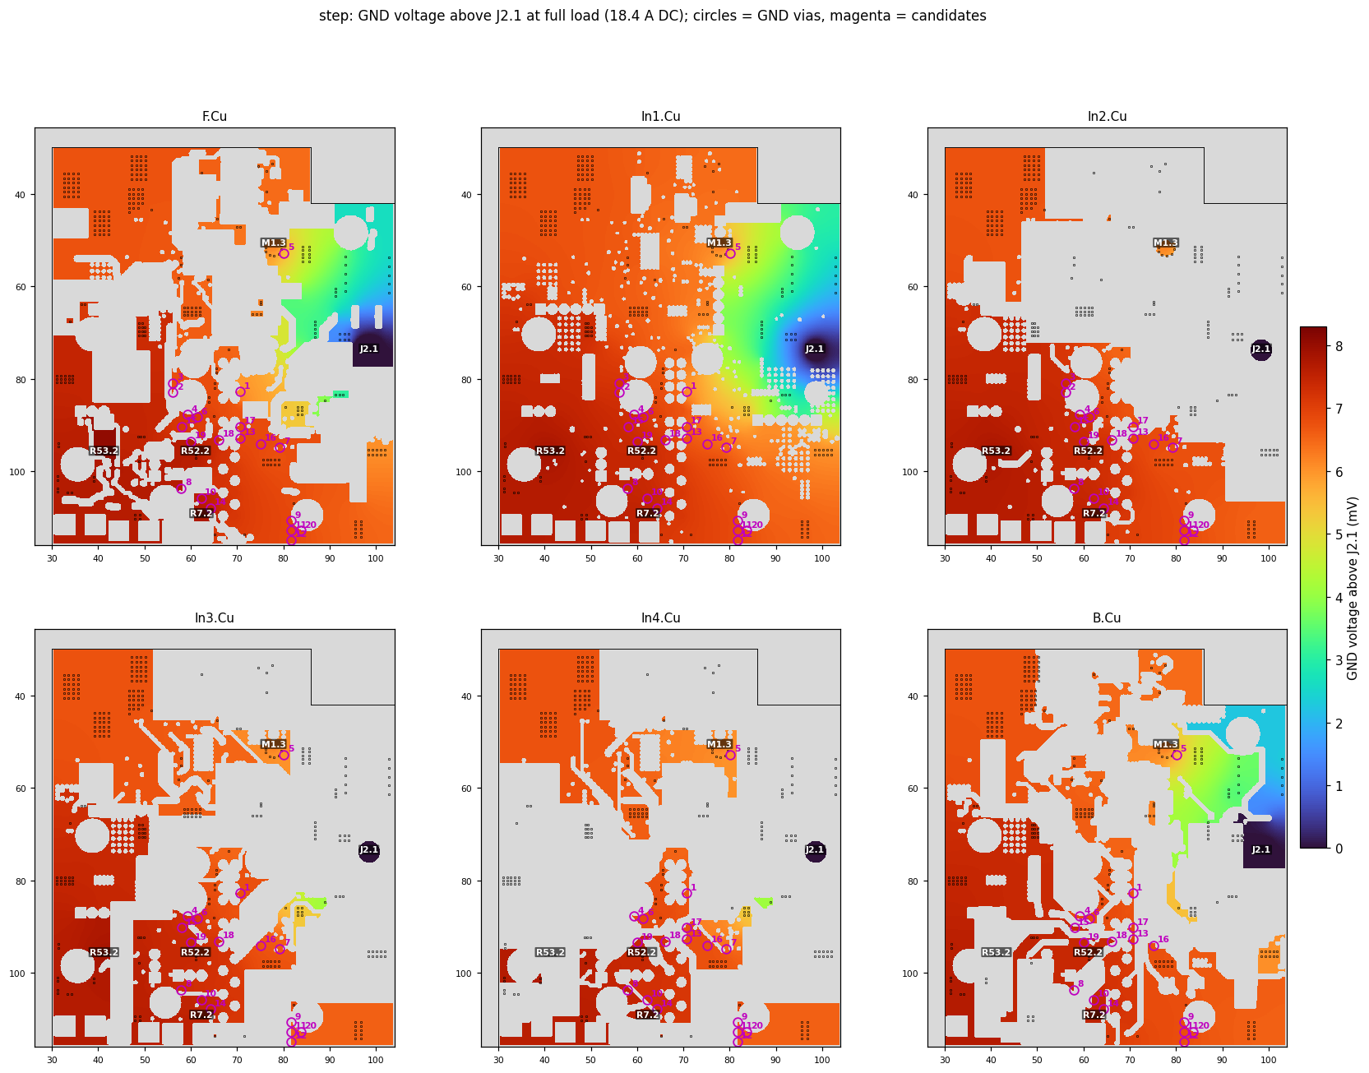
BOOST_split_boards/review_fixes_2026-10-11/work/step03/heatmap/step_gnd_heatmap.png
