ChristopherCa55/led-driver/BOOST_split_boards/precharge_surge_2026-09-30/fit_results.txt

D28 SOD123F: 638 feasible placements (old centre 46.00, 91.50)
   centre (45.85, 91.35) rot   0  spare >= 0.30 mm  K/A overlap on own copper 0.78 / 0.92 mm2  GND fill cut 0.00 mm2
   centre (45.80, 91.40) rot   0  spare >= 0.30 mm  K/A overlap on own copper 0.75 / 0.92 mm2  GND fill cut 0.00 mm2
   centre (45.75, 91.50) rot   0  spare >= 0.30 mm  K/A overlap on own copper 0.70 / 0.96 mm2  GND fill cut 0.00 mm2
D29 SOD123F: 958 feasible placements (old centre 52.00, 87.25)
   centre (52.00, 87.25) rot   0  spare >= 0.30 mm  K/A overlap on own copper 0.94 / 0.94 mm2  GND fill cut 0.06 mm2
   centre (52.05, 87.25) rot   0  spare >= 0.30 mm  K/A overlap on own copper 0.91 / 0.99 mm2  GND fill cut 0.07 mm2
   centre (52.00, 87.20) rot   0  spare >= 0.30 mm  K/A overlap on own copper 0.98 / 0.92 mm2  GND fill cut 0.07 mm2
D30 SOD123F: 247 feasible placements (old centre 102.85, 89.60)
   centre (103.05, 89.50) rot 270  spare >= 0.30 mm  K/A overlap on own copper 0.70 / 0.83 mm2  GND fill cut 0.00 mm2
   centre (103.05, 89.45) rot 270  spare >= 0.30 mm  K/A overlap on own copper 0.67 / 0.83 mm2  GND fill cut 0.00 mm2
   centre (103.05, 89.40) rot 270  spare >= 0.30 mm  K/A overlap on own copper 0.64 / 0.86 mm2  GND fill cut 0.00 mm2
D28 SMAF: 0 feasible placements (old centre 46.00, 91.50)
D29 SMAF: 431 feasible placements (old centre 52.00, 87.25)
   centre (51.55, 86.95) rot   0  spare >= 0.30 mm  K/A overlap on own copper 0.71 / 1.24 mm2  GND fill cut 4.17 mm2
   centre (51.55, 87.00) rot   0  spare >= 0.30 mm  K/A overlap on own copper 0.68 / 1.25 mm2  GND fill cut 4.20 mm2
   centre (51.55, 86.90) rot   0  spare >= 0.30 mm  K/A overlap on own copper 0.74 / 1.23 mm2  GND fill cut 4.22 mm2
D30 SMAF: 0 feasible placements (old centre 102.85, 89.60)
D28 SMBF: 0 feasible placements (old centre 46.00, 91.50)
D29 SMBF: 0 feasible placements (old centre 52.00, 87.25)
D30 SMBF: 0 feasible placements (old centre 102.85, 89.60)
D28 SMB: 0 feasible placements (old centre 46.00, 91.50)
D29 SMB: 6 feasible placements (old centre 52.00, 87.25)
   centre (51.75, 89.35) rot  90  spare >= 0.05 mm  K/A overlap on own copper 0.68 / 2.30 mm2  GND fill cut 8.23 mm2
   centre (51.70, 89.40) rot  90  spare >= 0.00 mm  K/A overlap on own copper 0.75 / 2.30 mm2  GND fill cut 8.14 mm2
   centre (51.75, 89.40) rot  90  spare >= 0.00 mm  K/A overlap on own copper 0.66 / 2.30 mm2  GND fill cut 8.15 mm2
D30 SMB: 0 feasible placements (old centre 102.85, 89.60)
