ChristopherCa55/led-driver/BOOST_split_boards/precharge_surge_2026-09-30/surge_results.txt

S2MW_ri0_rs17
   D28 pk 98.5 A  I2t 0.894 A2s  >10%pk 188 us  VF@pk 2.73 V
   D29 pk 98.5 A  I2t 0.894 A2s  >10%pk 188 us  VF@pk 2.73 V
   D30 pk 98.5 A  I2t 0.894 A2s  >10%pk 188 us  VF@pk 2.73 V
   battery pk 610 A
S2MW_ri10_rs17
   D28 pk 73.9 A  I2t 0.546 A2s  >10%pk 250 us  VF@pk 2.30 V
   D29 pk 73.9 A  I2t 0.546 A2s  >10%pk 250 us  VF@pk 2.30 V
   D30 pk 73.9 A  I2t 0.546 A2s  >10%pk 250 us  VF@pk 2.30 V
   battery pk 458 A
S2MW_ri40_rs17
   D28 pk 41.0 A  I2t 0.247 A2s  >10%pk 546 us  VF@pk 1.71 V
   D29 pk 41.0 A  I2t 0.247 A2s  >10%pk 546 us  VF@pk 1.71 V
   D30 pk 41.0 A  I2t 0.247 A2s  >10%pk 546 us  VF@pk 1.71 V
   battery pk 258 A
RS3MF_ri0_rs11
   D28 pk 100.6 A  I2t 0.931 A2s  >10%pk 184 us  VF@pk 2.14 V
   D29 pk 100.6 A  I2t 0.931 A2s  >10%pk 184 us  VF@pk 2.14 V
   D30 pk 100.6 A  I2t 0.931 A2s  >10%pk 184 us  VF@pk 2.14 V
   battery pk 619 A
RS3MF_ri0_rs6
   D28 pk 102.3 A  I2t 0.960 A2s  >10%pk 182 us  VF@pk 1.65 V
   D29 pk 102.3 A  I2t 0.960 A2s  >10%pk 182 us  VF@pk 1.65 V
   D30 pk 102.3 A  I2t 0.960 A2s  >10%pk 182 us  VF@pk 1.65 V
   battery pk 626 A
RS3MF_ri10_rs11
   D28 pk 75.3 A  I2t 0.564 A2s  >10%pk 243 us  VF@pk 1.85 V
   D29 pk 75.3 A  I2t 0.564 A2s  >10%pk 243 us  VF@pk 1.85 V
   D30 pk 75.3 A  I2t 0.564 A2s  >10%pk 243 us  VF@pk 1.85 V
   battery pk 463 A
RS3MF_ri40_rs11
   D28 pk 41.8 A  I2t 0.252 A2s  >10%pk 536 us  VF@pk 1.46 V
   D29 pk 41.8 A  I2t 0.252 A2s  >10%pk 536 us  VF@pk 1.46 V
   D30 pk 41.8 A  I2t 0.252 A2s  >10%pk 536 us  VF@pk 1.46 V
   battery pk 259 A
