ChristopherCa55/led-driver/BOOST_split_boards/sim_m1_2026-09-24/deadtime_results.txt

== m1_routed_nom.raw  (threshold 1.8 V, 123 M1 turn-offs in 35-39 ms)
 ch1 M2: 41 events
   rail driver output rises           min    4.3  median    4.8  max    5.7 ns
   M1 die Vds > 5 V                   min   25.4  median   25.4  max   25.4 ns
   rail FET die Vgs > Vth             min   66.4  median   67.0  max   67.9 ns
   M1 die Vgs < Vth                   min  107.9  median  107.9  max  108.0 ns
   MARGIN (Vds>5 V -> rail Vgs>Vth)   min   41.0  median   41.6  max   42.5 ns
 ch2 M3: 41 events
   rail driver output rises           min    4.5  median    5.1  max    5.6 ns
   M1 die Vds > 5 V                   min   23.3  median   23.3  max   23.3 ns
   rail FET die Vgs > Vth             min   69.4  median   70.0  max   70.5 ns
   M1 die Vgs < Vth                   min  124.6  median  124.6  max  124.7 ns
   MARGIN (Vds>5 V -> rail Vgs>Vth)   min   46.1  median   46.7  max   47.2 ns
 ch3 M4: 41 events
   rail driver output rises           min    4.1  median    4.7  max    5.8 ns
   M1 die Vds > 5 V                   min   23.3  median   23.3  max   23.3 ns
   rail FET die Vgs > Vth             min   69.3  median   69.8  max   70.8 ns
   M1 die Vgs < Vth                   min  124.5  median  124.5  max  124.5 ns
   MARGIN (Vds>5 V -> rail Vgs>Vth)   min   46.0  median   46.4  max   47.5 ns
 all channels: margin min 41.0 ns, median 46.4 ns (pass >= ~20 ns)
 reverse current into M2 drain: peak 1.06 A (pass <= ~2 A)
 reverse current into M3 drain: peak 0.97 A (pass <= ~2 A)
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
   MARGIN (Vds>5 V -> rail Vgs>Vth)   min   24.0  median   24.1  max   24.7 ns
 ch3 M4: 41 events
   rail driver output rises           min    4.4  median    4.9  max    5.6 ns
   M1 die Vds > 5 V                   min   27.4  median   27.4  max   27.4 ns
   rail FET die Vgs > Vth             min   51.4  median   51.7  max   52.2 ns
   M1 die Vgs < Vth                   min  175.1  median  175.2  max  175.2 ns
   MARGIN (Vds>5 V -> rail Vgs>Vth)   min   24.0  median   24.3  max   24.8 ns
 all channels: margin min 18.6 ns, median 24.1 ns (pass >= ~20 ns)
 reverse current into M2 drain: peak 0.85 A (pass <= ~2 A)
 reverse current into M3 drain: peak 0.98 A (pass <= ~2 A)
 reverse current into M4 drain: peak 1.05 A (pass <= ~2 A)
 M1 die Vds peak 66.3 V; LX pin peak 60.5 V; TVS avg 4.1 mW
