ChristopherCa55/led-driver/BOOST_split_boards/ltspice_layout_handoff_2026-10-05/calibration/ltspice_captures/index.md

# LTspice captures for calibration (2026-10-05)

Captured with `tools/ltspice_capture.py`, with the user's permission, from the frozen original
(`reference/LTspice_original/BOOST.asc`).

| View | Region (schematic units) | Image | Shows |
|---|---|---|---|
| orig_battery_R1 | (-720, 150) – (-200, 600) | 1938×1158 px | The original's battery/R1/L1/M1 corner. Text collisions visible ("S1 rsense_lo", "C69 680µ680µ680µ") |
| orig_EA1 | (700, 200) – (1250, 560) | 1938×1158 px | The original's channel-1 error amplifier; used to calibrate the text-size model |
| orig_frame_mode_test | (700, 150) – (1250, 560) | 1938×1158 px | The block mode, on a temporary copy with a `[TEST]` frame: the dashed frame and title as LTspice draws them |
