ChristopherCa55/led-driver/BOOST_split_boards/ltspice_layout_handoff_2026-10-05/calibration/ltspice_captures/orig_EA1.png

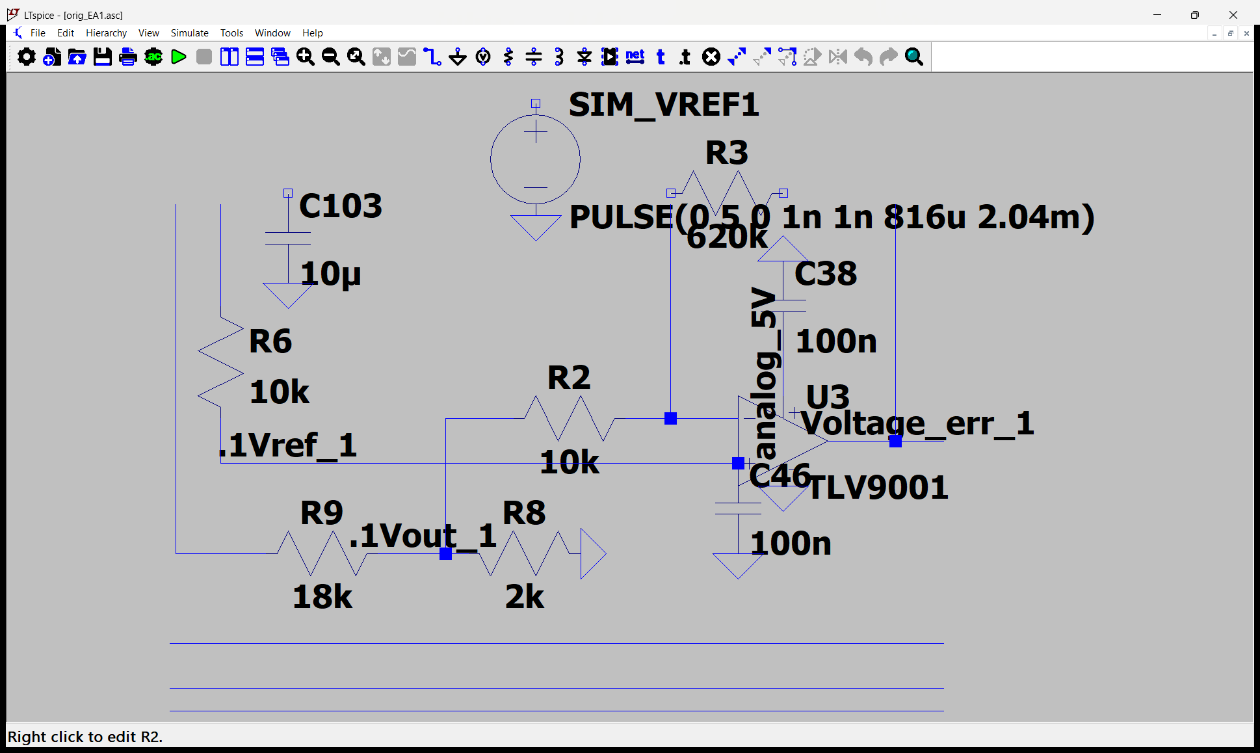
BOOST_split_boards/ltspice_layout_handoff_2026-10-05/calibration/ltspice_captures/orig_EA1.png
