ChristopherCa55/led-driver/BOOST_split_boards/review_fixes_2026-10-11/img/mock/edge_test.png

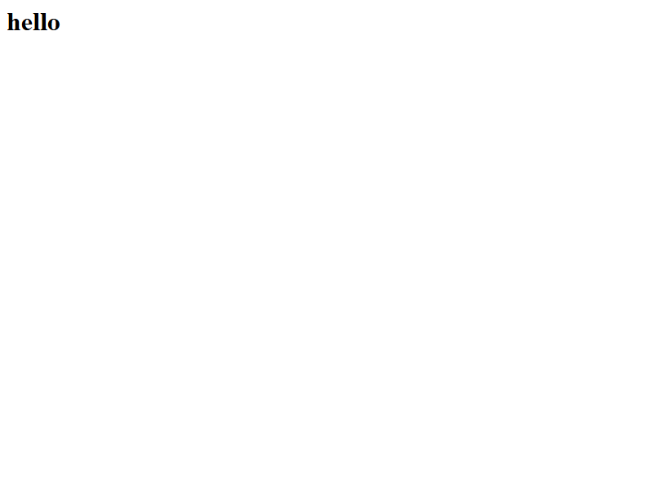
BOOST_split_boards/review_fixes_2026-10-11/img/mock/edge_test.png
