ChristopherCa55/led-driver/BOOST_split_boards/route_2026-09-16/work/isns_test.png

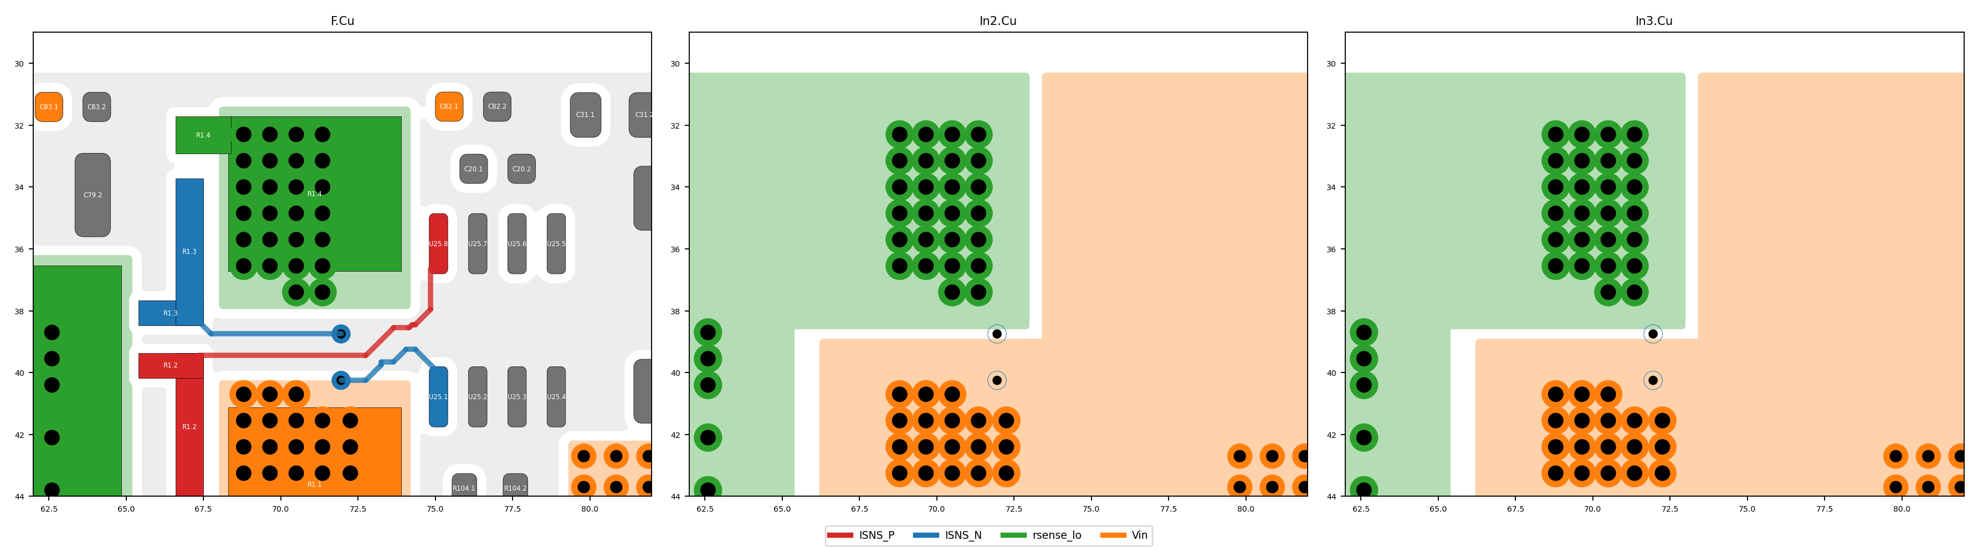
BOOST_split_boards/route_2026-09-16/work/isns_test.png
