ChristopherCa55/led-driver/BOOST_split_boards/assembly_3d_2026-09-30/work/build_log.txt

card to tall power part                              C77                                                        card U106                                                      3.15  part top 23.60
card to tall power part                              C75                                                        card C67                                                       4.77  part top 23.60
card to tall power part                              C78                                                        card U104                                                      3.15  part top 23.60
card to tall power part                              C70                                                        card J11 post                                                  3.26  part top 23.60
card to tall power part                              C40                                                        card D7                                                        7.64  part top 19.60
card to tall power part                              C88                                                        card J11 post                                                  3.67  part top 23.60
card to tall power part                              C87                                                        card U104                                                      3.15  part top 23.60
card to tall power part                              C85                                                        card D7                                                        9.23  part top 19.60
card to tall power part                              C69                                                        card BOOST_control_RC2_PCB                                    18.65  part top 19.60
card to tall power part                              C74                                                        card C67                                                       4.12  part top 23.60
card to tall power part                              C86                                                        card BOOST_control_RC2_PCB                                    13.11  part top 23.60
card to tall power part                              C71                                                        card BOOST_control_RC2_PCB                                     6.63  part top 23.60
card to tall power part                              M10                                                        card J9 cable-tie head (5.0 x 4.5 x 3.5 ASSUMED)               11.6  part top 13.55
card to tall power part                              M7                                                         card J11 post                                                 15.53  part top 13.55
card to tall power part                              M1                                                         card BOOST_control_RC2_PCB                                     24.2  part top 13.55
card to tall power part                              M2                                                         card J11 post                                                 10.85  part top 13.55
card to tall power part                              M3                                                         card BOOST_control_RC2_PCB                                    15.85  part top 13.55
card to tall power part                              M5                                                         card U106                                                      13.2  part top 13.55
card to tall power part                              M8                                                         card J11 post                                                  7.95  part top 13.55
card to tall power part                              M9                                                         card J9 cable-tie head (5.0 x 4.5 x 3.5 ASSUMED)              14.47  part top 13.55
card to tall power part                              M4                                                         card U106                                                     14.48  part top 13.55
card to tall power part                              M6                                                         card C97                                                      15.17  part top 13.55
card to tall power part                              L1 CSCF3218-6R8MC body 22.5 x 32.0 x 19.0                  card BOOST_control_RC2_PCB                                     7.83  part top 26.08
vent clearance above can (max height)                C70 EEH-ZU1H221P 16.8 max                                  card C64                                                        3.0  
vent clearance above can (max height)                C71 EEH-ZU1H221P 16.8 max                                  card BOOST_control_RC2_PCB                                     6.12  
vent clearance above can (max height)                C74 EEH-ZU1H221P 16.8 max                                  card C67                                                        3.6  
vent clearance above can (max height)                C75 EEH-ZU1H221P 16.8 max                                  hardware H8 female-female HNSM3-20-5.5-1 (hex 5.5 AF x 20)     2.99  
vent clearance above can (max height)                C77 EEH-ZU1H221P 16.8 max                                  card U106                                                      2.85  
vent clearance above can (max height)                C78 EEH-ZU1H221P 16.8 max                                  card U104                                                      2.85  
vent clearance above can (max height)                C86 EEH-ZU1H221P 16.8 max                                  card BOOST_control_RC2_PCB                                    12.76  
vent clearance above can (max height)                C87 EEH-ZU1H221P 16.8 max                                  card U104                                                      2.85  
vent clearance above can (max height)                C88 EEH-ZU1H221P 16.8 max                                  card J11 Samtec TSW-115-07-G-D insulator (2.54)                3.33  
vent clearance above can (max height)                C40 EEH-ZU1E681UP 12.8 max                                 hardware H6 female-female HNSM3-20-5.5-1 (hex 5.5 AF x 20)      3.2  
vent clearance above can (max height)                C69 EEH-ZU1E681UP 12.8 max                                 hardware M1 tab screw McMaster 92000A107 M2.5 x 12 pan head   10.92  
vent clearance above can (max height)                C85 EEH-ZU1E681UP 12.8 max                                 card D7                                                        8.72  
card outline to L1 body, in plan                     card board                                                 L1                                                             7.42  positive = not overlapping
card to L1, 3D                                       L1 body                                                    card BOOST_control_RC2_PCB                                     7.83  
J9 wire exit                                         J9 wires (11 x 26-28 AWG, bundle 1.5 mm deep ASSUMED)      hardware H7 washers 3 x TR NWE-34815-M3                        1.39  
J9 wire exit                                         J9 cable-tie head (5.0 x 4.5 x 3.5 ASSUMED)                C87 EEH-ZU1H221P 16.8 max                                      3.69  
lid (33.0) to                                        H8 card screw 97790803211 head (5.5 x 2.1)                 lid underside                                                  0.77 UNDER 1 mm 
lid (33.0) to                                        H7 card screw 97790803211 head (5.5 x 2.1)                 lid underside                                                  0.77 UNDER 1 mm 
lid (33.0) to                                        H6 card screw 97790803211 head (5.5 x 2.1)                 lid underside                                                  0.77 UNDER 1 mm 
lid (33.0) to                                        H5 card screw 97790803211 head (5.5 x 2.1)                 lid underside                                                  0.77 UNDER 1 mm 
lid (33.0) to                                        U28                                                        lid underside                                                  1.11  
lid (33.0) to                                        U18                                                        lid underside                                                  1.11  
standoff stack to nearest part                       H5 (with H1 on the card)                                   card D6                                                         0.4 UNDER 1 mm 
standoff stack to nearest part                       H6 (with H2 on the card)                                   card R94                                                       0.43 UNDER 1 mm 
standoff stack to nearest part                       H7 (with H3 on the card)                                   card D3                                                        0.61 UNDER 1 mm 
standoff stack to nearest part                       H8 (with H4 on the card)                                   card R84                                                       0.73 UNDER 1 mm 
screwdriver access (r 4.0 above the head, to the lid M1                                                         C69 EEH-ZU1E681UP 12.8 max                                      0.7 UNDER 1 mm touching = 0.00
screwdriver access, power-board parts only           M1                                                         C69 EEH-ZU1E681UP 12.8 max                                      0.7 UNDER 1 mm the 4.0 mm / 3 mm rule
screwdriver access blocked by the card?              M1                                                         card board                                                    17.81  card clear of the access cylinder
screwdriver access (r 4.0 above the head, to the lid M8                                                         card U101                                                       0.0 UNDER 1 mm touching = 0.00
screwdriver access, power-board parts only           M8                                                         power C87                                                       1.8  the 4.0 mm / 3 mm rule
screwdriver access blocked by the card?              M8                                                         card board                                                      0.0 UNDER 1 mm card over the screw: fit this screw before the card
screwdriver access (r 4.0 above the head, to the lid M9                                                         power C71                                                       0.7 UNDER 1 mm touching = 0.00
screwdriver access, power-board parts only           M9                                                         power C71                                                       0.7 UNDER 1 mm the 4.0 mm / 3 mm rule
screwdriver access blocked by the card?              M9                                                         card board                                                     3.22  card clear of the access cylinder
screwdriver access (r 4.0 above the head, to the lid M10                                                        card J9 wires (11 x 26-28 AWG, bundle 1.5 mm deep ASSUMED)     0.39 UNDER 1 mm touching = 0.00
screwdriver access, power-board parts only           M10                                                        power M9                                                       7.15  the 4.0 mm / 3 mm rule
screwdriver access blocked by the card?              M10                                                        card board                                                     6.39  card clear of the access cylinder
penetrator keep-out                                  penetrator keep-out box (9.5, 3.5), 15 x 10                nothing within 25 mm (the Arduino, CAN module and LED are no   25.0  
penetrator keep-out                                  penetrator keep-out box (118.5, 3.5), 15 x 10              power BOOST_power_RC2_PCB                                       3.0  
added or moved underside part                        D28                                                        power M10                                                      1.13  part bottom 4.31 above the floor
added or moved underside part                        D29                                                        power M8                                                       1.02  part bottom 4.31 above the floor
added or moved underside part                        D30                                                        power R73                                                      1.68  part bottom 4.31 above the floor
added or moved underside part                        R47                                                        power M4                                                       1.18  part bottom 4.96 above the floor
STEP written
GLB written True

*******************************************************************
******        Statistics on Transfer (Write)                 ******

*******************************************************************
******        Transfer Mode = 0  I.E.  As Is       ******

******        Transferring Shape, ShapeType = 0                      ******

** WorkSession : Sending all data

 Step File Name : BOOST_assembly_2026-10-07.step(252619 ents)  Write  Done
