ChristopherCa55/led-driver/BOOST_split_boards/kicad_layout_2026-10-09/work/build_log.txt

declutter: 123 texts/labels moved, 2 still touching something
note: U103B: inputs drawn the other way round (KiCad pin order kept)
note: U103B: inputs drawn the other way round (KiCad pin order kept)
note: U103B: inputs drawn the other way round (KiCad pin order kept)
note: LTspice label Vbattery not used in KiCad (simulation net)
note: LTspice label SRV1 not used in KiCad (simulation net)
note: LTspice label SRV2 not used in KiCad (simulation net)
note: LTspice label SRV3 not used in KiCad (simulation net)
note: SIM_CABLE_RESISTANCE: + pin net None has no KiCad counterpart
note: SNS_CH1 label moved next to NT1 pin 1 (op-amp side of the net tie)
note: SNS_CH2 label moved next to NT2 pin 1 (op-amp side of the net tie)
note: SNS_CH3 label moved next to NT3 pin 1 (op-amp side of the net tie)
0 problems; wrote C:\Users\bubba\OneDrive\Documents\led-driver\BOOST_split_boards\kicad_layout_2026-10-09\work\BOOST.kicad_sch
