ChristopherCa55/led-driver/BOOST_split_boards/review_fixes_2026-10-11/img/mock/index.md

# LTspice captures of C:\Users\bubba\OneDrive\Documents\led-driver\BOOST_split_boards\review_fixes_2026-10-11\work\pristine\LTspice\BOOST.asc

| view | region (schematic units) | image |
|---|---|---|
| d0_directives_before | (-6500, -4600, -4300, -2500) | 1938x1158 px |
