ChristopherCa55/led-driver/BOOST_split_boards/review_fixes_2026-10-11/work/step05d/changes.md

### Step 5: control card

Tracks added (13):

| layer | net | width | from (x, y) | to (x, y) |
|---|---|---|---|---|
| B.Cu | 5V | 0.3 | (52.25, 84.4) | (50.4, 84.4) |
| B.Cu | 5V | 0.3 | (52.69, 84.5) | (52.25, 84.4) |
| B.Cu | SCL | 0.2 | (53.71, 84.5) | (54.05, 84.15) |
| B.Cu | SCL | 0.2 | (54.05, 84.15) | (56.75, 84.15) |
| B.Cu | SCL | 0.2 | (56.75, 84.15) | (57.15, 84.55) |
| B.Cu | SCL | 0.2 | (57.15, 84.55) | (57.15, 85.1) |
| B.Cu | 5V | 0.3 | (59.49, 106.6) | (59.65, 106.75) |
| In2.Cu | SDA | 0.2 | (60, 100.2) | (59.975, 100.075) |
| B.Cu | SDA | 0.2 | (60.5, 105.85) | (60.75, 105.6) |
| B.Cu | SDA | 0.2 | (60.5, 106.15) | (60.5, 105.85) |
| B.Cu | SDA | 0.2 | (60.51, 106.6) | (60.5, 106.15) |
| In2.Cu | SDA | 0.2 | (60.75, 100.95) | (60, 100.2) |
| In2.Cu | SDA | 0.2 | (60.75, 105.6) | (60.75, 100.95) |

Vias added (4), through F.Cu-B.Cu:

| net | x, y | size / drill |
|---|---|---|
| 5V | (50.4, 84.4) | 0.5 / 0.3 |
| 5V | (59.65, 106.75) | 0.5 / 0.3 |
| SDA | (59.975, 100.075) | 0.5 / 0.3 |
| SDA | (60.75, 105.6) | 0.5 / 0.3 |

Footprints (4):

| ref | side | at (x, y) | change |
|---|---|---|---|
| R102 | F.Cu | (52.4011, 84.9123) | value 10k -> 1k |
| R106 | B.Cu | (53.2, 84.5) | added |
| R107 | B.Cu | (60, 106.6) | added |
| R99 | B.Cu | (53.2174, 90.6941) | value 10k -> 1k |
