ChristopherCa55/led-driver/BOOST_split_boards/review_fixes_2026-10-11/img/card_splitters/In4_0err_D5m_8c.png

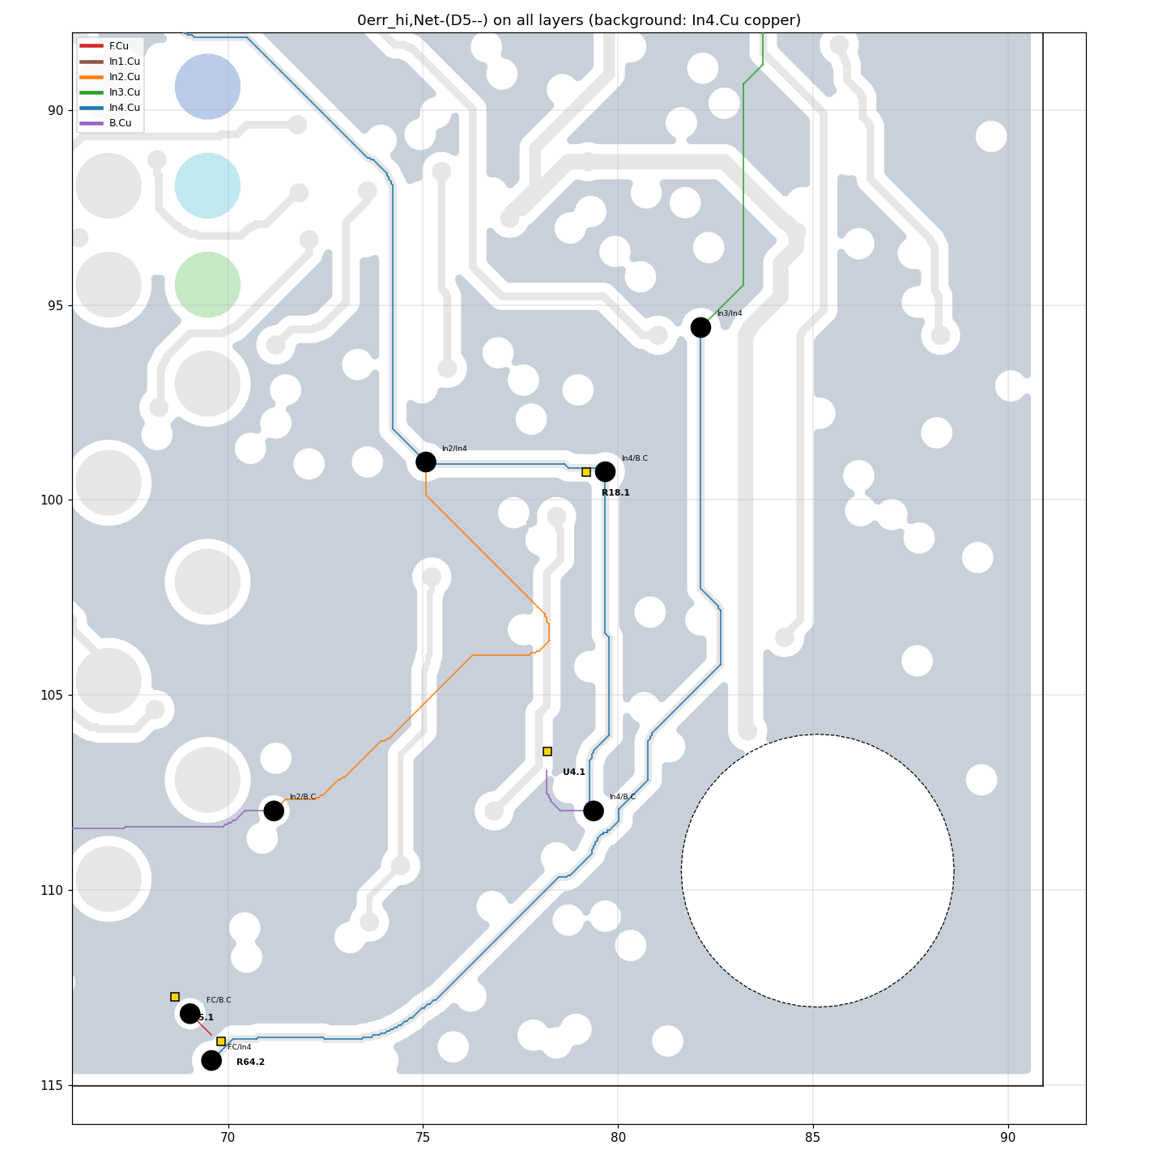
BOOST_split_boards/review_fixes_2026-10-11/img/card_splitters/In4_0err_D5m_8c.png
