ChristopherCa55/led-driver/BOOST_split_boards/review_fixes_2026-10-11/img/card_splitters/SDA_In1.png

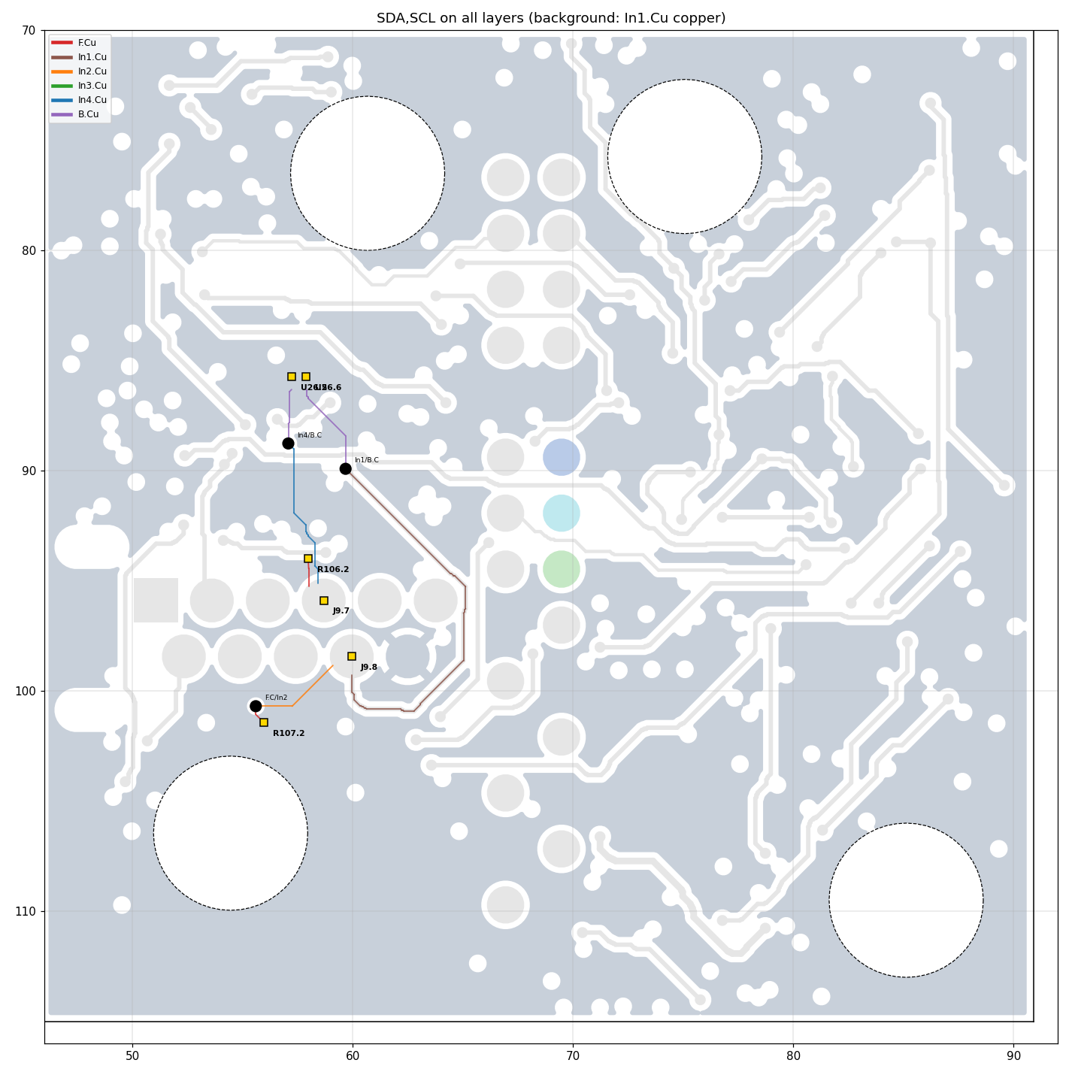
BOOST_split_boards/review_fixes_2026-10-11/img/card_splitters/SDA_In1.png
