ChristopherCa55/led-driver/BOOST_split_boards/review_fixes_2026-10-11/img/mock/d0_directives_before.png

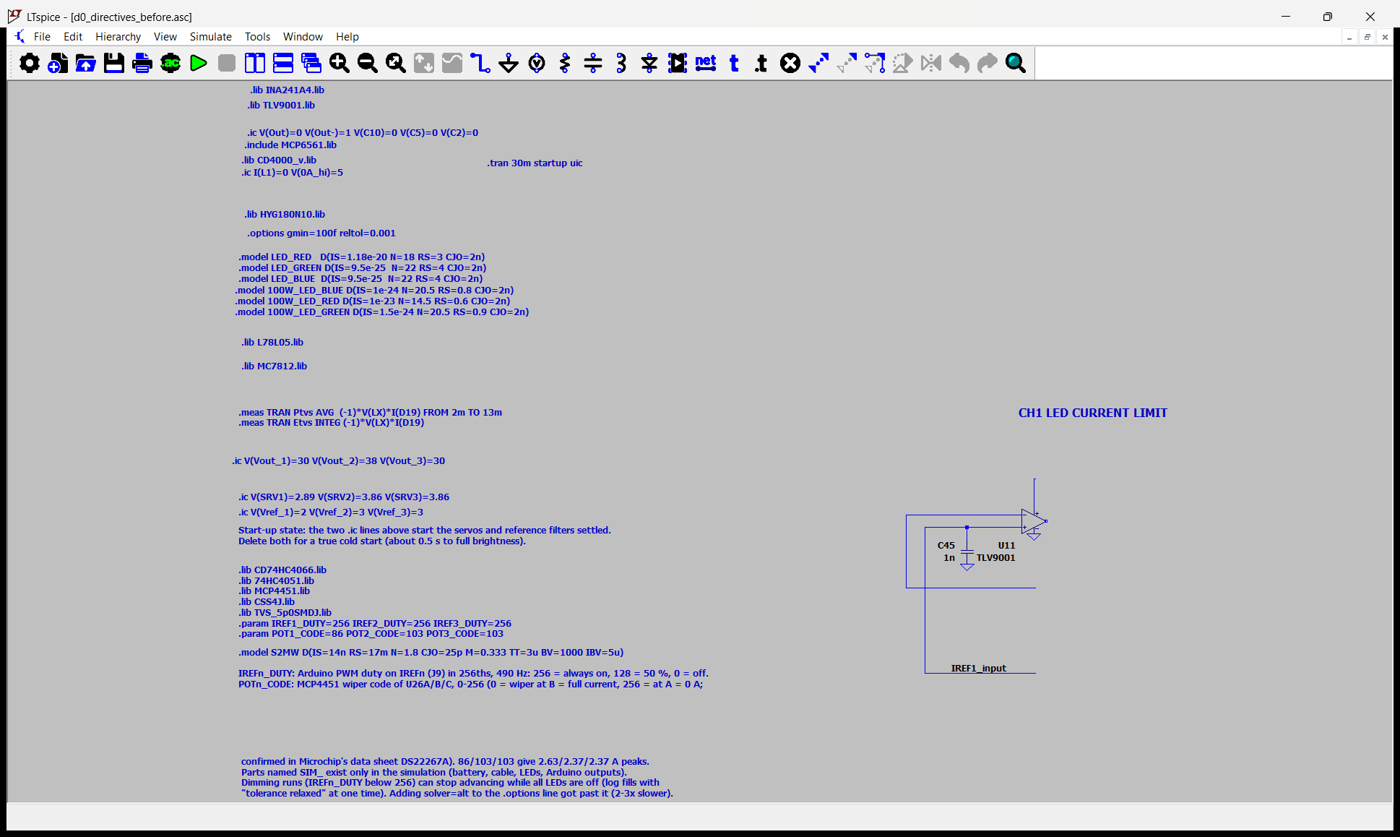
BOOST_split_boards/review_fixes_2026-10-11/img/mock/d0_directives_before.png
