ChristopherCa55/led-driver/BOOST_split_boards/review_fixes_2026-10-11/img/mock/g2_U19_area.png

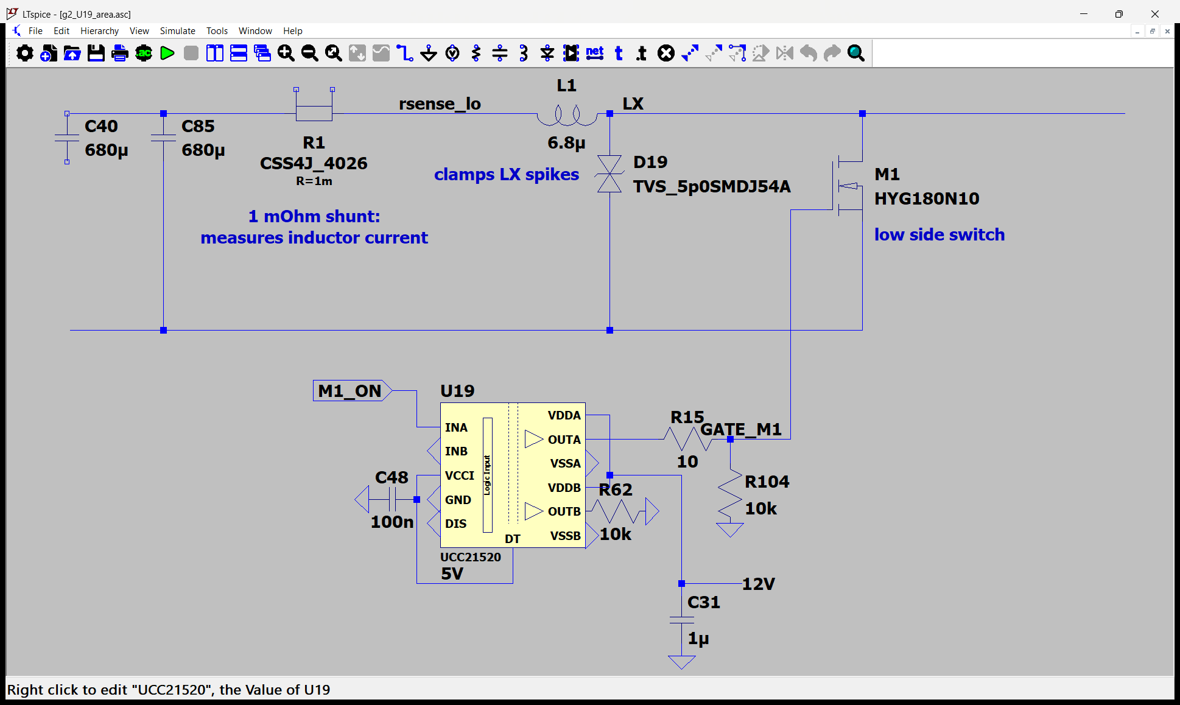
BOOST_split_boards/review_fixes_2026-10-11/img/mock/g2_U19_area.png
