ChristopherCa55/led-driver/BOOST_split_boards/review_fixes_2026-10-11/img/mock/kicad_v4/k1_spares_after.png

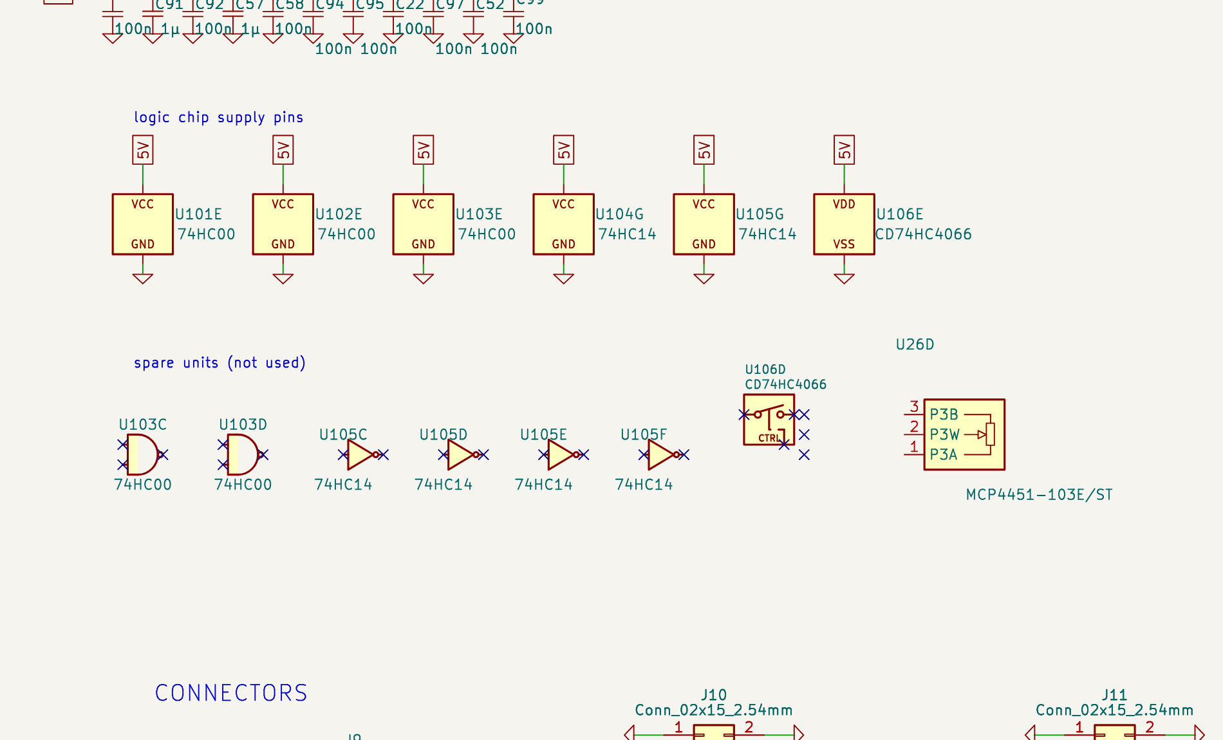
BOOST_split_boards/review_fixes_2026-10-11/img/mock/kicad_v4/k1_spares_after.png
