ChristopherCa55/led-driver/BOOST_split_boards/review_fixes_2026-10-11/img/mock/m1_sequencer.png

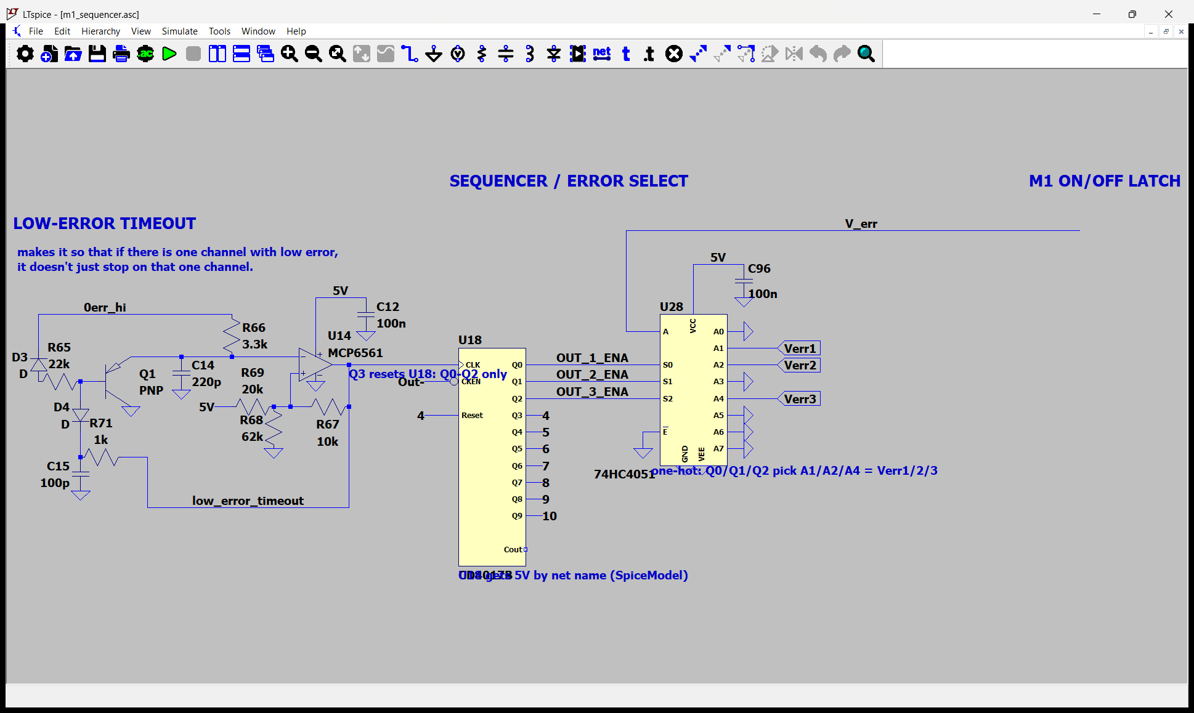
BOOST_split_boards/review_fixes_2026-10-11/img/mock/m1_sequencer.png
