ChristopherCa55/led-driver/BOOST_split_boards/review_fixes_2026-10-11/img/mock/m2_latch_enable.png

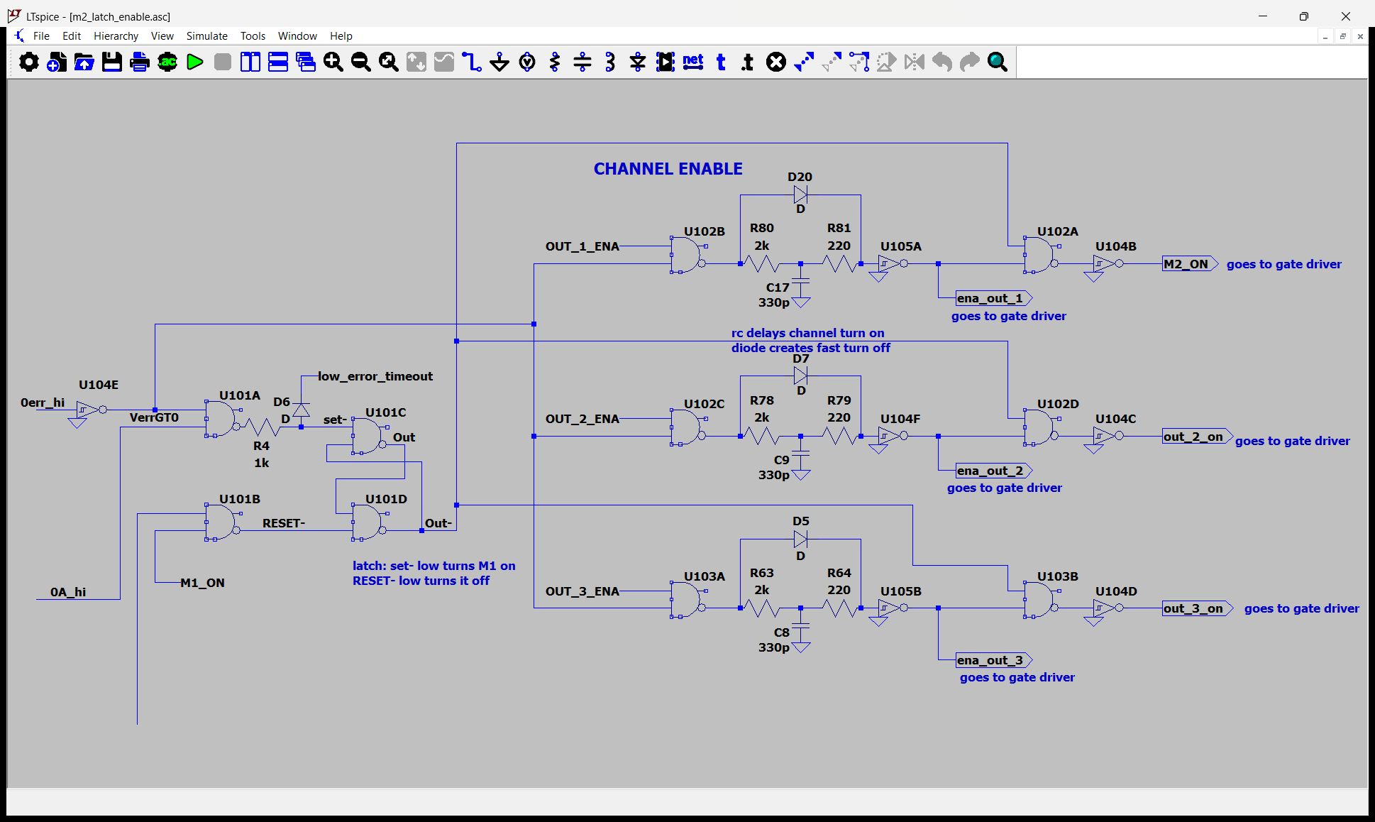
BOOST_split_boards/review_fixes_2026-10-11/img/mock/m2_latch_enable.png
