ChristopherCa55/led-driver/BOOST_split_boards/review_fixes_2026-10-11/img/mock/m3_ch2_titles_v2.png

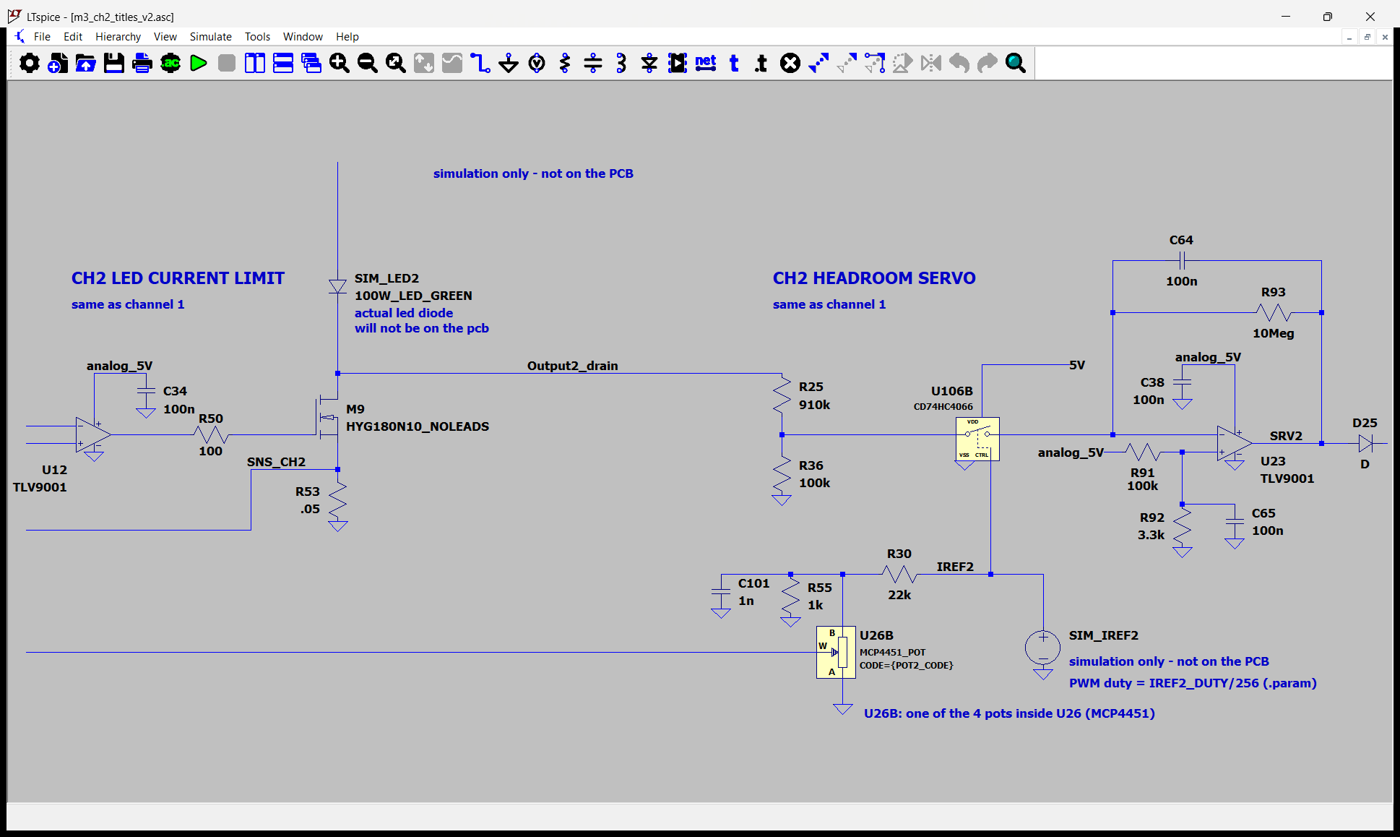
BOOST_split_boards/review_fixes_2026-10-11/img/mock/m3_ch2_titles_v2.png
