ChristopherCa55/led-driver/BOOST_split_boards/review_fixes_2026-10-11/img/research/r01_12V_all_layers_bgIn4.png

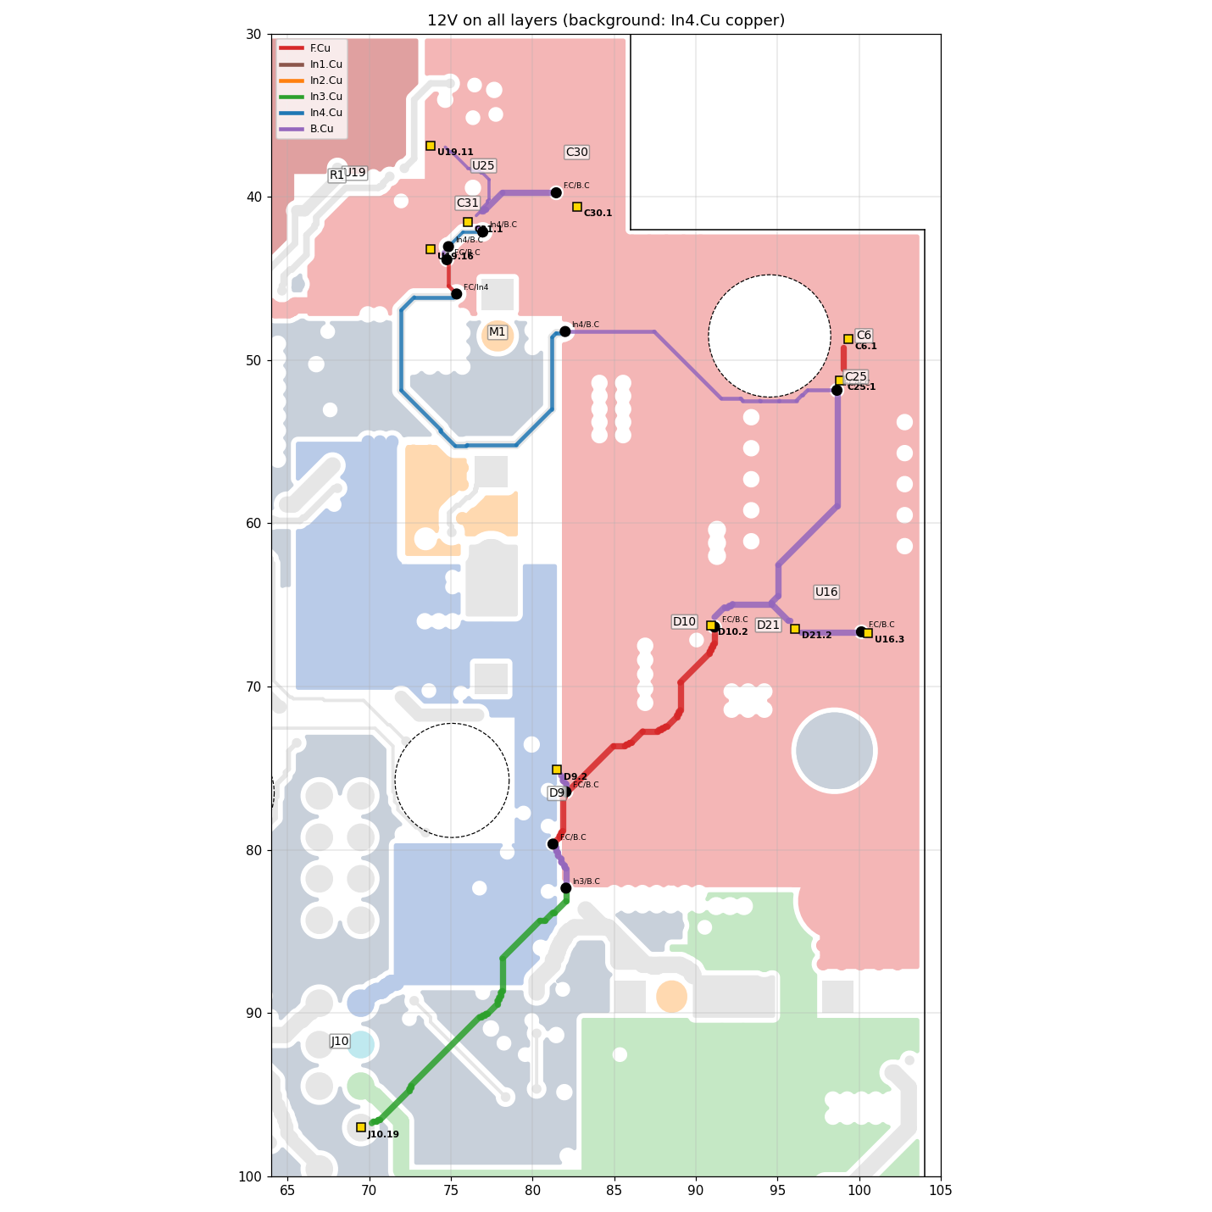
BOOST_split_boards/review_fixes_2026-10-11/img/research/r01_12V_all_layers_bgIn4.png
