ChristopherCa55/led-driver/BOOST_split_boards/review_fixes_2026-10-11/img/research/r02_12V_bgBCu.png

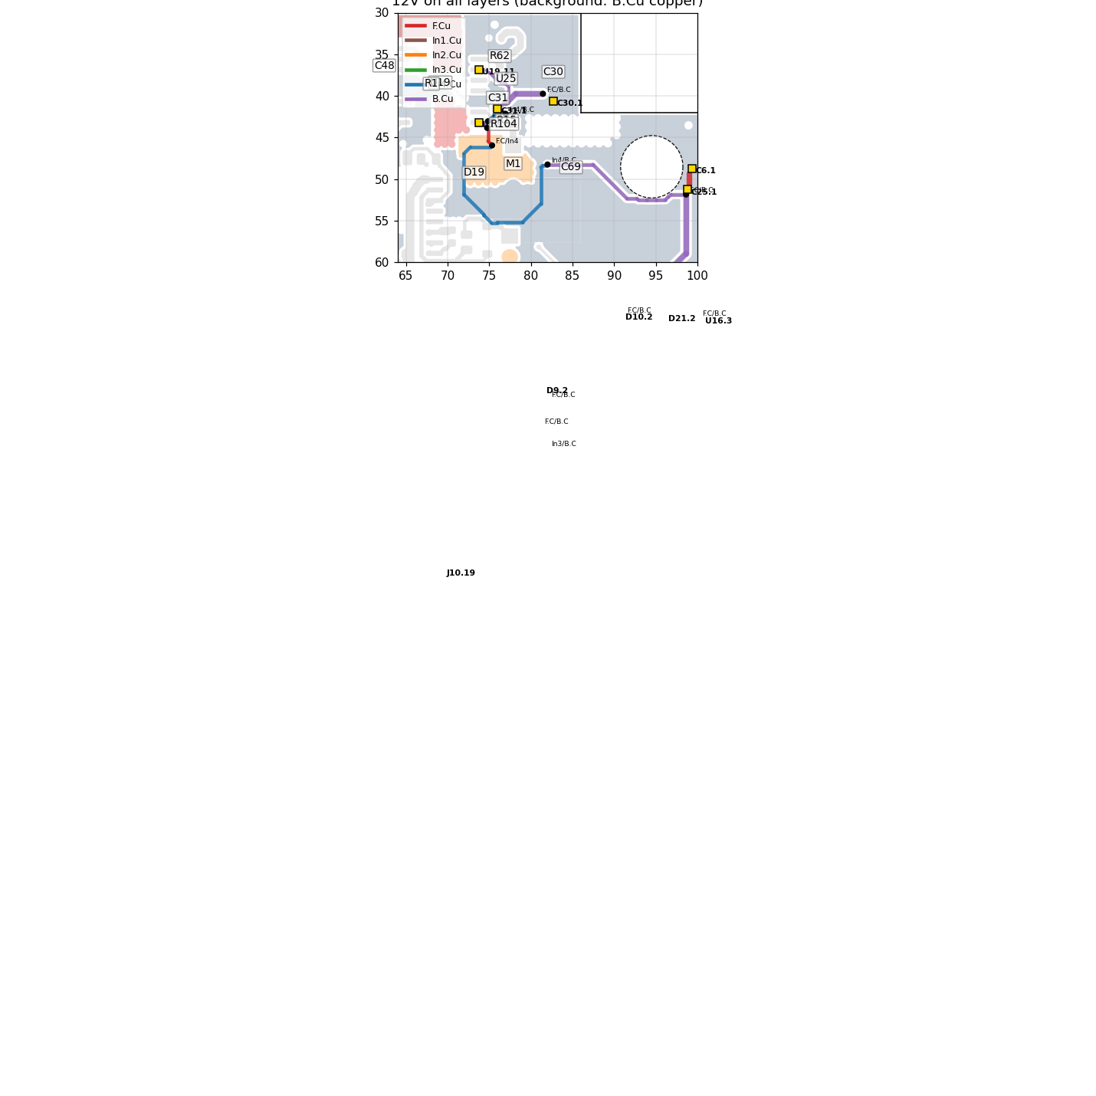
BOOST_split_boards/review_fixes_2026-10-11/img/research/r02_12V_bgBCu.png
