ChristopherCa55/led-driver/BOOST_split_boards/review_fixes_2026-10-11/img/research/r03_Vin_west_bgIn3.png

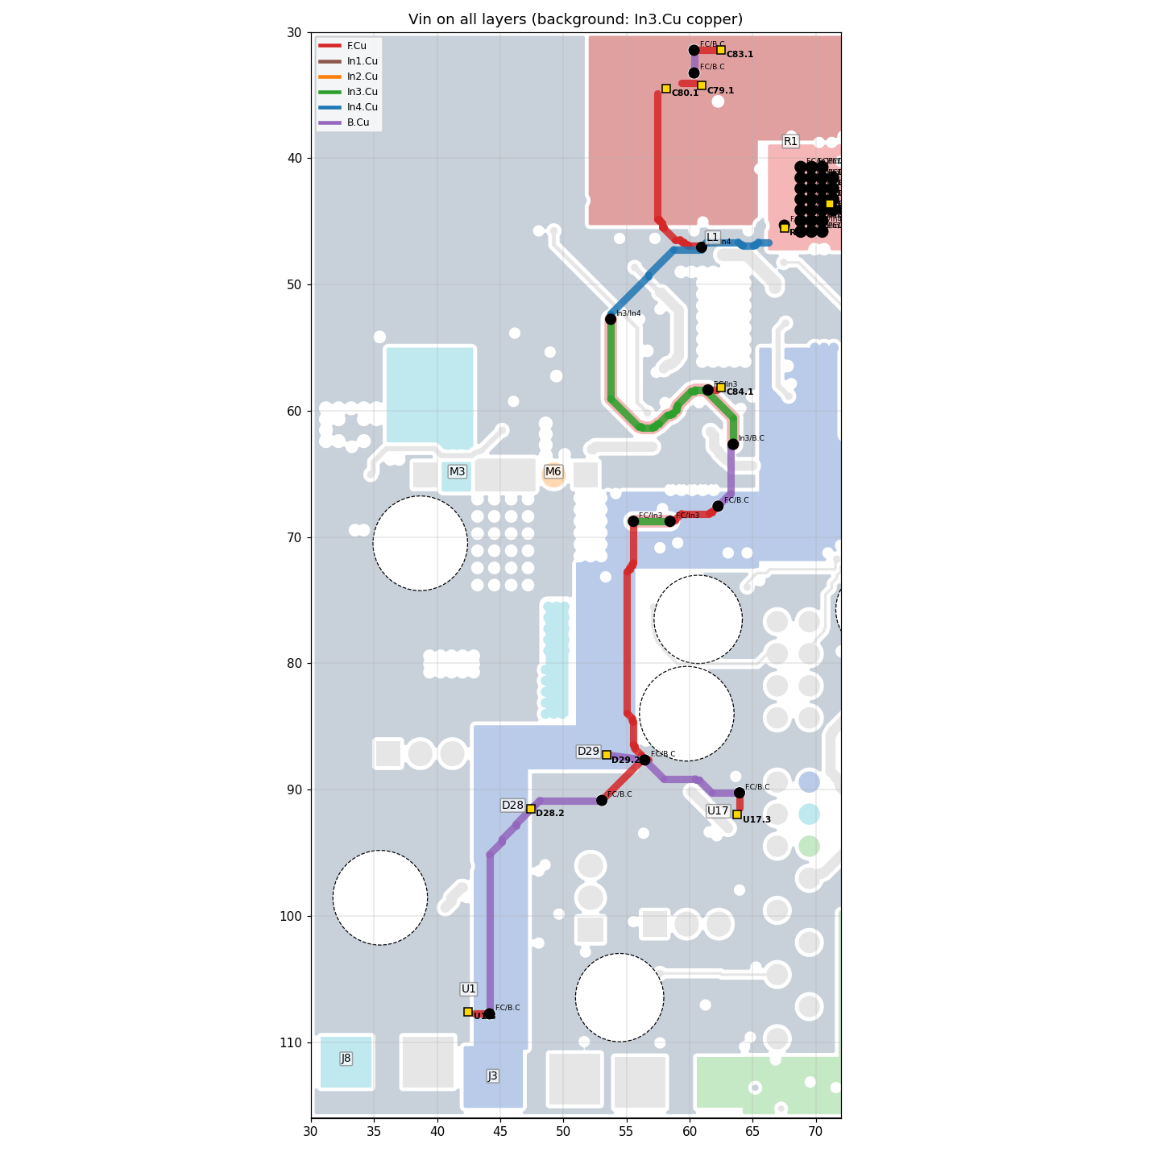
BOOST_split_boards/review_fixes_2026-10-11/img/research/r03_Vin_west_bgIn3.png
