ChristopherCa55/led-driver/BOOST_split_boards/review_fixes_2026-10-11/img/x3/a5v_out2drain_map.png

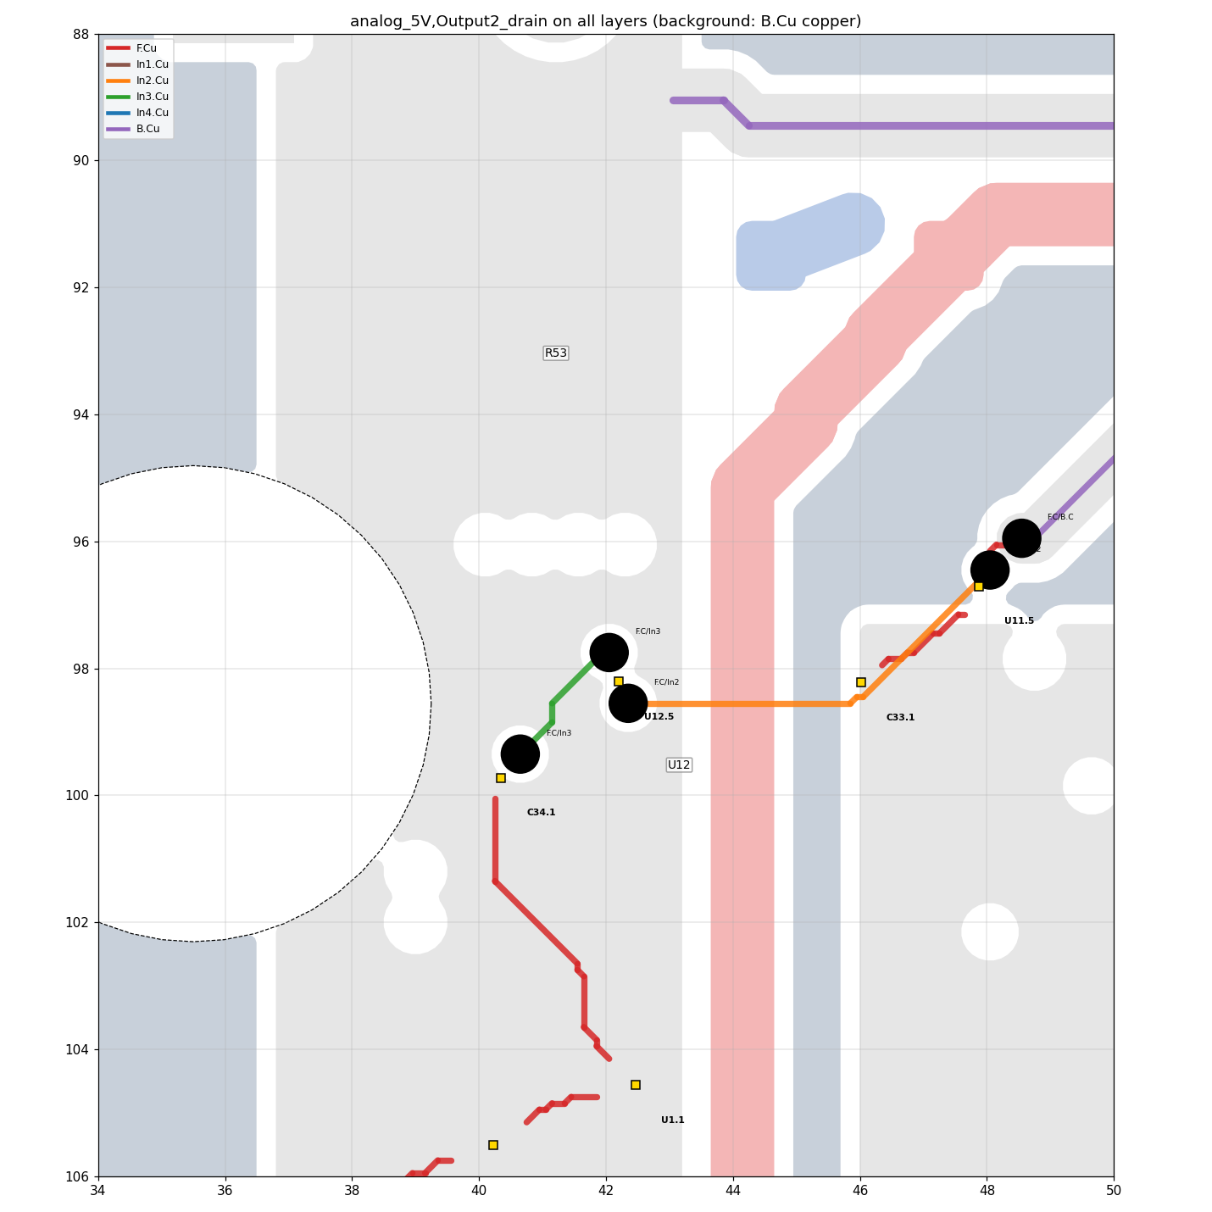
BOOST_split_boards/review_fixes_2026-10-11/img/x3/a5v_out2drain_map.png
