ChristopherCa55/led-driver/BOOST_split_boards/review_fixes_2026-10-11/img/x3/d13_B.png

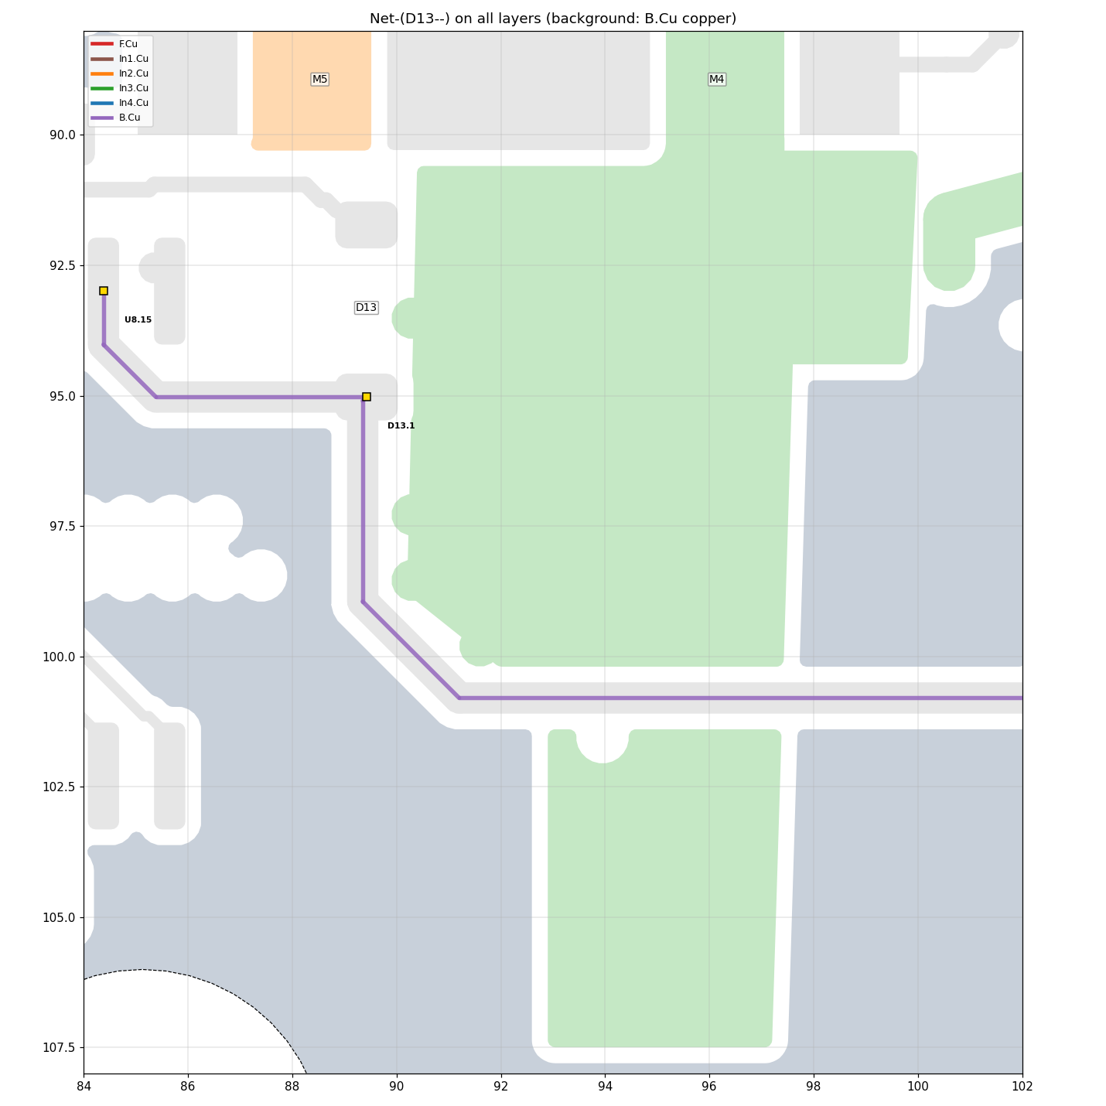
BOOST_split_boards/review_fixes_2026-10-11/img/x3/d13_B.png
