ChristopherCa55/led-driver/BOOST_split_boards/review_fixes_2026-10-11/img/x3/gm4_In4.png

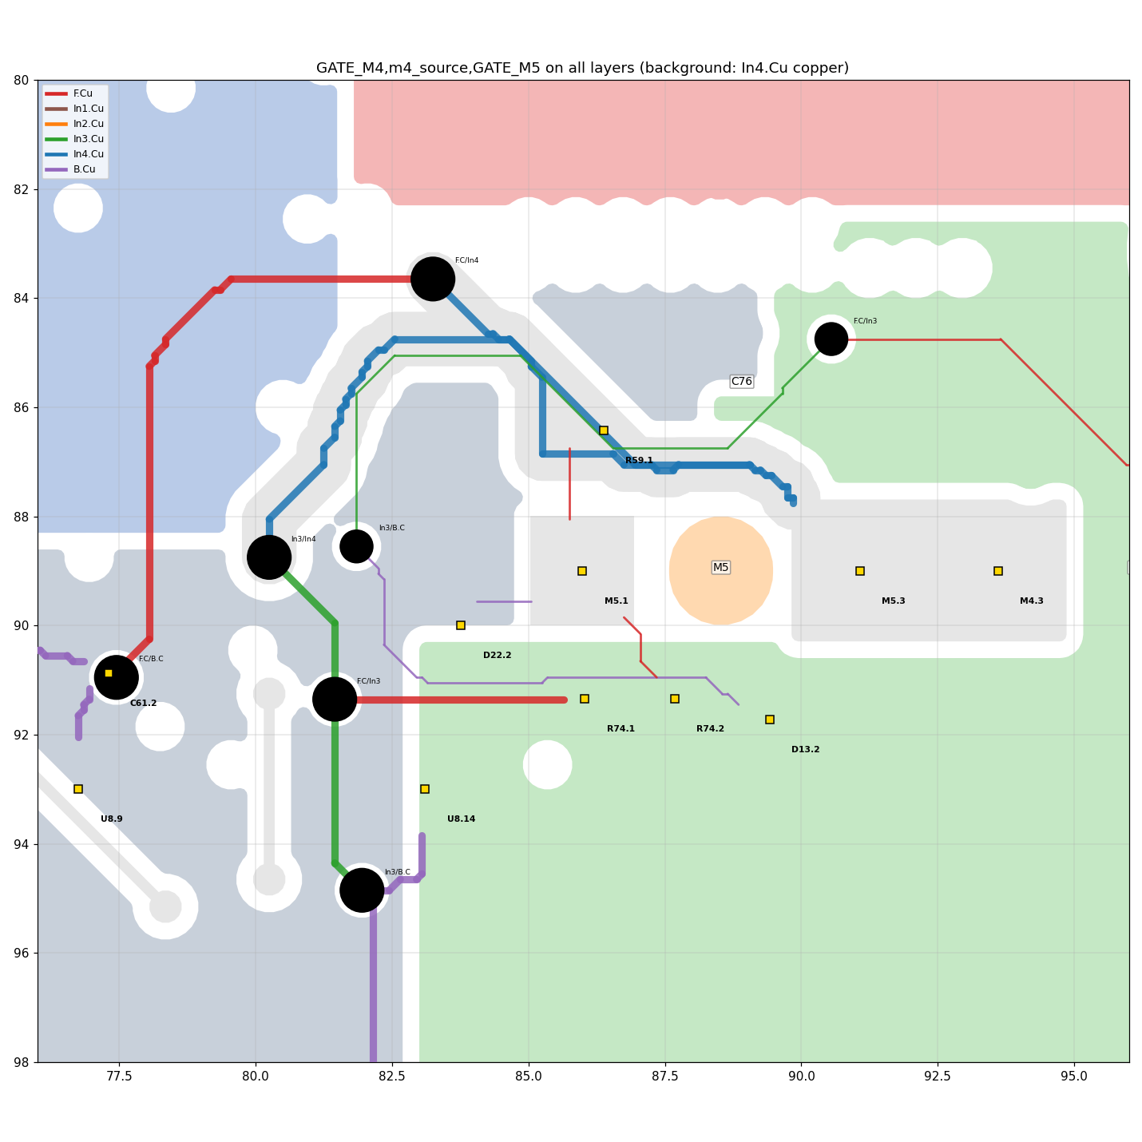
BOOST_split_boards/review_fixes_2026-10-11/img/x3/gm4_In4.png
