ChristopherCa55/led-driver/BOOST_split_boards/review_fixes_2026-10-11/work/fab_dryrun/BOOST_power_RC2/BOOST_power_RC2_fab_drawing.png

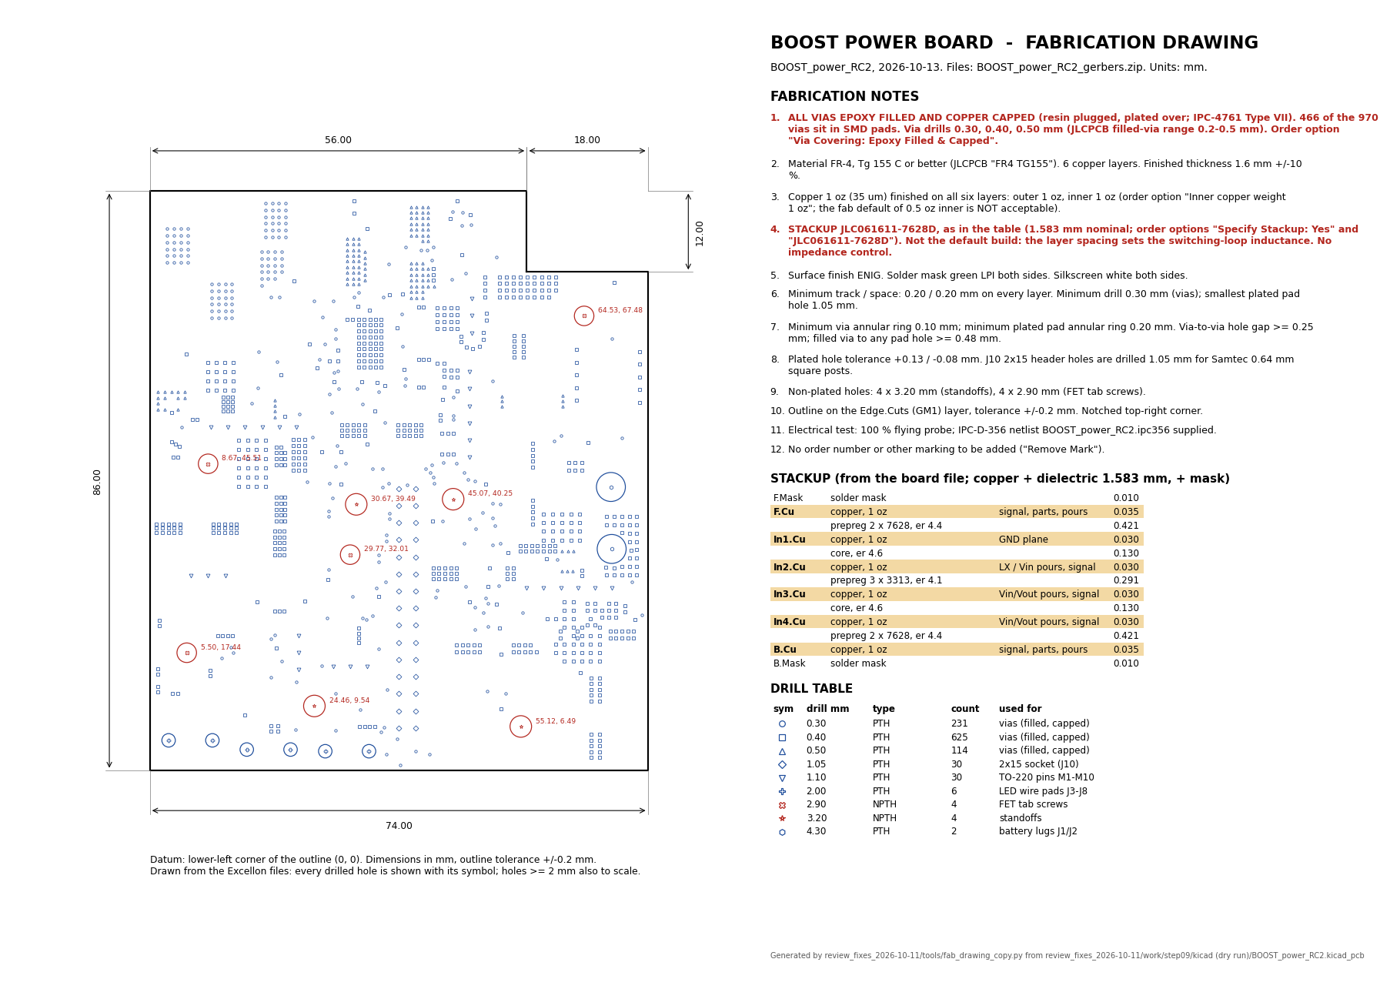
BOOST_split_boards/review_fixes_2026-10-11/work/fab_dryrun/BOOST_power_RC2/BOOST_power_RC2_fab_drawing.png
