ChristopherCa55/led-driver/BOOST_reorg_2026-10-05/BOOST_schematic.pdf

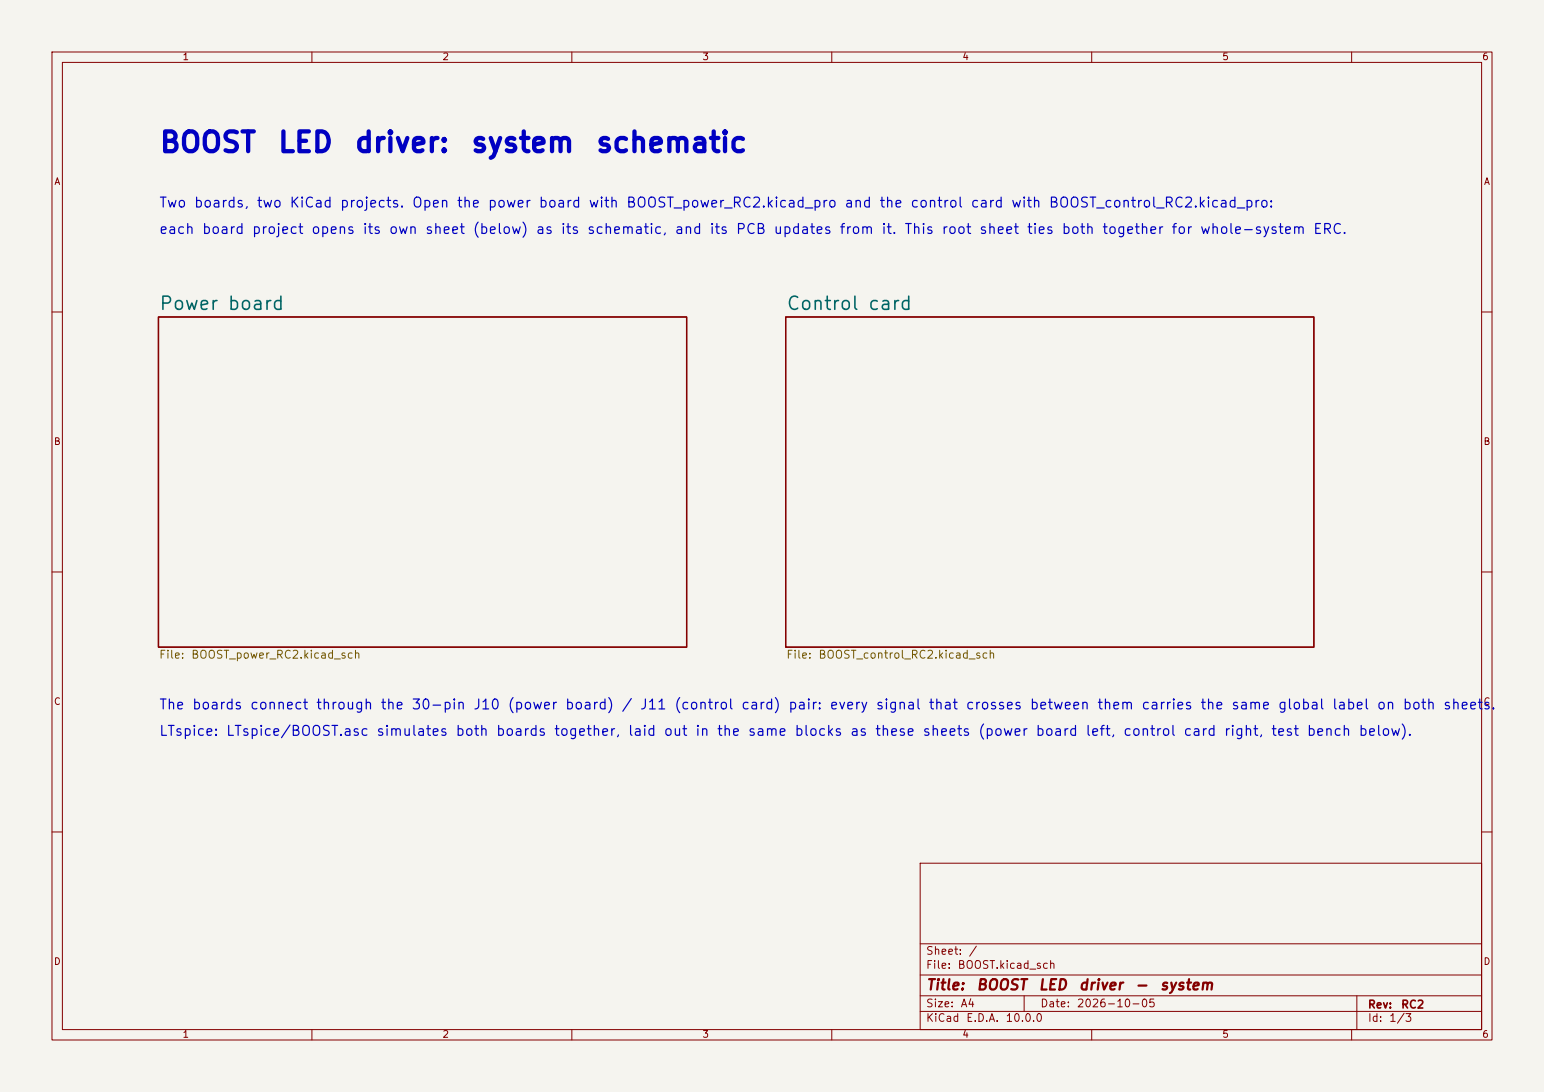
[picture p269: page 1]

BOOST LED driver: system schematic

Two boards, two KiCad projects. Open the power board with BOOST_power_RC2.kicad_pro and the control card with BOOST_control_RC2.kicad_pro:
each board project opens its own sheet (below) as its schematic, and its PCB updates from it. This root sheet ties both together for whole-system ERC.

The boards connect through the 30-pin J10 (power board) / J11 (control card) pair: every signal that crosses between them carries the same global label on both sheets.

LTspice: LTspice/BOOST.asc simulates both boards together, laid out in the same blocks as these sheets (power board left, control card right, test bench below).

Sheet: /
D Date: 2026-10-05 KiCad E.D.A. 10.0.0
File: BOOST.kicad_sch
Title: BOOST LED driver - system

Size: A4 | Rev: RC2

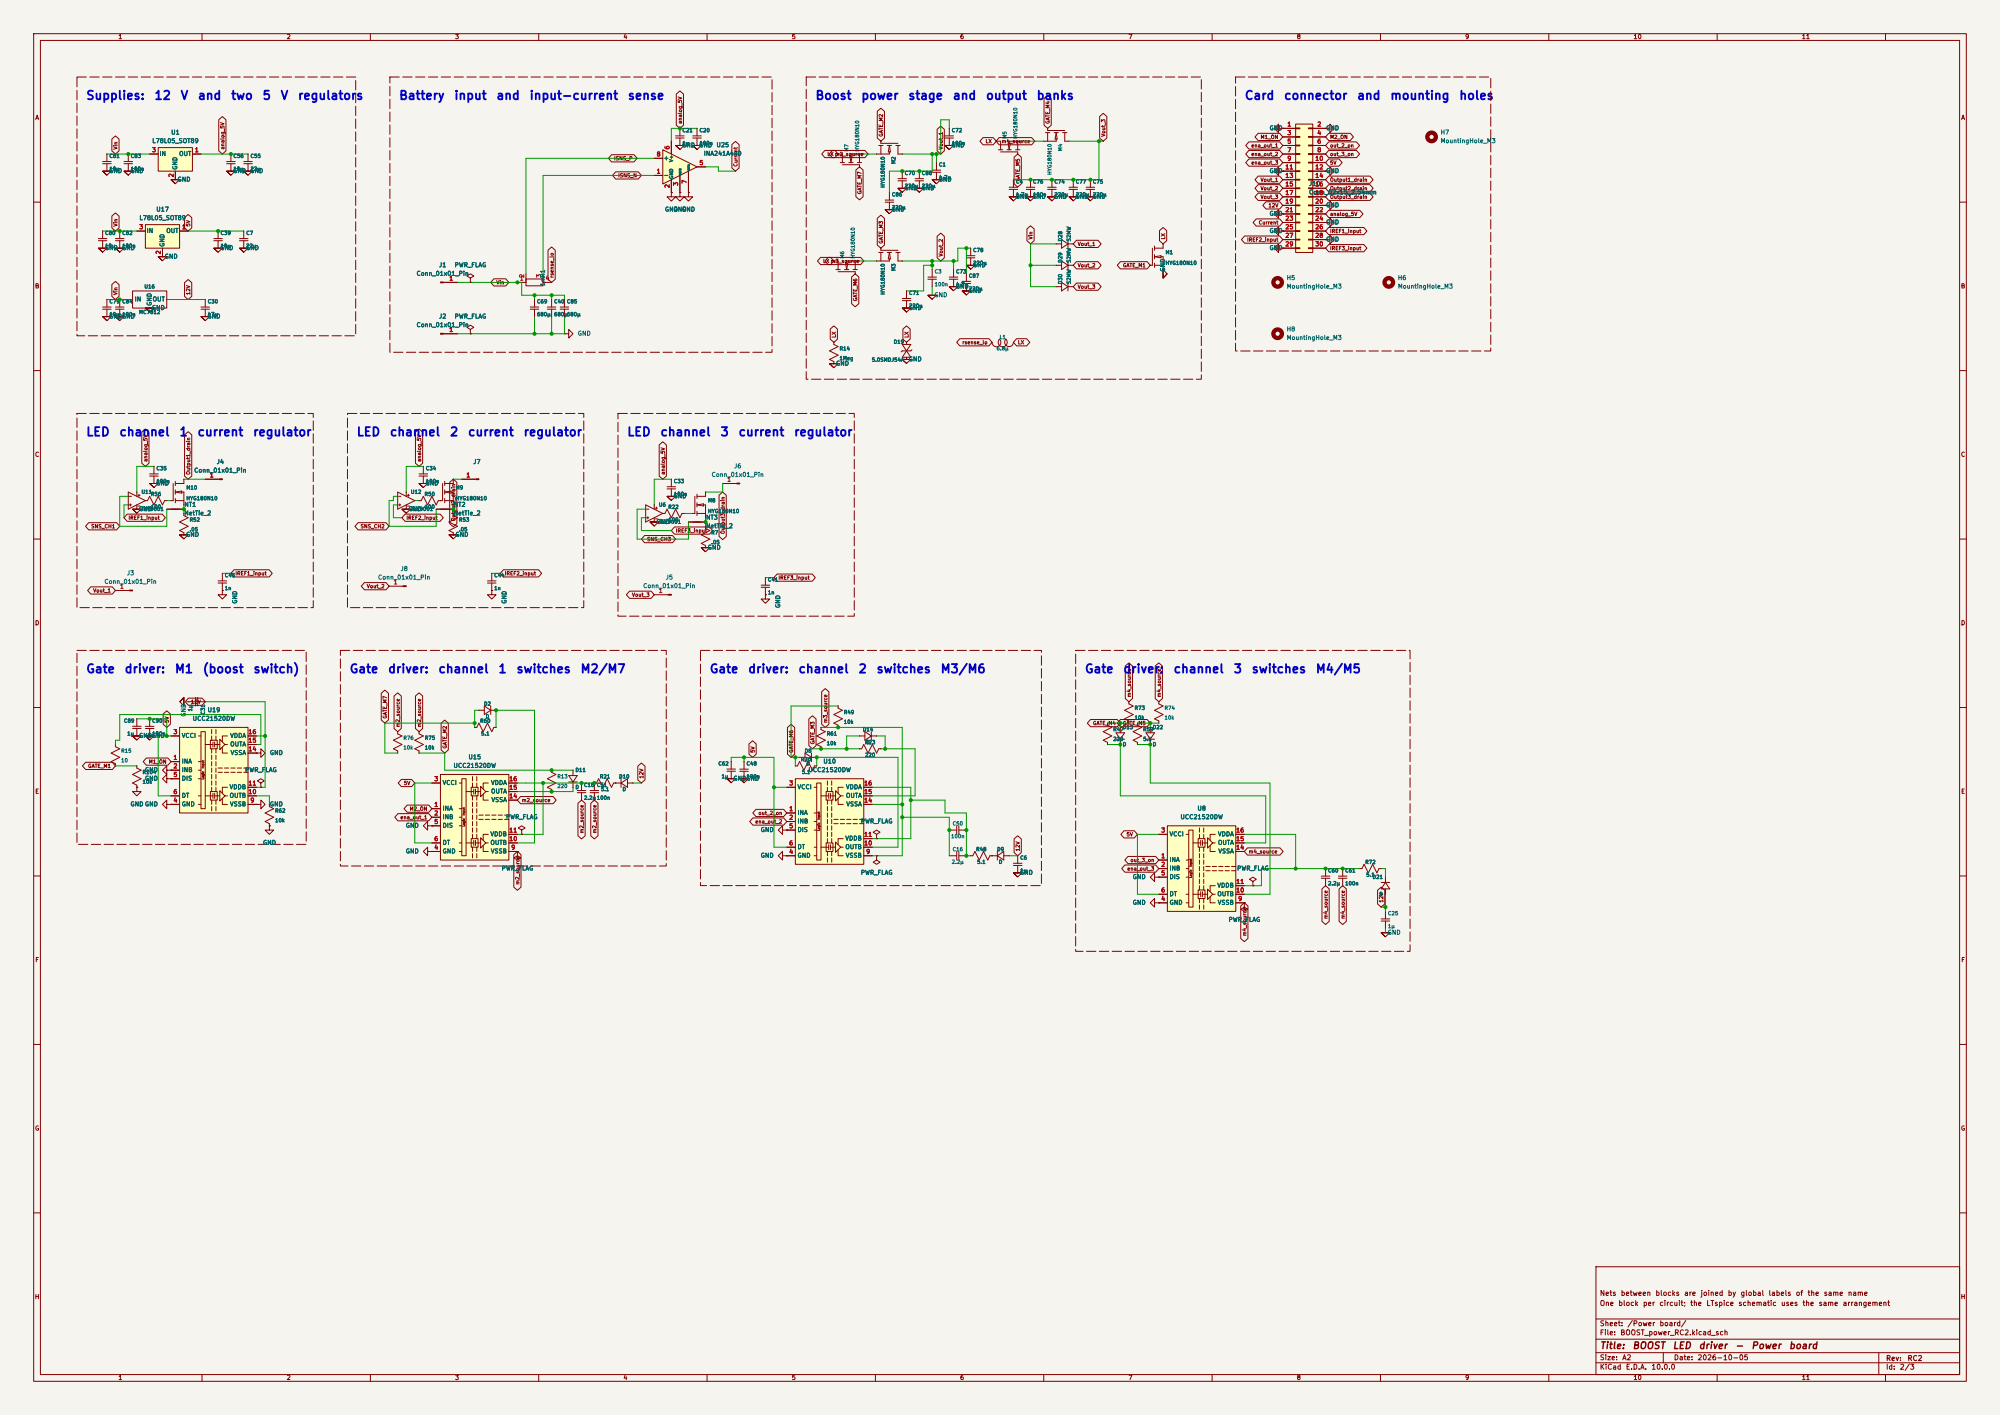
[picture p270: page 2]

LED channel 2 current regulator

ena_out_2 Gate driver: channel 2 switches M3/M6

Gate driver: channel 3 switches M4/M5

Nets between blocks are joined by global labels of the same name
One block per circuit; the LTspice schematic uses the same arrangement

Sheet: /Power board/
File: BOOST_power_RC2.kicad_sch
Title: BOOST LED driver - Power board

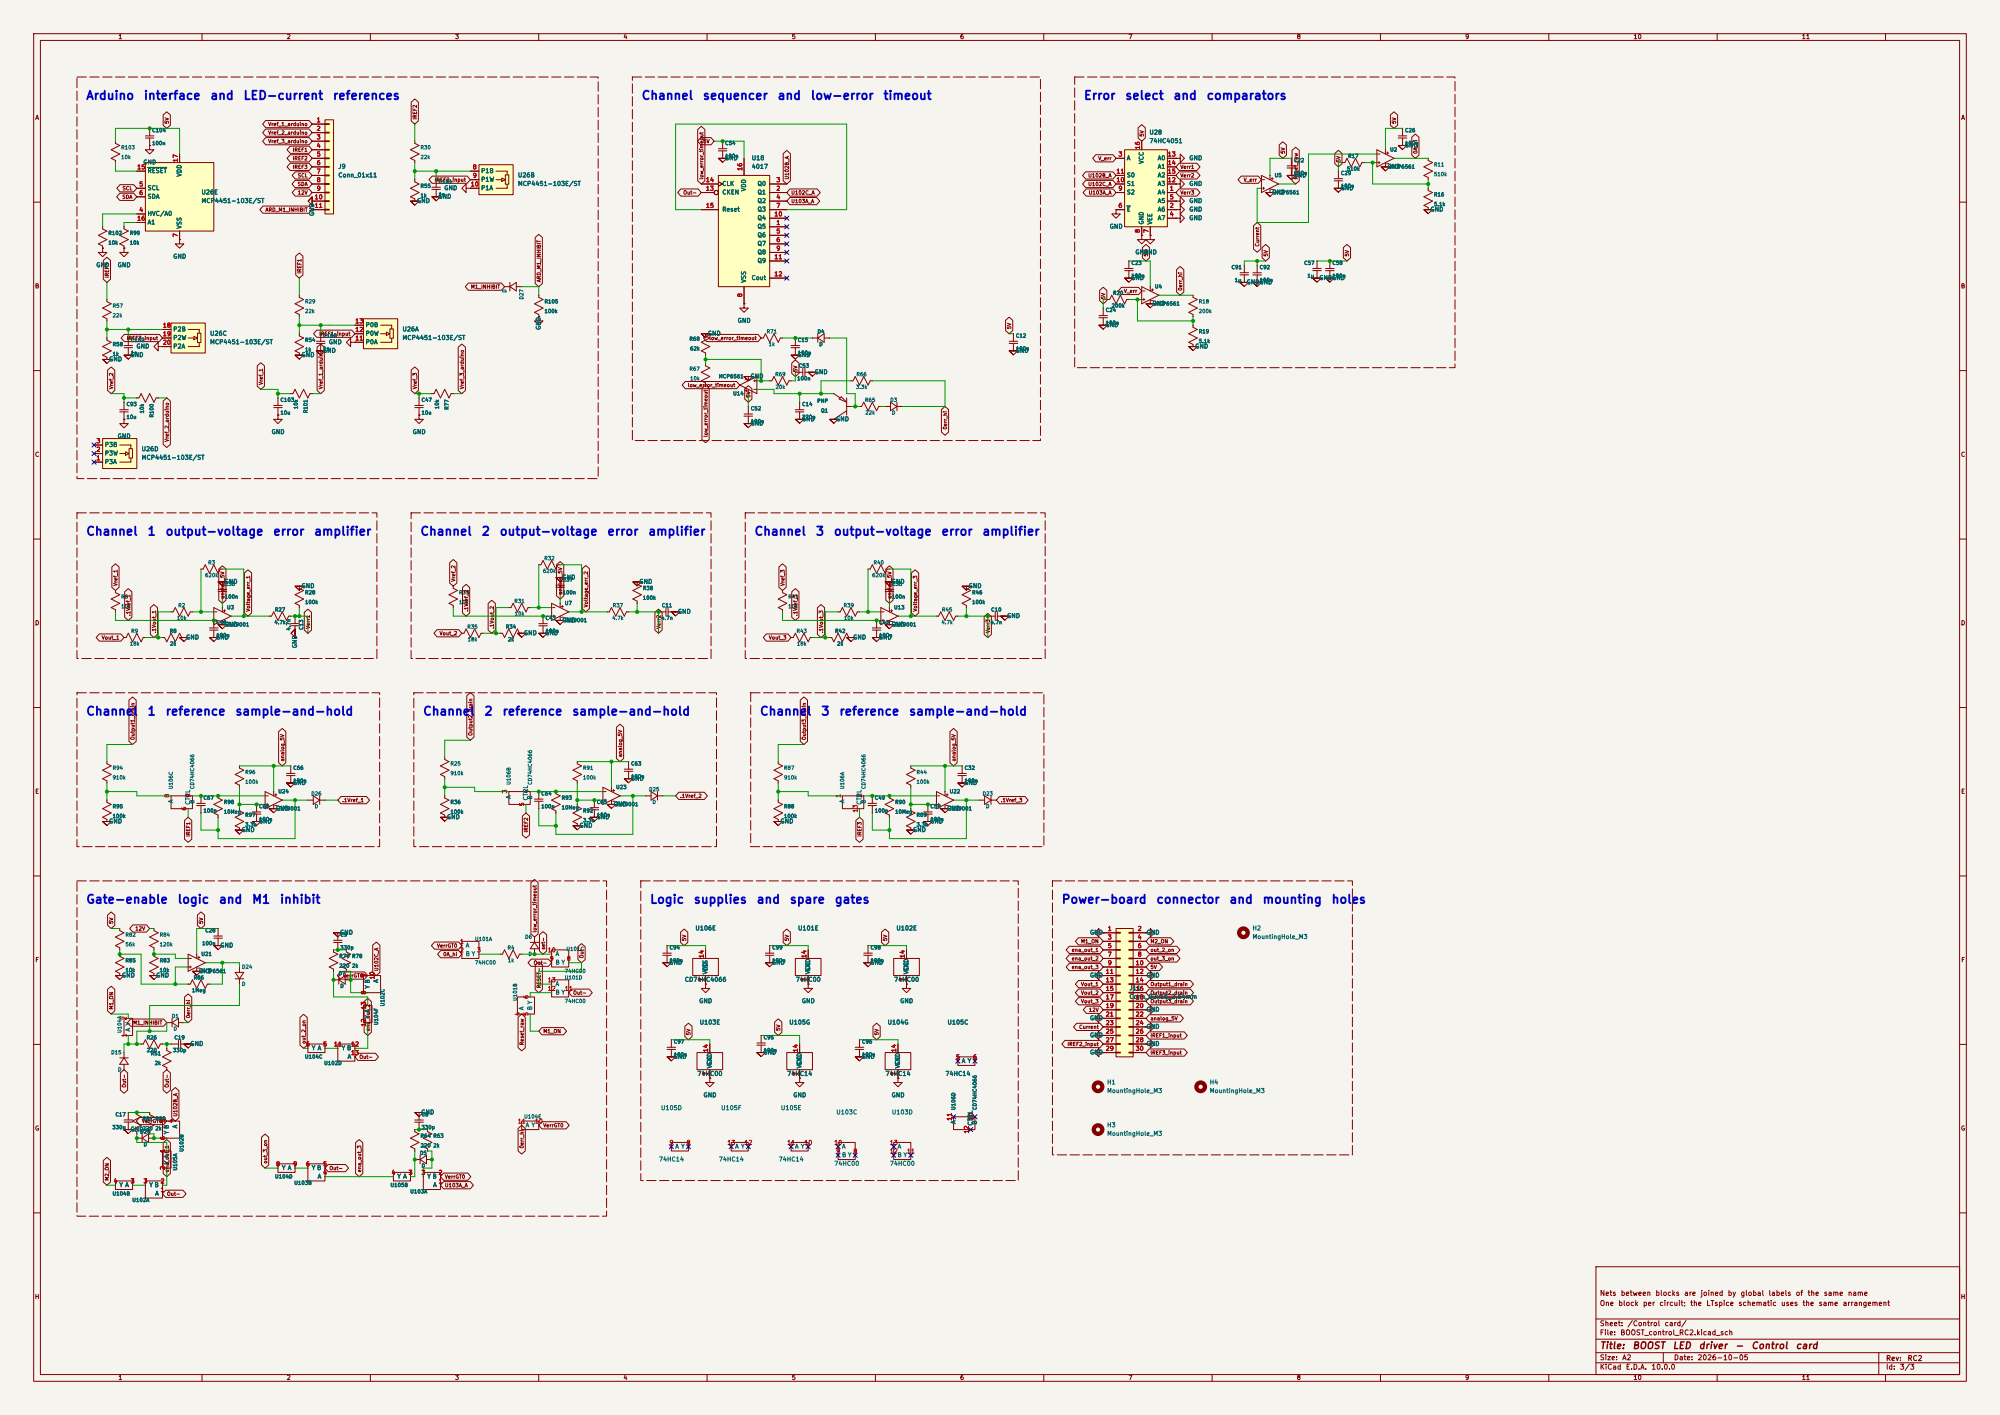
[picture p271: page 3]

Error select and comparators

8 Q8 9 Q4 10 Q9 11 Cout 12 CKEN 13 CLK 14 Reset 15 VDD 16 U18

8 Q8 9 Q4 10 Q9 11 Cout 12 CKEN 13 CLK 14 Reset 15 VDD 16 GND

Channel 3 output-voltage error amplifier

Channel 1 reference sample-and-hold

Gate-enable logic and M1 inhibit

Logic supplies and spare gates

Power-board connector and mounting holes

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

Sheet: /Control card/
File: BOOST_control_RC2.kicad_sch
Title: BOOST LED driver - Control card
