ChristopherCa55/led-driver/BOOST_review_fixes/LTspice/BOOST.asc

C1: cap; 4.7µ
C3: cap; 100n
C4: cap; 4.7µ
C6: cap; 1µ
C7: cap; 22µ
C8: cap; 330p
C9: cap; 330p
C10: cap; 4.7n
C11: cap; 4.7n
C12: cap; 100n
C13: cap; 4.7n
C14: cap; 220p
C15: cap; 100p
C16: cap; 2.2µ
C17: cap; 330p
C18: cap; 2.2µ
C19: cap; 330p
C20: cap; 100n
C21: cap; 1µ
C22: cap; 100n
C23: cap; 100n
C24: cap; 100n
C25: cap; 1µ
C26: cap; 100n
C28: cap; 100n
C29: cap; 100n
C30: cap; 47µ
C31: cap; 1µ
C32: cap; 100n
C33: cap; 100n
C34: cap; 100n
C35: cap; 100n
C36: cap; 100n
C37: cap; 100n
C38: cap; 100n
C39: cap; 10µ
C40: cap; 680µ; V=25 Irms=5.4 Rser=0.008 Lser=4n Rpar=147k
C41: cap; 1n
C42: cap; 100n
C43: cap; 100n
C44: cap; 1n
C45: cap; 1n
C46: cap; 100n
C47: cap; 10µ
C48: cap; 100n
C49: cap; 100n
C50: cap; 100n
C51: cap; 100n
C52: cap; 100n
C53: cap; 100n
C54: cap; 100n
C55: cap; 22µ
C56: cap; 10µ
C57: cap; 1µ
C58: cap; 100n
C59: cap; 100n
C60: cap; 2.2µ
C61: cap; 100n
C62: cap; 1µ
C63: cap; 100n
C64: cap; 100n
C65: cap; 100n
C66: cap; 100n
C67: cap; 100n
C68: cap; 100n
C69: cap; 680µ; V=25 Irms=5.4 Rser=0.008 Lser=4n Rpar=147k
C70: cap; 220µ; V=50 Irms=3.2 Rser=0.013 Lser=4n Rpar=455k
C71: cap; 220µ; V=50 Irms=3.2 Rser=0.013 Lser=4n Rpar=455k
C72: cap; 100n
C73: cap; 4.7µ
C74: cap; 220µ; V=50 Irms=4.5 Rser=0.01 Lser=4n Rpar=455k
C75: cap; 220µ; V=50 Irms=3.2 Rser=0.013 Lser=4n Rpar=455k
C76: cap; 100n
C77: cap; 220µ; V=50 Irms=3.2 Rser=0.013 Lser=4n Rpar=455k
C78: cap; 220µ; V=50 Irms=3.2 Rser=0.013 Lser=4n Rpar=455k
C79: cap; 10µ
C80: cap; 10µ
C81: cap; 10µ
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
U101C: and; Vhigh=5 Vlow=0 Vt=2.5 Td=2.6n Trise=8.75n Tfall=8.75n Rhigh=45 Rlow=38
U101D: and; Vhigh=5 Vlow=0 Vt=2.5 Td=2.6n Trise=8.75n Tfall=8.75n Rhigh=45 Rlow=38
U102A: and; Vhigh=5 Vlow=0 Vt=2.5 Td=2.6n Trise=8.75n Tfall=8.75n Rhigh=45 Rlow=38
U102B: and; Vhigh=5 Vlow=0 Vt=2.5 Td=2.6n Trise=8.75n Tfall=8.75n Rhigh=45 Rlow=38
U102C: and; Vhigh=5 Vlow=0 Vt=2.5 Td=2.6n Trise=8.75n Tfall=8.75n Rhigh=45 Rlow=38
U102D: and; Vhigh=5 Vlow=0 Vt=2.5 Td=2.6n Trise=8.75n Tfall=8.75n Rhigh=45 Rlow=38
U103A: and; Vhigh=5 Vlow=0 Vt=2.5 Td=2.6n Trise=8.75n Tfall=8.75n Rhigh=45 Rlow=38
U103B: and; Vhigh=5 Vlow=0 Vt=2.5 Td=2.6n Trise=8.75n Tfall=8.75n Rhigh=45 Rlow=38
U104A: schmtinv; Vhigh=5 Vlow=0 Vt=2.098 Vh=0.535 Td=7.6n Trise=8.75n Tfall=8.75n Rout=41
U104B: schmtinv; Vhigh=5 Vlow=0 Vt=2.098 Vh=0.535 Td=7.6n Trise=8.75n Tfall=8.75n Rout=41
U104C: schmtinv; Vhigh=5 Vlow=0 Vt=2.098 Vh=0.535 Td=7.6n Trise=8.75n Tfall=8.75n Rout=41
U104D: schmtinv; Vhigh=5 Vlow=0 Vt=2.098 Vh=0.535 Td=7.6n Trise=8.75n Tfall=8.75n Rout=41
U104E: schmtinv; Vhigh=5 Vlow=0 Vt=2.098 Vh=0.535 Td=7.6n Trise=8.75n Tfall=8.75n Rout=41
U104F: schmtinv; Vhigh=5 Vlow=0 Vt=2.098 Vh=0.535 Td=7.6n Trise=8.75n Tfall=8.75n Rout=41
U105A: schmtinv; Vhigh=5 Vlow=0 Vt=2.098 Vh=0.535 Td=7.6n Trise=8.75n Tfall=8.75n Rout=41
U105B: schmtinv; Vhigh=5 Vlow=0 Vt=2.098 Vh=0.535 Td=7.6n Trise=8.75n Tfall=8.75n Rout=41
U106A: CD74HC4066
U106B: CD74HC4066
U106C: CD74HC4066
Named nets: GATE_M1, 5V, GATE_M4, m4_source, 0, 12V, analog_5V, Vin, GATE_M5, Vbattery, rsense_lo, LX, M1_ON, Vout_1, Vout_2, Vout_3, ISNS_P, ISNS_N, Current, Output1_drain, SNS_CH1, IREF1_input, SRV1, IREF1, SCL, SDA, .1Vout_1, Voltage_err_1, Verr1, .1Vref_1, Vref_1_arduino, Vref_1, out_3_on, ena_out_3, GATE_M2, m2_source, GATE_M7, M2_ON, ena_out_1, GATE_M3, m3_source, GATE_M6, out_2_on, ena_out_2, Output2_drain, SNS_CH2, IREF2_input, SRV2, IREF2, .1Vout_2, Voltage_err_2, Verr2, .1Vref_2, Vref_2_arduino, Vref_2, Output3_drain, SNS_CH3, IREF3_input, SRV3, IREF3, .1Vout_3, Voltage_err_3, Verr3, .1Vref_3, Vref_3_arduino, Vref_3, 0err_hi, low_error_timeout, VerrGT0, 0A_hi, set-, Reset_raw, RESET-, Out, OUT_1_ENA, OUT_2_ENA, OUT_3_ENA, Out-, ARD_M1_INHIBIT, M1_INHIBIT, 4, 5, 6, 7, 8, 9, 10, V_err
.lib TLV9001.lib
.ic V(Out)=0 V(Out-)=1
.include MCP6561.lib
.tran 30m startup uic
.ic I(L1)=0 V(0A_hi)=5
.lib CD4000_v.lib
.lib HYG180N10.lib
.options gmin=100f reltol=0.001 solver=alt
.lib INA241A4.lib
.model LED_RED   D(IS=1.18e-20 N=18 RS=3 CJO=2n)
.model LED_GREEN D(IS=9.5e-25  N=22 RS=4 CJO=2n)
.model LED_BLUE  D(IS=9.5e-25  N=22 RS=4 CJO=2n)
.model 100W_LED_BLUE D(IS=1e-24 N=20.5 RS=0.8 CJO=2n)
.model 100W_LED_RED D(IS=1e-23 N=14.5 RS=0.6 CJO=2n)
.model 100W_LED_GREEN D(IS=1.5e-24 N=20.5 RS=0.9 CJO=2n)
.lib L78L05.lib
.lib MC7812.lib
.meas TRAN Ptvs AVG  (-1)*V(LX)*I(D19) FROM 2m TO 13m
.meas TRAN Etvs INTEG (-1)*V(LX)*I(D19)
.ic V(SRV1)=2.89 V(SRV2)=3.86 V(SRV3)=3.86
.ic V(Vref_1)=2 V(Vref_2)=3 V(Vref_3)=3
Start-up state: the two .ic lines above start the servos and reference filters settled.
Delete both for a true cold start (about 0.5 s to full brightness).
.lib CD74HC4066.lib
.lib 74HC4051.lib
.lib MCP4451.lib
.lib CSS4J.lib
.lib TVS_5p0SMDJ.lib
.param IREF1_DUTY=256 IREF2_DUTY=256 IREF3_DUTY=256
.param POT1_CODE=86 POT2_CODE=103 POT3_CODE=103
IREFn_DUTY: Arduino PWM duty on IREFn (J9) in 256ths, 490 Hz: 256 = always on, 128 = 50 %, 0 = off.
POTn_CODE: MCP4451 wiper code of U26A/B/C, 0-256 (0 = wiper at B = full current, 256 = at A = 0 A;
I added a lot of capacitors for individual components in the kicad, which are all put here
confirmed in Microchip's data sheet DS22267A). 86/103/103 give 2.63/2.37/2.37 A peaks.
Parts named SIM_ exist only in the simulation (battery, cable, LEDs, Arduino outputs).
Dimming runs (IREFn_DUTY below 256) can stop advancing while all LEDs are off (log fills with
"tolerance relaxed" at one time). Adding solver=alt to the .options line got past it (2-3x slower).
.model S2MW D(IS=14n RS=17m N=1.8 CJO=25p M=0.333 TT=3u BV=1000 IBV=5u)
simulation only - not on the PCB
D28-D30: pre-charge diodes Vin -> Vout_1/2/3
actual led diode
will not be on the pcb
simulation only - not on the PCB
0-5V PWM signal sent from arduino to control brightness
U26E: MCP4451 control unit, serves U26A/B/C
Channel 1 output-voltage error amplifier, Vout_1 -> Verr1
0-5V PWM to set minimum voltage reference
This will be connected to an arduino pin
this pushes up the reference voltage if the 
output voltage is undershooting for a long time
digital potentiometer 
to control current
switch used so that circuit 
only samples while the led is on
error signal - used to control how long the inductor charges up for
mosfet used as a kind of variable resistor 
to keep led current from going too high.
op amp will try to 
make its output match 
the reference current
PWM duty = IREF1_DUTY/256 (.param)
1 mOhm shunt:
measures inductor current
current sense
amplifies R1 voltage by 100x
low side switch
clamps LX spikes
connects LX to output 1
connects LX to output 2
connects LX to output 3
filters the PWM to DC
U26A: one of the 4 pots inside U26 (MCP4451)
OUTPUT 1
OUTPUT 2
OUTPUT 3
CH1 LED CURRENT LIMIT
CH1 HEADROOM SERVO
when m1 pulls inductor to ground, 
current can conduct through the mosfet 
body diode to charge up this capacitor
actual led diode
will not be on the pcb
simulation only - not on the PCB
Channel 2 output-voltage error amplifier, Vout_2 -> Verr2
simulation only - not on the PCB
PWM duty = IREF2_DUTY/256 (.param)
U26B: one of the 4 pots inside U26 (MCP4451)
CH2 LED CURRENT LIMIT
CH2 HEADROOM SERVO
same as channel 1
actual led diode
will not be on the pcb
simulation only - not on the PCB
Channel 3 output-voltage error amplifier, Vout_3 -> Verr3
simulation only - not on the PCB
PWM duty = IREF3_DUTY/256 (.param)
U26C: one of the 4 pots inside U26 (MCP4451)
CH3 LED CURRENT LIMIT
CH3 HEADROOM SERVO
same as channel 1
LOW-ERROR TIMEOUT
SEQUENCER / ERROR SELECT
M1 ON/OFF LATCH
CHANNEL ENABLE
M1 INHIBIT
simulation only - not on the PCB
makes it so that if there is one channel with low error, 
it doesn't just stop on that one channel.
rc circuit delays m1 turn on
diode creates fast turn off
inhibits m1 if 12V rail is below 9.8V
disables m1 if there is 0 
error on the current channel
Signal that can be sent from the 
arduino to disable the circuit
goes to gate driver
goes to gate driver
goes to gate driver
goes to gate driver
gate driver
gate driver
gate driver
bootstrap capacitors
goes to gate driver
goes to gate driver
* diode part names: LTspice's default diode, as before
.model 1N4148W D
.model B5819W D
.model BAV21W D
.model BAT54WS D
one-hot from U18: picks Verr1/2/3
Q3 resets it: counts Q0-Q2 only
5V by net name (SpiceModel)
latch: set- low turns M1 on
RESET- low turns it off
rc: slow turn on
diode: fast off
DT = VCCI:
no dead time
ch B unused
same as channel 1
same as channel 1
I2C pull-ups (U26 has none)
