ChristopherCa55/led-driver/RGB100W_Driver.asc

AB1: schmtinv; Vt=1.6 Vh=0.4 Vhigh=5 Trise=15n Tfall=15n
AB2: schmtinv; Vt=1.6 Vh=0.4 Vhigh=5 Trise=15n Tfall=15n
AG1: schmtinv; Vt=1.6 Vh=0.4 Vhigh=5 Trise=15n Tfall=15n
AG2: schmtinv; Vt=1.6 Vh=0.4 Vhigh=5 Trise=15n Tfall=15n
AR1: schmtinv; Vt=1.6 Vh=0.4 Vhigh=5 Trise=15n Tfall=15n
AR2: schmtinv; Vt=1.6 Vh=0.4 Vhigh=5 Trise=15n Tfall=15n
C1: polcap; 470u; V=25 Rser=0.03
C2: polcap; 470u; V=25 Rser=0.03
C3: cap; 10u; V=25
C4: cap; 100n
C5: polcap; 220u; V=63 Rser=0.045
C6: polcap; 220u; V=63 Rser=0.045
C7: cap; 4.7u; V=100
C8: cap; 4.7u; V=100
C9: cap; 4.7u; V=100
C10: cap; 4.7u; V=100
C11: cap; 220n
C12: cap; 4.7n
C13: cap; 470p
C14: cap; 220p
C15: cap; 100p
C30: cap; 100n
CfB: cap; 470p
CfG: cap; 470p
CfR: cap; 470p
CpB: cap; 1n
CpG: cap; 1n
CpR: cap; 1n
CtB: cap; 470p
CtG: cap; 470p
CtR: cap; 470p
D1: schottky; MBR20100
D6: zener; BZX84C12
D7: zener; SMDJ18A
DB: LED; LEDBLU
DcB: zener; BZX84C5V1
DcG: zener; BZX84C5V1
DcR: zener; BZX84C5V1
DfwB: schottky; SS3H10
DfwG: schottky; SS3H10
DfwR: schottky; SS3H10
DG: LED; LEDGRN
DR: LED; LEDRED
F1: res; 5m
L1: ind; 15u; Rser=0.008 Ipk=14
LB: ind; 150u; Rser=0.15 Ipk=2
LG: ind; 150u; Rser=0.15 Ipk=2
LR: ind; 150u; Rser=0.15 Ipk=2
Q1: nmos; IRFB4110
Q5: pmos; Si4435 / IRF4905
QB: nmos; FQD13N10L
QG: nmos; FQD13N10L
QR: nmos; FQD13N10L
R1: res; 12m
R2: res; 100k
R3: res; 6.04k
R4: res; 2.2k
R5: res; 10
R6: res; 10k
R7: res; 100
R8: res; 100
R20: res; 100k
R30: res; 6.34k
R31: res; 1k
RdB: res; 10k
RdG: res; 10k
RdR: res; 10k
RfB: res; 220
RfG: res; 220
RfR: res; 220
RgB: res; 10
RgG: res; 10
RgR: res; 10
RpB: res; 1k
RpG: res; 1k
RpR: res; 1k
RsB: res; 0.33
RsG: res; 0.33
RsR: res; 0.33
RtB: res; 3.09k
RtG: res; 3.09k
RtR: res; 4.53k
U1: BOOSTPCM; Fsw=200k Ksl=0.13 Vthmax=0.42
UB: LEDCOT
UG: LEDCOT
UR: LEDCOT
V1: voltage; 12; Rser=0.02
V2: voltage; 5
V3: voltage; 2.5
VpB: voltage; PULSE(0 5 1m 1u 1u 0.5m 1m)
VpG: voltage; PULSE(0 5 1m 1u 1u 0.5m 1m)
VpR: voltage; PULSE(0 5 1m 1u 1u 0.5m 1m)
Named nets: 0, VBAT, VIN, V5, VREF25, IREF, SWB, RAIL, CSB, GB, CSBF, VFB, COMP, CR, SWR, SNSR, GR, SFR, TIMR, PWMR, CG, SWG, SNSG, GG, SFG, TIMG, PWMG, CB, SNSB, SFB, TIMB, PWMB, ARDR, PFR, PNR, ARDG, PFG, PNG, ARDB, PFB, PNB
.tran 0 3m 0 100n uic
.inc LEDCOT.sub
.inc BOOSTPCM.sub
.model LEDRED D(Is=1.86e-9 N=46.4 Rs=0.01 Cjo=2n)   ; 24 V @ 900 mA
.model LEDGRN D(Is=5.05e-12 N=52.2 Rs=0.01 Cjo=2n)  ; 35 V @ 900 mA
.model LEDBLU D(Is=5.05e-12 N=52.2 Rs=0.01 Cjo=2n)  ; 35 V @ 900 mA
.model MBR20100 D(Is=5e-7 N=1.15 Rs=0.012 Cjo=300p)
.model SS3H10   D(Is=5e-8 N=1.2  Rs=0.05  Cjo=50p)
.model BZX84C12 D(Is=1e-14 N=1 Rs=1 Vj=0.7 BV=12 Ibv=1m)
.model BZX84C5V1 D(Is=1e-14 N=1 Rs=1 Vj=0.7 BV=5.1 Ibv=1m)
.model SMDJ18A  D(Is=1e-14 N=1 Rs=0.1 Vj=0.7 BV=20 Ibv=1m)
.model IRFB4110  VDMOS(Rg=2 Vto=3.5 Kp=90 Rd=3.5m Rs=1m Cgdmax=2n Cgdmin=0.1n Cgs=6n Cjo=1.5n Is=8e-8 Rb=6m mfg=IR Vds=100 Ron=4.5m Qg=150n)
.model FQD13N10L VDMOS(Rg=3 Vto=1.8 Kp=18 Rd=115m Rs=5m Cgdmax=0.6n Cgdmin=0.02n Cgs=0.9n Cjo=0.25n Is=2e-8 Rb=30m mfg=ON Vds=100 Ron=135m Qg=15n)
.model IRF4905   VDMOS(pchan Rg=3 Vto=-4 Kp=25 Rd=18m Rs=2m Cgdmax=1n Cgdmin=0.05n Cgs=2n Cjo=1n Is=1e-8 Rb=20m mfg=IR Vds=-55 Ron=20m)
.options plotwinsize=0 reltol=2e-3 trtol=7
