ChristopherCa55/led-driver/(list of files, drawings)

Other design files:
BOOST_split_boards/card_route_2026-09-22/work/fr/c2o.dsn
BOOST_split_boards/card_route_2026-09-22/work/fr/c2o.dsn.kicad.dsn
BOOST_split_boards/card_route_2026-09-22/work/fr/c3.dsn
BOOST_split_boards/card_route_2026-09-22/work/fr/c3.dsn.kicad.dsn
BOOST_split_boards/card_route_2026-09-22/work/fr/c3b.dsn
BOOST_split_boards/card_route_2026-09-22/work/fr/c3b.dsn.kicad.dsn
BOOST_split_boards/card_route_2026-09-22/work/fr/c3c.dsn
BOOST_split_boards/card_route_2026-09-22/work/fr/c3d.dsn
BOOST_split_boards/card_route_2026-09-22/work/fr/c3d.dsn.kicad.dsn
BOOST_split_boards/card_route_2026-09-22/work/fr/c3e.dsn
BOOST_split_boards/card_route_2026-09-22/work/fr/c3e.dsn.kicad.dsn
BOOST_split_boards/card_route_2026-09-22/work/fr/c3f.dsn
BOOST_split_boards/card_route_2026-09-22/work/fr/c3f.dsn.kicad.dsn
BOOST_split_boards/card_route_2026-09-22/work/fr/c3g.dsn
BOOST_split_boards/card_route_2026-09-22/work/fr/c3g.dsn.kicad.dsn
BOOST_split_boards/card_route_2026-09-22/work/fr/c3o.dsn
BOOST_split_boards/card_route_2026-09-22/work/fr/c3o.dsn.kicad.dsn
BOOST_split_boards/review_fixes_2026-10-11/work/step05g/sch_changes.json
BOOST_split_boards/review_fixes_2026-10-11/work/step11/sch_sync.json
BOOST_split_boards/review_fixes_2026-10-11/work/try05a/sch_changes.json
