ChristopherCa55/led-driver/BOOST_split_boards/review_fixes_2026-10-11/work/trySplit_SDAc/kicad/BOOST_power_RC2.kicad_pcb

## KiCad design BOOST_split_boards/review_fixes_2026-10-11/work/trySplit_SDAc/kicad/BOOST_power_RC2.kicad_pcb (2026-10-14)

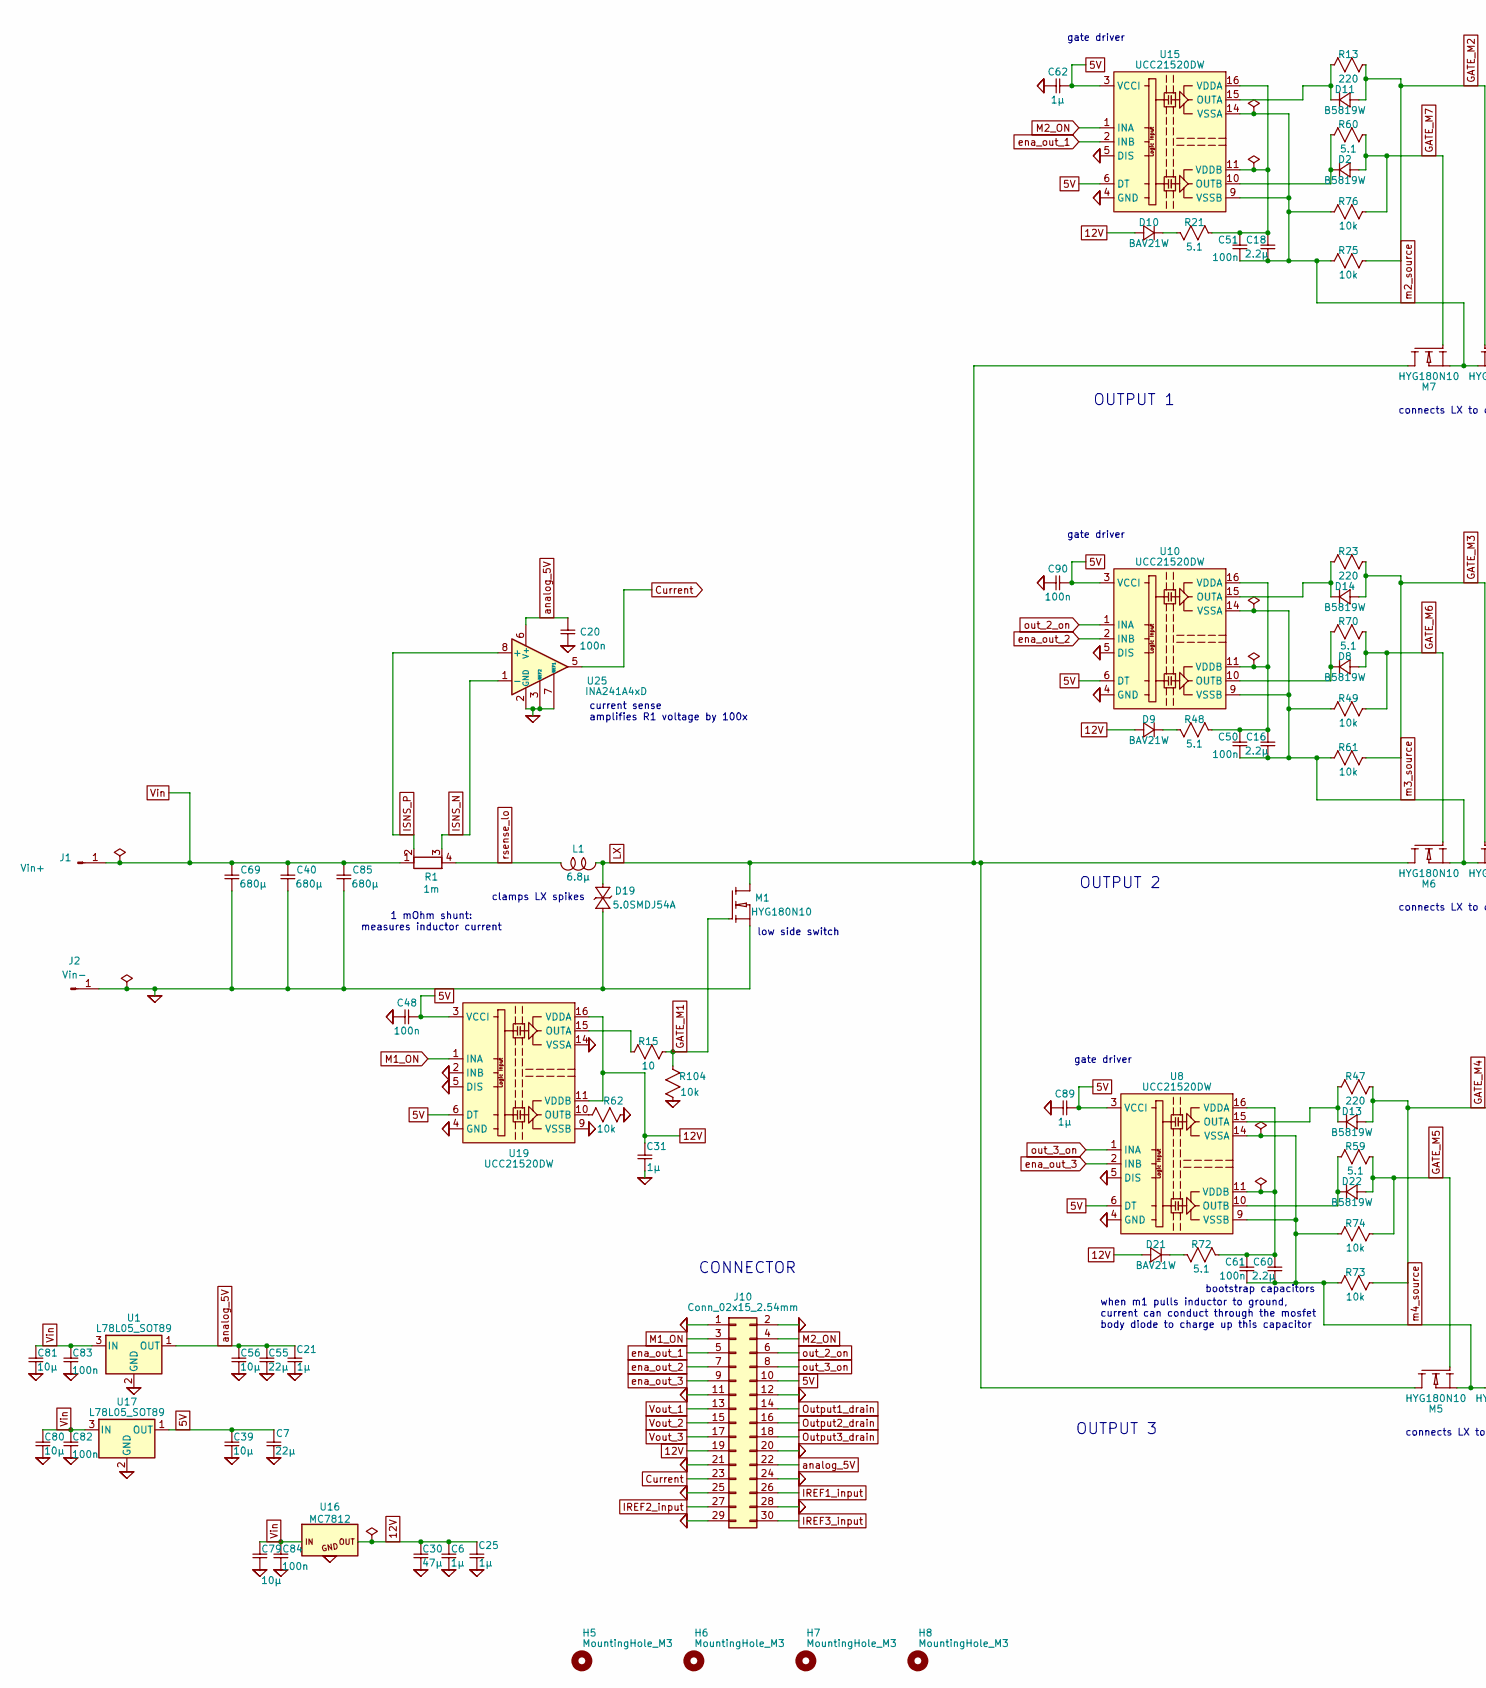
[picture p272: schematic BOOST_power_RC2.kicad_sch, BOOST LED driver - Power board, part in row 1, column 1]

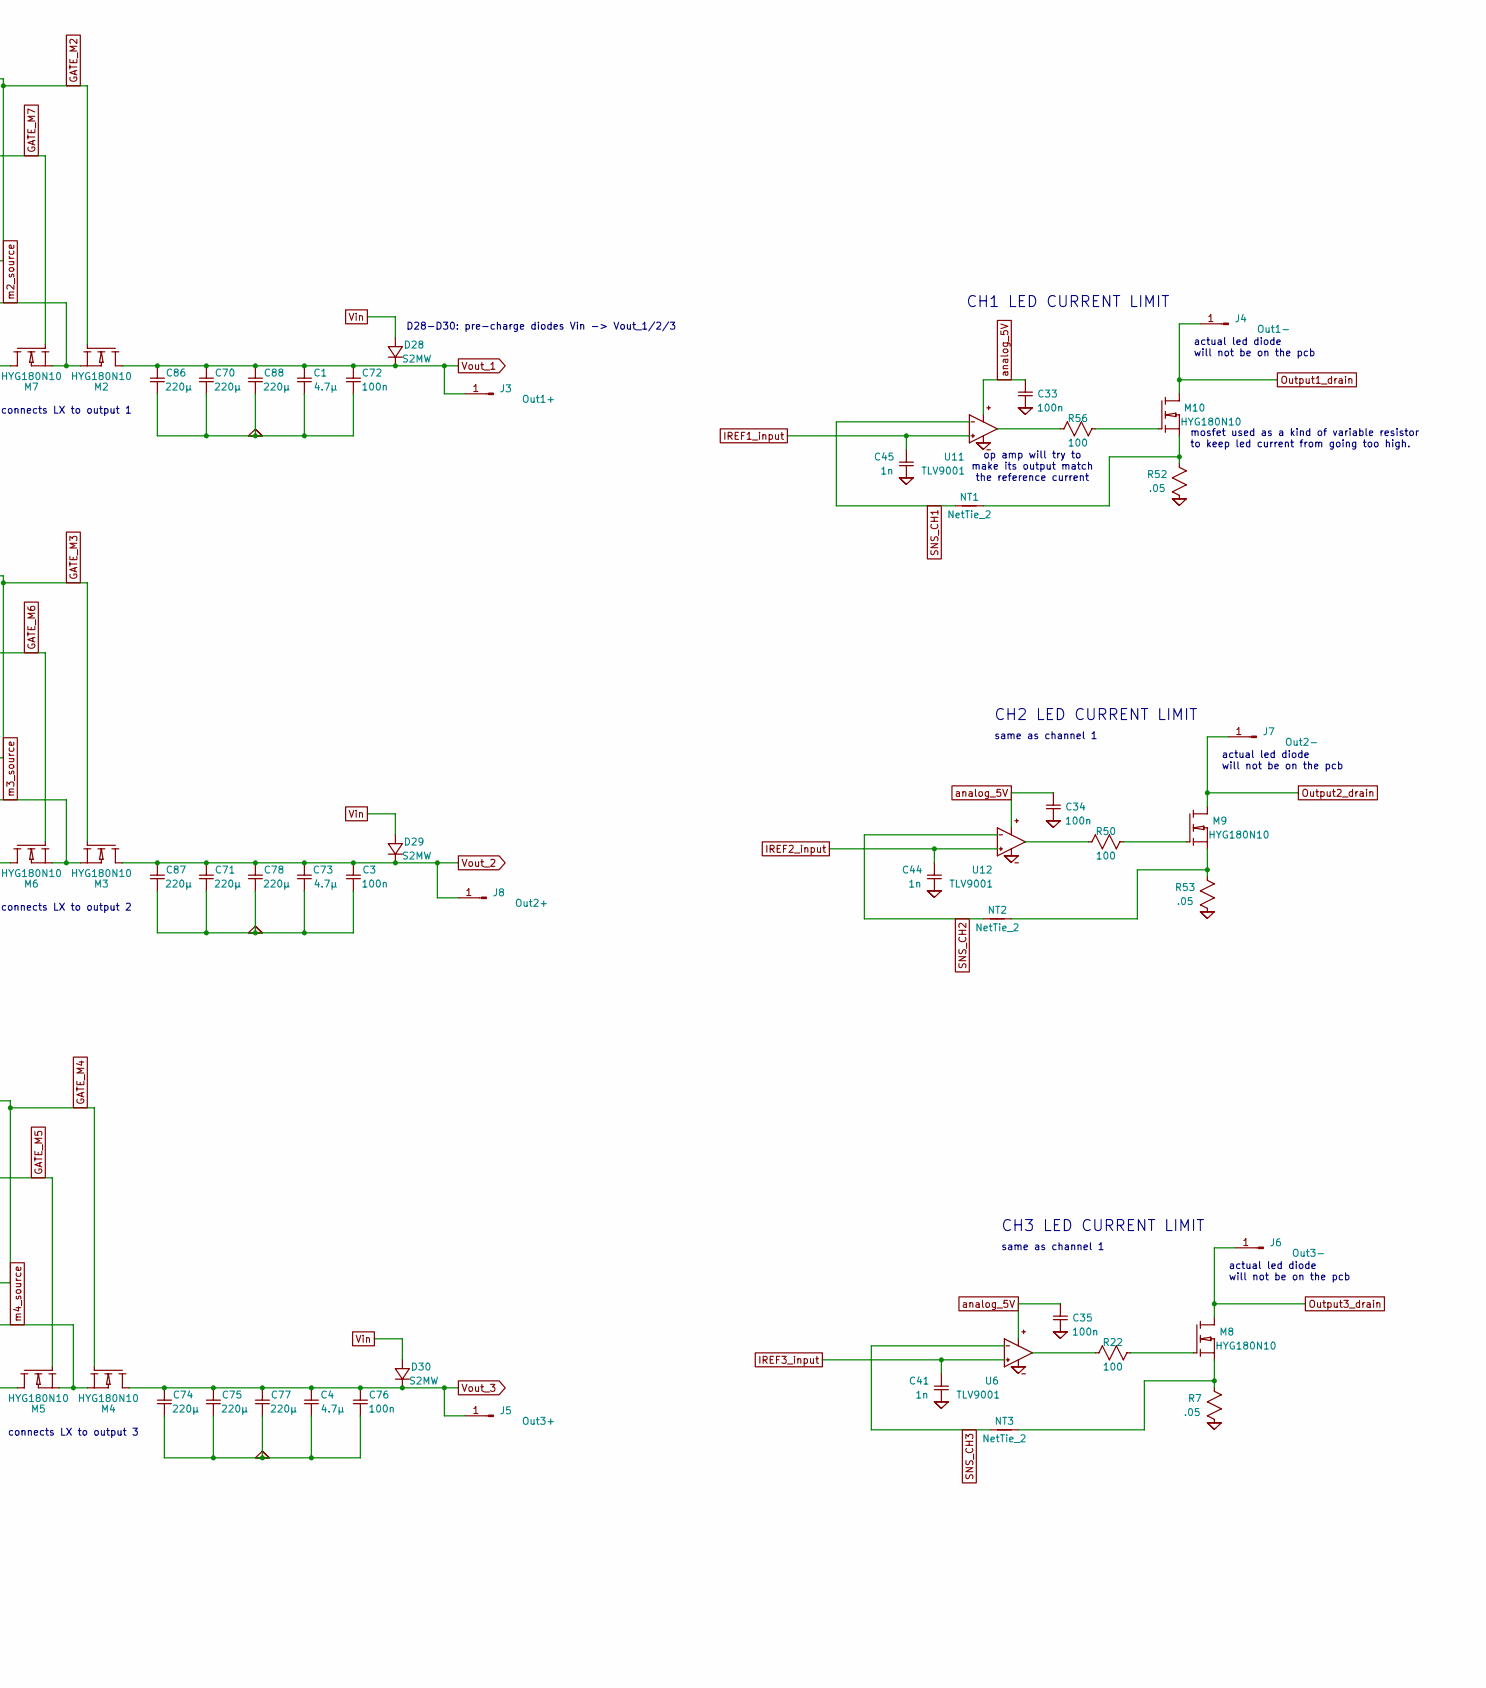
[picture p273: schematic BOOST_power_RC2.kicad_sch, BOOST LED driver - Power board, part in row 1, column 2]

Parts:
C1, C4, C73: 4.7µ; C_1210_3225Metric
C3, C72, C76: 100n; C_0805_2012Metric
C6, C21, C25, C31, C62, C89: 1µ; C_0805_2012Metric
C7, C55: 22µ; C_1210_3225Metric; MPN GRM32ER71E226KE15L; LCSC C21397
C16, C18, C60: 2.2µ; C_1206_3216Metric
C20, C33, C34, C35, C48, C50, C51, C61, C82, C83, C84, C90: 100n; C_0603_1608Metric
C30: 47µ; CP_EIA-7343-31_Kemet-D; MPN TR3D476K025C0250; LCSC C4979367
C39, C56, C79, C80, C81: 10µ; C_1210_3225Metric
C40, C69, C85: 680µ; CP_Elec_10x12.5; MPN EEH-ZU1E681UP; LCSC C29664285
C41, C44, C45: 1n; C_0603_1608Metric
C70, C71, C75, C77, C78, C88: 220µ; CP_Elec_10x16.5; MPN EEH-ZS1H221P
C74, C86, C87: 220µ; CP_Elec_10x16.5; MPN EEH-ZU1H221P
D2, D8, D11, D13, D14, D22: B5819W; D_SOD-123
D9, D10, D21: BAV21W; D_SOD-123
D19: 5.0SMDJ54A; D_SMC; MPN 5.0SMDJ54A; LCSC C20415356
D28, D29, D30: S2MW; D_SOD-123F; MPN S2MW; LCSC C128729
H5, H6, H7, H8: MountingHole_M3; MountingHole_3.2mm_M3
J1: Vin+; MountingHole_4.3mm_M4_Pad7.0_TopBottom
J2: Vin-; MountingHole_4.3mm_M4_Pad7.0_TopBottom
J3: Out1+; TestPoint_THTPad_4.0x4.0mm_Drill2.0mm
J4: Out1-; TestPoint_THTPad_4.0x4.0mm_Drill2.0mm
J5: Out3+; TestPoint_THTPad_4.0x4.0mm_Drill2.0mm
J6: Out3-; TestPoint_THTPad_4.0x4.0mm_Drill2.0mm
J7: Out2-; TestPoint_THTPad_4.0x4.0mm_Drill2.0mm
J8: Out2+; TestPoint_THTPad_4.0x4.0mm_Drill2.0mm
J10: Conn_02x15_2.54mm; PinSocket_2x15_P2.54mm_Vertical; MPN ESQ-115-44-G-D
L1: 6.8µ; IND_CSCF3218-6R8MC
M1, M8, M9, M10: HYG180N10; TO-220-3_Horizontal_TabUp_M2.5
M2, M3, M4, M5, M6, M7: HYG180N10; TO-220-3_Horizontal_TabUp_NoHole
NT1, NT2, NT3: NetTie_2; NetTie-2_SMD_Pad0.5mm
R1: 1m; R_Bourns_CSS4J-4026; MPN CSS4J-4026R-1L00F; LCSC C2076400
R7, R52, R53: .05; R_2512_6332Metric
R13, R23, R47: 220; R_0603_1608Metric
R15: 10; R_0805_2012Metric
R21, R48, R60, R72: 5.1; R_0805_2012Metric; MPN 0805W8F510KT5E; LCSC C17724
R22, R50, R56: 100; R_0603_1608Metric
R49, R61, R62, R73, R74, R75, R76, R104: 10k; R_0603_1608Metric
R59, R70: 5.1; R_0805_2012Metric
U1, U17: L78L05_SOT89; SOT-89-3
U6, U11, U12: TLV9001; SOT-23-5; MPN TLV9001IDBVR
U8, U10, U15, U19: UCC21520DW; SOIC-16W_7.5x10.3mm_P1.27mm
U16: MC7812; TO-263-3_TabPin2; MPN MC7812BD2TR4G
U25: INA241A4xD; SOIC-8_3.9x4.9mm_P1.27mm; MPN INA241A4IDR; LCSC C22427873

Connections:
5V: C7.1, C39.1, C48.1, C62.2, C89.2, C90.1, J10.10, U8.3 (VCCI), U8.6 (DT), U8.8 (VCCI), U10.3 (VCCI), U10.6 (DT), U10.8 (VCCI), U15.3 (VCCI), U15.6 (DT), U15.8 (VCCI), U17.1 (OUT), U19.3 (VCCI), U19.6 (DT), U19.8 (VCCI)
12V: C6.1, C25.1, C30.1, C31.1, D9.2 (+), D10.2 (+), D21.2 (+), J10.19, U16.3 (OUT), U19.11 (VDDB), U19.16 (VDDA)
Current: J10.23, U25.5
GATE_M1: M1.1 (G), R15.2, R104.1
GATE_M2: D11.2 (+), M2.1 (G), R13.1, R75.2
GATE_M3: D14.2 (+), M3.1 (G), R23.2, R61.2
GATE_M4: D13.2 (+), M4.1 (G), R47.1, R73.2
GATE_M5: D22.2 (+), M5.1 (G), R59.1, R74.2
GATE_M6: D8.2 (+), M6.1 (G), R49.1, R70.2
GATE_M7: D2.2 (+), M7.1 (G), R60.2, R76.2
GND: C1.2, C3.2, C4.2, C6.2, C7.2, C20.2, C21.2, C25.2, C30.2, C31.2, C33.2, C34.2, C35.2, C39.2, C40.2, C41.2, C44.2, C45.2, C48.2, C55.2, C56.2, C62.1, C69.2, C70.2, C71.2, C72.2, C73.2, C74.2, C75.2, C76.2, C77.2, C78.2, C79.2, C80.2, C81.2, C82.2, C83.2, C84.2, C85.2, C86.2, C87.2, C88.2, C89.1, C90.2, D19.2 (+), J2.1, J10.1, J10.2, J10.11, J10.12, J10.20, J10.21, J10.24, J10.25, J10.28, J10.29, M1.3 (S), R7.2, R52.2, R53.2, R62.2, R104.2, U1.2 (GND), U6.2 (V-), U8.4 (GND), U8.5 (DIS), U10.4 (GND), U10.5 (DIS), U11.2 (V-), U12.2 (V-), U15.4 (GND), U15.5 (DIS), U16.2 (GND), U17.2 (GND), U19.2 (INB), U19.4 (GND), U19.5 (DIS), U19.9 (VSSB), U19.14 (VSSA), U25.2 (GND), U25.3 (REF2), U25.4 (GND), U25.7 (REF1)
IREF1_input: C45.1, J10.26, U11.3 (In+)
IREF2_input: C44.1, J10.27, U12.3 (In+)
IREF3_input: C41.1, J10.30, U6.3 (In+)
ISNS_N: R1.3, U25.1 (-)
ISNS_P: R1.2, U25.8 (+)
LX: D19.1 (-), L1.1, M1.2 (D), M5.2 (D), M6.2 (D), M7.2 (D)
M1_ON: J10.3, U19.1 (INA)
M2_ON: J10.4, U15.1 (INA)
unnamed: D2.1 (-), R60.1, U15.10 (OUTB)
unnamed: D8.1 (-), R70.1, U10.10 (OUTB)
unnamed: D9.1 (-), R48.1
unnamed: D10.1 (-), R21.1
unnamed: D11.1 (-), R13.2, U15.15 (OUTA)
unnamed: D13.1 (-), R47.2, U8.15 (OUTA)
unnamed: D14.1 (-), R23.1, U10.15 (OUTA)
unnamed: D21.1 (-), R72.1
unnamed: D22.1 (-), R59.2, U8.10 (OUTB)
unnamed: M8.1 (G), R22.1
unnamed: M8.3 (S), NT3.2, R7.1
unnamed: M9.1 (G), R50.1
unnamed: M9.3 (S), NT2.2, R53.1
unnamed: M10.1 (G), R56.1
unnamed: M10.3 (S), NT1.2, R52.1
unnamed: R22.2, U6.1 (OUT)
unnamed: C60.1, C61.1, R72.2, U8.11 (VDDB), U8.16 (VDDA)
unnamed: C16.1, C50.1, R48.2, U10.11 (VDDB), U10.16 (VDDA)
unnamed: R56.2, U11.1 (OUT)
unnamed: R50.2, U12.1 (OUT)
unnamed: C18.1, C51.1, R21.2, U15.11 (VDDB), U15.16 (VDDA)
unnamed: R15.1, U19.15 (OUTA)
unnamed: R62.1, U19.10 (OUTB)
Output1_drain: J4.1 (Pin_1_1), J10.14, M10.2 (D)
Output2_drain: J7.1 (Pin_1_1), J10.16, M9.2 (D)
Output3_drain: J6.1 (Pin_1_1), J10.18, M8.2 (D)
SNS_CH1: NT1.1, U11.4 (In-)
SNS_CH2: NT2.1, U12.4 (In-)
SNS_CH3: NT3.1, U6.4 (In-)
Vin: C40.1, C69.1, C79.1, C80.1, C81.1, C82.1, C83.1, C84.1, C85.1, D28.2 (+), D29.2 (+), D30.2 (+), J1.1, R1.1, U1.3 (IN), U16.1 (IN), U17.3 (IN)
Vout_1: C1.1, C70.1, C72.1, C86.1, C88.1, D28.1 (-), J3.1 (Pin_1_1), J10.13, M2.2 (D)
Vout_2: C3.1, C71.1, C73.1, C78.1, C87.1, D29.1 (-), J8.1 (Pin_1_1), J10.15, M3.2 (D)
Vout_3: C4.1, C74.1, C75.1, C76.1, C77.1, D30.1 (-), J5.1 (Pin_1_1), J10.17, M4.2 (D)
analog_5V: C20.1, C21.1, C33.1, C34.1, C35.1, C55.1, C56.1, J10.22, U1.1 (OUT), U6.5 (V+), U11.5 (V+), U12.5 (V+), U25.6 (V+)
ena_out_1: J10.5, U15.2 (INB)
ena_out_2: J10.7, U10.2 (INB)
ena_out_3: J10.9, U8.2 (INB)
m2_source: C18.2, C51.2, M2.3 (S), M7.3 (S), R75.1, R76.1, U15.9 (VSSB), U15.14 (VSSA)
m3_source: C16.2, C50.2, M3.3 (S), M6.3 (S), R49.2, R61.1, U10.9 (VSSB), U10.14 (VSSA)
m4_source: C60.2, C61.2, M4.3 (S), M5.3 (S), R73.1, R74.1, U8.9 (VSSB), U8.14 (VSSA)
out_2_on: J10.6, U10.1 (INA)
out_3_on: J10.8, U8.1 (INA)
rsense_lo: L1.2, R1.4

Notes on the sheet:
CH1 LED CURRENT LIMIT
OUTPUT 1
OUTPUT 2
current sense amplifies R1 voltage by 100x
gate driver
CH2 LED CURRENT LIMIT
when m1 pulls inductor to ground, current can conduct through the mosfet body diode to charge up this capacitor
OUTPUT 3
same as channel 1
op amp will try to make its output match the reference current
low side switch
mosfet used as a kind of variable resistor to keep led current from going too high.
1 mOhm shunt: measures inductor current
bootstrap capacitors
connects LX to output 3
clamps LX spikes
CH3 LED CURRENT LIMIT
CONNECTOR
D28-D30: pre-charge diodes Vin -> Vout_1/2/3
connects LX to output 2
actual led diode will not be on the pcb
connects LX to output 1

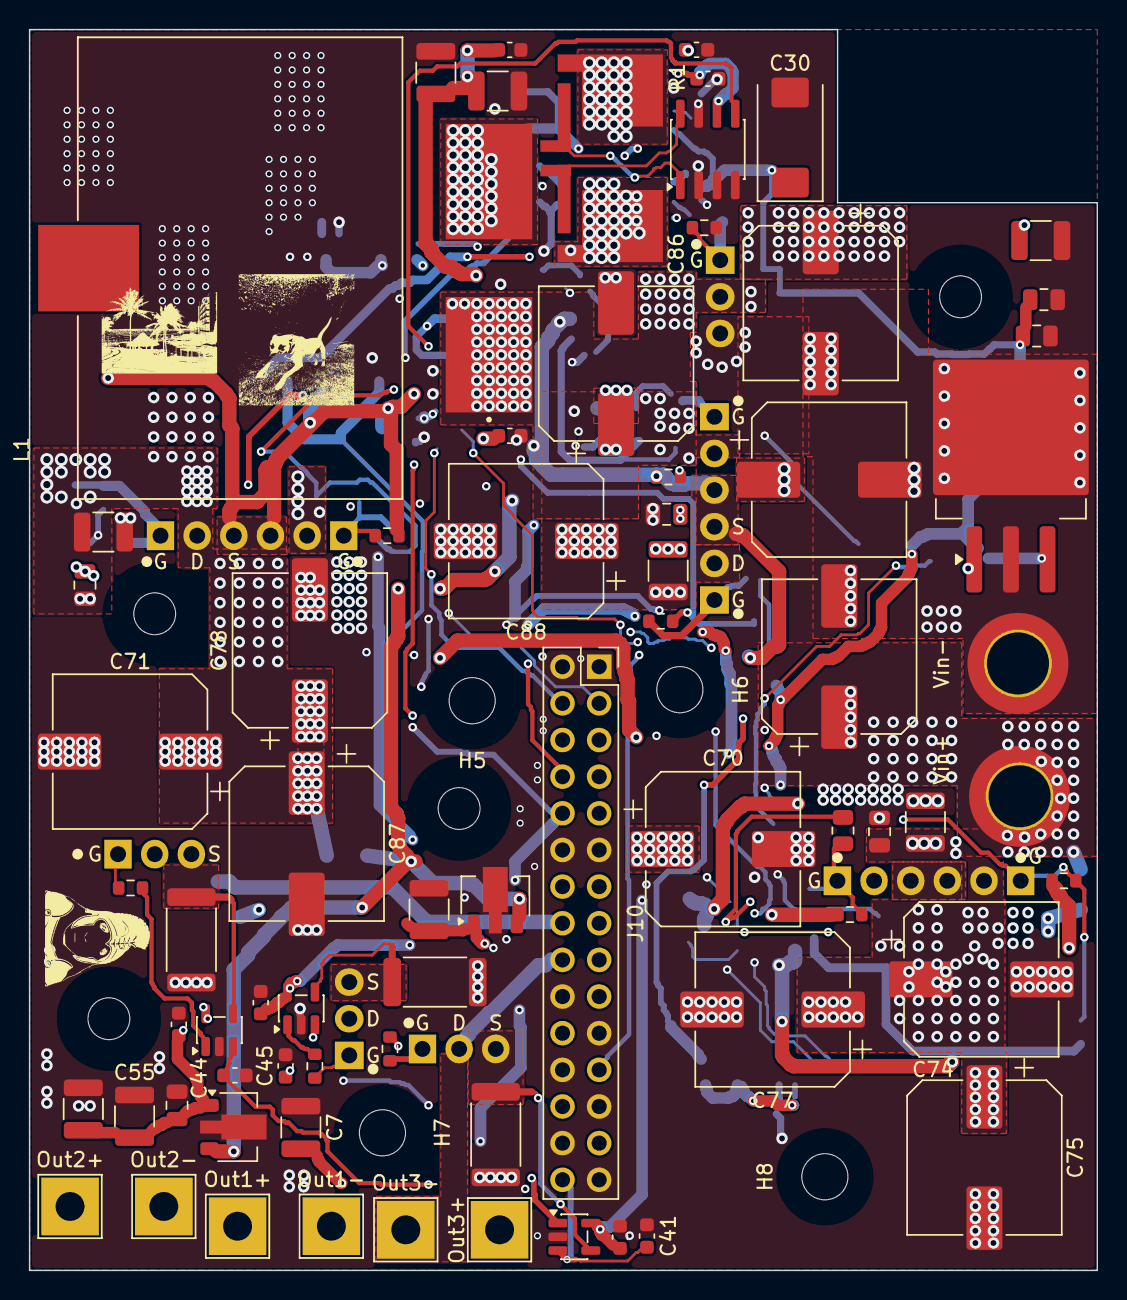
[picture p274: board BOOST_power_RC2.kicad_pcb from above]

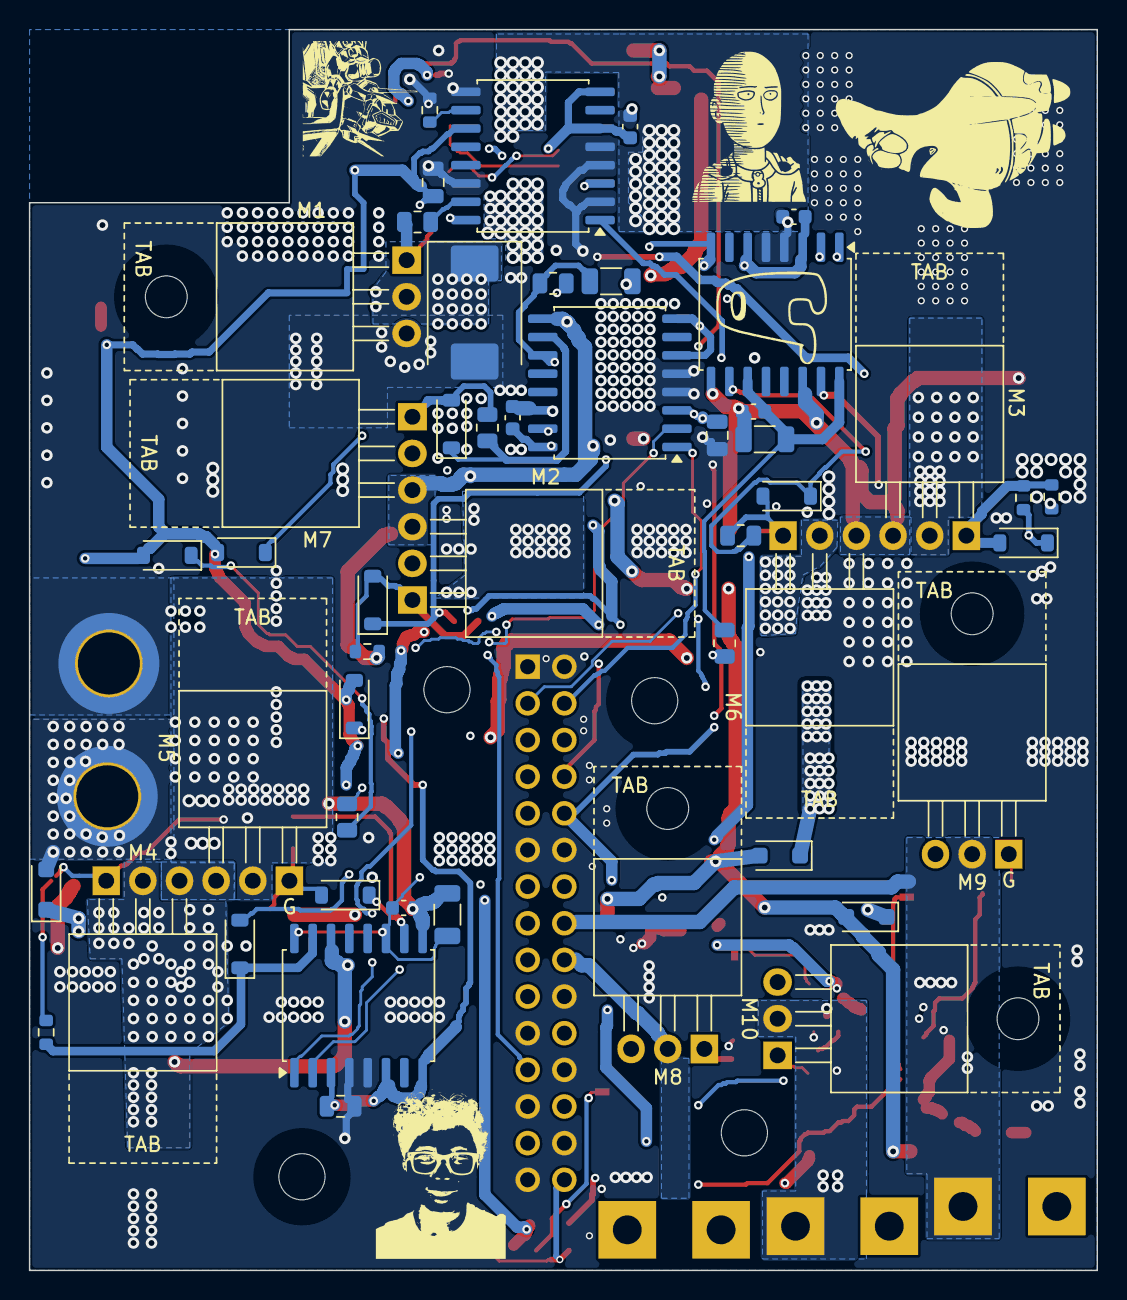
[picture p275: board BOOST_power_RC2.kicad_pcb from below]

Board: 6 copper layers, 74.0 x 86.0 mm, 126 parts (49 on the bottom side), 62 nets.
