ChristopherCa55/led-driver/BOOST_package/KiCad/BOOST.kicad_sch

## KiCad design BOOST_package/KiCad/BOOST.kicad_sch (2026-10-14)

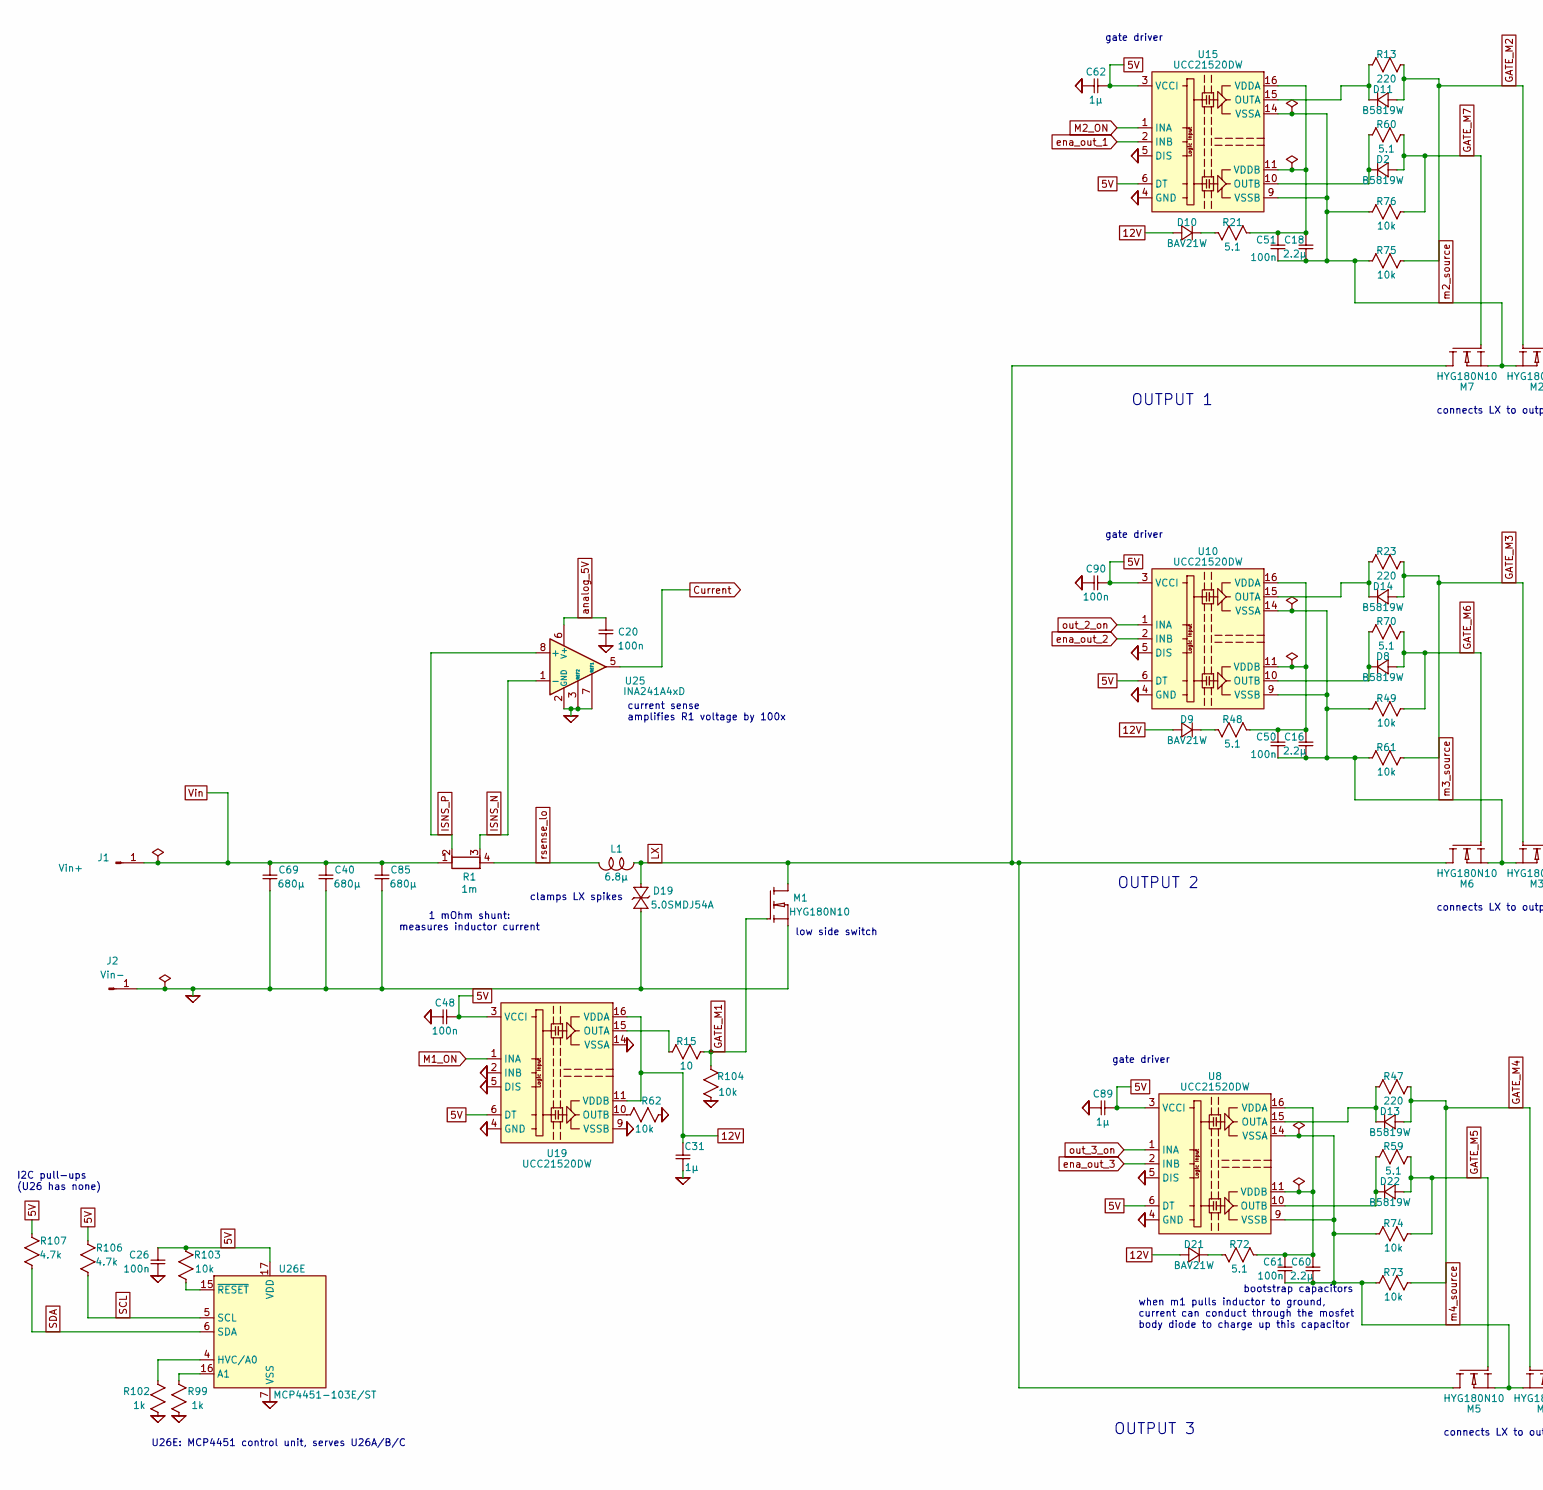
[picture p280: schematic BOOST.kicad_sch, part in row 1, column 1]

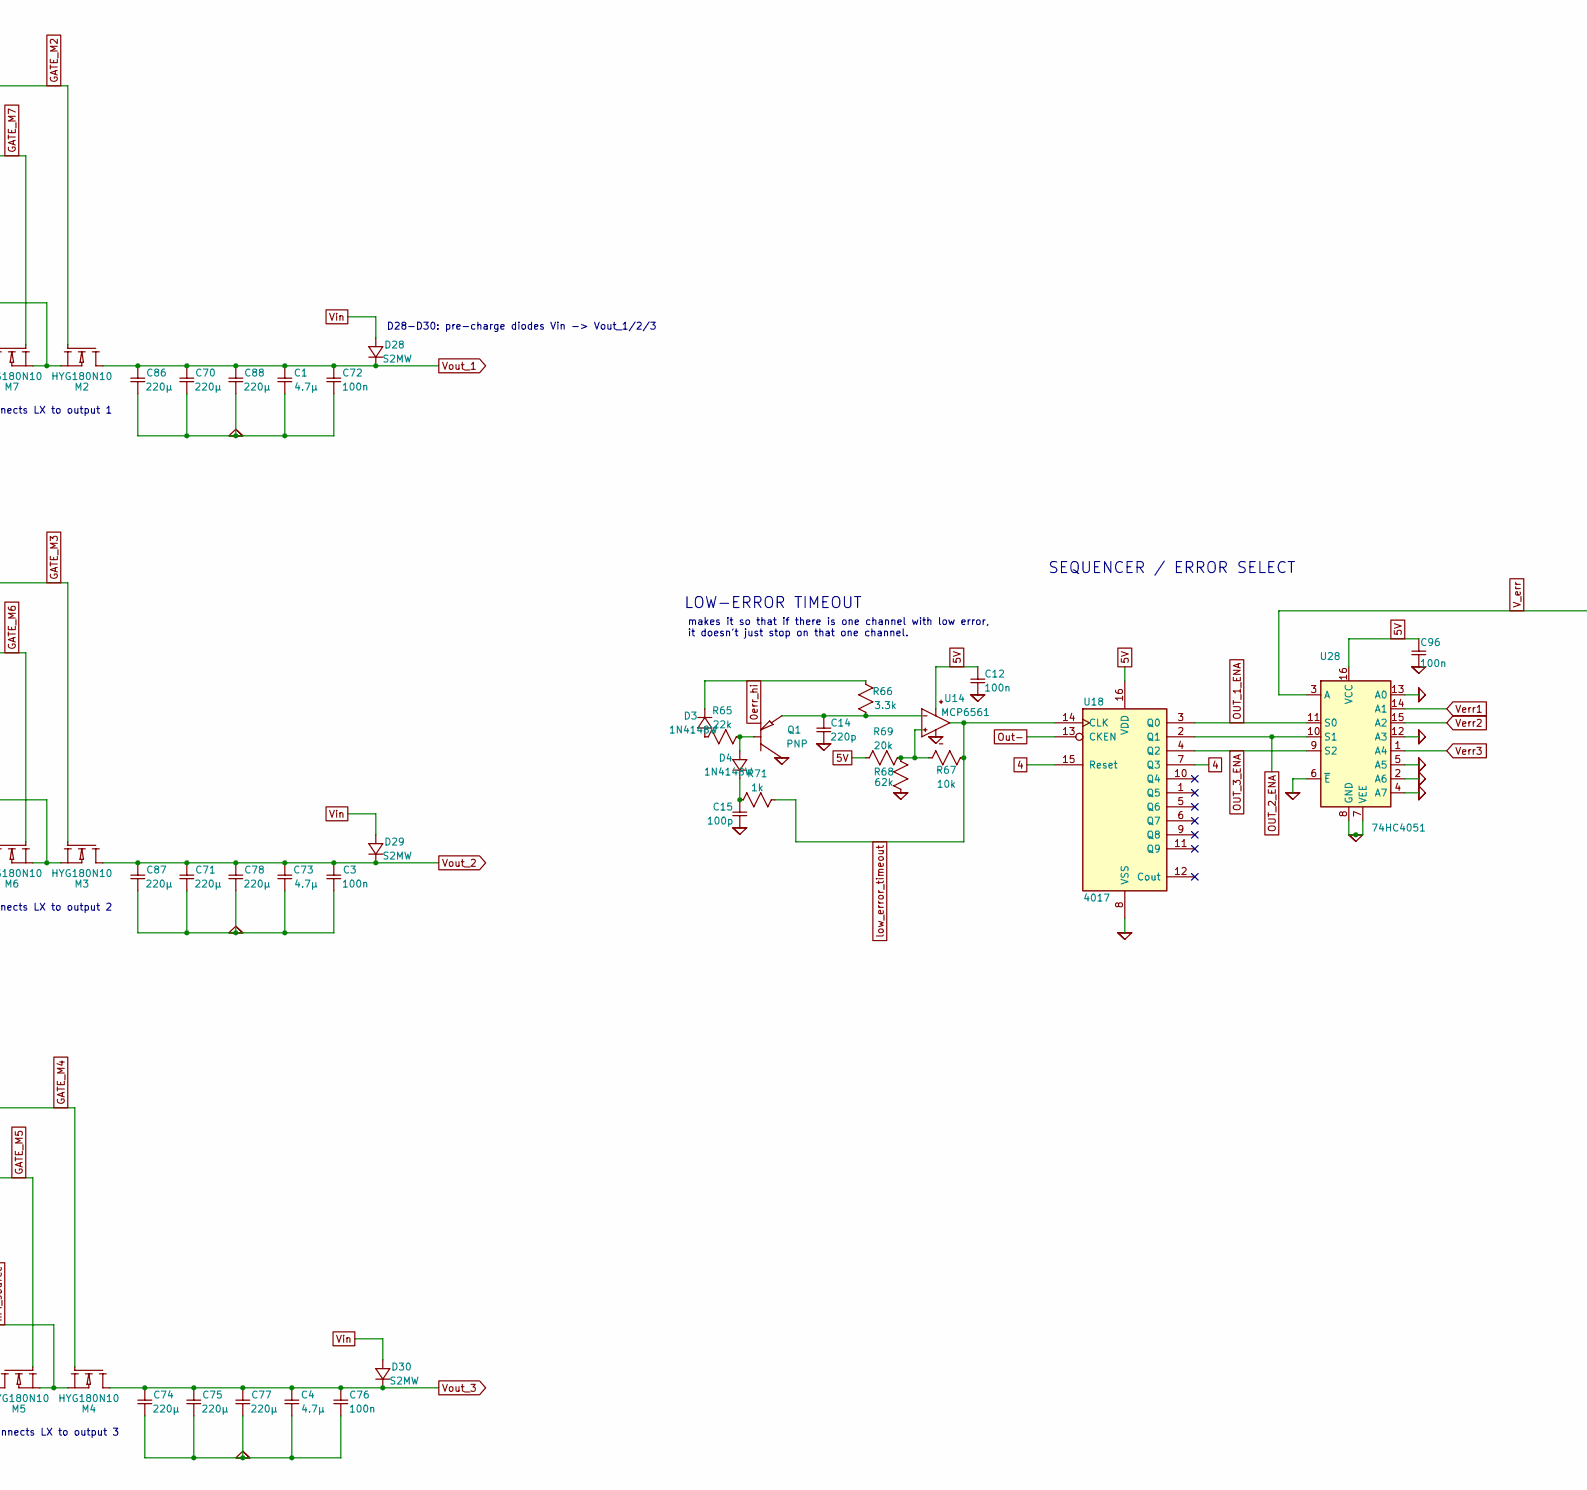
[picture p281: schematic BOOST.kicad_sch, part in row 1, column 2]

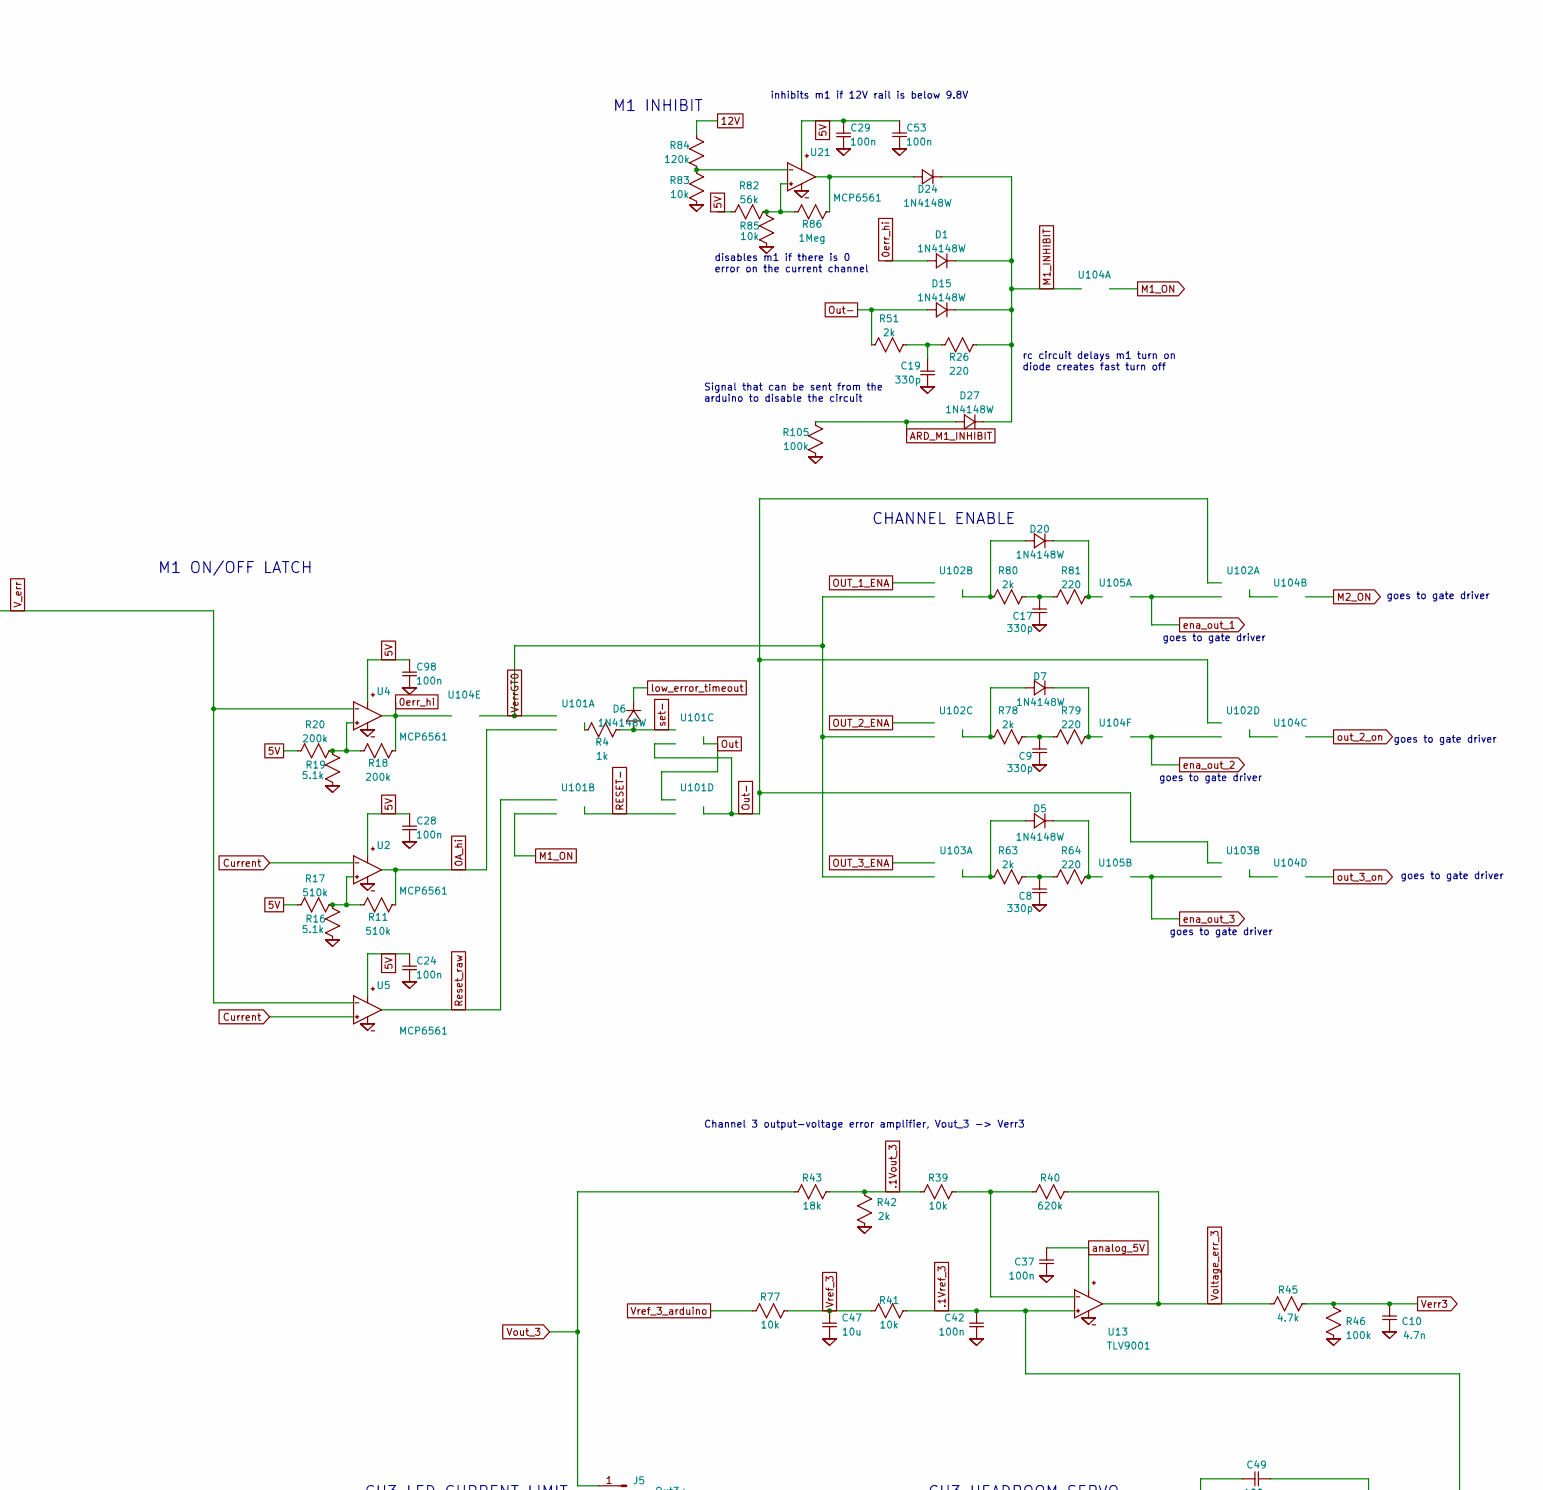
[picture p282: schematic BOOST.kicad_sch, part in row 1, column 3]

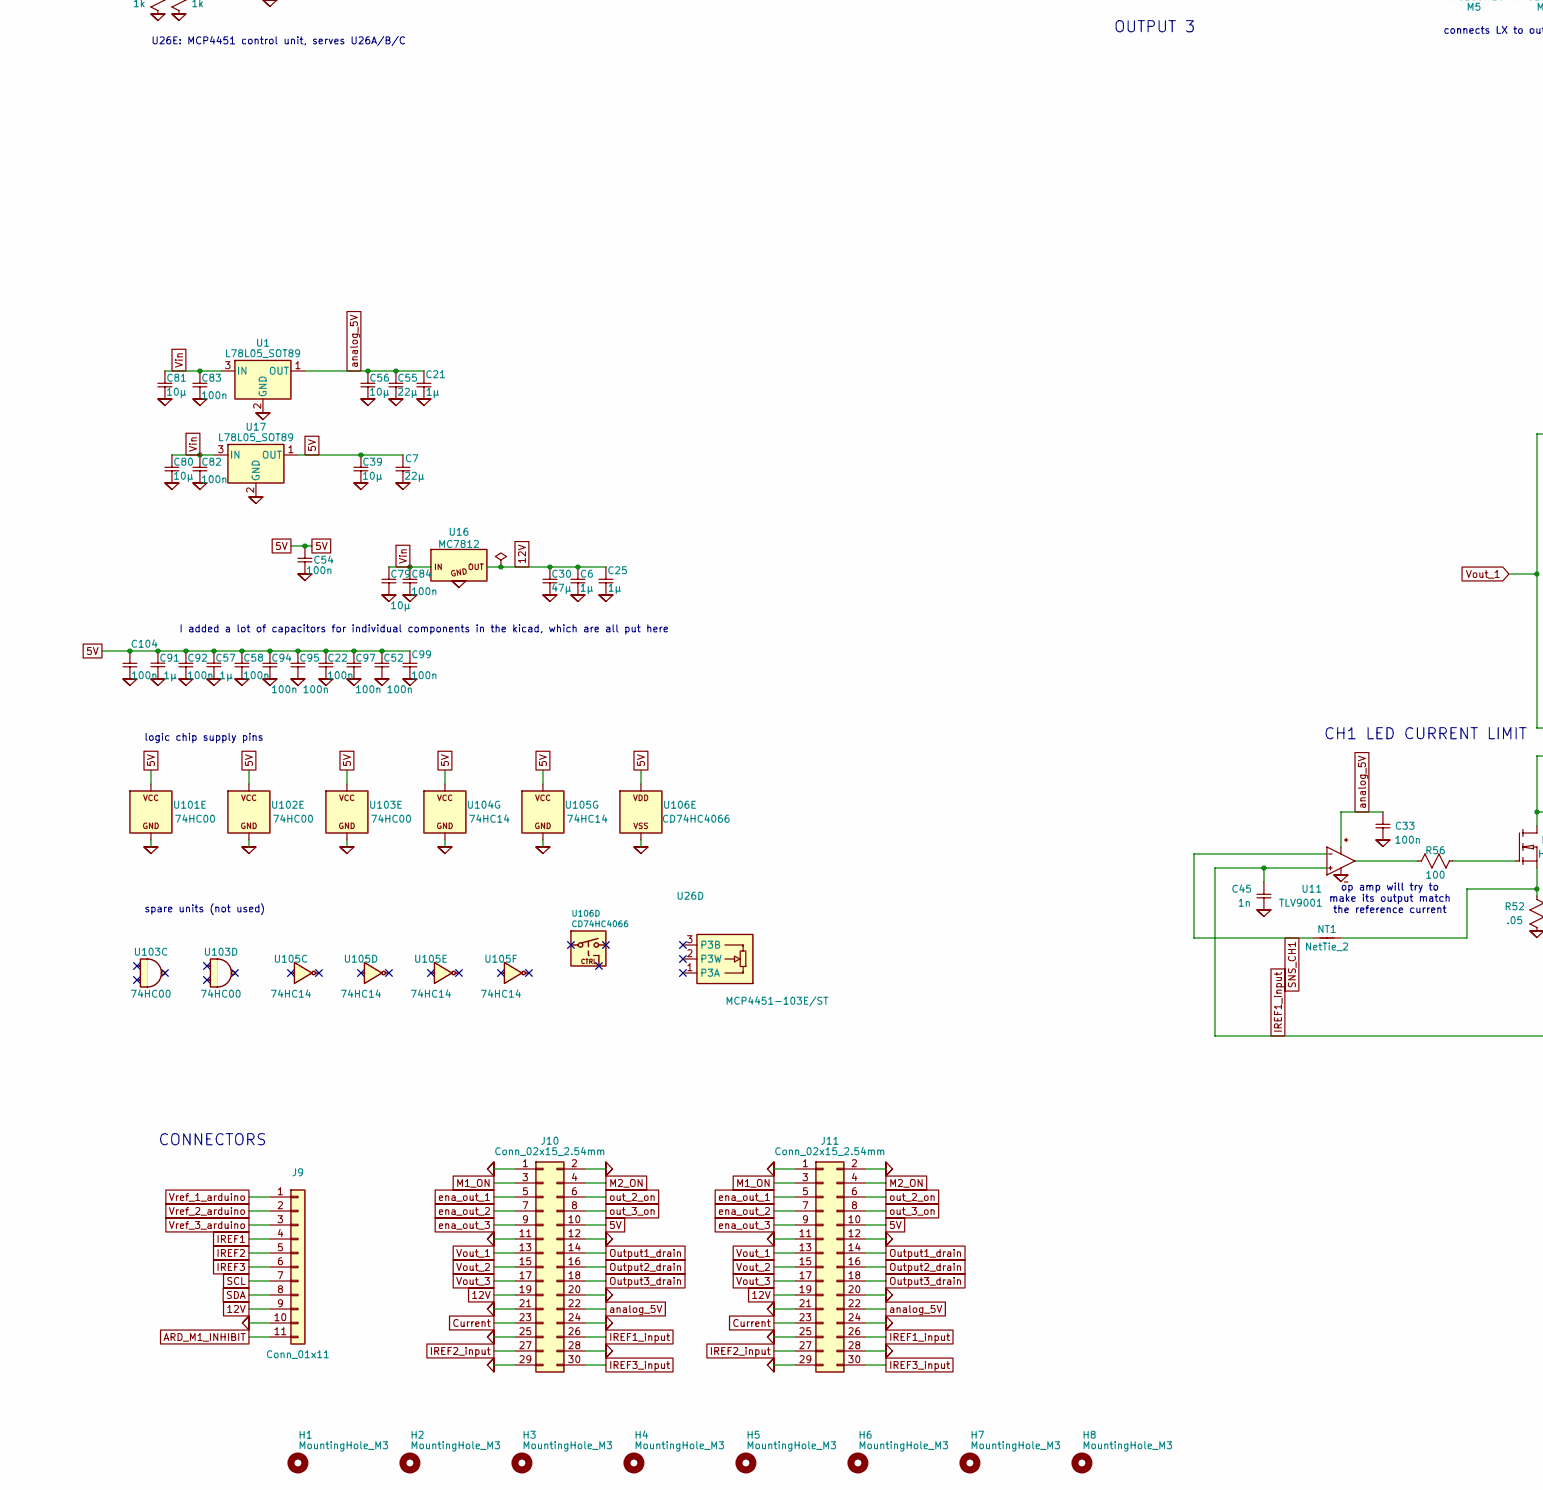
[picture p283: schematic BOOST.kicad_sch, part in row 2, column 1]

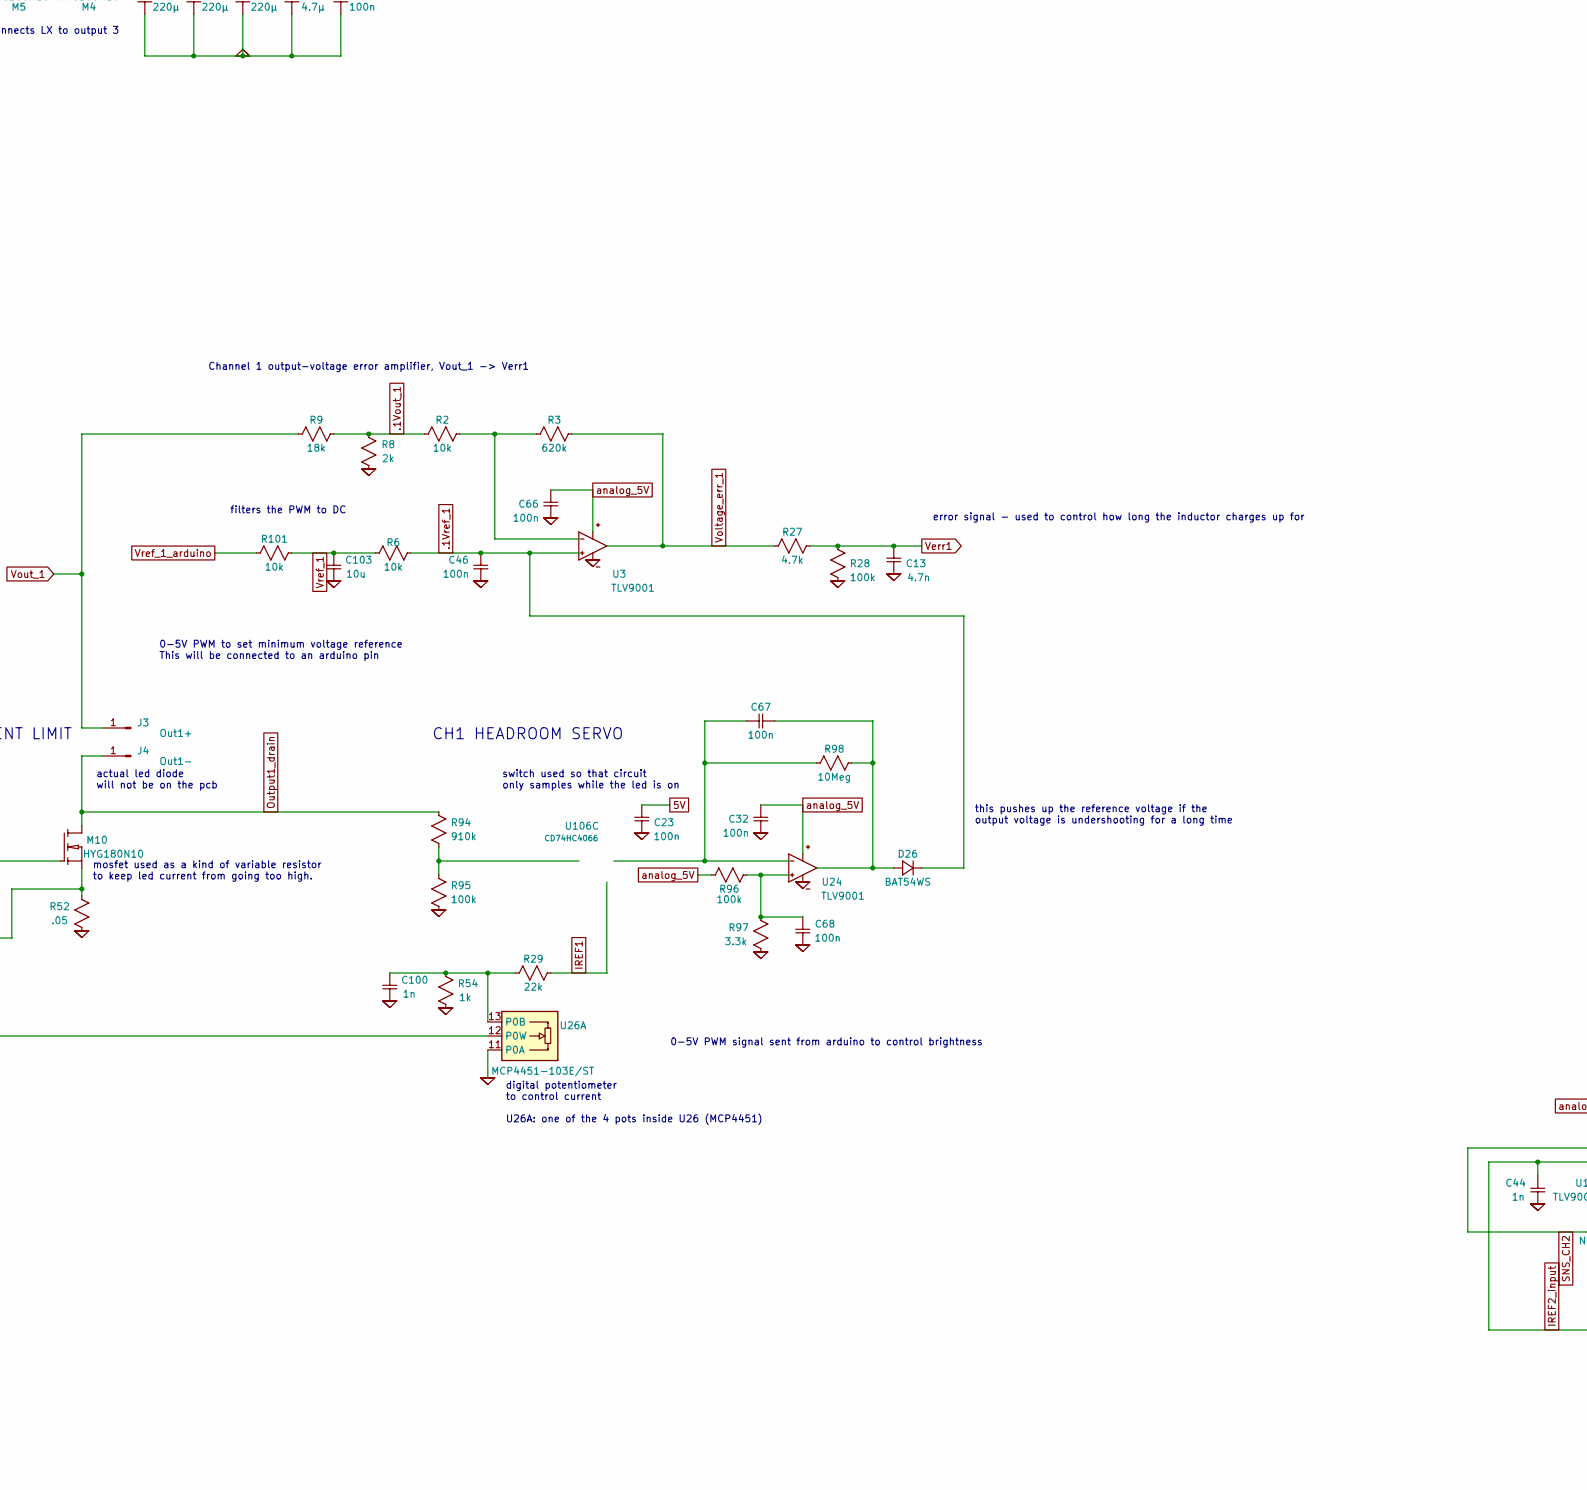
[picture p284: schematic BOOST.kicad_sch, part in row 2, column 2]

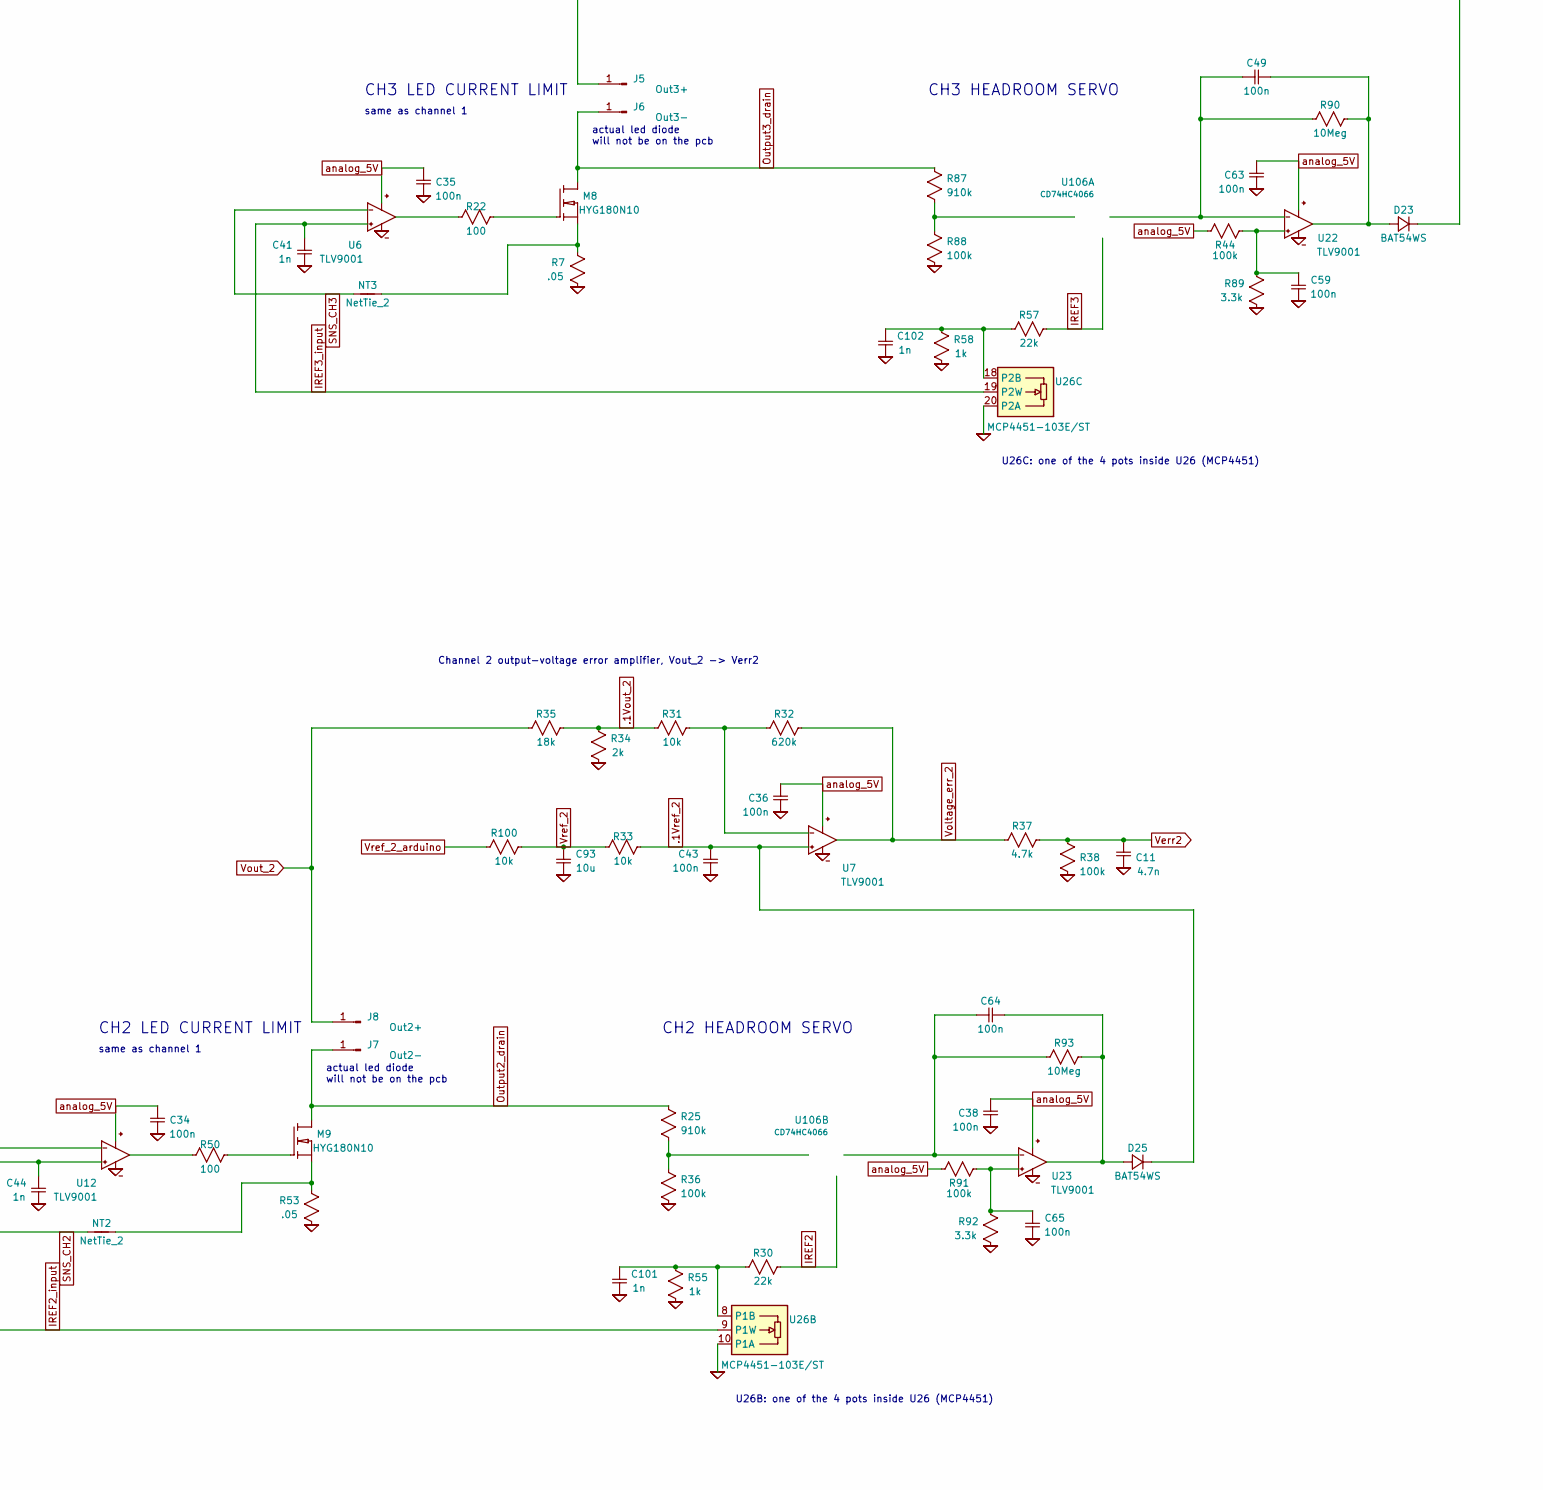
[picture p285: schematic BOOST.kicad_sch, part in row 2, column 3]

Parts:
C1, C4, C73: 4.7µ; C_1210_3225Metric
C3, C72, C76: 100n; C_0805_2012Metric
C6, C21, C25, C31, C57, C62, C89, C91: 1µ; C_0805_2012Metric
C7, C55: 22µ; C_1210_3225Metric; MPN GRM32ER71E226KE15L; LCSC C21397
C8, C9, C17, C19: 330p; C_0603_1608Metric
C10, C11, C13: 4.7n; C_0603_1608Metric
C12, C20, C22, C23, C24, C26, C28, C29, C32, C33, C34, C35, C36, C37, C38, C42, C43, C46, C48, C50, C51, C52, C53, C54, C58, C59, C61, C63, C65, C66, C68, C82, C83, C84, C90, C92, C94, C95, C96, C97, C98, C99, C104: 100n; C_0603_1608Metric
C14: 220p; C_0603_1608Metric
C15: 100p; C_0603_1608Metric
C16, C18, C60: 2.2µ; C_1206_3216Metric
C30: 47µ; CP_EIA-7343-31_Kemet-D; MPN TR3D476K025C0250; LCSC C4979367
C39, C56, C79, C80, C81: 10µ; C_1210_3225Metric
C40, C69, C85: 680µ; CP_Elec_10x12.5; MPN EEH-ZU1E681UP; LCSC C29664285
C41, C44, C45, C100, C101, C102: 1n; C_0603_1608Metric
C47, C93, C103: 10u; C_0603_1608Metric
C49, C64, C67: 100n; C_1206_3216Metric
C70, C71, C75, C77, C78, C88: 220µ; CP_Elec_10x16.5; MPN EEH-ZS1H221P
C74, C86, C87: 220µ; CP_Elec_10x16.5; MPN EEH-ZU1H221P
D1, D3, D4, D5, D6, D7, D15, D20, D24, D27: 1N4148W; D_SOD-123
D2, D8, D11, D13, D14, D22: B5819W; D_SOD-123
D9, D10, D21: BAV21W; D_SOD-123
D19: 5.0SMDJ54A; D_SMC; MPN 5.0SMDJ54A; LCSC C20415356
D23, D25, D26: BAT54WS; D_SOD-323
D28, D29, D30: S2MW; D_SOD-123F; MPN S2MW; LCSC C128729
H1, H2, H3, H4, H5, H6, H7, H8: MountingHole_M3; MountingHole_3.2mm_M3
J1: Vin+; MountingHole_4.3mm_M4_Pad7.0_TopBottom
J2: Vin-; MountingHole_4.3mm_M4_Pad7.0_TopBottom
J3: Out1+; TestPoint_THTPad_4.0x4.0mm_Drill2.0mm
J4: Out1-; TestPoint_THTPad_4.0x4.0mm_Drill2.0mm
J5: Out3+; TestPoint_THTPad_4.0x4.0mm_Drill2.0mm
J6: Out3-; TestPoint_THTPad_4.0x4.0mm_Drill2.0mm
J7: Out2-; TestPoint_THTPad_4.0x4.0mm_Drill2.0mm
J8: Out2+; TestPoint_THTPad_4.0x4.0mm_Drill2.0mm
J9: Conn_01x11; WirePads_11_Staggered_P1.27mm_Drill1.0mm_TieSlots
J10: Conn_02x15_2.54mm; PinSocket_2x15_P2.54mm_Vertical; MPN ESQ-115-44-G-D
J11: Conn_02x15_2.54mm; PinHeader_2x15_P2.54mm_Vertical; MPN TSW-115-07-G-D
L1: 6.8µ; IND_CSCF3218-6R8MC
M1, M8, M9, M10: HYG180N10; TO-220-3_Horizontal_TabUp_M2.5
M2, M3, M4, M5, M6, M7: HYG180N10; TO-220-3_Horizontal_TabUp_NoHole
NT1, NT2, NT3: NetTie_2; NetTie-2_SMD_Pad0.5mm
Q1: PNP; SOT-23
R1: 1m; R_Bourns_CSS4J-4026; MPN CSS4J-4026R-1L00F; LCSC C2076400
R2, R6, R31, R33, R39, R41, R49, R61, R62, R67, R73, R74, R75, R76, R77, R83, R85, R100, R101, R103, R104: 10k; R_0603_1608Metric
R3, R32, R40: 620k; R_0603_1608Metric
R4, R54, R55, R58, R71, R99, R102: 1k; R_0603_1608Metric
R7, R52, R53: .05; R_2512_6332Metric
R8, R34, R42, R51, R63, R78, R80: 2k; R_0603_1608Metric
R9, R35, R43: 18k; R_0805_2012Metric
R11, R17: 510k; R_0603_1608Metric
R13, R23, R26, R47, R64, R79, R81: 220; R_0603_1608Metric
R15: 10; R_0805_2012Metric
R16, R19: 5.1k; R_0603_1608Metric
R18, R20: 200k; R_0603_1608Metric
R21, R48, R60, R72: 5.1; R_0805_2012Metric; MPN 0805W8F510KT5E; LCSC C17724
R22, R50, R56: 100; R_0603_1608Metric
R25, R87, R94: 910k; R_0805_2012Metric
R27, R37, R45, R106, R107: 4.7k; R_0603_1608Metric
R28, R36, R38, R44, R46, R88, R91, R95, R96, R105: 100k; R_0603_1608Metric
R29, R30, R57: 22k; R_0805_2012Metric
R59, R70: 5.1; R_0805_2012Metric
R65: 22k; R_0603_1608Metric
R66, R89, R92, R97: 3.3k; R_0603_1608Metric
R68: 62k; R_0603_1608Metric
R69: 20k; R_0603_1608Metric
R82: 56k; R_0603_1608Metric
R84: 120k; R_0603_1608Metric
R86: 1Meg; R_0805_2012Metric
R90, R93, R98: 10Meg; R_0603_1608Metric
U1, U17: L78L05_SOT89; SOT-89-3
U2, U4, U5, U14, U21: MCP6561; SOT-23-5
U3, U6, U7, U11, U12, U13, U22, U23, U24: TLV9001; SOT-23-5; MPN TLV9001IDBVR
U8, U10, U15, U19: UCC21520DW; SOIC-16W_7.5x10.3mm_P1.27mm
U16: MC7812; TO-263-3_TabPin2; MPN MC7812BD2TR4G
U18: 4017; SOIC-16_3.9x9.9mm_P1.27mm
U25: INA241A4xD; SOIC-8_3.9x4.9mm_P1.27mm; MPN INA241A4IDR; LCSC C22427873
U26: MCP4451-103E/ST; TSSOP-20_4.4x6.5mm_P0.65mm; MPN MCP4451-103E/ST; LCSC C145613
U28: 74HC4051; SOIC-16_3.9x9.9mm_P1.27mm
U101, U102, U103: 74HC00; SOIC-14_3.9x8.7mm_P1.27mm
U104, U105: 74HC14; SOIC-14_3.9x8.7mm_P1.27mm
U106: CD74HC4066; SOIC-14_3.9x8.7mm_P1.27mm

Connections:
0A_hi: R11.1, U2.1 (OUT), U101.2 (B)
0err_hi: D1.2 (+), D3.1 (-), R18.1, R66.1, U4.1 (OUT), U104.11 (A)
4: U18.7 (Q3), U18.15 (Reset)
5V: C7.1, C12.1, C22.1, C23.1, C24.1, C26.1, C28.1, C29.1, C39.1, C48.1, C52.1, C53.2, C54.1, C57.2, C58.1, C62.2, C89.2, C90.1, C91.2, C92.1, C94.1, C95.1, C96.1, C97.1, C98.1, C99.1, C104.1, J10.10, J11.10, R17.2, R20.2, R69.2, R82.1, R103.1, R106.1, R107.1, U2.5 (V+), U4.5 (V+), U5.5 (V+), U8.3 (VCCI), U8.6 (DT), U8.8 (VCCI), U10.3 (VCCI), U10.6 (DT), U10.8 (VCCI), U14.5 (V+), U15.3 (VCCI), U15.6 (DT), U15.8 (VCCI), U17.1 (OUT), U18.16 (VDD), U19.3 (VCCI), U19.6 (DT), U19.8 (VCCI), U21.5 (V+), U26.17 (VDD), U28.16 (VCC), U101.14 (VCC), U102.14 (VCC), U103.14 (VCC), U104.14 (VCC), U105.14 (VCC), U106.14 (VDD)
12V: C6.1, C25.1, C30.1, C31.1, D9.2 (+), D10.2 (+), D21.2 (+), J9.9, J10.19, J11.19, R84.1, U16.3 (OUT), U19.11 (VDDB), U19.16 (VDDA)
.1Vout_1: R2.2, R8.1, R9.1
.1Vout_2: R31.2, R34.1, R35.1
.1Vout_3: R39.2, R42.1, R43.1
.1Vref_1: C46.1, D26.1 (-), R6.2, U3.3 (In+)
.1Vref_2: C43.1, D25.1 (-), R33.2, U7.3 (In+)
.1Vref_3: C42.1, D23.1 (-), R41.2, U13.3 (In+)
ARD_M1_INHIBIT: D27.2 (+), J9.11, R105.1
Current: J10.23, J11.23, U2.4 (In-), U5.3 (In+), U25.5
GATE_M1: M1.1 (G), R15.2, R104.1
GATE_M2: D11.2 (+), M2.1 (G), R13.1, R75.2
GATE_M3: D14.2 (+), M3.1 (G), R23.2, R61.2
GATE_M4: D13.2 (+), M4.1 (G), R47.1, R73.2
GATE_M5: D22.2 (+), M5.1 (G), R59.1, R74.2
GATE_M6: D8.2 (+), M6.1 (G), R49.1, R70.2
GATE_M7: D2.2 (+), M7.1 (G), R60.2, R76.2
GND: C1.2, C3.2, C4.2, C6.2, C7.2, C8.1, C9.1, C10.1, C11.1, C12.2, C13.1, C14.2, C15.2, C17.1, C19.2, C20.2, C21.2, C22.2, C23.2, C24.2, C25.2, C26.2, C28.2, C29.2, C30.2, C31.2, C32.2, C33.2, C34.2, C35.2, C36.1, C37.1, C38.1, C39.2, C40.2, C41.2, C42.2, C43.2, C44.2, C45.2, C46.2, C47.2, C48.2, C52.2, C53.1, C54.2, C55.2, C56.2, C57.1, C58.2, C59.2, C62.1, C63.2, C65.2, C66.2, C68.2, C69.2, C70.2, C71.2, C72.2, C73.2, C74.2, C75.2, C76.2, C77.2, C78.2, C79.2, C80.2, C81.2, C82.2, C83.2, C84.2, C85.2, C86.2, C87.2, C88.2, C89.1, C90.2, C91.1, C92.2, C93.2, C94.2, C95.2, C96.2, C97.2, C98.2, C99.2, C100.2, C101.2, C102.2, C103.2, C104.2, D19.2 (+), J2.1, J9.10, J10.1, J10.2, J10.11, J10.12, J10.20, J10.21, J10.24, J10.25, J10.28, J10.29, J11.1, J11.2, J11.11, J11.12, J11.20, J11.21, J11.24, J11.25, J11.28, J11.29, M1.3 (S), Q1.3 (C), R7.2, R8.2, R16.2, R19.2, R28.1, R34.2, R36.2, R38.1, R42.2, R46.1, R52.2, R53.2, R54.2, R55.2, R58.2, R62.2, R68.2, R83.2, R85.2, R88.2, R89.2, R92.2, R95.2, R97.2, R99.2, R102.2, R104.2, R105.2, U1.2 (GND), U2.2 (V-), U3.2 (V-), U4.2 (V-), U5.2 (V-), U6.2 (V-), U7.2 (V-), U8.4 (GND), U8.5 (DIS), U10.4 (GND), U10.5 (DIS), U11.2 (V-), U12.2 (V-), U13.2 (V-), U14.2 (V-), U15.4 (GND), U15.5 (DIS), U16.2 (GND), U17.2 (GND), U18.8 (VSS), U19.2 (INB), U19.4 (GND), U19.5 (DIS), U19.9 (VSSB), U19.14 (VSSA), U21.2 (V-), U22.2 (V-), U23.2 (V-), U24.2 (V-), U25.2 (GND), U25.3 (REF2), U25.4 (GND), U25.7 (REF1), U26.7 (VSS), U26.10 (P1A), U26.11 (P0A), U26.20 (P2A), U28.2 (A6), U28.4 (A7), U28.5 (A5), U28.6 (~E), U28.7 (VEE), U28.8 (GND), U28.12 (A3), U28.13 (A0), U101.7 (GND), U102.7 (GND), U103.7 (GND), U104.7 (GND), U105.7 (GND), U106.7 (VSS)
IREF1: J9.4, R29.1, U106.6 (CTRL)
IREF1_input: C45.1, J10.26, J11.26, U11.3 (In+), U26.12 (P0W)
IREF2: J9.5, R30.1, U106.5 (CTRL)
IREF2_input: C44.1, J10.27, J11.27, U12.3 (In+), U26.9 (P1W)
IREF3: J9.6, R57.1, U106.13 (CTRL)
IREF3_input: C41.1, J10.30, J11.30, U6.3 (In+), U26.19 (P2W)
ISNS_N: R1.3, U25.1 (-)
ISNS_P: R1.2, U25.8 (+)
LX: D19.1 (-), L1.1, M1.2 (D), M5.2 (D), M6.2 (D), M7.2 (D)
M1_INHIBIT: D1.1 (-), D15.1 (-), D24.1 (-), D27.1 (-), R26.1, U104.1 (A)
M1_ON: J10.3, J11.3, U19.1 (INA), U101.5 (B), U104.2 (Y)
M2_ON: J10.4, J11.4, U15.1 (INA), U104.4 (Y)
unnamed: C8.2, R63.1, R64.1
unnamed: C9.2, R78.1, R79.1
unnamed: C14.1, Q1.2 (E), R66.2, U14.4 (In-)
unnamed: C15.1, D4.1 (-), R71.1
unnamed: C16.1, C50.1, R48.2, U10.11 (VDDB), U10.16 (VDDA)
unnamed: C17.2, R80.1, R81.1
unnamed: C18.1, C51.1, R21.2, U15.11 (VDDB), U15.16 (VDDA)
unnamed: C19.1, R26.2, R51.2
unnamed: C49.1, R90.1, U22.4 (In-), U106.2 (B)
unnamed: C49.2, D23.2 (+), R90.2, U22.1 (OUT)
unnamed: C59.1, R44.2, R89.1, U22.3 (In+)
unnamed: C60.1, C61.1, R72.2, U8.11 (VDDB), U8.16 (VDDA)
unnamed: C64.1, R93.1, U23.4 (In-), U106.4 (B)
unnamed: C64.2, D25.2 (+), R93.2, U23.1 (OUT)
unnamed: C65.1, R91.2, R92.1, U23.3 (In+)
unnamed: C67.1, R98.1, U24.4 (In-), U106.9 (B)
unnamed: C67.2, D26.2 (+), R98.2, U24.1 (OUT)
unnamed: C68.1, R96.2, R97.1, U24.3 (In+)
unnamed: C100.1, R29.2, R54.1, U26.13 (P0B)
unnamed: C101.1, R30.2, R55.1, U26.8 (P1B)
unnamed: C102.1, R57.2, R58.1, U26.18 (P2B)
unnamed: D2.1 (-), R60.1, U15.10 (OUTB)
unnamed: D3.2 (+), R65.2
unnamed: D4.2 (+), Q1.1 (B), R65.1
unnamed: D5.1 (-), R64.2, U105.3 (A)
unnamed: D5.2 (+), R63.2, U103.3 (Y)
unnamed: D7.1 (-), R79.2, U104.13 (A)
unnamed: D7.2 (+), R78.2, U102.8 (Y)
unnamed: D8.1 (-), R70.1, U10.10 (OUTB)
unnamed: D9.1 (-), R48.1
unnamed: D10.1 (-), R21.1
unnamed: D11.1 (-), R13.2, U15.15 (OUTA)
unnamed: D13.1 (-), R47.2, U8.15 (OUTA)
unnamed: D14.1 (-), R23.1, U10.15 (OUTA)
unnamed: D20.1 (-), R81.2, U105.1 (A)
unnamed: D20.2 (+), R80.2, U102.6 (Y)
unnamed: D21.1 (-), R72.1
unnamed: D22.1 (-), R59.2, U8.10 (OUTB)
unnamed: D24.2 (+), R86.1, U21.1 (OUT)
unnamed: M8.1 (G), R22.1
unnamed: M8.3 (S), NT3.2, R7.1
unnamed: M9.1 (G), R50.1
unnamed: M9.3 (S), NT2.2, R53.1
unnamed: M10.1 (G), R56.1
unnamed: M10.3 (S), NT1.2, R52.1
unnamed: R2.1, R3.2, U3.4 (In-)
unnamed: R4.2, U101.3 (Y)
unnamed: R11.2, R16.1, R17.1, U2.3 (In+)
unnamed: R15.1, U19.15 (OUTA)
unnamed: R18.2, R19.1, R20.1, U4.3 (In+)
unnamed: R22.2, U6.1 (OUT)
unnamed: R25.2, R36.1, U106.3 (A)
unnamed: R31.1, R32.2, U7.4 (In-)
unnamed: R39.1, R40.2, U13.4 (In-)
unnamed: R50.2, U12.1 (OUT)
unnamed: R56.2, U11.1 (OUT)
unnamed: R62.1, U19.10 (OUTB)
unnamed: R67.2, R68.1, R69.1, U14.3 (In+)
unnamed: R82.2, R85.1, R86.2, U21.3 (In+)
unnamed: R83.1, R84.2, U21.4 (In-)
unnamed: R87.2, R88.1, U106.1 (A)
unnamed: R94.2, R95.1, U106.8 (A)
unnamed: R99.1, U26.16 (A1)
unnamed: R102.1, U26.4 (HVC/A0)
unnamed: R103.2, U26.15 (~RESET)
unnamed: U102.3 (Y), U104.3 (A)
unnamed: U102.11 (Y), U104.5 (A)
unnamed: U103.6 (Y), U104.9 (A)
OUT_1_ENA: U18.3 (Q0), U28.11 (S0), U102.4 (A)
OUT_2_ENA: U18.2 (Q1), U28.10 (S1), U102.10 (A)
OUT_3_ENA: U18.4 (Q2), U28.9 (S2), U103.1 (A)
Out: U101.8 (Y), U101.13 (A)
Out-: D15.2 (+), R51.1, U18.13 (CKEN), U101.9 (B), U101.11 (Y), U102.1 (A), U102.13 (A), U103.5 (B)
Output1_drain: J4.1, J10.14, J11.14, M10.2 (D), R94.1
Output2_drain: J7.1, J10.16, J11.16, M9.2 (D), R25.1
Output3_drain: J6.1, J10.18, J11.18, M8.2 (D), R87.1
RESET-: U101.6 (Y), U101.12 (B)
Reset_raw: U5.1 (OUT), U101.4 (A)
SCL: J9.7, R106.2, U26.5 (SCL)
SDA: J9.8, R107.2, U26.6 (SDA)
SNS_CH1: NT1.1, U11.4 (In-)
SNS_CH2: NT2.1, U12.4 (In-)
SNS_CH3: NT3.1, U6.4 (In-)
V_err: U4.4 (In-), U5.4 (In-), U28.3 (A)
Verr1: C13.2, R27.2, R28.2, U28.14 (A1)
Verr2: C11.2, R37.2, R38.2, U28.15 (A2)
Verr3: C10.2, R45.2, R46.2, U28.1 (A4)
VerrGT0: U101.1 (A), U102.5 (B), U102.9 (B), U103.2 (B), U104.10 (Y)
Vin: C40.1, C69.1, C79.1, C80.1, C81.1, C82.1, C83.1, C84.1, C85.1, D28.2 (+), D29.2 (+), D30.2 (+), J1.1, R1.1, U1.3 (IN), U16.1 (IN), U17.3 (IN)
Voltage_err_1: R3.1, R27.1, U3.1 (OUT)
Voltage_err_2: R32.1, R37.1, U7.1 (OUT)
Voltage_err_3: R40.1, R45.1, U13.1 (OUT)
Vout_1: C1.1, C70.1, C72.1, C86.1, C88.1, D28.1 (-), J3.1, J10.13, J11.13, M2.2 (D), R9.2
Vout_2: C3.1, C71.1, C73.1, C78.1, C87.1, D29.1 (-), J8.1, J10.15, J11.15, M3.2 (D), R35.2
Vout_3: C4.1, C74.1, C75.1, C76.1, C77.1, D30.1 (-), J5.1, J10.17, J11.17, M4.2 (D), R43.2
Vref_1: C103.1, R6.1, R101.2
Vref_1_arduino: J9.1, R101.1
Vref_2: C93.1, R33.1, R100.2
Vref_2_arduino: J9.2, R100.1
Vref_3: C47.1, R41.1, R77.2
Vref_3_arduino: J9.3, R77.1
analog_5V: C20.1, C21.1, C32.1, C33.1, C34.1, C35.1, C36.2, C37.2, C38.2, C55.1, C56.1, C63.1, C66.1, J10.22, J11.22, R44.1, R91.1, R96.1, U1.1 (OUT), U3.5 (V+), U6.5 (V+), U7.5 (V+), U11.5 (V+), U12.5 (V+), U13.5 (V+), U22.5 (V+), U23.5 (V+), U24.5 (V+), U25.6 (V+)
ena_out_1: J10.5, J11.5, U15.2 (INB), U102.2 (B), U105.2 (Y)
ena_out_2: J10.7, J11.7, U10.2 (INB), U102.12 (B), U104.12 (Y)
ena_out_3: J10.9, J11.9, U8.2 (INB), U103.4 (A), U105.4 (Y)
low_error_timeout: D6.1 (-), R67.1, R71.2, U14.1 (OUT), U18.14 (CLK)
m2_source: C18.2, C51.2, M2.3 (S), M7.3 (S), R75.1, R76.1, U15.9 (VSSB), U15.14 (VSSA)
m3_source: C16.2, C50.2, M3.3 (S), M6.3 (S), R49.2, R61.1, U10.9 (VSSB), U10.14 (VSSA)
m4_source: C60.2, C61.2, M4.3 (S), M5.3 (S), R73.1, R74.1, U8.9 (VSSB), U8.14 (VSSA)
out_2_on: J10.6, J11.6, U10.1 (INA), U104.6 (Y)
out_3_on: J10.8, J11.8, U8.1 (INA), U104.8 (Y)
rsense_lo: L1.2, R1.4
set-: D6.2 (+), R4.1, U101.10 (A)

Notes on the sheet:
M1 INHIBIT
CH1 LED CURRENT LIMIT
OUTPUT 1
disables m1 if there is 0 error on the current channel
goes to gate driver
U26B: one of the 4 pots inside U26 (MCP4451)
OUTPUT 2
U26A: one of the 4 pots inside U26 (MCP4451)
switch used so that circuit only samples while the led is on
0-5V PWM to set minimum voltage reference This will be connected to an arduino pin
U26C: one of the 4 pots inside U26 (MCP4451)
current sense amplifies R1 voltage by 100x
spare units (not used)
this pushes up the reference voltage if the output voltage is undershooting for a long time
gate driver
LOW-ERROR TIMEOUT
0-5V PWM signal sent from arduino to control brightness
CH2 LED CURRENT LIMIT
Channel 2 output-voltage error amplifier, Vout_2 -> Verr2
when m1 pulls inductor to ground, current can conduct through the mosfet body diode to charge up this capacitor
logic chip supply pins
OUTPUT 3
Signal that can be sent from the arduino to disable the circuit
CH3 HEADROOM SERVO
same as channel 1
op amp will try to make its output match the reference current
M1 ON/OFF LATCH
rc circuit delays m1 turn on diode creates fast turn off
inhibits m1 if 12V rail is below 9.8V
low side switch
mosfet used as a kind of variable resistor to keep led current from going too high.
1 mOhm shunt: measures inductor current
I2C pull-ups (U26 has none)
CH1 HEADROOM SERVO
bootstrap capacitors
connects LX to output 3
clamps LX spikes
CH3 LED CURRENT LIMIT
filters the PWM to DC
CH2 HEADROOM SERVO
I added a lot of capacitors for individual components in the kicad, which are all put here
CONNECTORS
U26E: MCP4451 control unit, serves U26A/B/C
digital potentiometer to control current
D28-D30: pre-charge diodes Vin -> Vout_1/2/3
connects LX to output 2
Channel 1 output-voltage error amplifier, Vout_1 -> Verr1
SEQUENCER / ERROR SELECT
error signal - used to control how long the inductor charges up for
actual led diode will not be on the pcb
Channel 3 output-voltage error amplifier, Vout_3 -> Verr3
CHANNEL ENABLE
makes it so that if there is one channel with low error, it doesn't just stop on that one channel.
connects LX to output 1
