ChristopherCa55/led-driver/BOOST_split_boards/ltspice_layout_2026-10-05/work/BOOST_revised_v7.kicad_sch

## KiCad design BOOST_split_boards/ltspice_layout_2026-10-05/work/BOOST_revised_v7.kicad_sch (2026-10-14)

Schematic: BOOST_revised_v7.kicad_sch

Parts:
C1, C4, C73: 4.7µ
C3, C12, C20, C22, C23, C24, C26, C28, C29, C32, C33, C34, C35, C36, C37, C38, C42, C43, C46, C48, C49, C50, C51, C52, C53, C54, C58, C59, C61, C63, C64, C65, C66, C67, C68, C72, C76, C82, C83, C84, C90, C92, C94, C95, C96, C97, C98, C99, C104: 100n
C6, C21, C25, C31, C57, C62, C89, C91: 1µ
C7, C55: 22µ
C8, C9, C17, C19: 330p
C10, C11, C13: 4.7n
C14: 220p
C15: 100p
C16, C18, C60: 2.2µ
C30: 47µ
C39, C47, C56, C79, C80, C81, C93, C103: 10µ
C40, C69, C85: 680µ
C41, C44, C45, C100, C101, C102: 1n
C70, C71, C74, C75, C77, C78, C86, C87, C88: 220µ
D1, D2, D3, D4, D5, D6, D7, D8, D9, D10, D11, D13, D14, D15, D20, D21, D22, D23, D24, D25, D26, D27: D
D19: TVS_5p0SMDJ54A
D28, D29, D30: S2MW
H1, H2, H3, H4, H5, H6, H7, H8: MountingHole_M3; MountingHole_3.2mm_M3
J9: Conn_01x11; WirePads_11_Staggered_P1.27mm_Drill1.0mm_TieSlots
J10: Conn_02x15_2.54mm; PinSocket_2x15_P2.54mm_Vertical; MPN ESQ-115-44-G-D
J11: Conn_02x15_2.54mm; PinHeader_2x15_P2.54mm_Vertical; MPN TSW-115-07-G-D
L1: 6.8µ
M1, M2, M3, M4, M5, M6, M7: HYG180N10
M8, M9, M10: HYG180N10_NOLEADS
Q1: PNP
R1: CSS4J_4026
R2, R6, R31, R33, R39, R41, R49, R61, R62, R67, R73, R74, R75, R76, R77, R83, R85, R99, R100, R101, R102, R103, R104: 10k
R3, R32, R40: 620k
R4, R54, R55, R58, R71: 1k
R7, R52, R53: .05
R8, R34, R42, R51, R63, R78, R80: 2k
R9, R35, R43: 18k
R11, R17: 510k
R13, R23, R26, R47, R64, R79, R81: 220
R15: 10
R16, R19: 5.1k
R18, R20: 200k
R21, R48, R59, R60, R70, R72: 5.1
R22, R50, R56: 100
R25, R87, R94: 910k
R27, R37, R45: 4.7k
R28, R36, R38, R44, R46, R88, R91, R95, R96, R105: 100k
R29, R30, R57, R65: 22k
R66, R89, R92, R97: 3.3k
R68: 62k
R69: 20k
R82: 56k
R84: 120k
R86: 1Meg
R90, R93, R98: 10Meg
SIM_ARD_INH: 0
SIM_BATTERY: 14
SIM_CABLE_INDUCTANCE: 0.8µ
SIM_CABLE_RESISTANCE: 0.012
SIM_IREF1: PULSE({if(IREF1_DUTY>=256,5,0)} {if(IREF1_DUTY<=0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
SIM_IREF2: PULSE({if(IREF2_DUTY>=256,5,0)} {if(IREF2_DUTY<=0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
SIM_IREF3: PULSE({if(IREF3_DUTY>=256,5,0)} {if(IREF3_DUTY<=0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
SIM_LED1: 100W_LED_RED
SIM_LED2: 100W_LED_GREEN
SIM_LED3: 100W_LED_BLUE
SIM_VREF1: PULSE(0 5 0 1n 1n 816u 2.04m)
SIM_VREF2, SIM_VREF3: PULSE(0 5 0 1n 1n 1.224m 2.04m)
U1, U17: L78L05
U2, U4, U5, U14, U21: MCP6561
U3, U6, U7, U11, U12, U13, U22, U23, U24: TLV9001
U8, U10, U15, U19: UCC21520
U16: MC7812_TYP
U18: CD4017B
U25: INA241A4
U26A, U26B, U26C: MCP4451_POT
U26E: MCP4451_CTRL
U28: 74HC4051
U101A, U101C, U101D: (no value)
U101B, U102A, U102B, U102C, U102D, U103A, U103B: Vhigh=5 Vlow=0 Vt=2.5 Td=2.6n Trise=8.75n Tfall=8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
U104A, U104B, U104C, U104D, U104E, U104F, U105A, U105B: Vhigh=5 Vlow=0 Vt=2.098 Vh=0.535 Td=7.6n Trise=8.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
U106A, U106B, U106C: CD74HC4066

Connections:
0: C1.2, C3.2, C4.2, C6.2, C7.2, C8.1, C9.1, C10.1, C11.1, C12.2, C13.1, C14.2, C15.2, C17.1, C19.2, C20.2, C21.2, C22.2, C23.2, C24.2, C25.2, C26.2, C28.2, C29.2, C30.2, C31.2, C32.2, C33.2, C34.2, C35.2, C36.1, C37.1, C38.1, C39.2, C40.2, C41.2, C42.2, C43.2, C44.2, C45.2, C46.2, C47.2, C48.2, C52.2, C53.1, C54.2, C55.2, C56.2, C57.1, C58.2, C59.2, C62.1, C63.2, C65.2, C66.2, C68.2, C69.2, C70.2, C71.2, C72.2, C73.2, C74.2, C75.2, C76.2, C77.2, C78.2, C79.2, C80.2, C81.2, C82.2, C83.2, C84.2, C85.2, C86.2, C87.2, C88.2, C89.1, C90.2, C91.1, C92.2, C93.2, C94.2, C95.2, C96.2, C97.2, C98.2, C99.2, C100.2, C101.2, C102.2, C103.2, C104.2, D19.1 (+), M1.3 (S), Q1.1 (C), R7.2, R8.2, R16.2, R19.2, R28.1, R34.2, R36.2, R38.1, R42.2, R46.1, R52.2, R53.2, R54.2, R55.2, R58.2, R62.1, R68.2, R83.2, R85.2, R88.2, R89.2, R92.2, R95.2, R97.2, R99.2, R102.2, R104.2, R105.2, SIM_ARD_INH.2 (-), SIM_BATTERY.2 (-), SIM_IREF1.2 (-), SIM_IREF2.2 (-), SIM_IREF3.2 (-), SIM_VREF1.2 (-), SIM_VREF2.2 (-), SIM_VREF3.2 (-), U1.3 (GND), U2.4 (V-), U3.4 (V-), U4.4 (V-), U5.4 (V-), U6.4 (V-), U7.4 (V-), U8.4 (GND), U8.5 (DIS), U10.4 (GND), U10.5 (DIS), U11.4 (V-), U12.4 (V-), U13.4 (V-), U14.4 (V-), U15.4 (GND), U15.5 (DIS), U16.3 (GND), U17.3 (GND), U19.2 (INB), U19.4 (GND), U19.5 (DIS), U19.9 (VSSA), U19.12 (VSSB), U21.4 (V-), U22.4 (V-), U23.4 (V-), U24.4 (V-), U25.4 (GND), U25.5 (REF1), U25.6 (REF2), U26A.1 (A), U26B.1 (A), U26C.1 (A), U26E.2 (VSS), U28.2 (IO6), U28.4 (IO7), U28.5 (IO5), U28.6 (INH), U28.7 (VEE), U28.8 (VSS), U28.12 (IO0), U28.13 (IO3), U104A.3 (com), U104B.3 (com), U104C.3 (com), U104D.3 (com), U104E.3 (com), U104F.3 (com), U105A.3 (com), U105B.3 (com), U106A.5 (VSS), U106B.5 (VSS), U106C.5 (VSS)
0A_hi: R11.1, U2.5 (OUT), U101A.4 (d)
0err_hi: D1.1 (+), D3.2 (-), R18.1, R66.1, U4.5 (OUT), U104E.1 (in)
4: U18.1 (MR), U18.7 (Q3)
5: U18.8 (Q4)
5V: C7.1, C12.1, C22.1, C23.1, C24.1, C26.1, C28.1, C29.1, C39.1, C48.1, C52.1, C53.2, C54.1, C57.2, C58.1, C62.2, C89.2, C90.1, C91.2, C92.1, C94.1, C95.1, C96.1, C97.1, C98.1, C99.1, C104.1, J10.10, J11.10, R17.2, R20.2, R69.2, R82.1, R103.1, U2.3 (V+), U4.3 (V+), U5.3 (V+), U8.3 (VCCI), U8.6 (DT), U10.3 (VCCI), U10.6 (DT), U14.3 (V+), U15.3 (VCCI), U15.6 (DT), U17.2 (OUT), U19.3 (VCCI), U19.6 (DT), U21.3 (V+), U26E.1 (VDD), U28.9 (VDD), U106A.4 (VDD), U106B.4 (VDD), U106C.4 (VDD)
6: U18.9 (Q5)
7: U18.10 (Q6)
8: U18.11 (Q7)
9: U18.12 (Q8)
10: U18.13 (Q9)
12V: C6.1, C25.1, C30.1, C31.1, D9.1 (+), D10.1 (+), D21.1 (+), J9.9, J10.19, J11.19, R84.1, U16.2 (OUT), U19.7 (VDDA), U19.10 (VDDB)
.1Vout_1: R2.2, R8.1, R9.1
.1Vout_2: R31.2, R34.1, R35.1
.1Vout_3: R39.2, R42.1, R43.1
.1Vref_1: C46.1, D26.2 (-), R6.2, U3.1 (In+)
.1Vref_2: C43.1, D25.2 (-), R33.2, U7.1 (In+)
.1Vref_3: C42.1, D23.2 (-), R41.2, U13.1 (In+)
ARD_M1_INHIBIT: D27.1 (+), J9.11, R105.1, SIM_ARD_INH.1 (+)
Current: J10.23, J11.23, U2.2 (In-), U5.1 (In+), U25.7 (OUT)
GATE_M1: M1.2 (G), R15.2, R104.1
GATE_M2: D11.1 (+), M2.2 (G), R13.1, R75.2
GATE_M3: D14.1 (+), M3.2 (G), R23.2, R61.2
GATE_M4: D13.1 (+), M4.2 (G), R47.1, R73.2
GATE_M5: D22.1 (+), M5.2 (G), R59.1, R74.1
GATE_M6: D8.1 (+), M6.2 (G), R49.1, R70.2
GATE_M7: D2.1 (+), M7.2 (G), R60.2, R76.2
GND: J9.10, J10.1, J10.2, J10.11, J10.12, J10.20, J10.21, J10.24, J10.25, J10.28, J10.29, J11.1, J11.2, J11.11, J11.12, J11.20, J11.21, J11.24, J11.25, J11.28, J11.29
IREF1: J9.4, R29.2, SIM_IREF1.1 (+), U106C.3 (CTRL)
IREF1_input: C45.1, J10.26, J11.26, U11.1 (In+), U26A.2 (W)
IREF2: J9.5, R30.2, SIM_IREF2.1 (+), U106B.3 (CTRL)
IREF2_input: C44.1, J10.27, J11.27, U12.1 (In+), U26B.2 (W)
IREF3: J9.6, R57.2, SIM_IREF3.1 (+), U106A.3 (CTRL)
IREF3_input: C41.1, J10.30, J11.30, U6.1 (In+), U26C.2 (W)
ISNS_N: R1.3 (S2), U25.2 (IN-)
ISNS_P: R1.2 (S1), U25.1 (IN+)
LX: D19.2 (-), L1.1, M1.1 (D), M6.1 (D)
M1_INHIBIT: D1.2 (-), D15.2 (-), D24.2 (-), D27.2 (-), R26.1, U104A.1 (in)
M1_ON: J10.3, J11.3, U19.1 (INA), U101B.4 (d), U104A.2 (_Q)
M2_ON: J10.4, J11.4, U15.1 (INA), U104B.2 (_Q)
unnamed: C8.2, R63.1, R64.1
unnamed: C9.2, R78.1, R79.1
unnamed: C14.1, Q1.3 (E), R66.2, U14.2 (In-)
unnamed: C15.1, D4.2 (-), R71.1
unnamed: C16.1, C50.1, R48.2, U10.7 (VDDA), U10.10 (VDDB)
unnamed: C17.2, R80.1, R81.1
unnamed: C18.1, C51.1, R21.2, U15.7 (VDDA), U15.10 (VDDB)
unnamed: C19.1, R26.2, R51.2
unnamed: C49.1, R90.1, U22.2 (In-), U106A.2 (B)
unnamed: C59.1, R44.2, R89.1, U22.1 (In+)
unnamed: C60.1, C61.1, R72.2, U8.7 (VDDA), U8.10 (VDDB)
unnamed: C64.1, R93.1, U23.2 (In-), U106B.2 (B)
unnamed: C65.1, R91.2, R92.1, U23.1 (In+)
unnamed: C67.1, R98.1, U24.2 (In-), U106C.2 (B)
unnamed: C68.1, R96.2, R97.1, U24.1 (In+)
unnamed: C100.1, R29.1, R54.1, U26A.3 (B)
unnamed: C101.1, R30.1, R55.1, U26B.3 (B)
unnamed: C102.1, R57.1, R58.1, U26C.3 (B)
unnamed: D2.2 (-), R60.1, U15.11 (VOUTB)
unnamed: D3.1 (+), R65.2
unnamed: D4.1 (+), Q1.2 (B), R65.1
unnamed: D5.1 (+), R63.2, U103A.6 (_Q)
unnamed: D5.2 (-), R64.2, U105B.1 (in)
unnamed: D7.1 (+), R78.2, U102C.6 (_Q)
unnamed: D7.2 (-), R79.2, U104F.1 (in)
unnamed: D8.2 (-), R70.1, U10.11 (VOUTB)
unnamed: D9.2 (-), R48.1
unnamed: D10.2 (-), R21.1
unnamed: D11.2 (-), R13.2, U15.8 (VOUTA)
unnamed: D13.2 (-), R47.2, U8.8 (VOUTA)
unnamed: D14.2 (-), R23.1, U10.8 (VOUTA)
unnamed: D20.1 (+), R80.2, U102B.6 (_Q)
unnamed: D20.2 (-), R81.2, U105A.1 (in)
unnamed: D21.2 (-), R72.1
unnamed: D22.2 (-), R59.2, U8.11 (VOUTB)
unnamed: D24.1 (+), R86.1, U21.5 (OUT)
unnamed: M5.1 (D), M7.1 (D)
unnamed: M8.2 (G), R22.1
unnamed: M9.2 (G), R50.1
unnamed: M10.2 (G), R56.1
unnamed: R2.1, R3.2, U3.2 (In-)
unnamed: R4.2, U101A.6 (_Q)
unnamed: R11.2, R16.1, R17.1, U2.1 (In+)
unnamed: R15.1, U19.8 (VOUTA)
unnamed: R18.2, R19.1, R20.1, U4.1 (In+)
unnamed: R22.2, U6.5 (OUT)
unnamed: R25.2, R36.1, U106B.1 (A)
unnamed: R31.1, R32.2, U7.2 (In-)
unnamed: R39.1, R40.2, U13.2 (In-)
unnamed: R50.2, U12.5 (OUT)
unnamed: R56.2, U11.5 (OUT)
unnamed: R62.2, U19.11 (VOUTB)
unnamed: R67.2, R68.1, R69.1, U14.1 (In+)
unnamed: R82.2, R85.1, R86.2, U21.1 (In+)
unnamed: R83.1, R84.2, U21.2 (In-)
unnamed: R87.2, R88.1, U106A.1 (A)
unnamed: R94.2, R95.1, U106C.1 (A)
unnamed: R99.1, U26E.6 (A1)
unnamed: R102.1, U26E.5 (HVC/A0)
unnamed: R103.2, U26E.7 (RESET)
unnamed: SIM_CABLE_INDUCTANCE.2, SIM_CABLE_RESISTANCE.1
unnamed: U102A.6 (_Q), U104B.1 (in)
unnamed: U102D.6 (_Q), U104C.1 (in)
unnamed: U103B.6 (_Q), U104D.1 (in)
OUT_1_ENA: U18.4 (Q0), U28.14 (A), U102B.2 (b)
OUT_2_ENA: U18.5 (Q1), U28.15 (B), U102C.2 (b)
OUT_3_ENA: U18.6 (Q2), U28.16 (C), U103A.2 (b)
Out: U101C.6 (_Q), U101D.2 (b)
Out-: D15.1 (+), R51.1, U18.2 (CPN), U101C.4 (d), U101D.6 (_Q), U102A.2 (b), U102D.2 (b), U103B.2 (b)
Output1_drain: J10.14, J11.14, M10.1 (D), R94.1, SIM_LED1.2 (-)
Output2_drain: J10.16, J11.16, M9.1 (D), R25.1, SIM_LED2.2 (-)
Output3_drain: J10.18, J11.18, M8.1 (D), R87.1, SIM_LED3.2 (-)
RESET-: U101B.6 (_Q), U101D.4 (d)
Reset_raw: U5.5 (OUT), U101B.2 (b)
SCL: J9.7, U26E.3 (SCL)
SDA: J9.8, U26E.4 (SDA)
SNS_CH1: M10.3 (S), R52.1, U11.2 (In-)
SNS_CH2: M9.3 (S), R53.1, U12.2 (In-)
SNS_CH3: M8.3 (S), R7.1, U6.2 (In-)
SRV1: C67.2, D26.1 (+), R98.2, U24.5 (OUT)
SRV2: C64.2, D25.1 (+), R93.2, U23.5 (OUT)
SRV3: C49.2, D23.1 (+), R90.2, U22.5 (OUT)
V_err: U4.2 (In-), U5.2 (In-), U28.3 (IOC)
Vbattery: SIM_BATTERY.1 (+), SIM_CABLE_RESISTANCE.2
Verr1: C13.2, R27.2, R28.2, U28.11 (IO1)
Verr2: C11.2, R37.2, R38.2, U28.10 (IO2)
Verr3: C10.2, R45.2, R46.2, U28.1 (IO4)
VerrGT0: U101A.2 (b), U102B.4 (d), U102C.4 (d), U103A.4 (d), U104E.2 (_Q)
Vin: C40.1, C69.1, C79.1, C80.1, C81.1, C82.1, C83.1, C84.1, C85.1, D28.1 (+), D29.1 (+), D30.1 (+), R1.1 (F1), SIM_CABLE_INDUCTANCE.1, U1.1 (IN), U16.1 (IN), U17.1 (IN)
Voltage_err_1: R3.1, R27.1, U3.5 (OUT)
Voltage_err_2: R32.1, R37.1, U7.5 (OUT)
Voltage_err_3: R40.1, R45.1, U13.5 (OUT)
Vout_1: C1.1, C70.1, C72.1, C86.1, C88.1, D28.2 (-), J10.13, J11.13, M2.1 (D), R9.2, SIM_LED1.1 (+)
Vout_2: C3.1, C71.1, C73.1, C78.1, C87.1, D29.2 (-), J10.15, J11.15, M3.1 (D), R35.2, SIM_LED2.1 (+)
Vout_3: C4.1, C74.1, C75.1, C76.1, C77.1, D30.2 (-), J10.17, J11.17, M4.1 (D), R43.2, SIM_LED3.1 (+)
Vref_1: C103.1, R6.1, R101.2
Vref_1_arduino: J9.1, R101.1, SIM_VREF1.1 (+)
Vref_2: C93.1, R33.1, R100.2
Vref_2_arduino: J9.2, R100.1, SIM_VREF2.1 (+)
Vref_3: C47.1, R41.1, R77.2
Vref_3_arduino: J9.3, R77.1, SIM_VREF3.1 (+)
analog_5V: C20.1, C21.1, C32.1, C33.1, C34.1, C35.1, C36.2, C37.2, C38.2, C55.1, C56.1, C63.1, C66.1, J10.22, J11.22, R44.1, R91.1, R96.1, U1.2 (OUT), U3.3 (V+), U6.3 (V+), U7.3 (V+), U11.3 (V+), U12.3 (V+), U13.3 (V+), U22.3 (V+), U23.3 (V+), U24.3 (V+), U25.3 (VS)
ena_out_1: J10.5, J11.5, U15.2 (INB), U102A.4 (d), U105A.2 (_Q)
ena_out_2: J10.7, J11.7, U10.2 (INB), U102D.4 (d), U104F.2 (_Q)
ena_out_3: J10.9, J11.9, U8.2 (INB), U103B.4 (d), U105B.2 (_Q)
low_error_timeout: D6.2 (-), R67.1, R71.2, U14.5 (OUT), U18.3 (CP)
m2_source: C18.2, C51.2, M2.3 (S), M7.3 (S), R75.1, R76.1, U15.9 (VSSA), U15.12 (VSSB)
m3_source: C16.2, C50.2, M3.3 (S), M6.3 (S), R49.2, R61.1, U10.9 (VSSA), U10.12 (VSSB)
m4_source: C60.2, C61.2, M4.3 (S), M5.3 (S), R73.1, R74.2, U8.9 (VSSA), U8.12 (VSSB)
out_2_on: J10.6, J11.6, U10.1 (INA), U104C.2 (_Q)
out_3_on: J10.8, J11.8, U8.1 (INA), U104D.2 (_Q)
rsense_lo: L1.2, R1.4 (F2)
set-: D6.1 (+), R4.1, U101C.2 (b)

Notes on the sheet:
error signal - used to control how long the inductor charges up for
U26A: one of the 4 pots inside U26 (MCP4451)
M1 ON/OFF LATCH
D28-D30: pre-charge diodes Vin -> Vout_1/2/3
gate driver
0-5V PWM to set minimum voltage reference This will be connected to an arduino pin
bootstrap capacitors
I added a lot of capacitors for individual components in the kicad, which are all put here
when m1 pulls inductor to ground, current can conduct through the mosfet body diode to charge up this capacitor
current sense amplifies R1 voltage by 100x
actual led diode will not be on the pcb
digital potentiometer to control current
goes to gate driver
PWM duty = IREF1_DUTY/256 (.param)
LOW-ERROR TIMEOUT
Channel 2 output-voltage error amplifier, Vout_2 -> Verr2
PWM duty = IREF3_DUTY/256 (.param)
same as channel 1
Voltage Regulators
low side switch
U26E: MCP4451 control unit, serves U26A/B/C
inhibits m1 if 12V rail is below 9.8V
switch used so that circuit only samples while the led is on
U26C: one of the 4 pots inside U26 (MCP4451)
CONNECTORS
clamps LX spikes
1 mOhm shunt: measures inductor current
simulation only - not on the PCB
connects LX to output 2
this pushes up the reference voltage if the output voltage is undershooting for a long time
OUTPUT 3
rc circuit delays m1 turn on diode creates fast turn off
Channel 1 output-voltage error amplifier, Vout_1 -> Verr1
CH1 HEADROOM SERVO
OUTPUT 1
op amp will try to make its output match the reference current
CH2 HEADROOM SERVO
CH3 LED CURRENT LIMIT
filters the PWM to DC
OUTPUT 2
makes it so that if there is one channel with low error, it doesn't just stop on that one channel.
CH1 LED CURRENT LIMIT
mosfet used as a kind of variable resistor to keep led current from going too high.
U26B: one of the 4 pots inside U26 (MCP4451)
disables m1 if there is 0 error on the current channel
connects LX to output 1
connects LX to output 3
Channel 3 output-voltage error amplifier, Vout_3 -> Verr3
CH3 HEADROOM SERVO
PWM duty = IREF2_DUTY/256 (.param)
Signal that can be sent from the arduino to disable the circuit
CH2 LED CURRENT LIMIT
simulation only - not on the PCB 0-5V PWM signal sent from arduino to control brightness
SEQUENCER / ERROR SELECT
CHANNEL ENABLE
M1 INHIBIT
