ChristopherCa55/led-driver/BOOST_split_boards/reorg_2026-10-05/work/k2/BOOST_control_RC2.kicad_sch

## KiCad design BOOST_split_boards/reorg_2026-10-05/work/k2/BOOST_control_RC2.kicad_sch (2026-10-14)

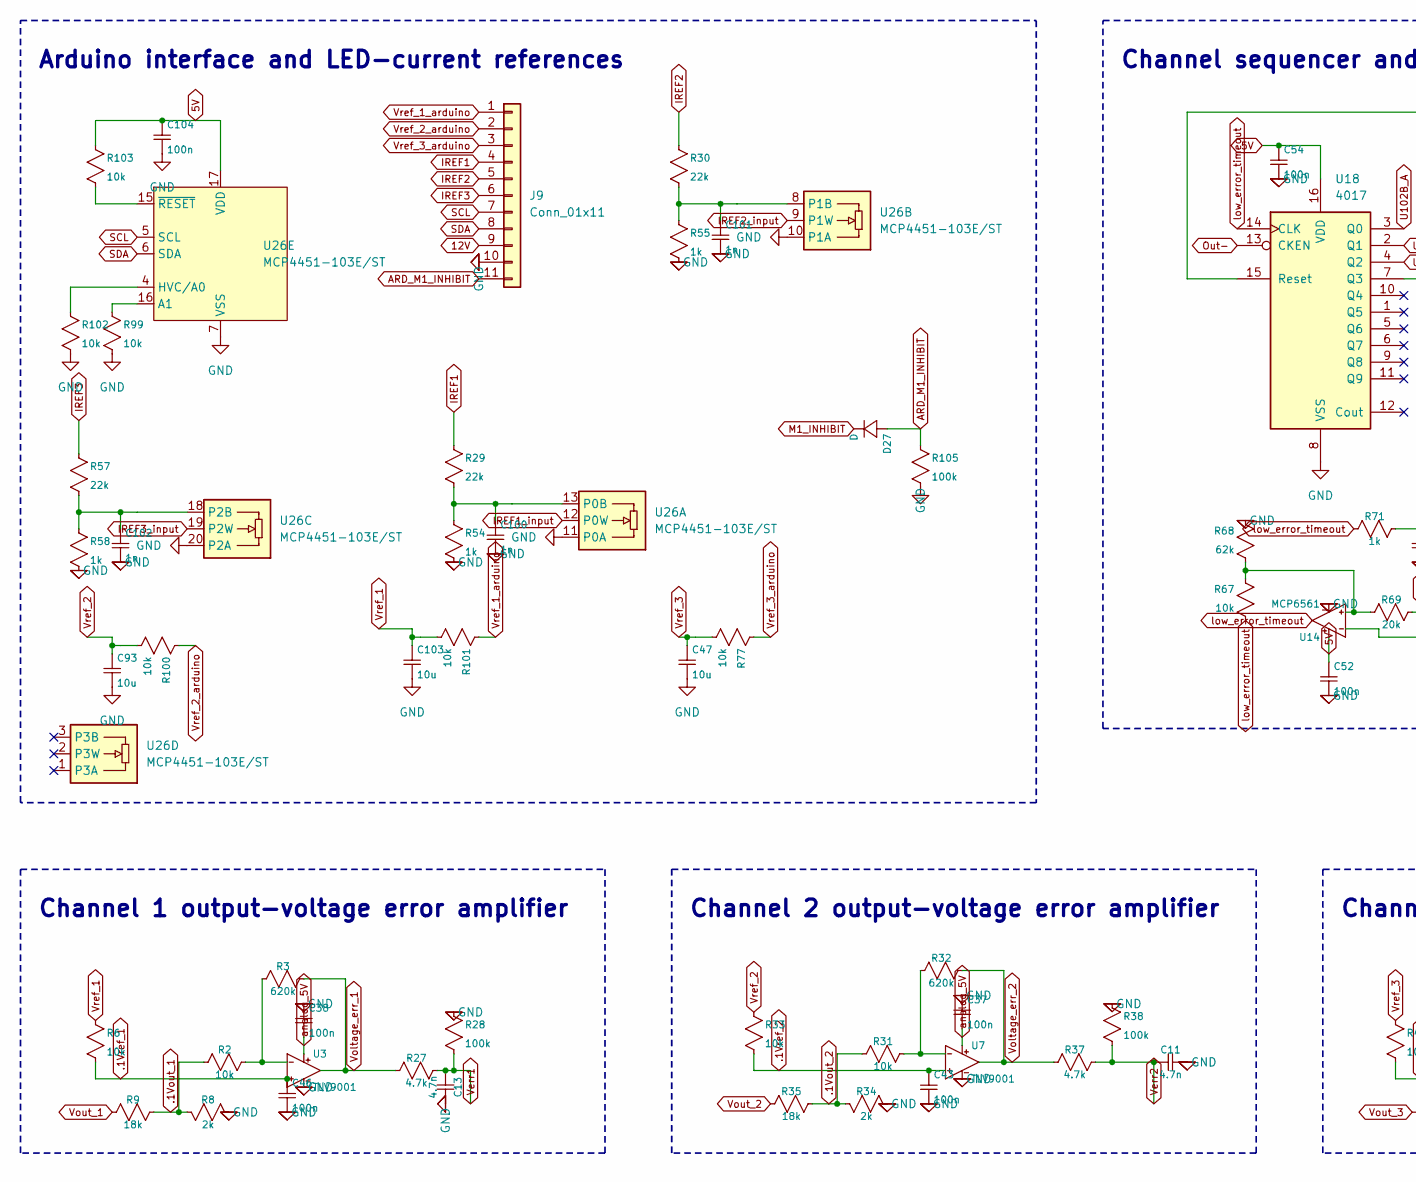
[picture p286: schematic BOOST_control_RC2.kicad_sch, part in row 1, column 1]

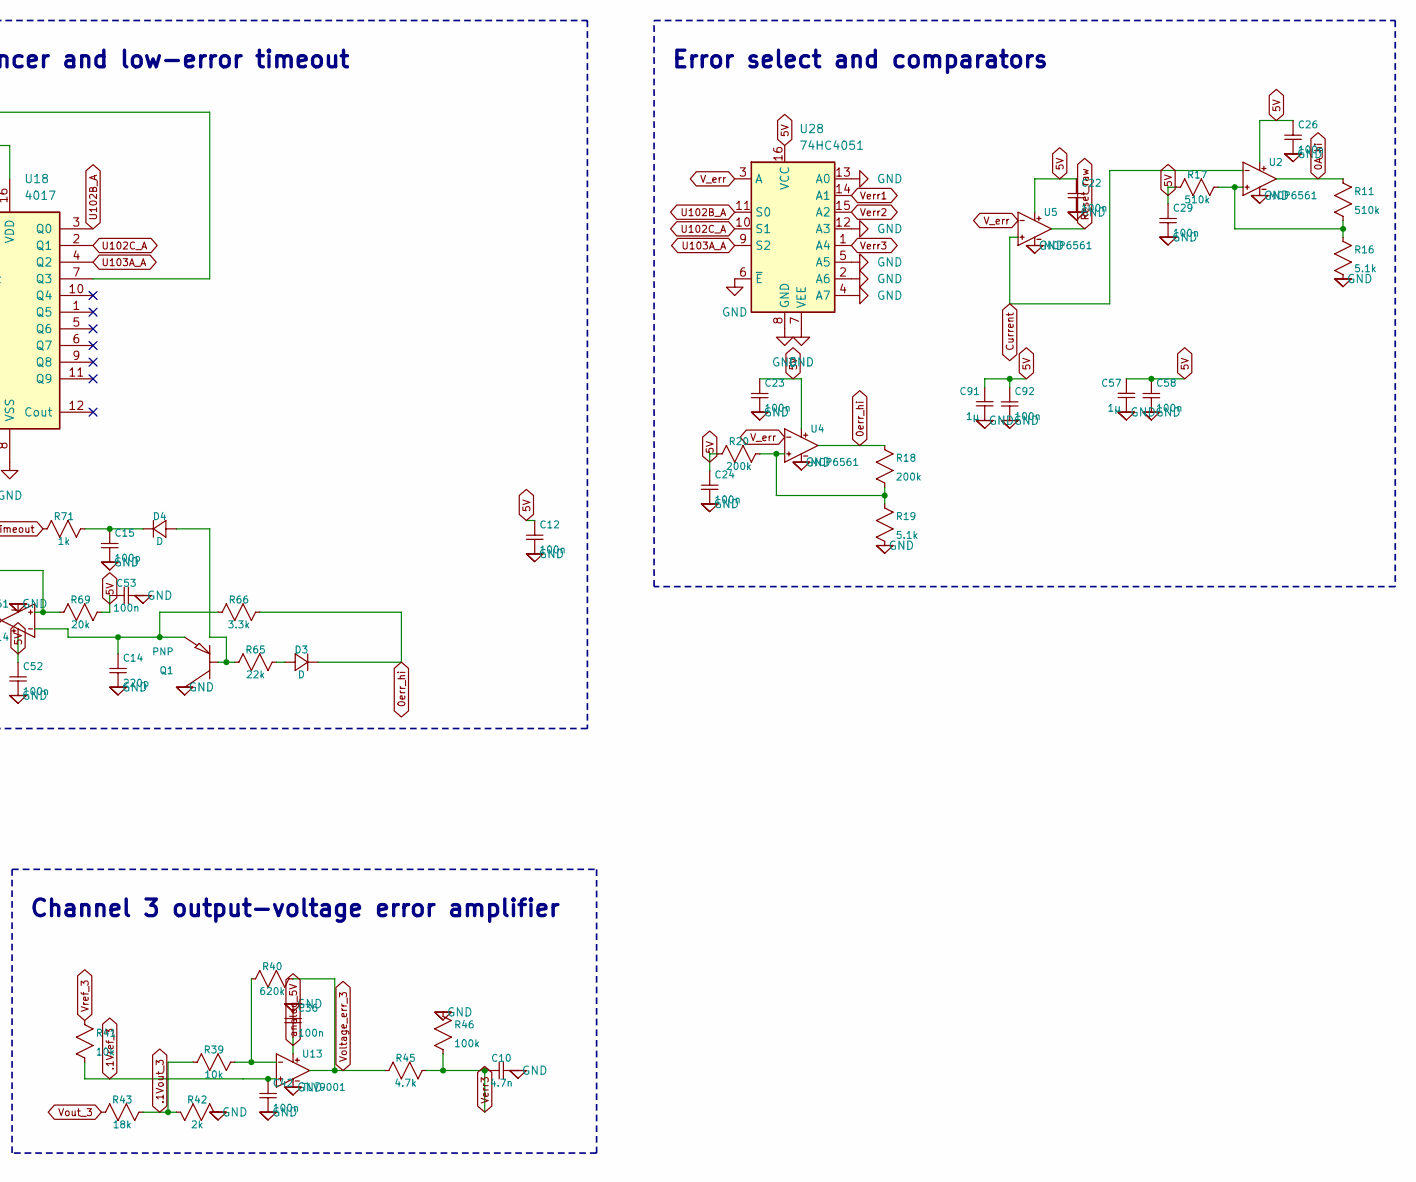
[picture p287: schematic BOOST_control_RC2.kicad_sch, part in row 1, column 2]

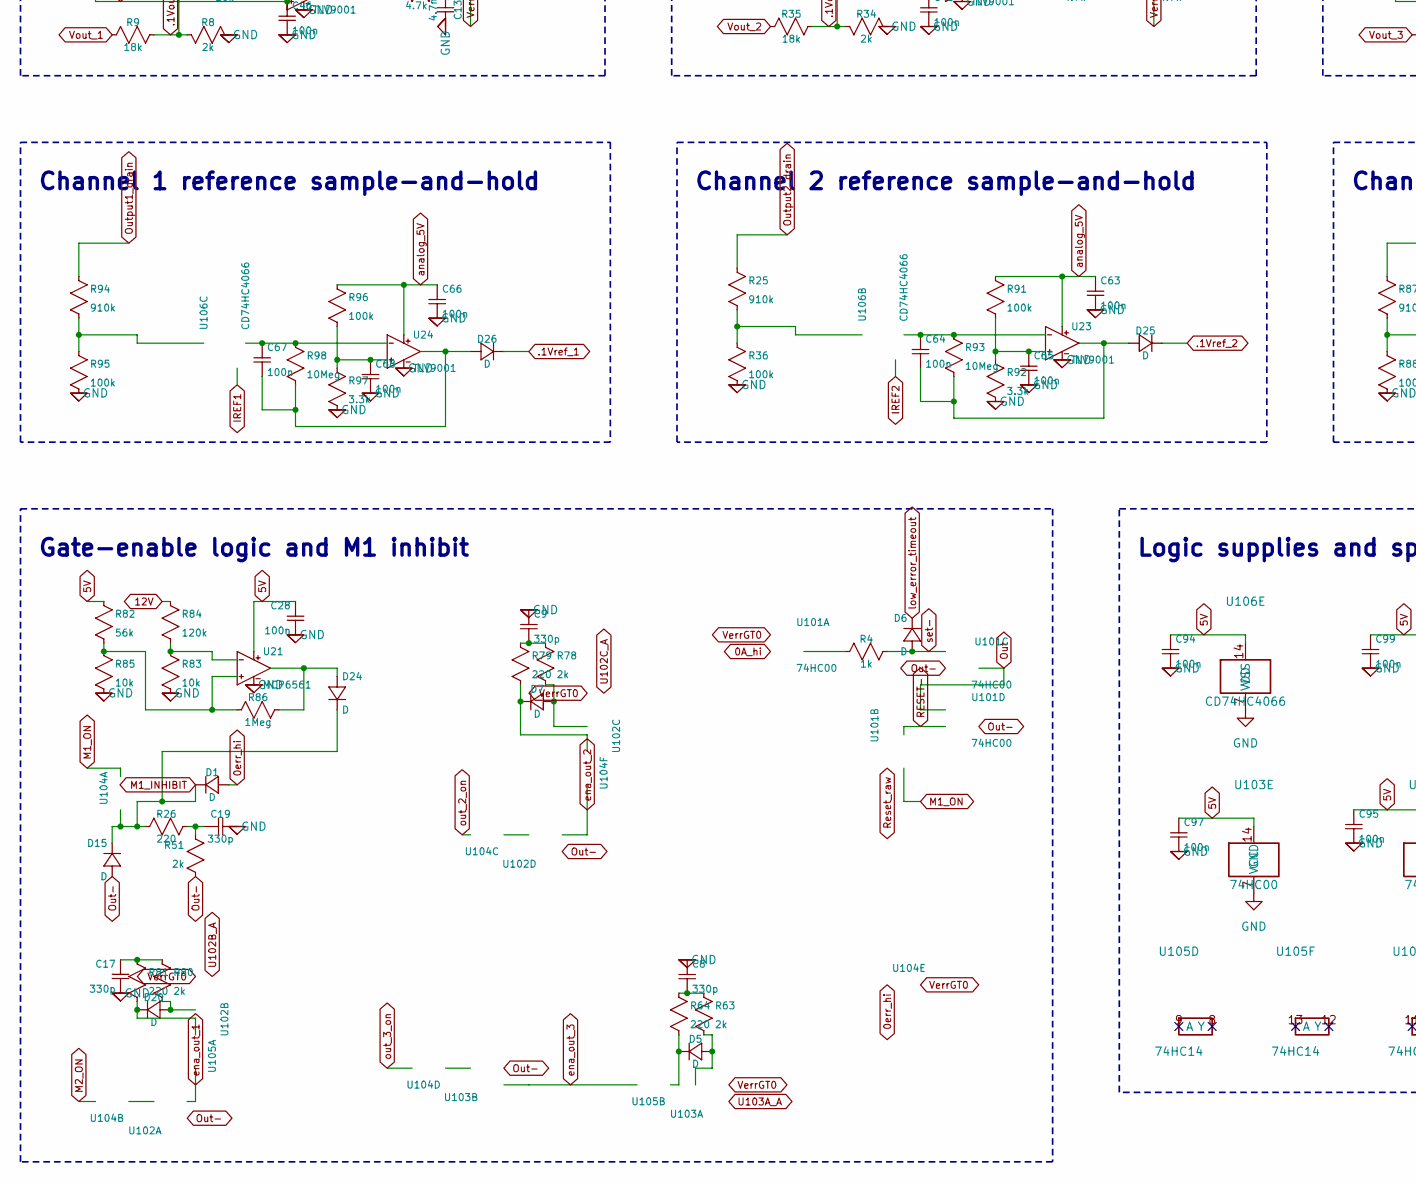
[picture p288: schematic BOOST_control_RC2.kicad_sch, part in row 2, column 1]

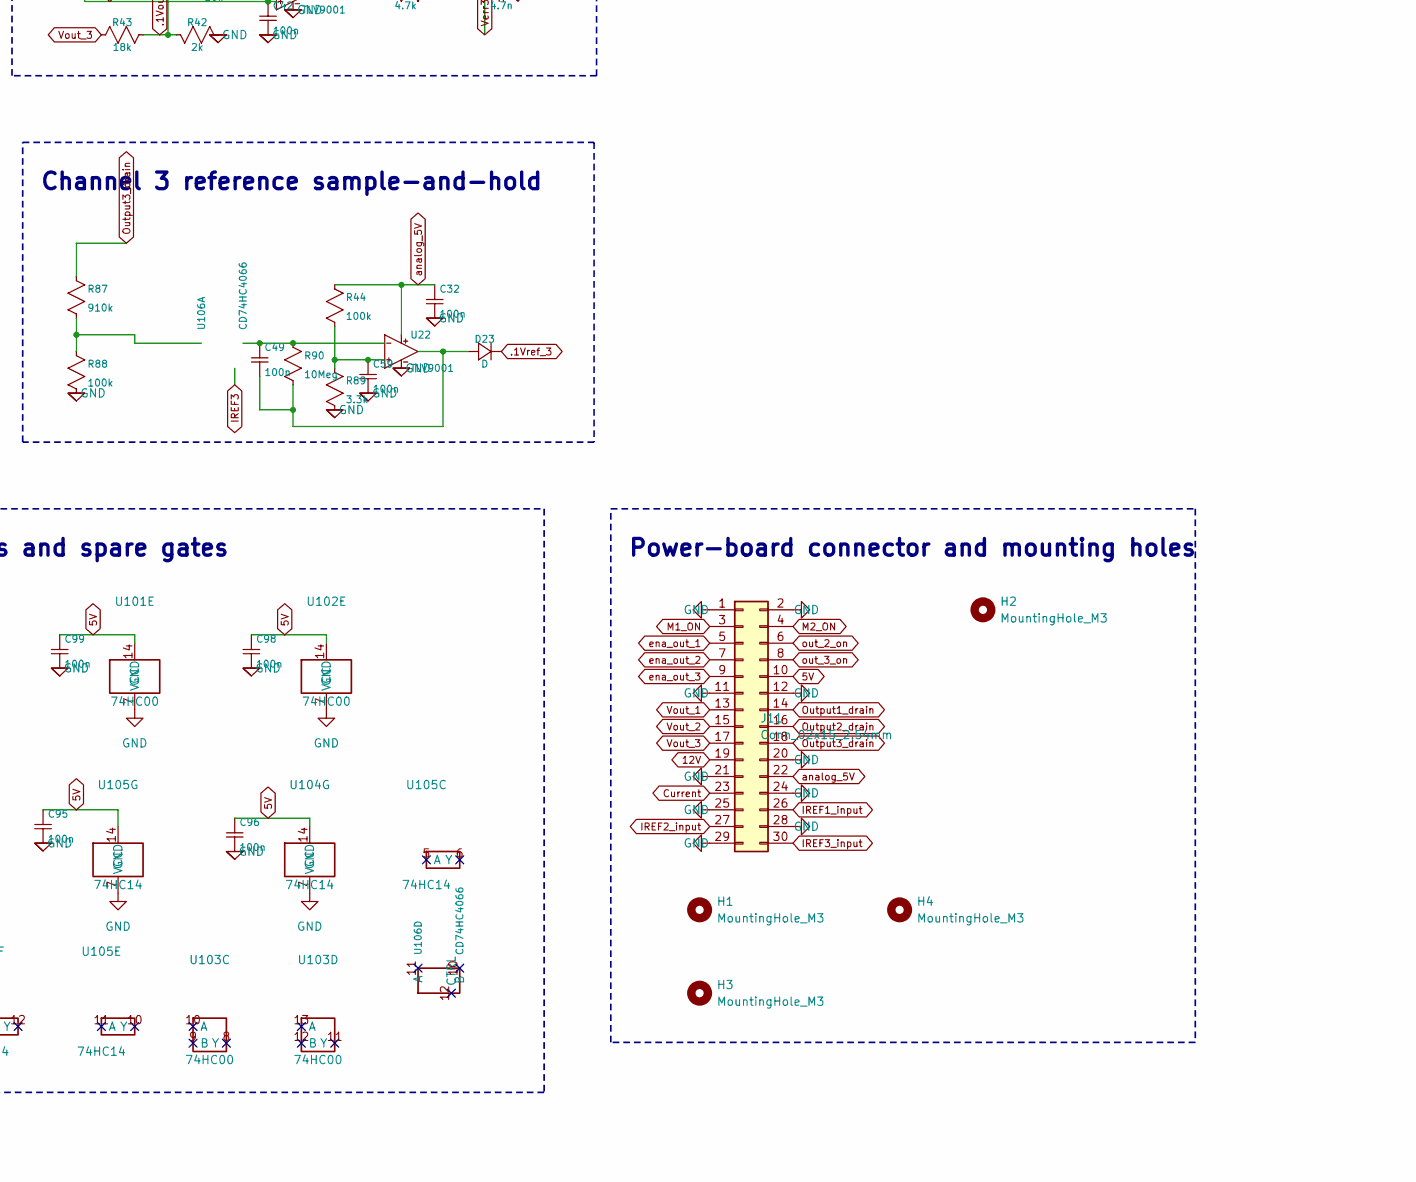
[picture p289: schematic BOOST_control_RC2.kicad_sch, part in row 2, column 2]

Parts:
C8, C9, C17, C19: 330p; C_0603_1608Metric
C10, C11, C13: 4.7n; C_0603_1608Metric
C12, C22, C23, C24, C26, C28, C29, C32, C36, C37, C38, C42, C43, C46, C52, C53, C54, C58, C59, C63, C65, C66, C68, C92, C94, C95, C96, C97, C98, C99, C104: 100n; C_0603_1608Metric
C14: 220p; C_0603_1608Metric
C15: 100p; C_0603_1608Metric
C47, C93, C103: 10u; C_0603_1608Metric
C49, C64, C67: 100n; C_1206_3216Metric
C57, C91: 1µ; C_0805_2012Metric
C100, C101, C102: 1n; C_0603_1608Metric
D1, D3, D4, D5, D6, D7, D15, D20, D24, D27: D; D_SOD-123
D23, D25, D26: D; D_SOD-323
H1, H2, H3, H4: MountingHole_M3; MountingHole_3.2mm_M3
J9: Conn_01x11; WirePads_11_Staggered_P1.27mm_Drill1.0mm_TieSlots
J11: Conn_02x15_2.54mm; PinHeader_2x15_P2.54mm_Vertical; MPN TSW-115-07-G-D
Q1: PNP; SOT-23
R2, R6, R31, R33, R39, R41, R67, R77, R83, R85, R99, R100, R101, R102, R103: 10k; R_0603_1608Metric
R3, R32, R40: 620k; R_0603_1608Metric
R4, R54, R55, R58, R71: 1k; R_0603_1608Metric
R8, R34, R42, R51, R63, R78, R80: 2k; R_0603_1608Metric
R9, R35, R43: 18k; R_0805_2012Metric
R11, R17: 510k; R_0603_1608Metric
R16, R19: 5.1k; R_0603_1608Metric
R18, R20: 200k; R_0603_1608Metric
R25, R87, R94: 910k; R_0805_2012Metric
R26, R64, R79, R81: 220; R_0603_1608Metric
R27, R37, R45: 4.7k; R_0603_1608Metric
R28, R36, R38, R44, R46, R88, R91, R95, R96, R105: 100k; R_0603_1608Metric
R29, R30, R57: 22k; R_0805_2012Metric
R65: 22k; R_0603_1608Metric
R66, R89, R92, R97: 3.3k; R_0603_1608Metric
R68: 62k; R_0603_1608Metric
R69: 20k; R_0603_1608Metric
R82: 56k; R_0603_1608Metric
R84: 120k; R_0603_1608Metric
R86: 1Meg; R_0805_2012Metric
R90, R93, R98: 10Meg; R_0603_1608Metric
U2, U4, U5, U14, U21: MCP6561; SOT-23-5
U3, U7, U13, U22, U23, U24: TLV9001; SOT-23-5; MPN TLV9001IDBVR
U18: 4017; SOIC-16_3.9x9.9mm_P1.27mm
U26: MCP4451-103E/ST; TSSOP-20_4.4x6.5mm_P0.65mm; MPN MCP4451-103E/ST; LCSC C145613
U28: 74HC4051; SOIC-16_3.9x9.9mm_P1.27mm
U101, U102, U103: 74HC00; SOIC-14_3.9x8.7mm_P1.27mm
U104, U105: 74HC14; SOIC-14_3.9x8.7mm_P1.27mm
U106: CD74HC4066; SOIC-14_3.9x8.7mm_P1.27mm

Connections:
0A_hi: R11.1, U2.1 (OUT), U101.2 (B)
0err_hi: D1.2 (+), D3.1 (-), R18.1, R66.1, U4.1 (OUT), U104.11 (A)
5V: C12.1, C22.1, C23.1, C24.1, C26.1, C28.1, C29.1, C52.1, C53.2, C54.1, C57.2, C58.1, C91.2, C92.1, C94.1, C95.1, C96.1, C97.1, C98.1, C99.1, C104.1, J11.10, R17.2, R20.2, R69.2, R82.1, R103.1, U2.5 (V+), U4.5 (V+), U5.5 (V+), U14.5 (V+), U18.16 (VDD), U21.5 (V+), U26.17 (VDD), U28.16 (VCC), U101.14 (VCC), U102.14 (VCC), U103.14 (VCC), U104.14 (VCC), U105.14 (VCC), U106.14 (VDD)
12V: J9.9, J11.19, R84.1
.1Vout_1: R2.2, R8.1, R9.1
.1Vout_2: R31.2, R34.1, R35.1
.1Vout_3: R39.2, R42.1, R43.1
.1Vref_1: C46.1, D26.1 (-), R6.2, U3.3 (In+)
.1Vref_2: C43.1, D25.1 (-), R33.2, U7.3 (In+)
.1Vref_3: C42.1, D23.1 (-), R41.2, U13.3 (In+)
ARD_M1_INHIBIT: D27.2 (+), J9.11, R105.1
Current: J11.23, U2.4 (In-), U5.3 (In+)
GND: C8.1, C9.1, C10.1, C11.1, C12.2, C13.1, C14.2, C15.2, C17.1, C19.2, C22.2, C23.2, C24.2, C26.2, C28.2, C29.2, C32.2, C36.1, C37.1, C38.1, C42.2, C43.2, C46.2, C47.2, C52.2, C53.1, C54.2, C57.1, C58.2, C59.2, C63.2, C65.2, C66.2, C68.2, C91.1, C92.2, C93.2, C94.2, C95.2, C96.2, C97.2, C98.2, C99.2, C100.2, C101.2, C102.2, C103.2, C104.2, J9.10, J11.1, J11.2, J11.11, J11.12, J11.20, J11.21, J11.24, J11.25, J11.28, J11.29, Q1.3 (C), R8.2, R16.2, R19.2, R28.1, R34.2, R36.2, R38.1, R42.2, R46.1, R54.2, R55.2, R58.2, R68.2, R83.2, R85.2, R88.2, R89.2, R92.2, R95.2, R97.2, R99.2, R102.2, R105.2, U2.2 (V-), U3.2 (V-), U4.2 (V-), U5.2 (V-), U7.2 (V-), U13.2 (V-), U14.2 (V-), U18.8 (VSS), U21.2 (V-), U22.2 (V-), U23.2 (V-), U24.2 (V-), U26.7 (VSS), U26.10 (P1A), U26.11 (P0A), U26.20 (P2A), U28.2 (A6), U28.4 (A7), U28.5 (A5), U28.6 (~E), U28.7 (VEE), U28.8 (GND), U28.12 (A3), U28.13 (A0), U101.7 (GND), U102.7 (GND), U103.7 (GND), U104.7 (GND), U105.7 (GND), U106.7 (VSS)
IREF1: J9.4, R29.1, U106.6 (CTRL)
IREF1_input: J11.26, U26.12 (P0W)
IREF2: J9.5, R30.1, U106.5 (CTRL)
IREF2_input: J11.27, U26.9 (P1W)
IREF3: J9.6, R57.1, U106.13 (CTRL)
IREF3_input: J11.30, U26.19 (P2W)
M1_INHIBIT: D1.1 (-), D15.1 (-), D24.1 (-), D27.1 (-), R26.1, U104.1 (A)
M1_ON: J11.3, U101.5 (B), U104.2 (Y)
M2_ON: J11.4, U104.4 (Y)
unnamed: C8.2, R63.1, R64.1
unnamed: C9.2, R78.1, R79.1
unnamed: C14.1, Q1.2 (E), R66.2, U14.4 (In-)
unnamed: C15.1, D4.1 (-), R71.1
unnamed: C17.2, R80.1, R81.1
unnamed: C19.1, R26.2, R51.2
unnamed: C49.1, R90.1, U22.4 (In-), U106.2 (B)
unnamed: C49.2, D23.2 (+), R90.2, U22.1 (OUT)
unnamed: C59.1, R44.2, R89.1, U22.3 (In+)
unnamed: C64.1, R93.1, U23.4 (In-), U106.4 (B)
unnamed: C64.2, D25.2 (+), R93.2, U23.1 (OUT)
unnamed: C65.1, R91.2, R92.1, U23.3 (In+)
unnamed: C67.1, R98.1, U24.4 (In-), U106.9 (B)
unnamed: C67.2, D26.2 (+), R98.2, U24.1 (OUT)
unnamed: C68.1, R96.2, R97.1, U24.3 (In+)
unnamed: C100.1, R29.2, R54.1, U26.13 (P0B)
unnamed: C101.1, R30.2, R55.1, U26.8 (P1B)
unnamed: C102.1, R57.2, R58.1, U26.18 (P2B)
unnamed: D3.2 (+), R65.2
unnamed: D4.2 (+), Q1.1 (B), R65.1
unnamed: D5.1 (-), R64.2, U105.3 (A)
unnamed: D5.2 (+), R63.2, U103.3 (Y)
unnamed: D7.1 (-), R79.2, U104.13 (A)
unnamed: D7.2 (+), R78.2, U102.8 (Y)
unnamed: D20.1 (-), R81.2, U105.1 (A)
unnamed: D20.2 (+), R80.2, U102.6 (Y)
unnamed: D24.2 (+), R86.1, U21.1 (OUT)
unnamed: R2.1, R3.2, U3.4 (In-)
unnamed: R4.2, U101.3 (Y)
unnamed: R11.2, R16.1, R17.1, U2.3 (In+)
unnamed: R18.2, R19.1, R20.1, U4.3 (In+)
unnamed: R25.2, R36.1, U106.3 (A)
unnamed: R31.1, R32.2, U7.4 (In-)
unnamed: R39.1, R40.2, U13.4 (In-)
unnamed: R67.2, R68.1, R69.1, U14.3 (In+)
unnamed: R82.2, R85.1, R86.2, U21.3 (In+)
unnamed: R83.1, R84.2, U21.4 (In-)
unnamed: R87.2, R88.1, U106.1 (A)
unnamed: R94.2, R95.1, U106.8 (A)
unnamed: R99.1, U26.16 (A1)
unnamed: R102.1, U26.4 (HVC/A0)
unnamed: R103.2, U26.15 (~RESET)
unnamed: U18.7 (Q3), U18.15 (Reset)
unnamed: U102.3 (Y), U104.3 (A)
unnamed: U102.11 (Y), U104.5 (A)
unnamed: U103.6 (Y), U104.9 (A)
Out: U101.8 (Y), U101.13 (A)
Out-: D15.2 (+), R51.1, U18.13 (CKEN), U101.9 (B), U101.11 (Y), U102.1 (A), U102.13 (A), U103.5 (B)
Output1_drain: J11.14, R94.1
Output2_drain: J11.16, R25.1
Output3_drain: J11.18, R87.1
RESET-: U101.6 (Y), U101.12 (B)
Reset_raw: U5.1 (OUT), U101.4 (A)
SCL: J9.7, U26.5 (SCL)
SDA: J9.8, U26.6 (SDA)
U102B_A: U18.3 (Q0), U28.11 (S0), U102.4 (A)
U102C_A: U18.2 (Q1), U28.10 (S1), U102.10 (A)
U103A_A: U18.4 (Q2), U28.9 (S2), U103.1 (A)
V_err: U4.4 (In-), U5.4 (In-), U28.3 (A)
Verr1: C13.2, R27.2, R28.2, U28.14 (A1)
Verr2: C11.2, R37.2, R38.2, U28.15 (A2)
Verr3: C10.2, R45.2, R46.2, U28.1 (A4)
VerrGT0: U101.1 (A), U102.5 (B), U102.9 (B), U103.2 (B), U104.10 (Y)
Voltage_err_1: R3.1, R27.1, U3.1 (OUT)
Voltage_err_2: R32.1, R37.1, U7.1 (OUT)
Voltage_err_3: R40.1, R45.1, U13.1 (OUT)
Vout_1: J11.13, R9.2
Vout_2: J11.15, R35.2
Vout_3: J11.17, R43.2
Vref_1: C103.1, R6.1, R101.2
Vref_1_arduino: J9.1, R101.1
Vref_2: C93.1, R33.1, R100.2
Vref_2_arduino: J9.2, R100.1
Vref_3: C47.1, R41.1, R77.2
Vref_3_arduino: J9.3, R77.1
analog_5V: C32.1, C36.2, C37.2, C38.2, C63.1, C66.1, J11.22, R44.1, R91.1, R96.1, U3.5 (V+), U7.5 (V+), U13.5 (V+), U22.5 (V+), U23.5 (V+), U24.5 (V+)
ena_out_1: J11.5, U102.2 (B), U105.2 (Y)
ena_out_2: J11.7, U102.12 (B), U104.12 (Y)
ena_out_3: J11.9, U103.4 (A), U105.4 (Y)
low_error_timeout: D6.1 (-), R67.1, R71.2, U14.1 (OUT), U18.14 (CLK)
out_2_on: J11.6, U104.6 (Y)
out_3_on: J11.8, U104.8 (Y)
set-: D6.2 (+), R4.1, U101.10 (A)

Notes on the sheet:
Arduino interface and LED-current references
Channel sequencer and low-error timeout
Error select and comparators
Channel 1 output-voltage error amplifier
Channel 2 output-voltage error amplifier
Channel 3 output-voltage error amplifier
Channel 1 reference sample-and-hold
Channel 2 reference sample-and-hold
Channel 3 reference sample-and-hold
Gate-enable logic and M1 inhibit
Logic supplies and spare gates
Power-board connector and mounting holes
