ChristopherCa55/led-driver/BOOST_split_boards/review_fixes_2026-10-11/work/trySplit_D5d/checks_diff.txt

< In4.Cu|GND: 9 pieces
> In4.Cu|GND: 8 pieces
< In4.Cu GND            cut by 0err_hi                 15.4 mm  w 0.20 gap 0.30  mid [79.67, 101.66]  detour n/a  pieces 1 / 8 on this layer only meet through other layers  SEP [[1, 626.3], [2, 318.3], [8, 30.1], [9, 1.1]]
< In1.Cu GND            cut by 0err_hi                 13.4 mm  w 0.20 gap 0.30  mid [59.33, 84.53]  detour 12.5 mm    SEP [[1, 972.3], [5, 2.5]]
> In1.Cu GND            cut by 0err_hi                 13.4 mm  w 0.20 gap 0.30  mid [59.33, 84.53]  detour 12.5 mm    SEP [[1, 972.1], [5, 2.5]]
< In4.Cu GND            cut by Net-(D5--)              11.8 mm  w 0.20 gap 0.30  mid [76.83, 111.32]  detour n/a  pieces 1 / 2 on this layer only meet through other layers  SEP [[1, 626.3], [2, 318.3], [9, 1.1]]
< In3.Cu GND            cut by Output1_drain            8.8 mm  w 0.30 gap 0.30  mid [67.39, 72.83]  detour n/a  pieces 3 / 1 on this layer only meet through other layers  SEP [[1, 1066.9], [3, 14.1]]
> In3.Cu GND            cut by Output1_drain            8.8 mm  w 0.30 gap 0.30  mid [67.39, 72.83]  detour n/a  pieces 3 / 1 on this layer only meet through other layers  SEP [[1, 1066.6], [3, 14.1]]
< In4.Cu GND            cut by VerrGT0                  8.6 mm  w 0.20 gap 0.30  mid [66.54, 72.88]  detour n/a    SEP [[1, 626.3], [3, 36.3]]
< In4.Cu GND            cut by Net-(U103B-Y)            8.6 mm  w 0.20 gap 0.30  mid [72.85, 86.9]  detour n/a  pieces 4 / 5 on this layer only meet through other layers  SEP [[4, 63.8], [5, 28.0]]
> In4.Cu GND            cut by VerrGT0                  8.6 mm  w 0.20 gap 0.30  mid [66.54, 72.88]  detour n/a    SEP [[1, 951.8], [2, 36.3]]
> In4.Cu GND            cut by Net-(U103B-Y)            8.6 mm  w 0.20 gap 0.30  mid [72.85, 86.9]  detour n/a  pieces 3 / 4 on this layer only meet through other layers  SEP [[3, 63.8], [4, 28.0]]
< In4.Cu GND            cut by analog_5V                7.8 mm  w 0.40 gap 0.30  mid [80.59, 91.33]  detour n/a  pieces 7 / 4 on this layer only meet through other layers  SEP [[4, 63.8], [7, 15.4]]
< In3.Cu GND            cut by OUT_1_ENA                7.8 mm  w 0.20 gap 0.30  mid [78.22, 93.39]  detour n/a    SEP [[1, 1066.9], [8, 11.3]]
< In1.Cu GND            cut by SDA                      7.6 mm  w 0.20 gap 0.30  mid [62.06, 100.83]  detour n/a  pieces 1 / 11 on this layer only meet through other layers  SEP [[1, 972.3], [11, 14.0]]
< B.Cu   GND            cut by Net-(D26-+)              7.4 mm  w 0.20 gap 0.30  mid [83.6, 98.28]  detour n/a  pieces 17 / 10 on this layer only meet through other layers  SEP [[10, 48.1], [17, 84.1]]
> In4.Cu GND            cut by analog_5V                7.8 mm  w 0.40 gap 0.30  mid [80.59, 91.33]  detour n/a  pieces 6 / 3 on this layer only meet through other layers  SEP [[3, 63.8], [6, 15.4]]
> In3.Cu GND            cut by OUT_1_ENA                7.8 mm  w 0.20 gap 0.30  mid [78.22, 93.39]  detour n/a    SEP [[1, 1066.6], [8, 11.3]]
> In1.Cu GND            cut by SDA                      7.6 mm  w 0.20 gap 0.30  mid [62.06, 100.83]  detour n/a  pieces 1 / 11 on this layer only meet through other layers  SEP [[1, 972.1], [11, 14.0]]
> B.Cu   GND            cut by Net-(D26-+)              7.4 mm  w 0.20 gap 0.30  mid [83.6, 98.28]  detour n/a  pieces 17 / 10 on this layer only meet through other layers  SEP [[10, 48.1], [17, 83.8]]
< In3.Cu GND            cut by low_error_timeout        7.2 mm  w 0.20 gap 0.30  mid [56.75, 72.7]  detour n/a  pieces 1 / 2 on this layer only meet through other layers  SEP [[1, 1066.9], [2, 7.2]]
< In4.Cu GND            cut by analog_5V                7.0 mm  w 0.40 gap 0.30  mid [61.17, 86.28]  detour n/a  pieces 1 / 5 on this layer only meet through other layers  SEP [[1, 626.3], [5, 28.0]]
< In1.Cu GND            cut by Net-(U106A-B)            7.0 mm  w 0.20 gap 0.30  mid [62.86, 89.62]  detour n/a  pieces 8 / 1 on this layer only meet through other layers  SEP [[1, 972.3], [7, 30.5], [8, 11.7]]
< In4.Cu GND            cut by Voltage_err_2            6.8 mm  w 0.20 gap 0.25  mid [83.72, 87.35]  detour n/a  pieces 4 / 2 on this layer only meet through other layers  SEP [[2, 318.3], [4, 63.8]]
> In3.Cu GND            cut by low_error_timeout        7.2 mm  w 0.20 gap 0.30  mid [56.75, 72.7]  detour n/a  pieces 1 / 2 on this layer only meet through other layers  SEP [[1, 1066.6], [2, 7.2]]
> In4.Cu GND            cut by analog_5V                7.0 mm  w 0.40 gap 0.30  mid [61.17, 86.28]  detour n/a  pieces 1 / 4 on this layer only meet through other layers  SEP [[1, 951.8], [4, 28.0]]
> In1.Cu GND            cut by Net-(U106A-B)            7.0 mm  w 0.20 gap 0.30  mid [62.86, 89.62]  detour n/a  pieces 8 / 1 on this layer only meet through other layers  SEP [[1, 972.1], [7, 30.5], [8, 11.7]]
> In4.Cu GND            cut by Voltage_err_2            6.8 mm  w 0.20 gap 0.25  mid [83.72, 87.35]  detour n/a  pieces 3 / 1 on this layer only meet through other layers  SEP [[1, 951.8], [3, 63.8]]
> In4.Cu GND            cut by 0err_hi                  6.6 mm  w 0.20 gap 0.30  mid [76.26, 99.08]  detour n/a  pieces 1 / 7 on this layer only meet through other layers  SEP [[1, 951.8], [7, 16.1]]
< In3.Cu GND            cut by IREF1                    6.6 mm  w 0.20 gap 0.35  mid [75.44, 90.81]  detour n/a  pieces 6 / 8 on this layer only meet through other layers  SEP [[1, 1066.9], [6, 21.4], [8, 11.3]]
> In3.Cu GND            cut by IREF1                    6.6 mm  w 0.20 gap 0.35  mid [75.44, 90.81]  detour n/a  pieces 6 / 8 on this layer only meet through other layers  SEP [[1, 1066.6], [6, 21.4], [8, 11.3]]
< In1.Cu GND            cut by SDA                      5.8 mm  w 0.20 gap 0.25  mid [61.76, 92.01]  detour n/a  pieces 8 / 7 on this layer only meet through other layers  SEP [[1, 972.3], [7, 30.5], [8, 11.7]]
> In1.Cu GND            cut by SDA                      5.8 mm  w 0.20 gap 0.25  mid [61.76, 92.01]  detour n/a  pieces 8 / 7 on this layer only meet through other layers  SEP [[1, 972.1], [7, 30.5], [8, 11.7]]
< In4.Cu GND            cut by Net-(U103B-Y)            5.2 mm  w 0.20 gap 0.30  mid [78.65, 94.78]  detour n/a  pieces 7 / 8 on this layer only meet through other layers  SEP [[7, 15.4], [8, 30.1]]
< In4.Cu GND            cut by Net-(D5--)               5.0 mm  w 0.20 gap 0.30  mid [80.95, 105.9]  detour n/a  pieces 8 / 2 on this layer only meet through other layers  SEP [[2, 318.3], [8, 30.1], [9, 1.1]]
> In4.Cu GND            cut by Net-(U103B-Y)            5.0 mm  w 0.20 gap 0.30  mid [78.65, 94.78]  detour n/a  pieces 6 / 7 on this layer only meet through other layers  SEP [[6, 15.4], [7, 16.1]]
< In1.Cu GND            cut by Net-(D25-+)              4.8 mm  w 0.20 gap 0.30  mid [70.62, 72.97]  detour n/a  pieces 2 / 1 on this layer only meet through other layers  SEP [[1, 972.3], [2, 74.6]]
< In3.Cu GND            cut by low_error_timeout        4.8 mm  w 0.20 gap 0.30  mid [52.84, 76.91]  detour 12.8 mm    SEP [[1, 1066.9], [2, 7.2]]
> In1.Cu GND            cut by Net-(D25-+)              4.8 mm  w 0.20 gap 0.30  mid [70.62, 72.97]  detour n/a  pieces 2 / 1 on this layer only meet through other layers  SEP [[1, 972.1], [2, 74.6]]
> In3.Cu GND            cut by low_error_timeout        4.8 mm  w 0.20 gap 0.30  mid [52.84, 76.91]  detour 12.8 mm    SEP [[1, 1066.6], [2, 7.2]]
< In3.Cu GND            cut by IREF3_input              4.6 mm  w 0.20 gap 0.30  mid [65.67, 107.43]  detour n/a  pieces 11 / 1 on this layer only meet through other layers  SEP [[1, 1066.9], [11, 3.3]]
< F.Cu   GND            cut by V_err                    4.4 mm  w 0.15 gap 0.25  mid [75.84, 102.72]  detour n/a  pieces 22 / 19 on this layer only meet through other layers  SEP [[19, 39.6], [22, 343.4]]
< In3.Cu GND            cut by .1Vref_1                 4.4 mm  w 0.20 gap 0.30  mid [72.9, 98.0]  detour n/a  pieces 1 / 10 on this layer only meet through other layers  SEP [[1, 1066.9], [10, 7.2]]
> In3.Cu GND            cut by IREF3_input              4.6 mm  w 0.20 gap 0.30  mid [65.67, 107.43]  detour n/a  pieces 11 / 1 on this layer only meet through other layers  SEP [[1, 1066.6], [11, 3.3]]
> F.Cu   GND            cut by V_err                    4.4 mm  w 0.15 gap 0.25  mid [75.84, 102.72]  detour n/a  pieces 22 / 19 on this layer only meet through other layers  SEP [[19, 39.6], [22, 343.1]]
> In3.Cu GND            cut by .1Vref_1                 4.4 mm  w 0.20 gap 0.30  mid [72.9, 98.0]  detour n/a  pieces 1 / 10 on this layer only meet through other layers  SEP [[1, 1066.6], [10, 7.2]]
< In1.Cu GND            cut by Net-(D25-+)              4.2 mm  w 0.15 gap 0.30  mid [76.58, 88.89]  detour n/a  pieces 4 / 6 on this layer only meet through other layers  SEP [[1, 972.3], [4, 31.0], [6, 33.3]]
> In1.Cu GND            cut by Net-(D25-+)              4.2 mm  w 0.15 gap 0.30  mid [76.58, 88.89]  detour n/a  pieces 4 / 6 on this layer only meet through other layers  SEP [[1, 972.1], [4, 31.0], [6, 33.3]]
< In4.Cu GND            cut by Net-(D4-+)               4.0 mm  w 0.20 gap 0.30  mid [50.67, 92.0]  detour n/a  pieces 1 / 6 on this layer only meet through other layers  SEP [[1, 626.3], [6, 34.5]]
> In4.Cu GND            cut by Net-(D4-+)               4.0 mm  w 0.20 gap 0.30  mid [50.67, 92.0]  detour n/a  pieces 1 / 5 on this layer only meet through other layers  SEP [[1, 951.8], [5, 34.5]]
< In3.Cu GND            cut by 12V                      4.0 mm  w 0.30 gap 0.25  mid [56.35, 91.35]  detour n/a  pieces 7 / 1 on this layer only meet through other layers  SEP [[1, 1066.9], [7, 1.7]]
> In3.Cu GND            cut by 12V                      4.0 mm  w 0.30 gap 0.25  mid [56.35, 91.35]  detour n/a  pieces 7 / 1 on this layer only meet through other layers  SEP [[1, 1066.6], [7, 1.7]]
> In2.Cu 5V             cut by Net-(D5--)               3.6 mm  w 0.20 gap 0.25  mid [76.87, 111.45]  detour 29.8 mm  
< In1.Cu GND            cut by Net-(D25-+)              3.6 mm  w 0.20 gap 0.25  mid [75.53, 84.38]  detour n/a  pieces 1 / 2 on this layer only meet through other layers  SEP [[1, 972.3], [2, 74.6], [3, 2.3], [4, 31.0], [6, 33.3]]
< In3.Cu GND            cut by 12V                      3.6 mm  w 0.30 gap 0.30  mid [54.55, 78.55]  detour n/a  pieces 4 / 1 on this layer only meet through other layers  SEP [[1, 1066.9], [2, 7.2], [4, 109.7]]
> In1.Cu GND            cut by Net-(D25-+)              3.6 mm  w 0.20 gap 0.25  mid [75.53, 84.38]  detour n/a  pieces 1 / 2 on this layer only meet through other layers  SEP [[1, 972.1], [2, 74.6], [3, 2.3], [4, 31.0], [6, 33.3]]
> In3.Cu GND            cut by 12V                      3.6 mm  w 0.30 gap 0.30  mid [54.55, 78.55]  detour n/a  pieces 4 / 1 on this layer only meet through other layers  SEP [[1, 1066.6], [2, 7.2], [4, 109.7]]
> In4.Cu GND            cut by 0err_hi                  3.2 mm  w 0.20 gap 0.30  mid [79.3, 106.65]  detour 3.7 mm  
< In1.Cu GND            cut by Vref_3_arduino           3.2 mm  w 0.20 gap 0.30  mid [53.4, 90.85]  detour n/a  pieces 1 / 7 on this layer only meet through other layers  SEP [[1, 972.3], [7, 30.5]]
> In1.Cu GND            cut by Vref_3_arduino           3.2 mm  w 0.20 gap 0.30  mid [53.4, 90.85]  detour n/a  pieces 1 / 7 on this layer only meet through other layers  SEP [[1, 972.1], [7, 30.5]]
< In3.Cu GND            cut by Net-(U106C-B)            3.2 mm  w 0.20 gap 0.30  mid [76.22, 95.83]  detour n/a  pieces 10 / 8 on this layer only meet through other layers  SEP [[1, 1066.9], [6, 21.4], [8, 11.3], [10, 7.2]]
< In3.Cu GND            cut by Net-(U102A-Y)            3.2 mm  w 0.20 gap 0.30  mid [63.34, 80.62]  detour n/a  pieces 1 / 4 on this layer only meet through other layers  SEP [[1, 1066.9], [4, 109.7]]
> In3.Cu GND            cut by Net-(U106C-B)            3.2 mm  w 0.20 gap 0.30  mid [76.22, 95.83]  detour n/a  pieces 10 / 8 on this layer only meet through other layers  SEP [[1, 1066.6], [6, 21.4], [8, 11.3], [10, 7.2]]
> In3.Cu GND            cut by Net-(U102A-Y)            3.2 mm  w 0.20 gap 0.30  mid [63.34, 80.62]  detour n/a  pieces 1 / 4 on this layer only meet through other layers  SEP [[1, 1066.6], [4, 109.7]]
< In2.Cu 5V             cut by Net-(D5-+)               3.0 mm  w 0.20 gap 0.25  mid [73.56, 111.59]  detour 8.7 mm  
< In4.Cu GND            cut by SCL                      3.0 mm  w 0.20 gap 0.30  mid [57.33, 90.37]  detour n/a  pieces 1 / 6 on this layer only meet through other layers  SEP [[1, 626.3], [6, 34.5]]
> In4.Cu GND            cut by SCL                      3.0 mm  w 0.20 gap 0.30  mid [57.33, 90.37]  detour n/a  pieces 1 / 5 on this layer only meet through other layers  SEP [[1, 951.8], [5, 34.5]]
< In1.Cu GND            cut by Net-(D25-+)              2.8 mm  w 0.20 gap 0.30  mid [74.49, 80.69]  detour n/a  pieces 2 / 3 on this layer only meet through other layers  SEP [[1, 972.3], [2, 74.6], [3, 2.3]]
> In1.Cu GND            cut by Net-(D25-+)              2.8 mm  w 0.20 gap 0.30  mid [74.49, 80.69]  detour n/a  pieces 2 / 3 on this layer only meet through other layers  SEP [[1, 972.1], [2, 74.6], [3, 2.3]]
< F.Cu   GND            cut by Net-(U23-In+)            2.6 mm  w 0.20 gap 0.30  mid [81.5, 106.85]  detour 33.7 mm    SEP [[22, 343.4], [27, 2.9]]
> F.Cu   GND            cut by Net-(U23-In+)            2.6 mm  w 0.20 gap 0.30  mid [81.5, 106.85]  detour 33.7 mm    SEP [[22, 343.1], [27, 2.9]]
< In3.Cu GND            cut by IREF2                    2.6 mm  w 0.15 gap 0.30  mid [74.03, 87.53]  detour n/a  pieces 6 / 1 on this layer only meet through other layers  SEP [[1, 1066.9], [6, 21.4]]
< In3.Cu GND            cut by 12V                      2.6 mm  w 0.30 gap 0.30  mid [56.52, 75.6]  detour 3.0 mm    SEP [[1, 1066.9], [2, 7.2]]
< In3.Cu GND            cut by Vout_2                   2.6 mm  w 0.30 gap 0.30  mid [70.83, 74.8]  detour n/a  pieces 1 / 3 on this layer only meet through other layers  SEP [[1, 1066.9], [3, 14.1]]
< F.Cu   GND            cut by IREF3                    2.4 mm  w 0.20 gap 0.30  mid [62.28, 103.17]  detour n/a  pieces 22 / 24 on this layer only meet through other layers  SEP [[22, 343.4], [24, 16.8]]
< B.Cu   GND            cut by Verr2                    2.4 mm  w 0.20 gap 0.30  mid [81.68, 104.97]  detour n/a  pieces 6 / 17 on this layer only meet through other layers  SEP [[6, 361.5], [17, 84.1]]
> In3.Cu GND            cut by IREF2                    2.6 mm  w 0.15 gap 0.30  mid [74.03, 87.53]  detour n/a  pieces 6 / 1 on this layer only meet through other layers  SEP [[1, 1066.6], [6, 21.4]]
> In3.Cu GND            cut by 12V                      2.6 mm  w 0.30 gap 0.30  mid [56.52, 75.6]  detour 3.0 mm    SEP [[1, 1066.6], [2, 7.2]]
> In3.Cu GND            cut by Vout_2                   2.6 mm  w 0.30 gap 0.30  mid [70.83, 74.8]  detour n/a  pieces 1 / 3 on this layer only meet through other layers  SEP [[1, 1066.6], [3, 14.1]]
> F.Cu   GND            cut by IREF3                    2.4 mm  w 0.20 gap 0.30  mid [62.28, 103.17]  detour n/a  pieces 22 / 24 on this layer only meet through other layers  SEP [[22, 343.1], [24, 16.8]]
> B.Cu   GND            cut by Verr2                    2.4 mm  w 0.20 gap 0.30  mid [81.68, 104.97]  detour n/a  pieces 6 / 17 on this layer only meet through other layers  SEP [[6, 361.5], [17, 83.8]]
> In2.Cu 5V             cut by Net-(D5--)               2.4 mm  w 0.20 gap 0.20  mid [80.78, 111.82]  detour 22.7 mm  
> In4.Cu GND            cut by analog_5V                2.4 mm  w 0.40 gap 0.30  mid [83.28, 104.76]  detour n/a  pieces 8 / 1 on this layer only meet through other layers  SEP [[1, 951.8], [8, 18.1]]
> In4.Cu GND            cut by Net-(D5--)               2.4 mm  w 0.20 gap 0.28  mid [80.95, 97.61]  detour n/a  pieces 7 / 8 on this layer only meet through other layers  SEP [[7, 16.1], [8, 18.1]]
< In1.Cu GND            cut by OUT_3_ENA                2.4 mm  w 0.20 gap 0.35  mid [78.49, 85.97]  detour n/a  pieces 6 / 1 on this layer only meet through other layers  SEP [[1, 972.3], [4, 31.0], [6, 33.3]]
< In1.Cu GND            cut by 0A_hi                    2.4 mm  w 0.20 gap 0.25  mid [71.47, 85.22]  detour n/a  pieces 1 / 4 on this layer only meet through other layers  SEP [[1, 972.3], [4, 31.0]]
> In1.Cu GND            cut by OUT_3_ENA                2.4 mm  w 0.20 gap 0.35  mid [78.49, 85.97]  detour n/a  pieces 6 / 1 on this layer only meet through other layers  SEP [[1, 972.1], [4, 31.0], [6, 33.3]]
> In1.Cu GND            cut by 0A_hi                    2.4 mm  w 0.20 gap 0.25  mid [71.47, 85.22]  detour n/a  pieces 1 / 4 on this layer only meet through other layers  SEP [[1, 972.1], [4, 31.0]]
< F.Cu   GND            cut by 12V                      2.2 mm  w 0.30 gap 0.30  mid [71.58, 102.7]  detour n/a  pieces 22 / 19 on this layer only meet through other layers  SEP [[19, 39.6], [22, 343.4]]
> F.Cu   GND            cut by 12V                      2.2 mm  w 0.30 gap 0.30  mid [71.58, 102.7]  detour n/a  pieces 22 / 19 on this layer only meet through other layers  SEP [[19, 39.6], [22, 343.1]]
< In1.Cu GND            cut by Net-(D24-+)              2.2 mm  w 0.20 gap 0.30  mid [70.45, 87.7]  detour n/a  pieces 1 / 4 on this layer only meet through other layers  SEP [[1, 972.3], [4, 31.0]]
> In1.Cu GND            cut by Net-(D24-+)              2.2 mm  w 0.20 gap 0.30  mid [70.45, 87.7]  detour n/a  pieces 1 / 4 on this layer only meet through other layers  SEP [[1, 972.1], [4, 31.0]]
< F.Cu   GND            cut by Verr2                    2.0 mm  w 0.20 gap 0.25  mid [80.24, 103.89]  detour n/a  pieces 22 / 25 on this layer only meet through other layers  SEP [[19, 39.6], [22, 343.4], [25, 1.3]]
< F.Cu   GND            cut by Net-(Q1-E)               2.0 mm  w 0.20 gap 0.30  mid [47.33, 105.03]  detour n/a  pieces 22 / 26 on this layer only meet through other layers  SEP [[22, 343.4], [26, 2.0]]
> F.Cu   GND            cut by Verr2                    2.0 mm  w 0.20 gap 0.25  mid [80.24, 103.89]  detour n/a  pieces 22 / 25 on this layer only meet through other layers  SEP [[19, 39.6], [22, 343.1], [25, 1.3]]
> F.Cu   GND            cut by Net-(Q1-E)               2.0 mm  w 0.20 gap 0.30  mid [47.33, 105.03]  detour n/a  pieces 22 / 26 on this layer only meet through other layers  SEP [[22, 343.1], [26, 2.0]]
< In4.Cu GND            cut by .1Vref_3                 2.0 mm  w 0.20 gap 0.30  mid [59.17, 88.08]  detour n/a  pieces 1 / 5 on this layer only meet through other layers  SEP [[1, 626.3], [5, 28.0]]
< In1.Cu GND            cut by Output2_drain            2.0 mm  w 0.15 gap 0.30  mid [74.4, 94.53]  detour n/a  pieces 1 / 10 on this layer only meet through other layers  SEP [[1, 972.3], [10, 3.3]]
> In4.Cu GND            cut by .1Vref_3                 2.0 mm  w 0.20 gap 0.30  mid [59.17, 88.08]  detour n/a  pieces 1 / 4 on this layer only meet through other layers  SEP [[1, 951.8], [4, 28.0]]
> In1.Cu GND            cut by Output2_drain            2.0 mm  w 0.15 gap 0.30  mid [74.4, 94.53]  detour n/a  pieces 1 / 10 on this layer only meet through other layers  SEP [[1, 972.1], [10, 3.3]]
< B.Cu   GND            cut by Net-(D26-+)              1.8 mm  w 0.20 gap 0.35  mid [78.4, 97.6]  detour n/a  pieces 6 / 10 on this layer only meet through other layers  SEP [[6, 361.5], [10, 48.1], [17, 84.1]]
> B.Cu   GND            cut by Net-(D26-+)              1.8 mm  w 0.20 gap 0.35  mid [78.4, 97.6]  detour n/a  pieces 6 / 10 on this layer only meet through other layers  SEP [[6, 361.5], [10, 48.1], [17, 83.8]]
< In4.Cu GND            cut by Net-(U103B-Y)            1.8 mm  w 0.20 gap 0.30  mid [76.28, 90.48]  detour n/a  pieces 4 / 5 on this layer only meet through other layers  SEP [[4, 63.8], [5, 28.0]]
> In4.Cu GND            cut by Net-(U103B-Y)            1.8 mm  w 0.20 gap 0.30  mid [76.28, 90.48]  detour n/a  pieces 3 / 4 on this layer only meet through other layers  SEP [[3, 63.8], [4, 28.0]]
> In4.Cu GND            cut by Net-(D5--)               1.8 mm  w 0.20 gap 0.25  mid [81.95, 106.21]  detour n/a  pieces 1 / 8 on this layer only meet through other layers  SEP [[1, 951.8], [8, 18.1]]
< In1.Cu GND            cut by Out-                     1.6 mm  w 0.20 gap 0.30  mid [58.06, 72.67]  detour n/a  pieces 2 / 1 on this layer only meet through other layers  SEP [[1, 972.3], [2, 74.6]]
< In3.Cu GND            cut by Net-(D24-+)              1.6 mm  w 0.20 gap 0.30  mid [67.97, 106.4]  detour n/a  pieces 11 / 1 on this layer only meet through other layers  SEP [[1, 1066.9], [11, 3.3]]
> In1.Cu GND            cut by Out-                     1.6 mm  w 0.20 gap 0.30  mid [58.06, 72.67]  detour n/a  pieces 2 / 1 on this layer only meet through other layers  SEP [[1, 972.1], [2, 74.6]]
> In3.Cu GND            cut by Net-(D24-+)              1.6 mm  w 0.20 gap 0.30  mid [67.97, 106.4]  detour n/a  pieces 11 / 1 on this layer only meet through other layers  SEP [[1, 1066.6], [11, 3.3]]
< == routing: jogs (segments < 0.15 mm): 2589 in 238 net/layers
> == routing: jogs (segments < 0.15 mm): 2551 in 239 net/layers
<    Net-(D5--)|In4.Cu                        44
>    VerrGT0|In4.Cu                           25
< B.Cu   Net-(D26-+)            over In4.Cu  2.9 mm at [81.84, 98.28]  (under it: none 22, Net-(D5--) 2, analog_5V 3, Voltage_err_2 2)
> B.Cu   Net-(D26-+)            over In4.Cu  1.9 mm at [80.13, 98.28]  (under it: none 22, Net-(D5--) 2, analog_5V 3, Voltage_err_2 2)
< In4.Cu Net-(D5--)             over In3.Cu  1.4 mm at [78.22, 109.93]  (under it: Net-(C8-Pad2) 29)
< B.Cu   Verr2                  over In4.Cu  1.2 mm at [81.81, 104.94]  (under it: Net-(D5--) 12)
