ChristopherCa55/led-driver/(commit log)

2026-09-15 Moved to new account
    [BOOST.kicad_sch, BOOST_control.kicad_pcb, BOOST_power.kicad_pcb, BOOST_power_M8_WIP_NOT_FOR_FAB.kicad_pcb, control_sync2.kicad_pcb, netlist_diff_vs_BOOST_9-2_1013.txt, power_sync2.kicad_pcb]
2026-09-26 Finished routing wires
    [BOOST.kicad_sch, BOOST_assembly_2026-09-24.step, BOOST_assembly_2026-09-25.step, BOOST_assembly_2026-09-25.stl, BOOST_assembly_2026-09-25_flat.step, BOOST_assembly_2026-09-25_with_case.stl, BOOST_assembly_3dpdf.kicad_pcb, BOOST_control_BOM_JLC.csv]
2026-09-28 added pictures to pcbs
    [BOOST.kicad_sch, BOOST_control_RC2.kicad_pcb, BOOST_power_RC2.kicad_pcb, BOOST_power_RC2_with_dog.kicad_pcb]
2026-09-30 added diodes from input to output
    [BOOST.kicad_sch, BOOST_assembly_2026-09-25.step, BOOST_control_RC2.kicad_pcb, BOOST_power_RC2.kicad_pcb]
2026-10-03 changed power board to 6 layers
    [BOOST.kicad_sch, BOOST_BOM.xlsx, BOOST_assembly_2026-09-25.step, BOOST_assembly_2026-09-30.step, BOOST_assembly_2026-10-02.step, BOOST_control_BOM_JLC.csv, BOOST_control_BOM_JLC_with_proposals.csv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]
